mrieker/pdp8i/kicads/realpans8/realpans8.kicad_pcb

## KiCad design kicads/realpans8/realpans8.kicad_pcb (2026-11-01)

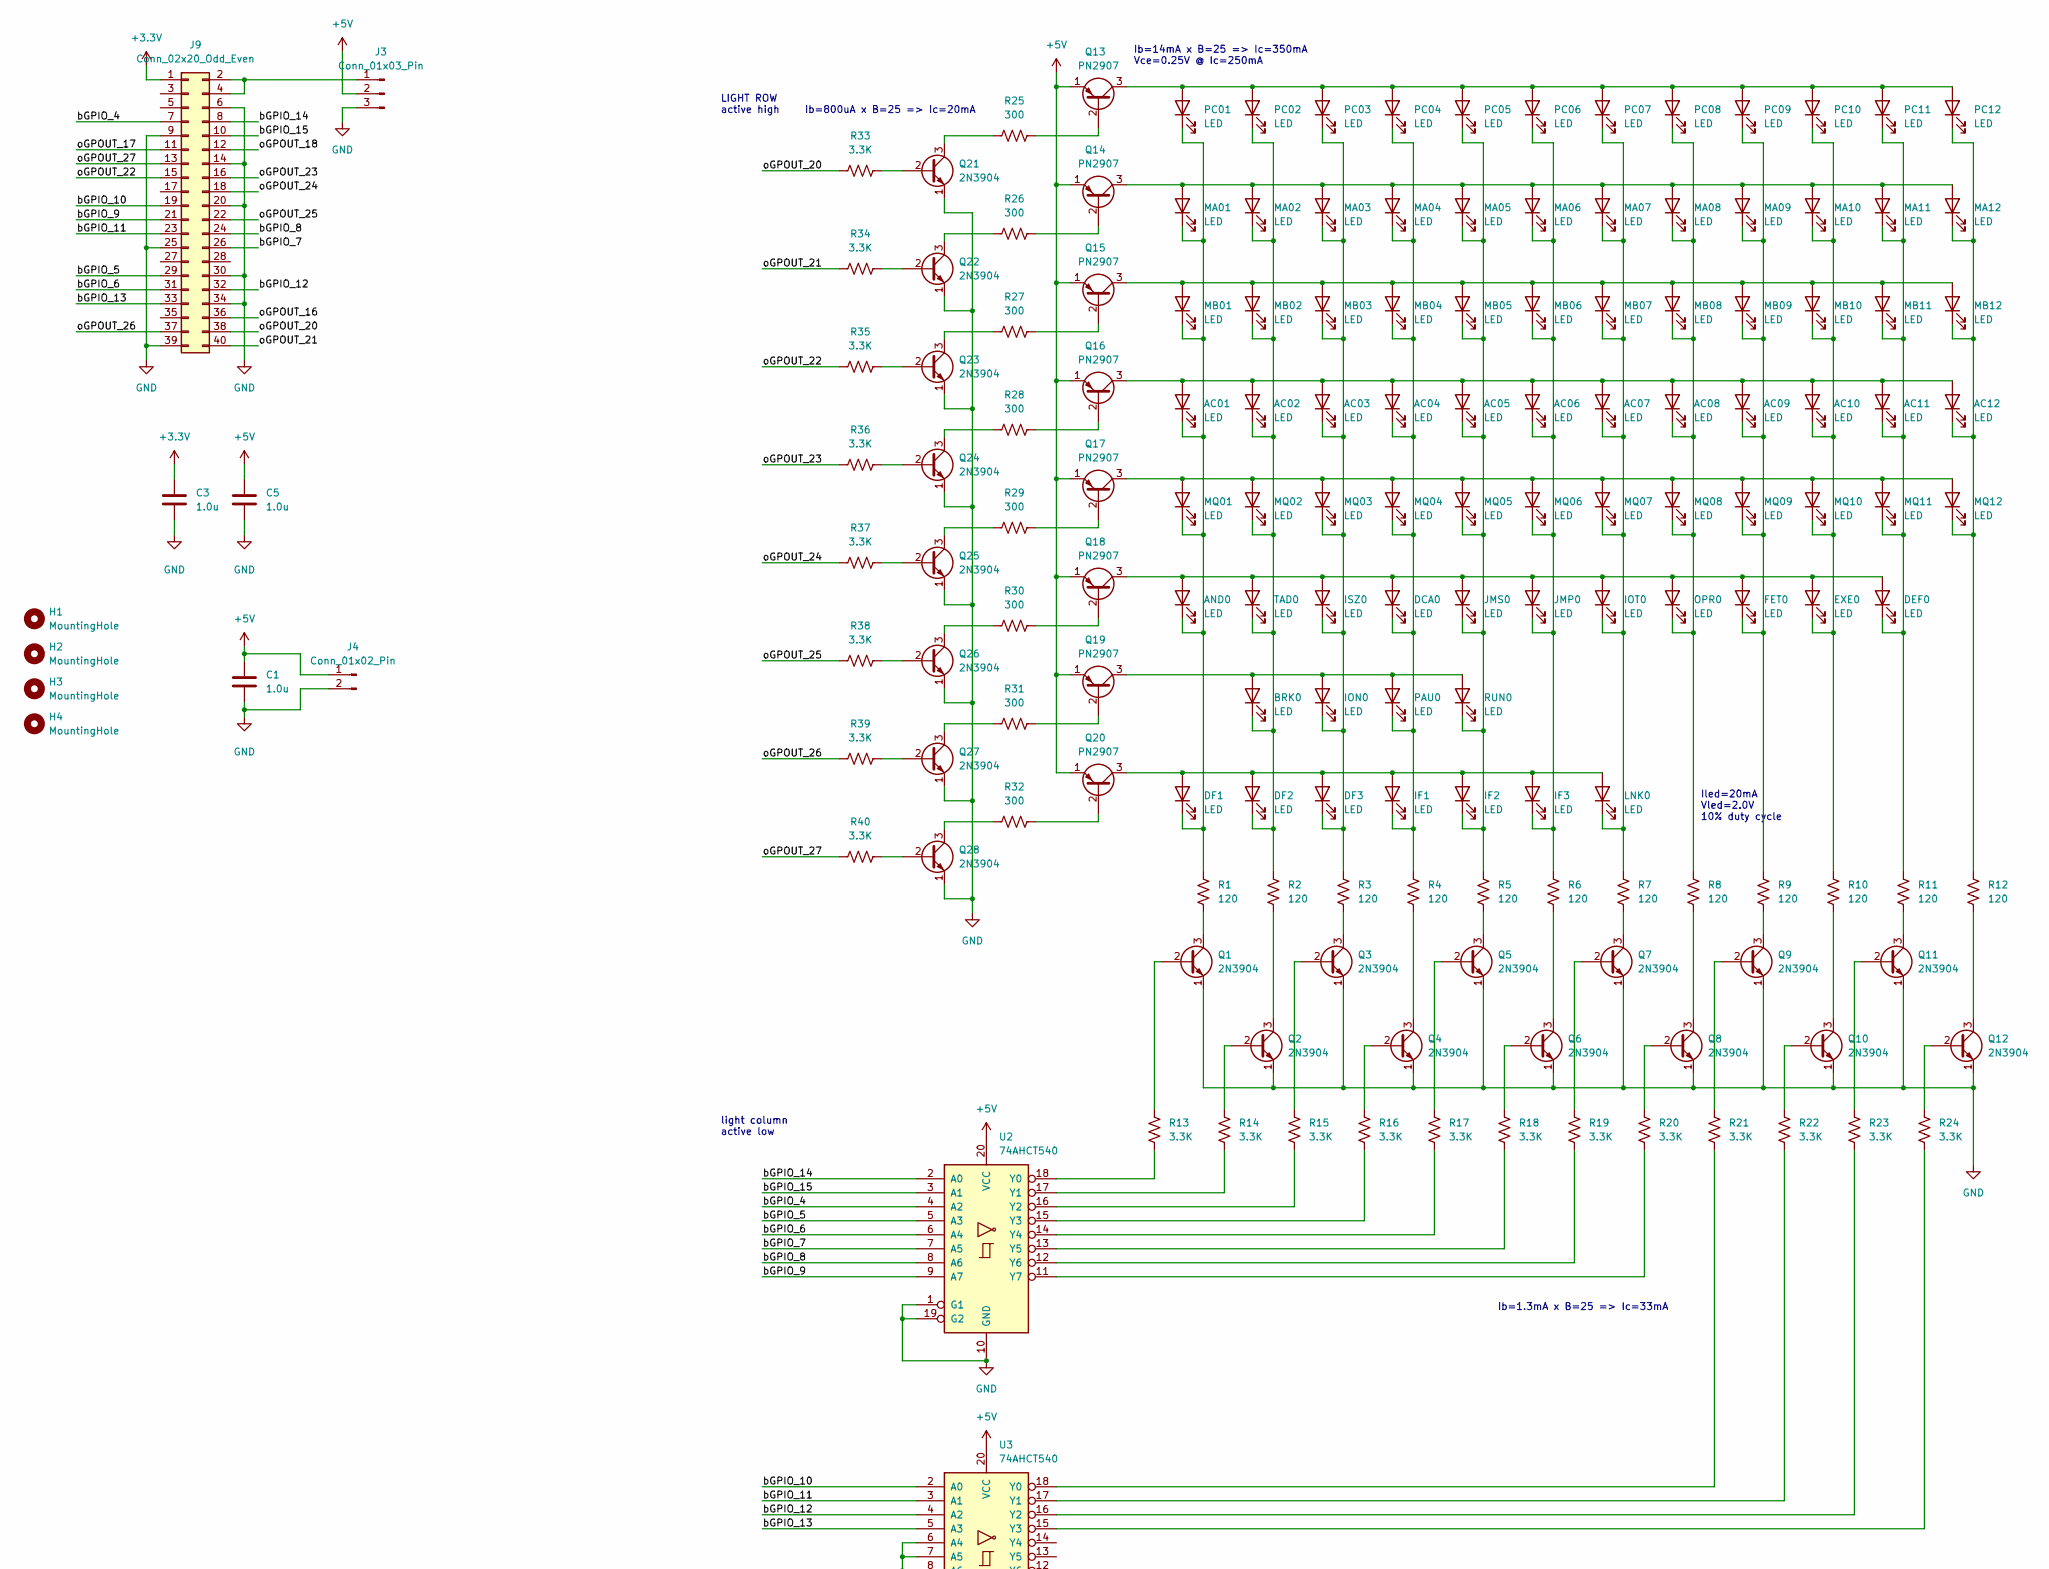
[picture p1: schematic realpans8.kicad_sch, part in row 1, column 1]

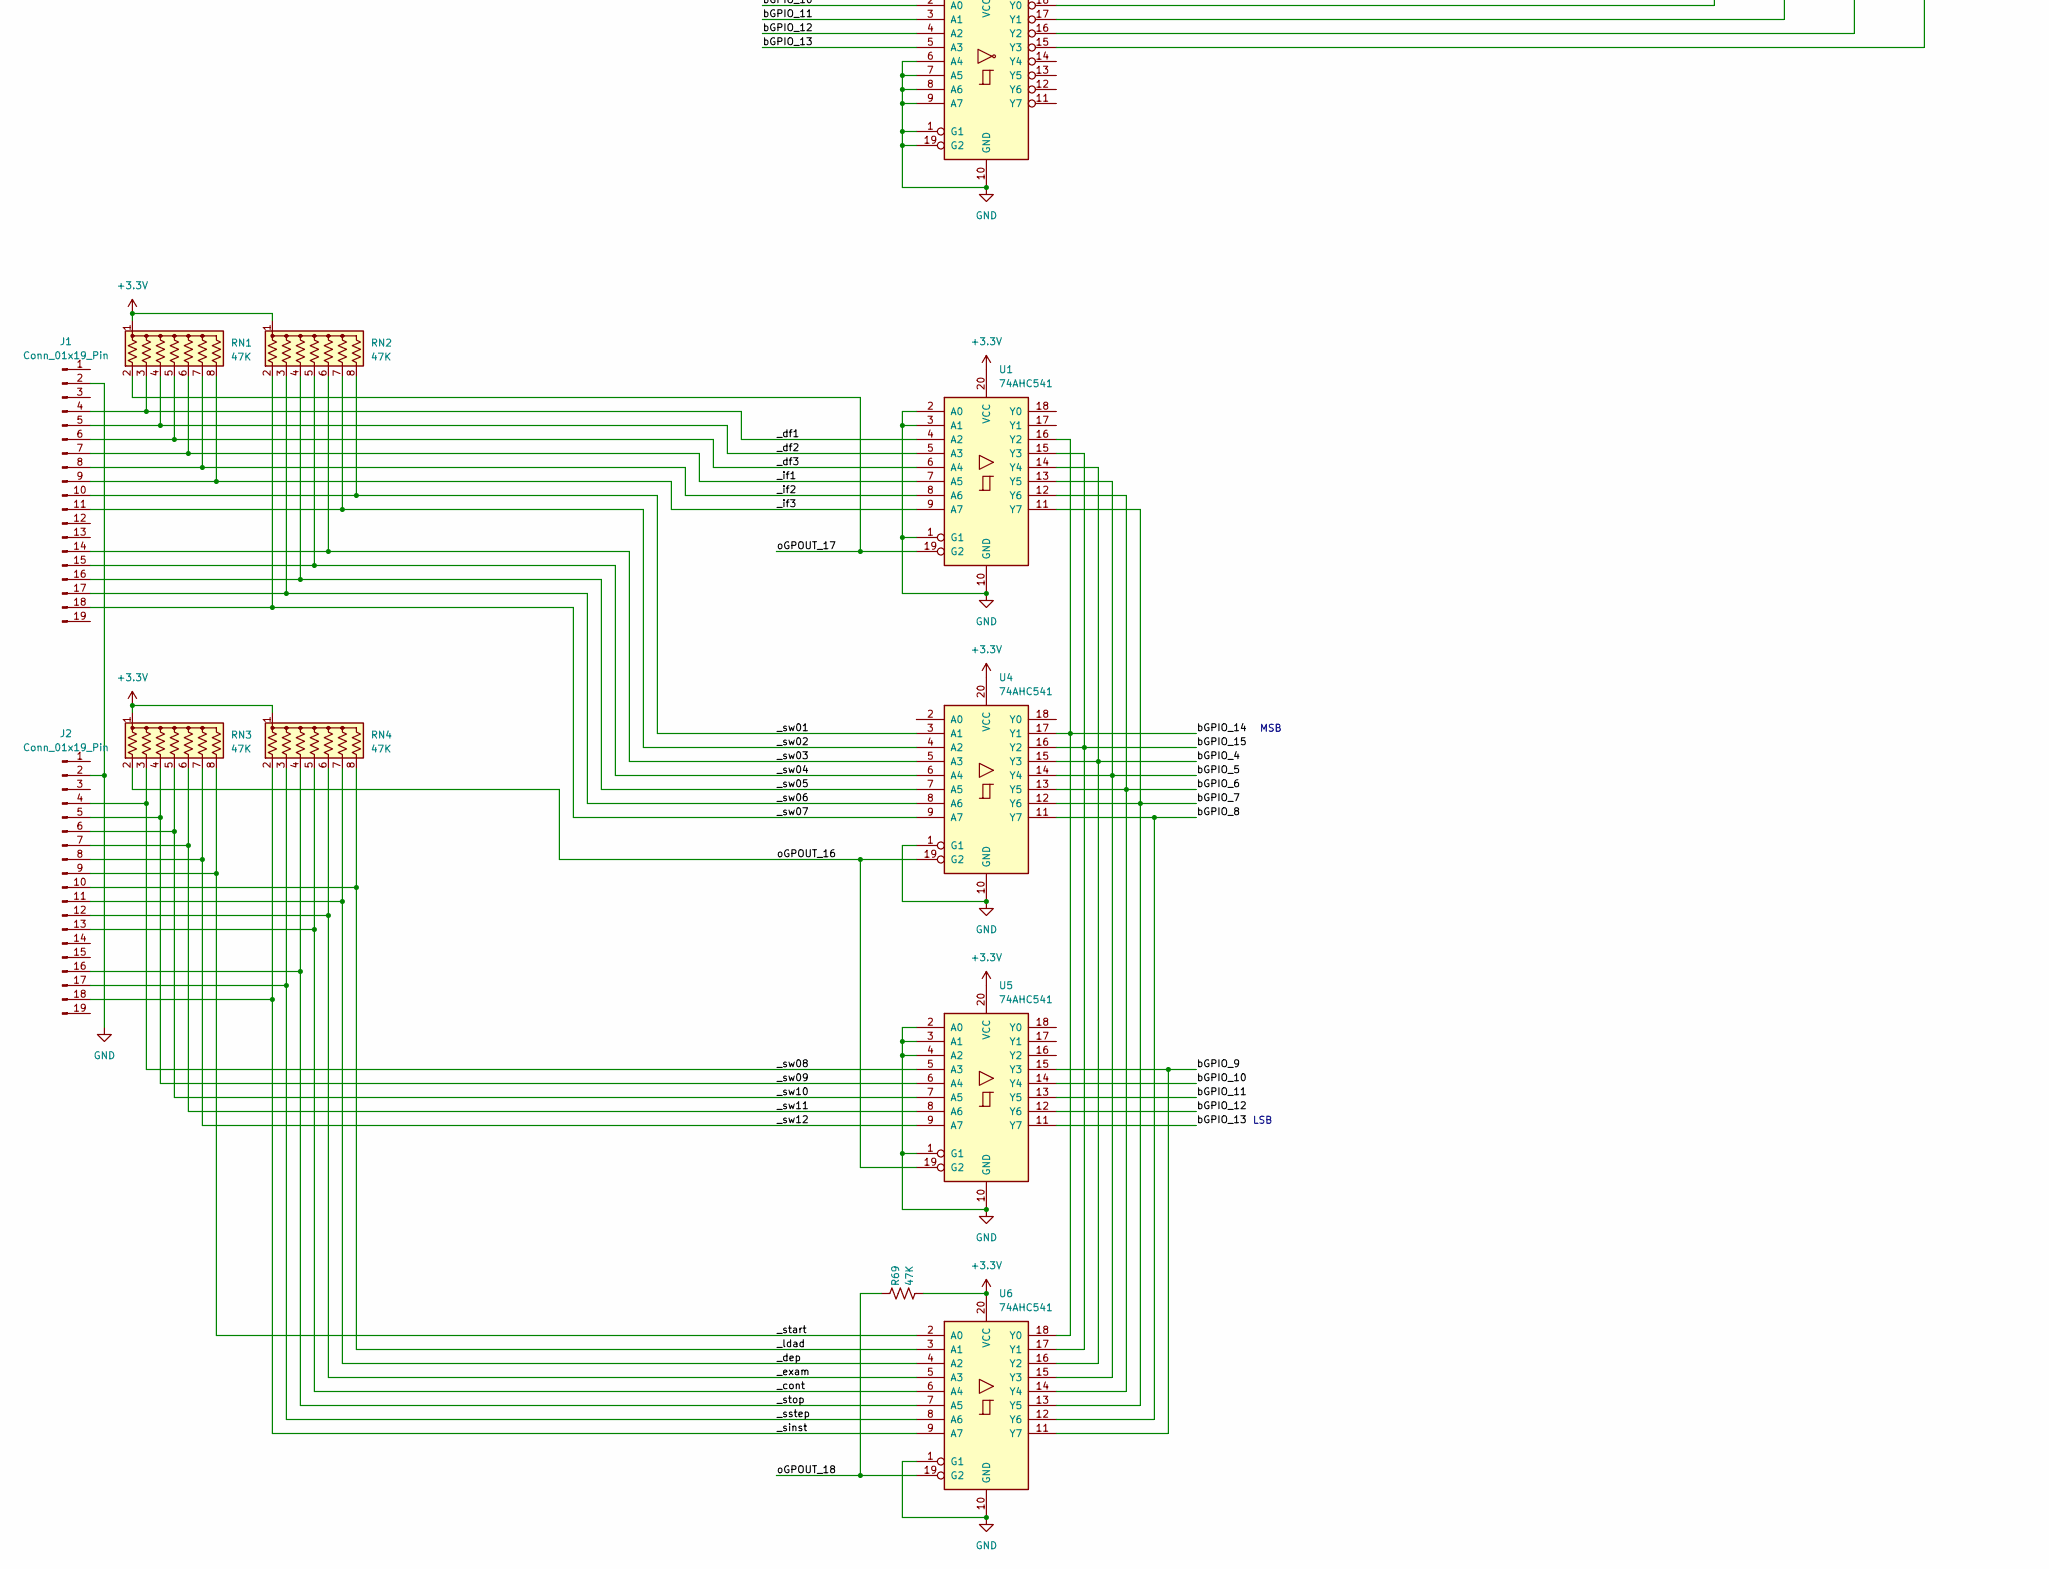
[picture p2: schematic realpans8.kicad_sch, part in row 2, column 1]

Parts:
AC01, AC02, AC03, AC04, AC05, AC06, AC07, AC08, AC09, AC10, AC11, AC12: LED; LED_D5.0mm
AND0: LED; LED_D5.0mm
BRK0: LED; LED_D5.0mm
C1, C3, C5: 1.0u; R_Axial_DIN0207_L6.3mm_D2.5mm_P7.62mm_Horizontal
DCA0: LED; LED_D5.0mm
DEF0: LED; LED_D5.0mm
DF1, DF2, DF3: LED; LED_D5.0mm
EXE0: LED; LED_D5.0mm
FET0: LED; LED_D5.0mm
H1, H2, H3, H4: MountingHole; MountingHole_4.5mm
IF1, IF2, IF3: LED; LED_D5.0mm
ION0: LED; LED_D5.0mm
IOT0: LED; LED_D5.0mm
ISZ0: LED; LED_D5.0mm
J1, J2: Conn_01x19_Pin; PinHeader_1x19_P2.54mm_Vertical
J3: Conn_01x03_Pin; PinHeader_1x03_P2.54mm_Vertical
J4: Conn_01x02_Pin; PinHeader_1x02_P2.54mm_Vertical
J9: Conn_02x20_Odd_Even; PinHeader_2x20_P2.54mm_Vertical
JMP0: LED; LED_D5.0mm
JMS0: LED; LED_D5.0mm
LNK0: LED; LED_D5.0mm
MA01, MA02, MA03, MA04, MA05, MA06, MA07, MA08, MA09, MA10, MA11, MA12: LED; LED_D5.0mm
MB01, MB02, MB03, MB04, MB05, MB06, MB07, MB08, MB09, MB10, MB11, MB12: LED; LED_D5.0mm
MQ01, MQ02, MQ03, MQ04, MQ05, MQ06, MQ07, MQ08, MQ09, MQ10, MQ11, MQ12: LED; LED_D5.0mm
OPR0: LED; LED_D5.0mm
PAU0: LED; LED_D5.0mm
PC01, PC02, PC03, PC04, PC05, PC06, PC07, PC08, PC09, PC10, PC11, PC12: LED; LED_D5.0mm
Q1, Q2, Q3, Q4, Q5, Q6, Q7, Q8, Q9, Q10, Q11, Q12, Q21, Q22, Q23, Q24, Q25, Q26, Q27, Q28: 2N3904; TO-92_Wide
Q13, Q14, Q15, Q16, Q17, Q18, Q19, Q20: PN2907; TO-92_Wide
R1, R2, R3, R4, R5, R6, R7, R8, R9, R10, R11, R12: 120; R_Axial_DIN0207_L6.3mm_D2.5mm_P7.62mm_Horizontal
R13, R14, R15, R16, R17, R18, R19, R20, R21, R22, R23, R24, R33, R34, R35, R36, R37, R38, R39, R40: 3.3K; R_Axial_DIN0207_L6.3mm_D2.5mm_P7.62mm_Horizontal
R25, R26, R27, R28, R29, R30, R31, R32: 300; R_Axial_DIN0207_L6.3mm_D2.5mm_P7.62mm_Horizontal
R69: 47K; R_Axial_DIN0207_L6.3mm_D2.5mm_P7.62mm_Horizontal
RN1, RN2, RN3, RN4: 47K; R_Array_SIP8
RUN0: LED; LED_D5.0mm
TAD0: LED; LED_D5.0mm
U1, U4, U5, U6: 74AHC541; DIP-20_W7.62mm
U2, U3: 74AHCT540; DIP-20_W7.62mm

Connections:
+3.3V: C3.1, J9.1, R69.1, RN1.1 (common), RN2.1 (common), RN3.1 (common), RN4.1 (common), U1.20 (VCC), U4.20 (VCC), U5.20 (VCC), U6.20 (VCC)
+5V: C1.1, C5.1, J3.2, J4.1, Q13.1 (E), Q14.1 (E), Q15.1 (E), Q16.1 (E), Q17.1 (E), Q18.1 (E), Q19.1 (E), Q20.1 (E), U2.20 (VCC), U3.20 (VCC)
/_cont: J2.13, RN4.5 (R4), U6.6 (A4)
/_dep: J2.11, RN4.7 (R6), U6.4 (A2)
/_df1: J1.4, RN1.3 (R2), U1.4 (A2)
/_df2: J1.5, RN1.4 (R3), U1.5 (A3)
/_df3: J1.6, RN1.5 (R4), U1.6 (A4)
/_exam: J2.12, RN4.6 (R5), U6.5 (A3)
/_if1: J1.7, RN1.6 (R5), U1.7 (A5)
/_if2: J1.8, RN1.7 (R6), U1.8 (A6)
/_if3: J1.9, RN1.8 (R7), U1.9 (A7)
/_ldad: J2.10, RN4.8 (R7), U6.3 (A1)
/_sinst: J2.18, RN4.2 (R1), U6.9 (A7)
/_sstep: J2.17, RN4.3 (R2), U6.8 (A6)
/_start: J2.9, RN3.8 (R7), U6.2 (A0)
/_stop: J2.16, RN4.4 (R3), U6.7 (A5)
/_sw01: J1.10, RN2.8 (R7), U4.3 (A1)
/_sw02: J1.11, RN2.7 (R6), U4.4 (A2)
/_sw03: J1.14, RN2.6 (R5), U4.5 (A3)
/_sw04: J1.15, RN2.5 (R4), U4.6 (A4)
/_sw05: J1.16, RN2.4 (R3), U4.7 (A5)
/_sw06: J1.17, RN2.3 (R2), U4.8 (A6)
/_sw07: J1.18, RN2.2 (R1), U4.9 (A7)
/_sw08: J2.4, RN3.3 (R2), U5.5 (A3)
/_sw09: J2.5, RN3.4 (R3), U5.6 (A4)
/_sw10: J2.6, RN3.5 (R4), U5.7 (A5)
/_sw11: J2.7, RN3.6 (R5), U5.8 (A6)
/_sw12: J2.8, RN3.7 (R6), U5.9 (A7)
/bGPIO_4: J9.7, U1.14 (Y4), U2.4 (A2), U4.15 (Y3), U6.16 (Y2)
/bGPIO_5: J9.29, U1.13 (Y5), U2.5 (A3), U4.14 (Y4), U6.15 (Y3)
/bGPIO_6: J9.31, U1.12 (Y6), U2.6 (A4), U4.13 (Y5), U6.14 (Y4)
/bGPIO_7: J9.26, U1.11 (Y7), U2.7 (A5), U4.12 (Y6), U6.13 (Y5)
/bGPIO_8: J9.24, U2.8 (A6), U4.11 (Y7), U6.12 (Y6)
/bGPIO_9: J9.21, U2.9 (A7), U5.15 (Y3), U6.11 (Y7)
/bGPIO_10: J9.19, U3.2 (A0), U5.14 (Y4)
/bGPIO_11: J9.23, U3.3 (A1), U5.13 (Y5)
/bGPIO_12: J9.32, U3.4 (A2), U5.12 (Y6)
/bGPIO_13: J9.33, U3.5 (A3), U5.11 (Y7)
/bGPIO_14: J9.8, U1.16 (Y2), U2.2 (A0), U4.17 (Y1), U6.18 (Y0)
/bGPIO_15: J9.10, U1.15 (Y3), U2.3 (A1), U4.16 (Y2), U6.17 (Y1)
/oGPOUT_16: J9.36, RN3.2 (R1), U4.19 (G2), U5.19 (G2)
/oGPOUT_17: J9.11, RN1.2 (R1), U1.19 (G2)
/oGPOUT_18: J9.12, R69.2, U6.19 (G2)
/oGPOUT_20: J9.38, R33.1
/oGPOUT_21: J9.40, R34.1
/oGPOUT_22: J9.15, R35.1
/oGPOUT_23: J9.16, R36.1
/oGPOUT_24: J9.18, R37.1
/oGPOUT_25: J9.22, R38.1
/oGPOUT_26: J9.37, R39.1
/oGPOUT_27: J9.13, R40.1
GND: C1.2, C3.2, C5.2, J1.2, J2.2, J3.3, J4.2, J9.6, J9.9, J9.14, J9.20, J9.25, J9.30, J9.34, J9.39, Q1.1 (E), Q2.1 (E), Q3.1 (E), Q4.1 (E), Q5.1 (E), Q6.1 (E), Q7.1 (E), Q8.1 (E), Q9.1 (E), Q10.1 (E), Q11.1 (E), Q12.1 (E), Q21.1 (E), Q22.1 (E), Q23.1 (E), Q24.1 (E), Q25.1 (E), Q26.1 (E), Q27.1 (E), Q28.1 (E), U1.1 (G1), U1.2 (A0), U1.3 (A1), U1.10 (GND), U2.1 (G1), U2.10 (GND), U2.19 (G2), U3.1 (G1), U3.6 (A4), U3.7 (A5), U3.8 (A6), U3.9 (A7), U3.10 (GND), U3.19 (G2), U4.1 (G1), U4.10 (GND), U5.1 (G1), U5.2 (A0), U5.3 (A1), U5.4 (A2), U5.10 (GND), U6.1 (G1), U6.10 (GND)
unnamed: AC01.2 (A), AC02.2 (A), AC03.2 (A), AC04.2 (A), AC05.2 (A), AC06.2 (A), AC07.2 (A), AC08.2 (A), AC09.2 (A), AC10.2 (A), AC11.2 (A), AC12.2 (A), Q16.3 (C)
unnamed: AC01.1 (K), AND0.1 (K), DF1.1 (K), MA01.1 (K), MB01.1 (K), MQ01.1 (K), PC01.1 (K), R1.1
unnamed: AC02.1 (K), BRK0.1 (K), DF2.1 (K), MA02.1 (K), MB02.1 (K), MQ02.1 (K), PC02.1 (K), R2.1, TAD0.1 (K)
unnamed: AC03.1 (K), DF3.1 (K), ION0.1 (K), ISZ0.1 (K), MA03.1 (K), MB03.1 (K), MQ03.1 (K), PC03.1 (K), R3.1
unnamed: AC04.1 (K), DCA0.1 (K), IF1.1 (K), MA04.1 (K), MB04.1 (K), MQ04.1 (K), PAU0.1 (K), PC04.1 (K), R4.1
unnamed: AC05.1 (K), IF2.1 (K), JMS0.1 (K), MA05.1 (K), MB05.1 (K), MQ05.1 (K), PC05.1 (K), R5.1, RUN0.1 (K)
unnamed: AC06.1 (K), IF3.1 (K), JMP0.1 (K), MA06.1 (K), MB06.1 (K), MQ06.1 (K), PC06.1 (K), R6.1
unnamed: AC07.1 (K), IOT0.1 (K), LNK0.1 (K), MA07.1 (K), MB07.1 (K), MQ07.1 (K), PC07.1 (K), R7.1
unnamed: AC08.1 (K), MA08.1 (K), MB08.1 (K), MQ08.1 (K), OPR0.1 (K), PC08.1 (K), R8.1
unnamed: AC09.1 (K), FET0.1 (K), MA09.1 (K), MB09.1 (K), MQ09.1 (K), PC09.1 (K), R9.1
unnamed: AC10.1 (K), EXE0.1 (K), MA10.1 (K), MB10.1 (K), MQ10.1 (K), PC10.1 (K), R10.1
unnamed: AC11.1 (K), DEF0.1 (K), MA11.1 (K), MB11.1 (K), MQ11.1 (K), PC11.1 (K), R11.1
unnamed: AC12.1 (K), MA12.1 (K), MB12.1 (K), MQ12.1 (K), PC12.1 (K), R12.1
unnamed: AND0.2 (A), DCA0.2 (A), DEF0.2 (A), EXE0.2 (A), FET0.2 (A), IOT0.2 (A), ISZ0.2 (A), JMP0.2 (A), JMS0.2 (A), OPR0.2 (A), Q18.3 (C), TAD0.2 (A)
unnamed: BRK0.2 (A), ION0.2 (A), PAU0.2 (A), Q19.3 (C), RUN0.2 (A)
unnamed: DF1.2 (A), DF2.2 (A), DF3.2 (A), IF1.2 (A), IF2.2 (A), IF3.2 (A), LNK0.2 (A), Q20.3 (C)
unnamed: J3.1, J9.2, J9.4
unnamed: MA01.2 (A), MA02.2 (A), MA03.2 (A), MA04.2 (A), MA05.2 (A), MA06.2 (A), MA07.2 (A), MA08.2 (A), MA09.2 (A), MA10.2 (A), MA11.2 (A), MA12.2 (A), Q14.3 (C)
unnamed: MB01.2 (A), MB02.2 (A), MB03.2 (A), MB04.2 (A), MB05.2 (A), MB06.2 (A), MB07.2 (A), MB08.2 (A), MB09.2 (A), MB10.2 (A), MB11.2 (A), MB12.2 (A), Q15.3 (C)
unnamed: MQ01.2 (A), MQ02.2 (A), MQ03.2 (A), MQ04.2 (A), MQ05.2 (A), MQ06.2 (A), MQ07.2 (A), MQ08.2 (A), MQ09.2 (A), MQ10.2 (A), MQ11.2 (A), MQ12.2 (A), Q17.3 (C)
unnamed: PC01.2 (A), PC02.2 (A), PC03.2 (A), PC04.2 (A), PC05.2 (A), PC06.2 (A), PC07.2 (A), PC08.2 (A), PC09.2 (A), PC10.2 (A), PC11.2 (A), PC12.2 (A), Q13.3 (C)
unnamed: Q1.2 (B), R13.1
unnamed: Q1.3 (C), R1.2
unnamed: Q2.2 (B), R14.1
unnamed: Q2.3 (C), R2.2
unnamed: Q3.2 (B), R15.1
unnamed: Q3.3 (C), R3.2
unnamed: Q4.2 (B), R16.1
unnamed: Q4.3 (C), R4.2
unnamed: Q5.2 (B), R17.1
unnamed: Q5.3 (C), R5.2
unnamed: Q6.2 (B), R18.1
unnamed: Q6.3 (C), R6.2
unnamed: Q7.2 (B), R19.1
unnamed: Q7.3 (C), R7.2
unnamed: Q8.2 (B), R20.1
unnamed: Q8.3 (C), R8.2
unnamed: Q9.2 (B), R21.1
unnamed: Q9.3 (C), R9.2
unnamed: Q10.2 (B), R22.1
unnamed: Q10.3 (C), R10.2
unnamed: Q11.2 (B), R23.1
unnamed: Q11.3 (C), R11.2
unnamed: Q12.2 (B), R24.1
unnamed: Q12.3 (C), R12.2
unnamed: Q13.2 (B), R25.2
unnamed: Q14.2 (B), R26.2
unnamed: Q15.2 (B), R27.2
unnamed: Q16.2 (B), R28.2
unnamed: Q17.2 (B), R29.2
unnamed: Q18.2 (B), R30.2
unnamed: Q19.2 (B), R31.2
unnamed: Q20.2 (B), R32.2
unnamed: Q21.2 (B), R33.2
unnamed: Q21.3 (C), R25.1
unnamed: Q22.2 (B), R34.2
unnamed: Q22.3 (C), R26.1
unnamed: Q23.2 (B), R35.2
unnamed: Q23.3 (C), R27.1
unnamed: Q24.2 (B), R36.2
unnamed: Q24.3 (C), R28.1
unnamed: Q25.2 (B), R37.2
unnamed: Q25.3 (C), R29.1
unnamed: Q26.2 (B), R38.2
unnamed: Q26.3 (C), R30.1
unnamed: Q27.2 (B), R39.2
unnamed: Q27.3 (C), R31.1
unnamed: Q28.2 (B), R40.2
unnamed: Q28.3 (C), R32.1
unnamed: R13.2, U2.18 (Y0)
unnamed: R14.2, U2.17 (Y1)
unnamed: R15.2, U2.16 (Y2)
unnamed: R16.2, U2.15 (Y3)
unnamed: R17.2, U2.14 (Y4)
unnamed: R18.2, U2.13 (Y5)
unnamed: R19.2, U2.12 (Y6)
unnamed: R20.2, U2.11 (Y7)
unnamed: R21.2, U3.18 (Y0)
unnamed: R22.2, U3.17 (Y1)
unnamed: R23.2, U3.16 (Y2)
unnamed: R24.2, U3.15 (Y3)

Notes on the sheet:
Ib=1.3mA x B=25 => Ic=33mA
Iled=20mA Vled=2.0V 10% duty cycle
Ib=800uA x B=25 => Ic=20mA
MSB
Ib=14mA x B=25 => Ic=350mA Vce=0.25V @ Ic=250mA
LIGHT ROW active high
light column active low
LSB

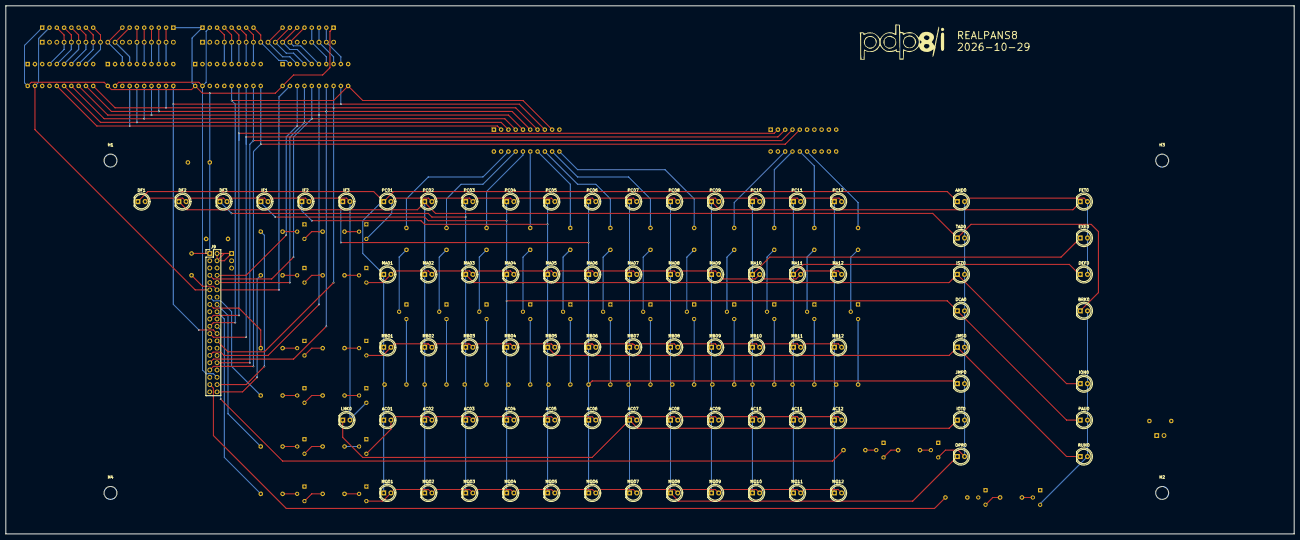
[picture p3: board realpans8.kicad_pcb from above]

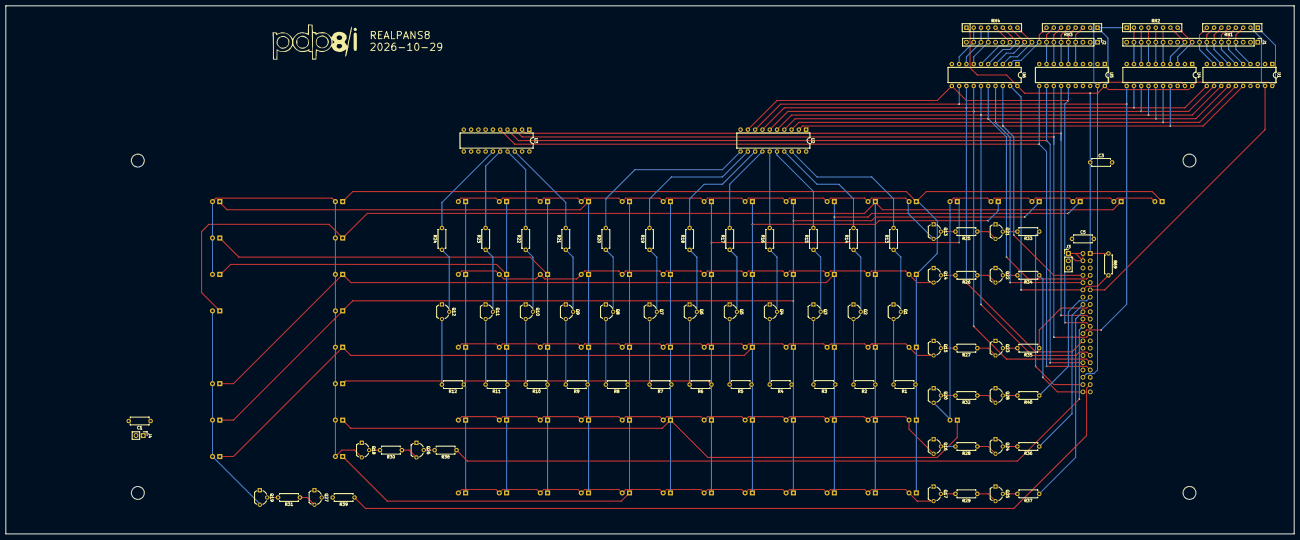
[picture p4: board realpans8.kicad_pcb from below]

Board: 4 copper layers, 449.3 x 184.2 mm, 173 parts (86 on the bottom side), 133 nets.
