mrieker/pdp8i/kicads/console/console.kicad_pcb

## KiCad design kicads/console/console.kicad_pcb (2026-10-23)

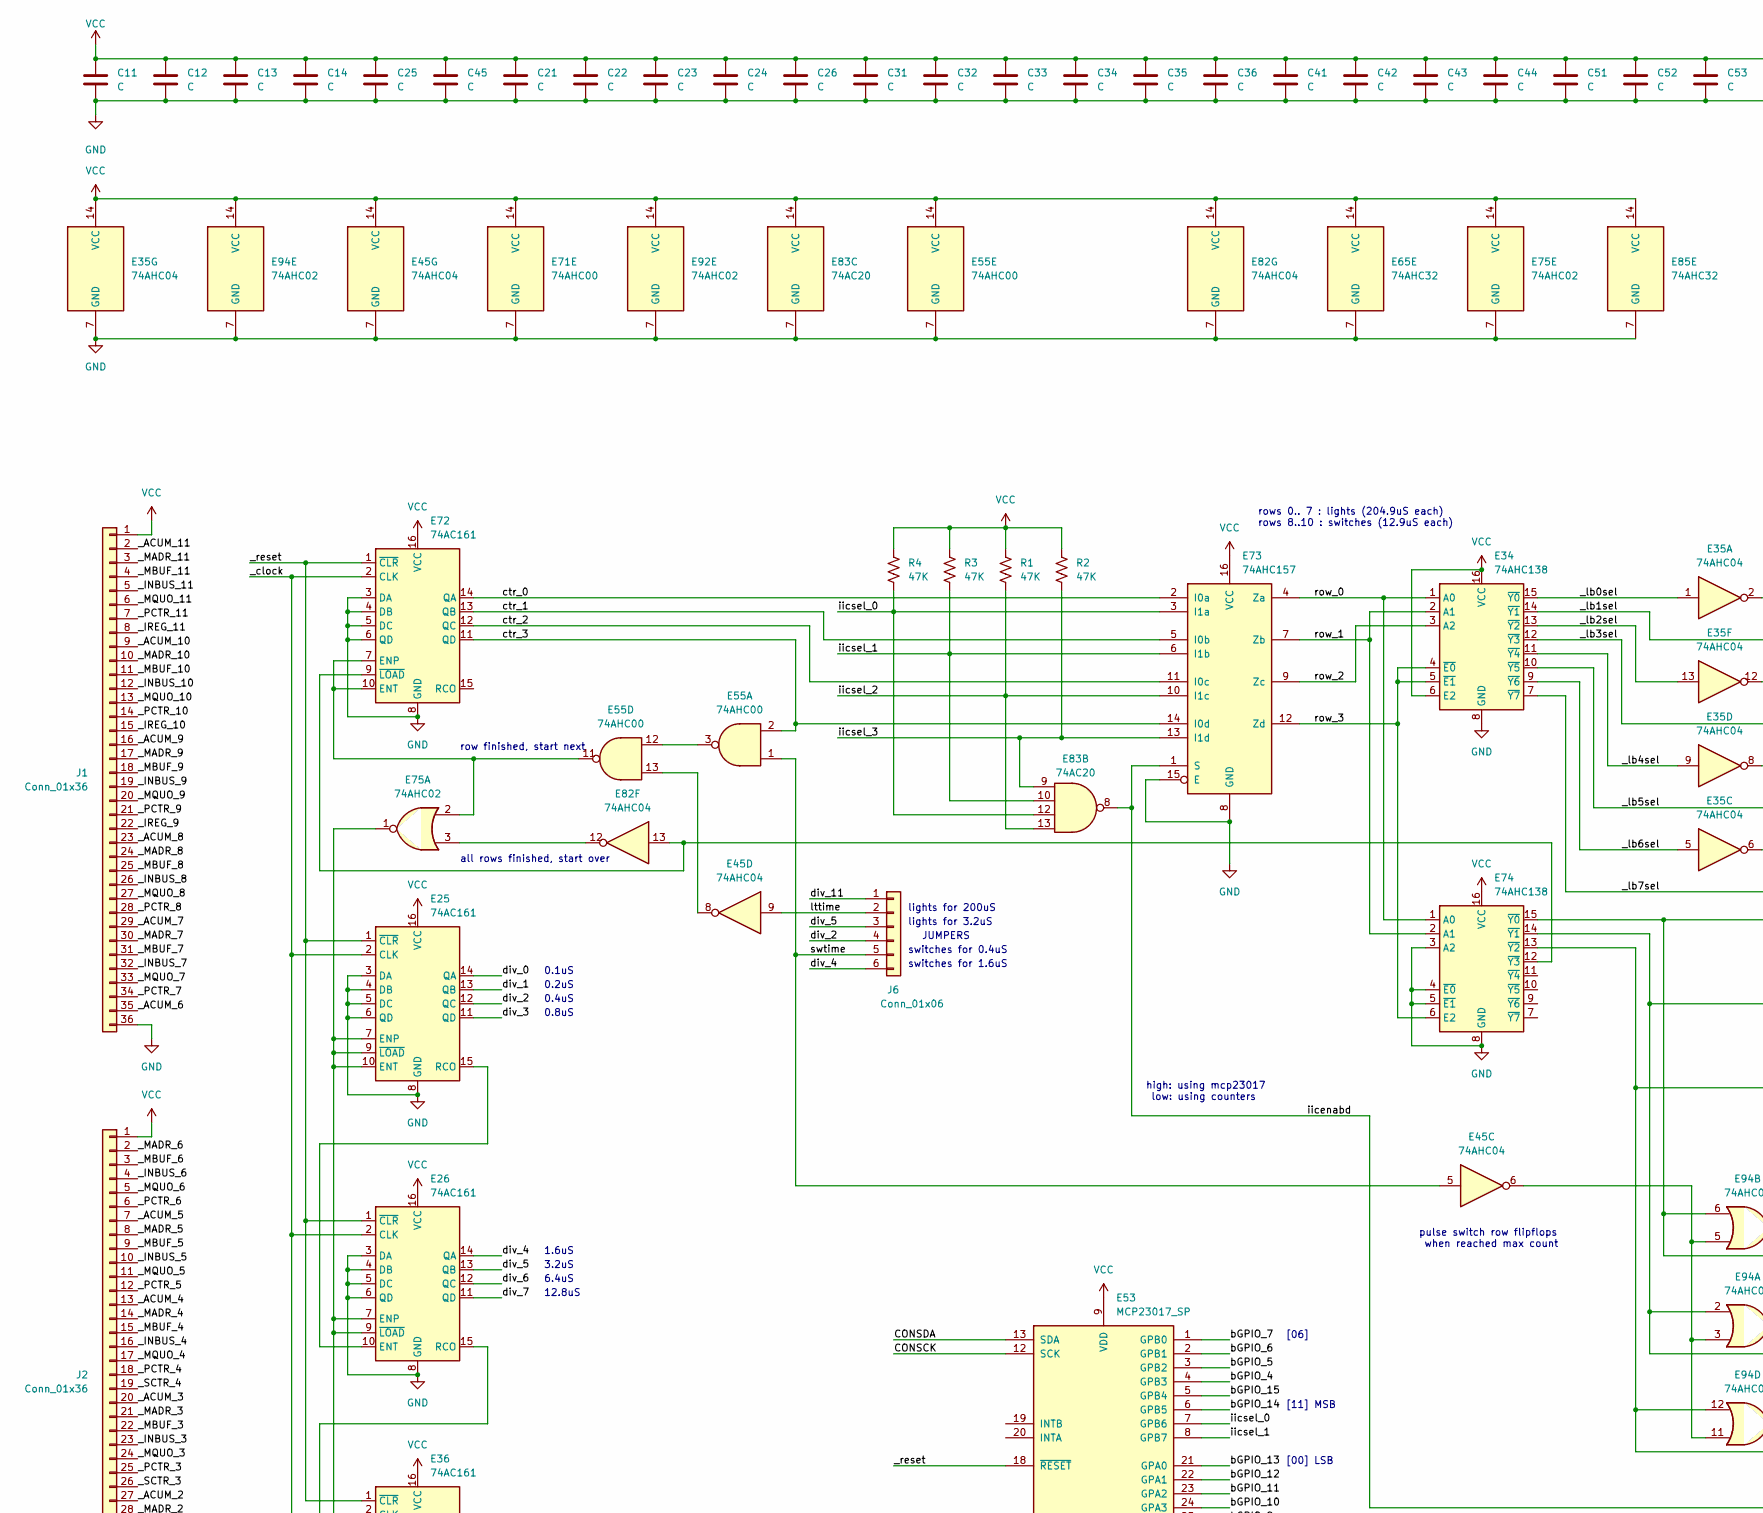
[picture p5: schematic console.kicad_sch, part in row 1, column 1]

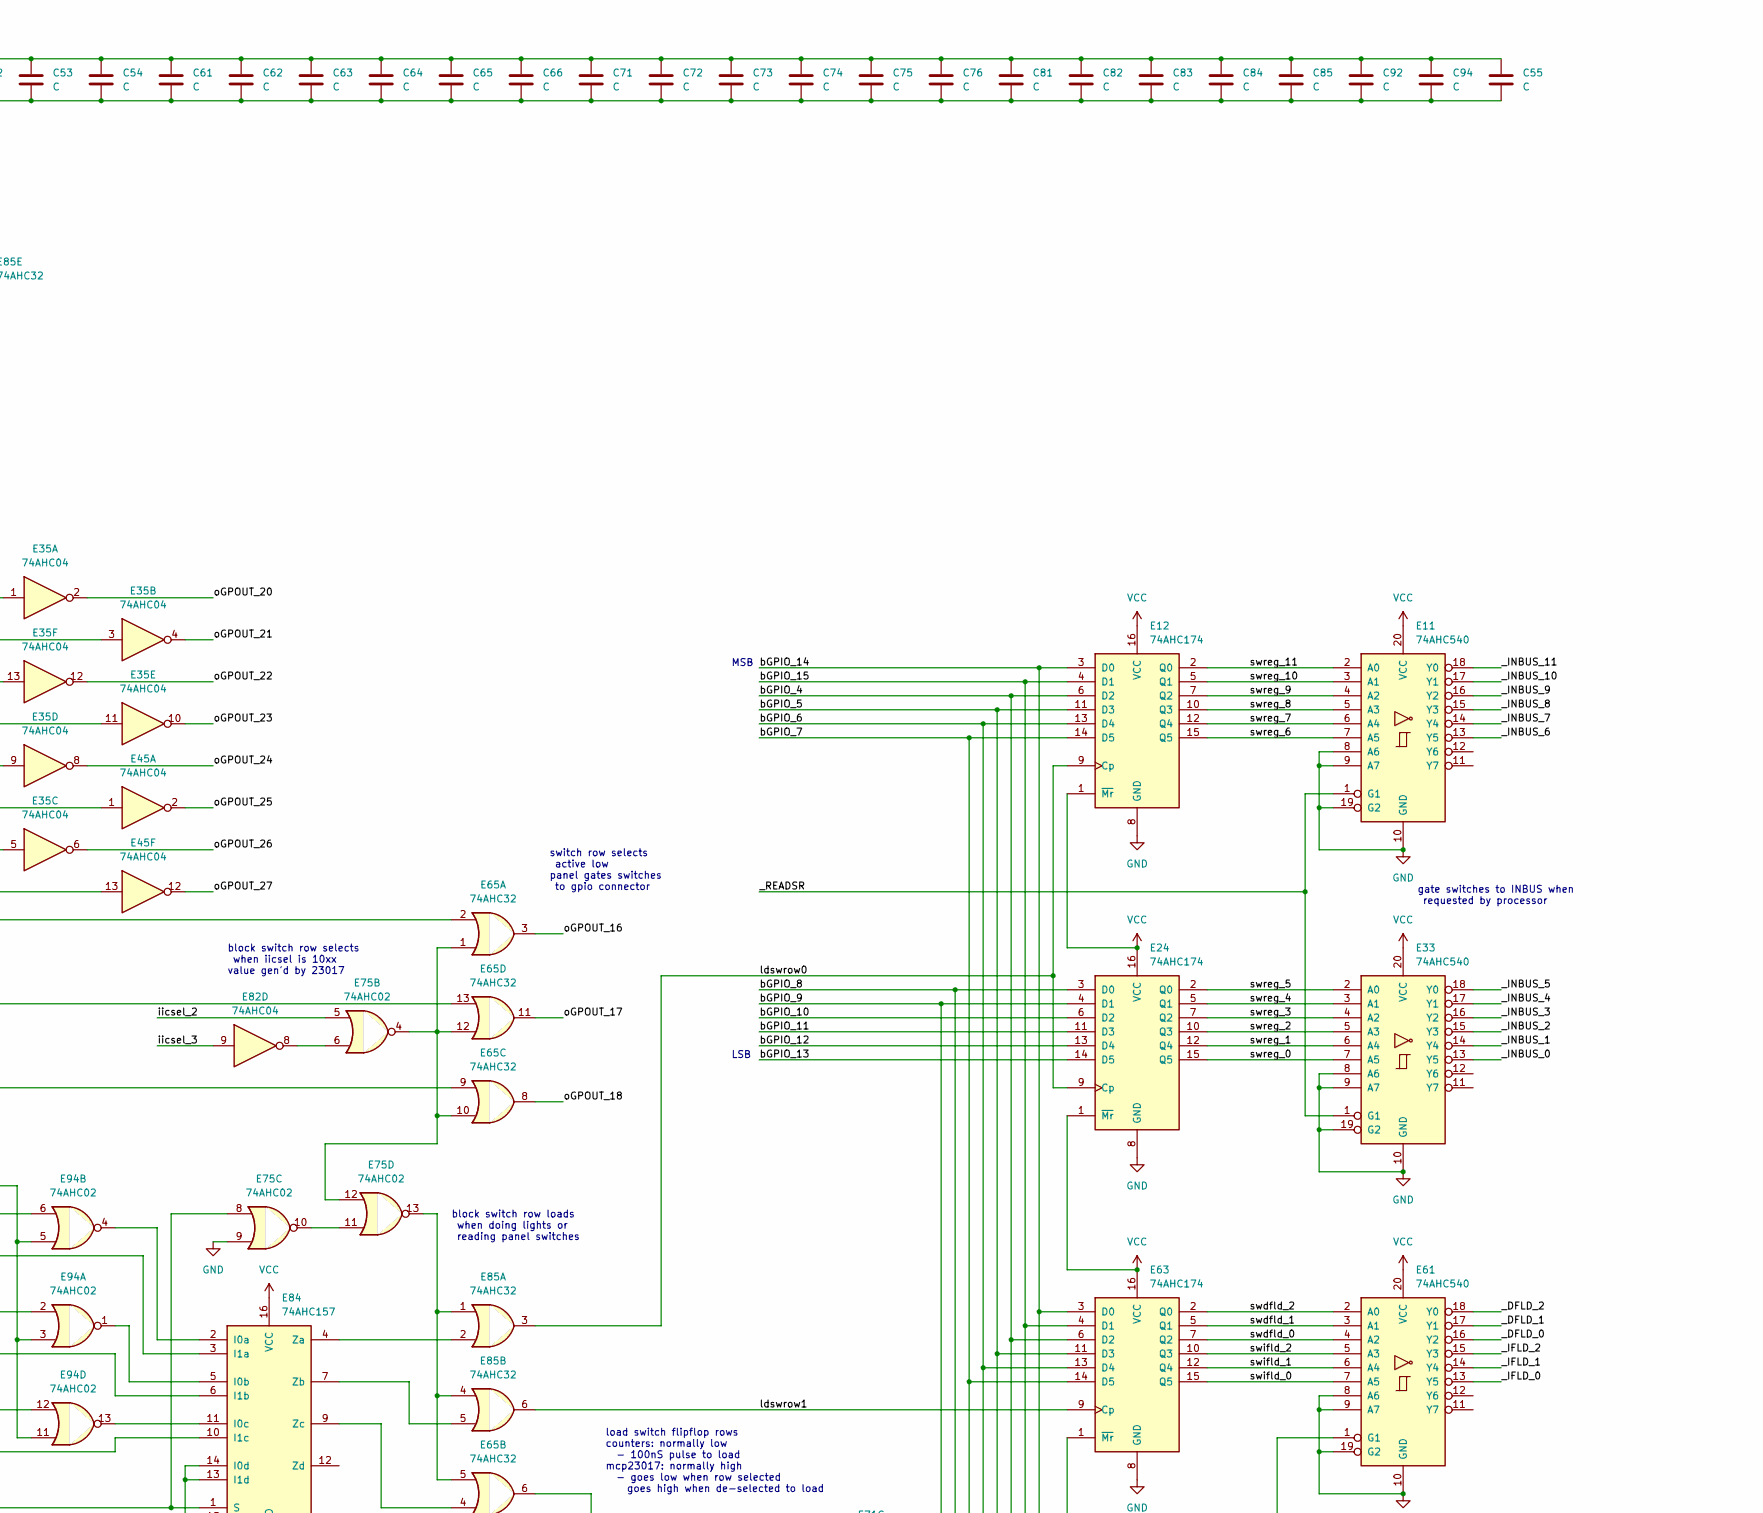
[picture p6: schematic console.kicad_sch, part in row 1, column 2]

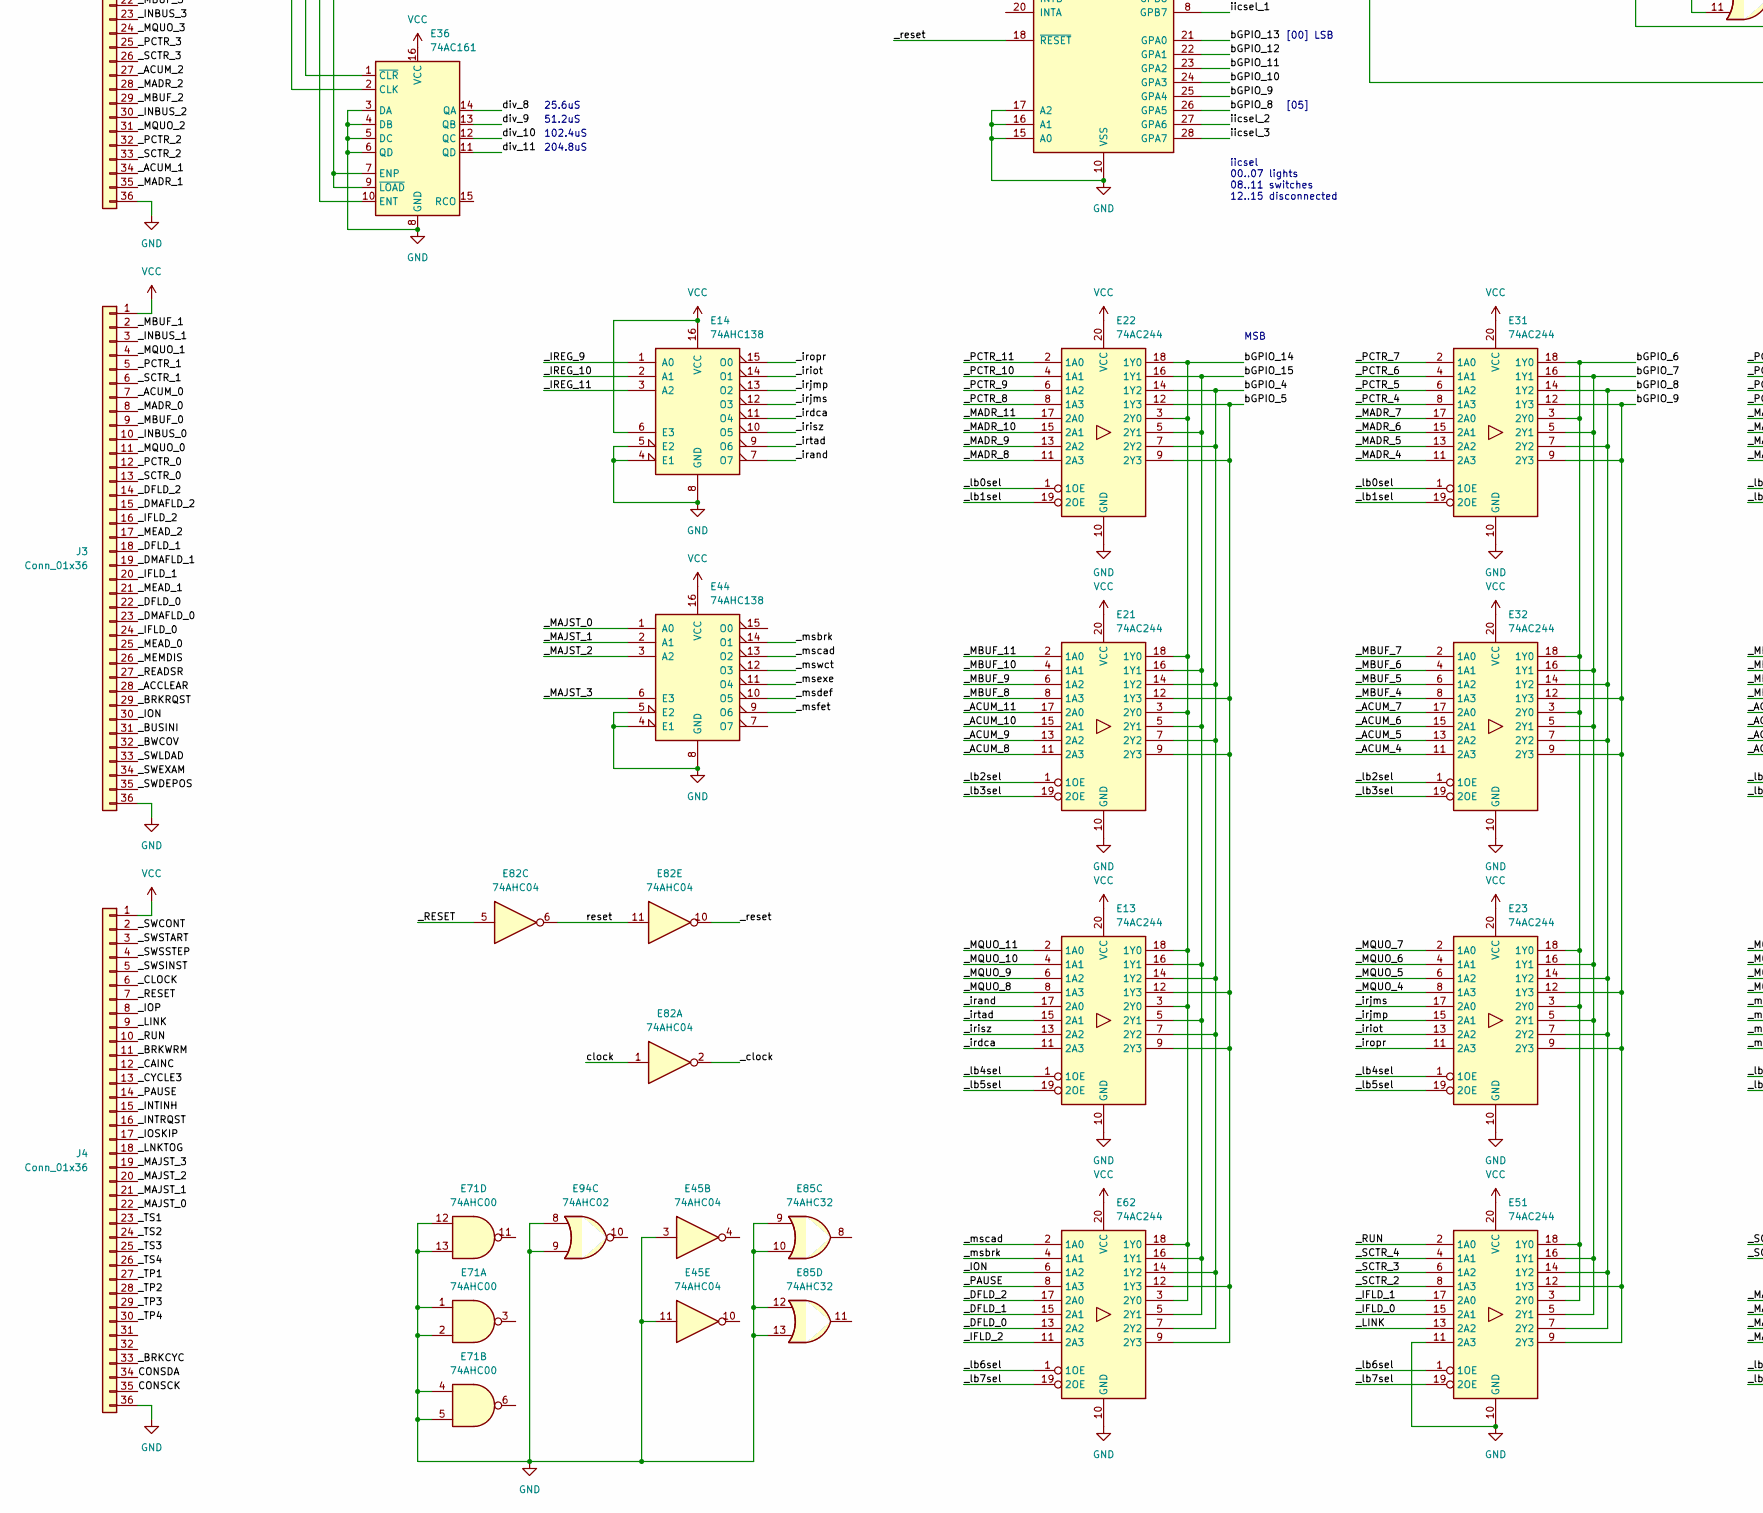
[picture p7: schematic console.kicad_sch, part in row 2, column 1]

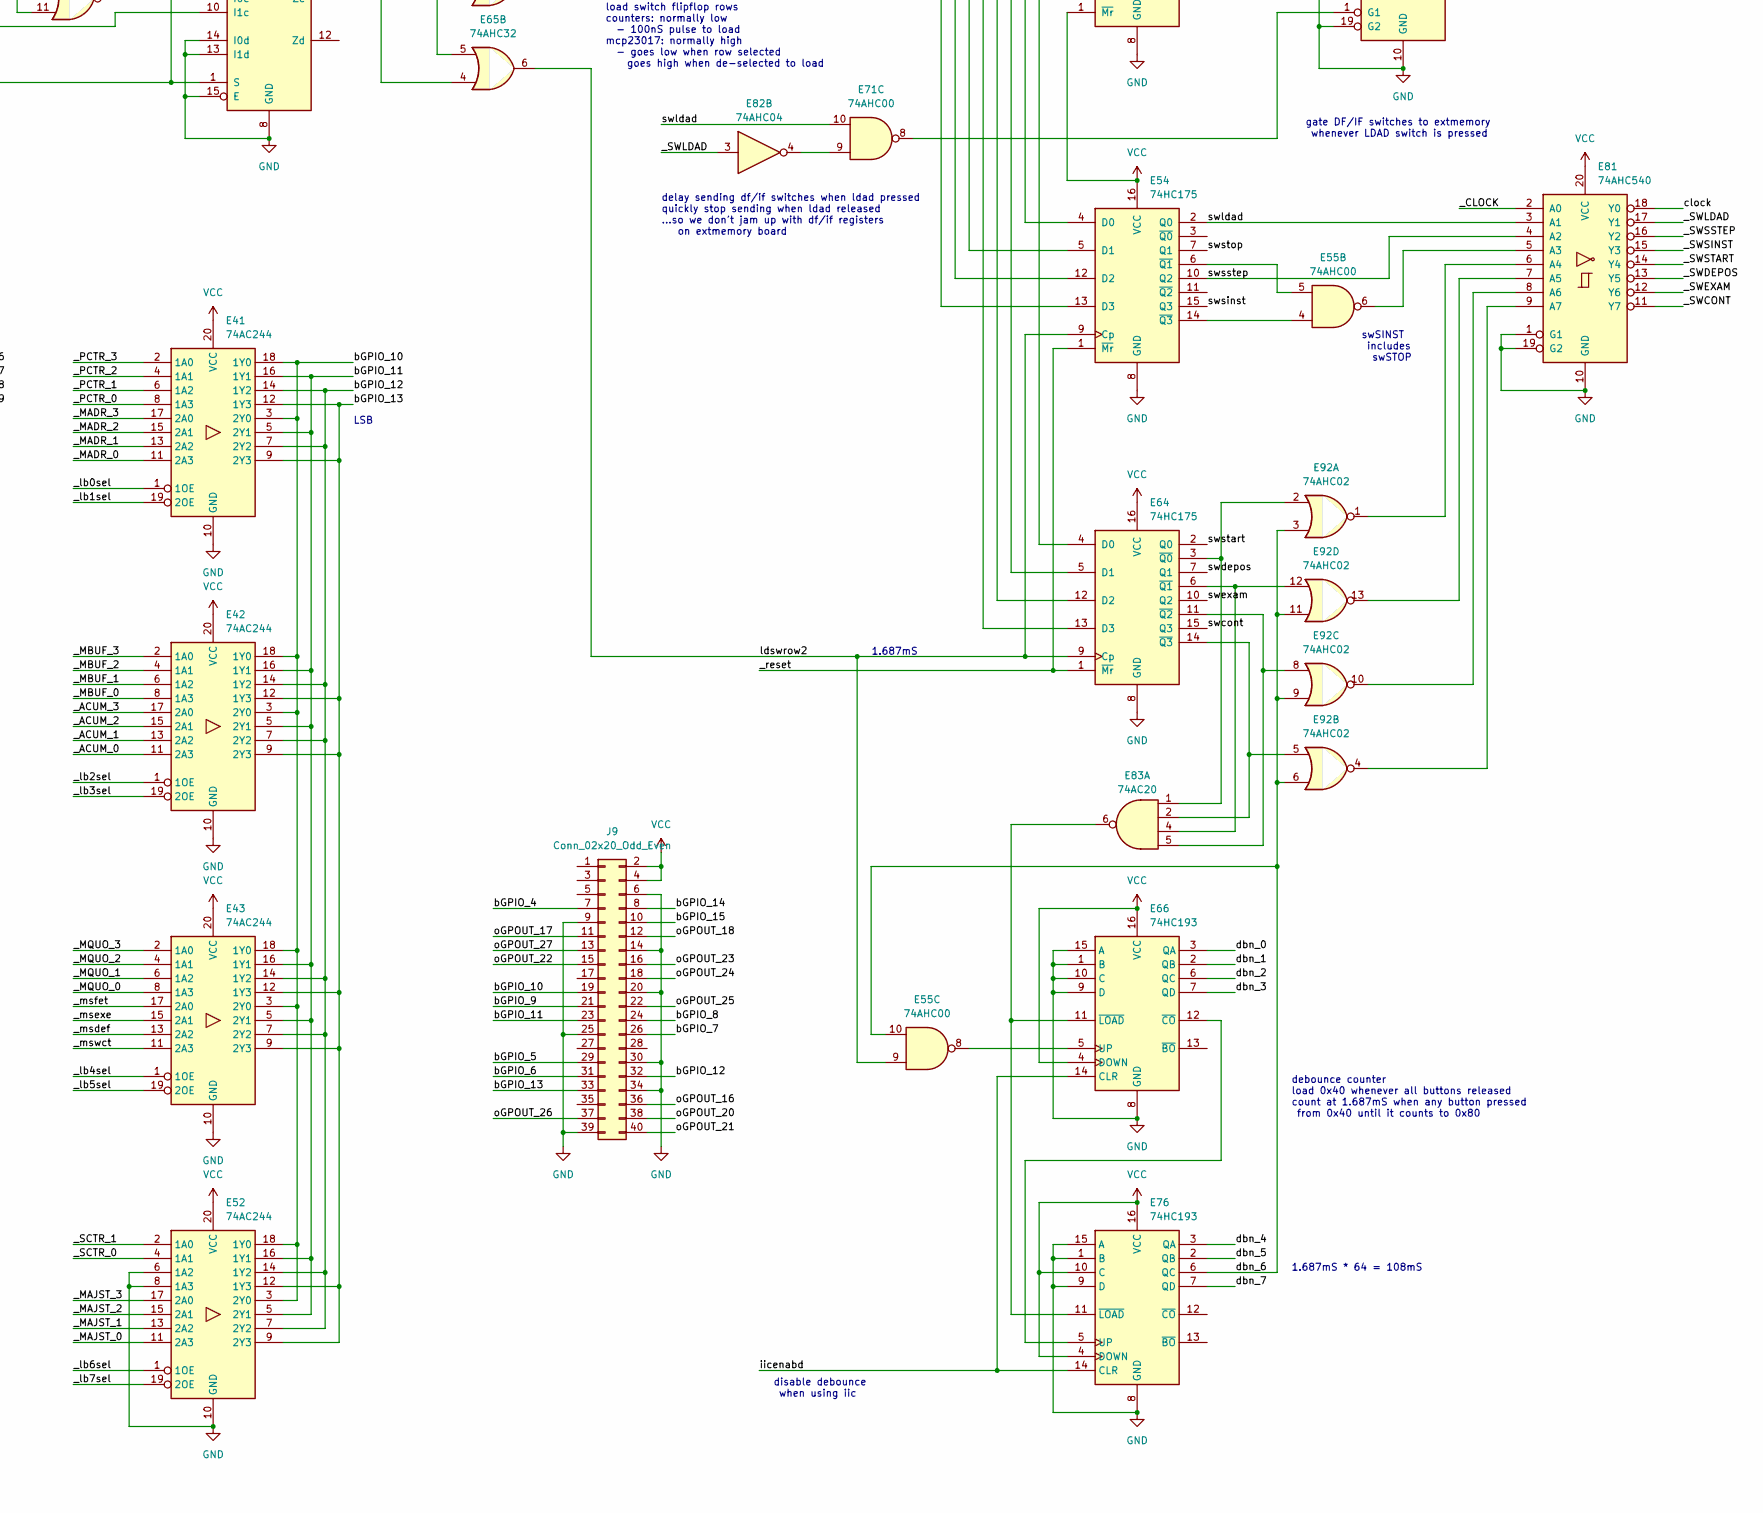
[picture p8: schematic console.kicad_sch, part in row 2, column 2]

Parts:
C11, C12, C13, C14, C21, C22, C23, C24, C25, C26, C31, C32, C33, C34, C35, C36, C41, C42, C43, C44, C45, C51, C52, C53, C54, C55, C61, C62, C63, C64, C65, C66, C71, C72, C73, C74, C75, C76, C81, C82, C83, C84, C85, C92, C94: C; R_Axial_DIN0207_L6.3mm_D2.5mm_P7.62mm_Horizontal
E11, E33, E61, E81: 74AHC540; DIP-20_W7.62mm
E12, E24, E63: 74AHC174; DIP-16_W7.62mm
E13, E21, E22, E23, E31, E32, E41, E42, E43, E51, E52, E62: 74AC244; DIP-20_W7.62mm
E14, E34, E44, E74: 74AHC138; DIP-16_W7.62mm
E25, E26, E36, E72: 74AC161; DIP-16_W7.62mm
E35, E45, E82: 74AHC04; DIP-14_W7.62mm
E53: MCP23017_SP; DIP-28_W7.62mm
E54, E64: 74HC175; DIP-16_W7.62mm
E55, E71: 74AHC00; DIP-14_W7.62mm
E65, E85: 74AHC32; DIP-14_W7.62mm
E66, E76: 74HC193; DIP-16_W7.62mm
E73, E84: 74AHC157; DIP-16_W7.62mm
E75, E92: 74AHC02
E83: 74AC20; DIP-14_W7.62mm
E94: 74AHC02; DIP-14_W7.62mm
J1, J2, J3, J4: Conn_01x36; PinHeader_1x36_P2.54mm_Vertical
J6: Conn_01x06; PinHeader_1x06_P2.54mm_Vertical
J9: Conn_02x20_Odd_Even; PinHeader_2x20_P2.54mm_Vertical
R1, R2, R3, R4: 47K; R_Axial_DIN0207_L6.3mm_D2.5mm_P7.62mm_Horizontal

Connections:
/CONSCK: E53.12 (SCK), J4.35
/CONSDA: E53.13 (SDA), J4.34
/_ACCLEAR: J3.28
/_ACUM_0: E42.11 (2A3), J3.7
/_ACUM_1: E42.13 (2A2), J2.34
/_ACUM_2: E42.15 (2A1), J2.27
/_ACUM_3: E42.17 (2A0), J2.20
/_ACUM_4: E32.11 (2A3), J2.13
/_ACUM_5: E32.13 (2A2), J2.7
/_ACUM_6: E32.15 (2A1), J1.35
/_ACUM_7: E32.17 (2A0), J1.29
/_ACUM_8: E21.11 (2A3), J1.23
/_ACUM_9: E21.13 (2A2), J1.16
/_ACUM_10: E21.15 (2A1), J1.9
/_ACUM_11: E21.17 (2A0), J1.2
/_BRKCYC: J4.33
/_BRKRQST: J3.29
/_BRKWRM: J4.11
/_BUSINI: J3.31
/_BWCOV: J3.32
/_CAINC: J4.12
/_CLOCK: E81.2 (A0), J4.6
/_CYCLE3: J4.13
/_DFLD_0: E61.16 (Y2), E62.13 (2A2), J3.22
/_DFLD_1: E61.17 (Y1), E62.15 (2A1), J3.18
/_DFLD_2: E61.18 (Y0), E62.17 (2A0), J3.14
/_DMAFLD_0: J3.23
/_DMAFLD_1: J3.19
/_DMAFLD_2: J3.15
/_IFLD_0: E51.15 (2A1), E61.13 (Y5), J3.24
/_IFLD_1: E51.17 (2A0), E61.14 (Y4), J3.20
/_IFLD_2: E61.15 (Y3), E62.11 (2A3), J3.16
/_INBUS_0: E33.13 (Y5), J3.10
/_INBUS_1: E33.14 (Y4), J3.3
/_INBUS_2: E33.15 (Y3), J2.30
/_INBUS_3: E33.16 (Y2), J2.23
/_INBUS_4: E33.17 (Y1), J2.16
/_INBUS_5: E33.18 (Y0), J2.10
/_INBUS_6: E11.13 (Y5), J2.4
/_INBUS_7: E11.14 (Y4), J1.32
/_INBUS_8: E11.15 (Y3), J1.26
/_INBUS_9: E11.16 (Y2), J1.19
/_INBUS_10: E11.17 (Y1), J1.12
/_INBUS_11: E11.18 (Y0), J1.5
/_INTINH: J4.15
/_INTRQST: J4.16
/_ION: E62.6 (1A2), J3.30
/_IOP: J4.8
/_IOSKIP: J4.17
/_IREG_9: E14.1 (A0), J1.22
/_IREG_10: E14.2 (A1), J1.15
/_IREG_11: E14.3 (A2), J1.8
/_LINK: E51.13 (2A2), J4.9
/_LNKTOG: J4.18
/_MADR_0: E41.11 (2A3), J3.8
/_MADR_1: E41.13 (2A2), J2.35
/_MADR_2: E41.15 (2A1), J2.28
/_MADR_3: E41.17 (2A0), J2.21
/_MADR_4: E31.11 (2A3), J2.14
/_MADR_5: E31.13 (2A2), J2.8
/_MADR_6: E31.15 (2A1), J2.2
/_MADR_7: E31.17 (2A0), J1.30
/_MADR_8: E22.11 (2A3), J1.24
/_MADR_9: E22.13 (2A2), J1.17
/_MADR_10: E22.15 (2A1), J1.10
/_MADR_11: E22.17 (2A0), J1.3
/_MAJST_0: E44.1 (A0), E52.11 (2A3), J4.22
/_MAJST_1: E44.2 (A1), E52.13 (2A2), J4.21
/_MAJST_2: E44.3 (A2), E52.15 (2A1), J4.20
/_MAJST_3: E44.6 (E3), E52.17 (2A0), J4.19
/_MBUF_0: E42.8 (1A3), J3.9
/_MBUF_1: E42.6 (1A2), J3.2
/_MBUF_2: E42.4 (1A1), J2.29
/_MBUF_3: E42.2 (1A0), J2.22
/_MBUF_4: E32.8 (1A3), J2.15
/_MBUF_5: E32.6 (1A2), J2.9
/_MBUF_6: E32.4 (1A1), J2.3
/_MBUF_7: E32.2 (1A0), J1.31
/_MBUF_8: E21.8 (1A3), J1.25
/_MBUF_9: E21.6 (1A2), J1.18
/_MBUF_10: E21.4 (1A1), J1.11
/_MBUF_11: E21.2 (1A0), J1.4
/_MEAD_0: J3.25
/_MEAD_1: J3.21
/_MEAD_2: J3.17
/_MEMDIS: J3.26
/_MQUO_0: E43.8 (1A3), J3.11
/_MQUO_1: E43.6 (1A2), J3.4
/_MQUO_2: E43.4 (1A1), J2.31
/_MQUO_3: E43.2 (1A0), J2.24
/_MQUO_4: E23.8 (1A3), J2.17
/_MQUO_5: E23.6 (1A2), J2.11
/_MQUO_6: E23.4 (1A1), J2.5
/_MQUO_7: E23.2 (1A0), J1.33
/_MQUO_8: E13.8 (1A3), J1.27
/_MQUO_9: E13.6 (1A2), J1.20
/_MQUO_10: E13.4 (1A1), J1.13
/_MQUO_11: E13.2 (1A0), J1.6
/_PAUSE: E62.8 (1A3), J4.14
/_PCTR_0: E41.8 (1A3), J3.12
/_PCTR_1: E41.6 (1A2), J3.5
/_PCTR_2: E41.4 (1A1), J2.32
/_PCTR_3: E41.2 (1A0), J2.25
/_PCTR_4: E31.8 (1A3), J2.18
/_PCTR_5: E31.6 (1A2), J2.12
/_PCTR_6: E31.4 (1A1), J2.6
/_PCTR_7: E31.2 (1A0), J1.34
/_PCTR_8: E22.8 (1A3), J1.28
/_PCTR_9: E22.6 (1A2), J1.21
/_PCTR_10: E22.4 (1A1), J1.14
/_PCTR_11: E22.2 (1A0), J1.7
/_READSR: E11.1 (G1), E33.1 (G1), J3.27
/_RESET: E82.5, J4.7
/_RUN: E51.2 (1A0), J4.10
/_SCTR_0: E52.4 (1A1), J3.13
/_SCTR_1: E52.2 (1A0), J3.6
/_SCTR_2: E51.8 (1A3), J2.33
/_SCTR_3: E51.6 (1A2), J2.26
/_SCTR_4: E51.4 (1A1), J2.19
/_SWCONT: E81.11 (Y7), J4.2
/_SWDEPOS: E81.13 (Y5), J3.35
/_SWEXAM: E81.12 (Y6), J3.34
/_SWLDAD: E81.17 (Y1), E82.3, J3.33
/_SWSINST: E81.15 (Y3), J4.5
/_SWSSTEP: E81.16 (Y2), J4.4
/_SWSTART: E81.14 (Y4), J4.3
/_TP1: J4.27
/_TP2: J4.28
/_TP3: J4.29
/_TP4: J4.30
/_TS1: J4.23
/_TS2: J4.24
/_TS3: J4.25
/_TS4: J4.26
/_clock: E25.2 (CLK), E26.2 (CLK), E36.2 (CLK), E72.2 (CLK), E82.2
/_irand: E13.17 (2A0), E14.7 (O7)
/_irdca: E13.11 (2A3), E14.11 (O4)
/_iriot: E14.14 (O1), E23.13 (2A2)
/_irisz: E13.13 (2A2), E14.10 (O5)
/_irjmp: E14.13 (O2), E23.15 (2A1)
/_irjms: E14.12 (O3), E23.17 (2A0)
/_iropr: E14.15 (O0), E23.11 (2A3)
/_irtad: E13.15 (2A1), E14.9 (O6)
/_lb0sel: E22.1 (1OE), E31.1 (1OE), E34.15 (~Y0), E35.1, E41.1 (1OE)
/_lb1sel: E22.19 (2OE), E31.19 (2OE), E34.14 (~Y1), E35.3, E41.19 (2OE)
/_lb2sel: E21.1 (1OE), E32.1 (1OE), E34.13 (~Y2), E35.13, E42.1 (1OE)
/_lb3sel: E21.19 (2OE), E32.19 (2OE), E34.12 (~Y3), E35.11, E42.19 (2OE)
/_lb4sel: E13.1 (1OE), E23.1 (1OE), E34.11 (~Y4), E35.9, E43.1 (1OE)
/_lb5sel: E13.19 (2OE), E23.19 (2OE), E34.10 (~Y5), E43.19 (2OE), E45.1
/_lb6sel: E34.9 (~Y6), E35.5, E51.1 (1OE), E52.1 (1OE), E62.1 (1OE)
/_lb7sel: E34.7 (~Y7), E45.13, E51.19 (2OE), E52.19 (2OE), E62.19 (2OE)
/_msbrk: E44.14 (O1), E62.4 (1A1)
/_mscad: E44.13 (O2), E62.2 (1A0)
/_msdef: E43.13 (2A2), E44.10 (O5)
/_msexe: E43.15 (2A1), E44.11 (O4)
/_msfet: E43.17 (2A0), E44.9 (O6)
/_mswct: E43.11 (2A3), E44.12 (O3)
/_reset: E25.1 (~CLR), E26.1 (~CLR), E36.1 (~CLR), E53.18 (~RESET), E54.1 (~Mr), E64.1 (~Mr), E72.1 (~CLR), E82.10
/bGPIO_4: E12.6 (D2), E13.7 (2Y2), E13.14 (1Y2), E21.7 (2Y2), E21.14 (1Y2), E22.7 (2Y2), E22.14 (1Y2), E53.4 (GPB3), E62.7 (2Y2), E62.14 (1Y2), E63.6 (D2), E64.5 (D1), J9.7
/bGPIO_5: E12.11 (D3), E13.9 (2Y3), E13.12 (1Y3), E21.9 (2Y3), E21.12 (1Y3), E22.9 (2Y3), E22.12 (1Y3), E53.3 (GPB2), E62.9 (2Y3), E62.12 (1Y3), E63.11 (D3), E64.12 (D2), J9.29
/bGPIO_6: E12.13 (D4), E23.3 (2Y0), E23.18 (1Y0), E31.3 (2Y0), E31.18 (1Y0), E32.3 (2Y0), E32.18 (1Y0), E51.3 (2Y0), E51.18 (1Y0), E53.2 (GPB1), E63.13 (D4), E64.13 (D3), J9.31
/bGPIO_7: E12.14 (D5), E23.5 (2Y1), E23.16 (1Y1), E31.5 (2Y1), E31.16 (1Y1), E32.5 (2Y1), E32.16 (1Y1), E51.5 (2Y1), E51.16 (1Y1), E53.1 (GPB0), E54.5 (D1), E63.14 (D5), J9.26
/bGPIO_8: E23.7 (2Y2), E23.14 (1Y2), E24.3 (D0), E31.7 (2Y2), E31.14 (1Y2), E32.7 (2Y2), E32.14 (1Y2), E51.7 (2Y2), E51.14 (1Y2), E53.26 (GPA5), E54.12 (D2), J9.24
/bGPIO_9: E23.9 (2Y3), E23.12 (1Y3), E24.4 (D1), E31.9 (2Y3), E31.12 (1Y3), E32.9 (2Y3), E32.12 (1Y3), E51.9 (2Y3), E51.12 (1Y3), E53.25 (GPA4), E54.13 (D3), J9.21
/bGPIO_10: E24.6 (D2), E41.3 (2Y0), E41.18 (1Y0), E42.3 (2Y0), E42.18 (1Y0), E43.3 (2Y0), E43.18 (1Y0), E52.3 (2Y0), E52.18 (1Y0), E53.24 (GPA3), J9.19
/bGPIO_11: E24.11 (D3), E41.5 (2Y1), E41.16 (1Y1), E42.5 (2Y1), E42.16 (1Y1), E43.5 (2Y1), E43.16 (1Y1), E52.5 (2Y1), E52.16 (1Y1), E53.23 (GPA2), J9.23
/bGPIO_12: E24.13 (D4), E41.7 (2Y2), E41.14 (1Y2), E42.7 (2Y2), E42.14 (1Y2), E43.7 (2Y2), E43.14 (1Y2), E52.7 (2Y2), E52.14 (1Y2), E53.22 (GPA1), J9.32
/bGPIO_13: E24.14 (D5), E41.9 (2Y3), E41.12 (1Y3), E42.9 (2Y3), E42.12 (1Y3), E43.9 (2Y3), E43.12 (1Y3), E52.9 (2Y3), E52.12 (1Y3), E53.21 (GPA0), J9.33
/bGPIO_14: E12.3 (D0), E13.3 (2Y0), E13.18 (1Y0), E21.3 (2Y0), E21.18 (1Y0), E22.3 (2Y0), E22.18 (1Y0), E53.6 (GPB5), E62.3 (2Y0), E62.18 (1Y0), E63.3 (D0), E64.4 (D0), J9.8
/bGPIO_15: E12.4 (D1), E13.5 (2Y1), E13.16 (1Y1), E21.5 (2Y1), E21.16 (1Y1), E22.5 (2Y1), E22.16 (1Y1), E53.5 (GPB4), E54.4 (D0), E62.5 (2Y1), E62.16 (1Y1), E63.4 (D1), J9.10
/clock: E81.18 (Y0), E82.1
/ctr_0: E72.14 (QA), E73.2 (I0a)
/ctr_1: E72.13 (QB), E73.5 (I0b)
/ctr_2: E72.12 (QC), E73.11 (I0c)
/ctr_3: E55.2, E72.11 (QD), E73.14 (I0d)
/dbn_0: E66.3 (QA)
/dbn_1: E66.2 (QB)
/dbn_2: E66.6 (QC)
/dbn_3: E66.7 (QD)
/dbn_4: E76.3 (QA)
/dbn_5: E76.2 (QB)
/dbn_6: E55.10, E76.6 (QC), E92.3, E92.6, E92.9, E92.11
/dbn_7: E76.7 (QD)
/div_0: E25.14 (QA)
/div_1: E25.13 (QB)
/div_2: E25.12 (QC), J6.4
/div_3: E25.11 (QD)
/div_4: E26.14 (QA), J6.6
/div_5: E26.13 (QB), J6.3
/div_6: E26.12 (QC)
/div_7: E26.11 (QD)
/div_8: E36.14 (QA)
/div_9: E36.13 (QB)
/div_10: E36.12 (QC)
/div_11: E36.11 (QD), J6.1
/iicenabd: E66.14 (CLR), E73.1 (S), E75.8, E76.14 (CLR), E83.8, E84.1 (S)
/iicsel_0: E53.7 (GPB6), E73.3 (I1a), E83.12, R4.2
/iicsel_1: E53.8 (GPB7), E73.6 (I1b), E83.10, R3.2
/iicsel_2: E53.27 (GPA6), E73.10 (I1c), E75.5, E83.13, R1.2
/iicsel_3: E53.28 (GPA7), E73.13 (I1d), E82.9, E83.9, R2.2
/ldswrow0: E12.9 (Cp), E24.9 (Cp), E85.3
/ldswrow1: E63.9 (Cp), E85.6
/ldswrow2: E54.9 (Cp), E55.9, E64.9 (Cp), E65.6
/lttime: E45.9, J6.2
/oGPOUT_16: E65.3, J9.36
/oGPOUT_17: E65.11, J9.11
/oGPOUT_18: E65.8, J9.12
/oGPOUT_20: E35.2, J9.38
/oGPOUT_21: E35.4, J9.40
/oGPOUT_22: E35.12, J9.15
/oGPOUT_23: E35.10, J9.16
/oGPOUT_24: E35.8, J9.18
/oGPOUT_25: E45.2, J9.22
/oGPOUT_26: E35.6, J9.37
/oGPOUT_27: E45.12, J9.13
/reset: E82.6, E82.11
/row_0: E34.1 (A0), E73.4 (Za), E74.1 (A0)
/row_1: E34.2 (A1), E73.7 (Zb), E74.2 (A1)
/row_2: E34.3 (A2), E73.9 (Zc)
/row_3: E34.4 (~E0), E34.5 (~E1), E73.12 (Zd), E74.6 (E2)
/swcont: E64.15 (Q3)
/swdepos: E64.7 (Q1)
/swdfld_0: E61.4 (A2), E63.7 (Q2)
/swdfld_1: E61.3 (A1), E63.5 (Q1)
/swdfld_2: E61.2 (A0), E63.2 (Q0)
/swexam: E64.10 (Q2)
/swifld_0: E61.7 (A5), E63.15 (Q5)
/swifld_1: E61.6 (A4), E63.12 (Q4)
/swifld_2: E61.5 (A3), E63.10 (Q3)
/swldad: E54.2 (Q0), E71.10, E81.3 (A1)
/swreg_0: E24.15 (Q5), E33.7 (A5)
/swreg_1: E24.12 (Q4), E33.6 (A4)
/swreg_2: E24.10 (Q3), E33.5 (A3)
/swreg_3: E24.7 (Q2), E33.4 (A2)
/swreg_4: E24.5 (Q1), E33.3 (A1)
/swreg_5: E24.2 (Q0), E33.2 (A0)
/swreg_6: E11.7 (A5), E12.15 (Q5)
/swreg_7: E11.6 (A4), E12.12 (Q4)
/swreg_8: E11.5 (A3), E12.10 (Q3)
/swreg_9: E11.4 (A2), E12.7 (Q2)
/swreg_10: E11.3 (A1), E12.5 (Q1)
/swreg_11: E11.2 (A0), E12.2 (Q0)
/swsinst: E54.15 (Q3)
/swsstep: E54.10 (Q2), E81.4 (A2)
/swstart: E64.2 (Q0)
/swstop: E54.7 (Q1)
/swtime: E45.5, E55.1, J6.5
GND: C11.2, C12.2, C13.2, C14.2, C21.2, C22.2, C23.2, C24.2, C25.2, C26.2, C31.2, C32.2, C33.2, C34.2, C35.2, C36.2, C41.2, C42.2, C43.2, C44.2, C45.2, C51.2, C52.2, C53.2, C54.2, C55.2, C61.2, C62.2, C63.2, C64.2, C65.2, C66.2, C71.2, C72.2, C73.2, C74.2, C75.2, C76.2, C81.2, C82.2, C83.2, C84.2, C85.2, C92.2, C94.2, E11.8 (A6), E11.9 (A7), E11.10 (GND), E11.19 (G2), E12.8 (GND), E13.10 (GND), E14.4 (E1), E14.5 (E2), E14.8 (GND), E21.10 (GND), E22.10 (GND), E23.10 (GND), E24.8 (GND), E25.3 (DA), E25.4 (DB), E25.5 (DC), E25.6 (QD), E25.8 (GND), E26.3 (DA), E26.4 (DB), E26.5 (DC), E26.6 (QD), E26.8 (GND), E31.10 (GND), E32.10 (GND), E33.8 (A6), E33.9 (A7), E33.10 (GND), E33.19 (G2), E34.8 (GND), E35.7 (GND), E36.3 (DA), E36.4 (DB), E36.5 (DC), E36.6 (QD), E36.8 (GND), E41.10 (GND), E42.10 (GND), E43.10 (GND), E44.4 (E1), E44.5 (E2), E44.8 (GND), E45.3, E45.7 (GND), E45.11, E51.10 (GND), E51.11 (2A3), E52.6 (1A2), E52.8 (1A3), E52.10 (GND), E53.10 (VSS), E53.15 (A0), E53.16 (A1), E53.17 (A2), E54.8 (GND), E55.7 (GND), E61.8 (A6), E61.9 (A7), E61.10 (GND), E61.19 (G2), E62.10 (GND), E63.8 (GND), E64.8 (GND), E65.7 (GND), E66.1 (B), E66.8 (GND), E66.9 (D), E66.10 (C), E66.15 (A), E71.1, E71.2, E71.4, E71.5, E71.7 (GND), E71.12, E71.13, E72.3 (DA), E72.4 (DB), E72.5 (DC), E72.6 (QD), E72.8 (GND), E73.8 (GND), E73.15 (E), E74.3 (A2), E74.4 (~E0), E74.5 (~E1), E74.8 (GND), E75.7 (GND), E75.9, E76.1 (B), E76.8 (GND), E76.9 (D), E76.15 (A), E81.1 (G1), E81.10 (GND), E81.19 (G2), E82.7 (GND), E83.7 (GND), E84.8 (GND), E84.13 (I1d), E84.14 (I0d), E84.15 (E), E85.7 (GND), E85.9, E85.10, E85.12, E85.13, E92.7 (GND), E94.7 (GND), E94.8, E94.9, J1.36, J2.36, J3.36, J4.36, J9.6, J9.9, J9.14, J9.20, J9.25, J9.30, J9.34, J9.39
unnamed: E55.11, E72.7 (ENP), E72.10 (ENT), E75.2
unnamed: E72.9 (~LOAD), E74.12 (~Y3), E82.13
unnamed: E25.7 (ENP), E25.9 (~LOAD), E25.10 (ENT), E26.7 (ENP), E26.9 (~LOAD), E36.7 (ENP), E36.9 (~LOAD), E75.1
unnamed: E25.15 (RCO), E26.10 (ENT)
unnamed: E26.15 (RCO), E36.10 (ENT)
unnamed: E45.6, E94.3, E94.5, E94.11
unnamed: E45.8, E55.13
unnamed: E54.6 (~Q1), E55.5
unnamed: E54.14 (~Q3), E55.4
unnamed: E64.3 (~Q0), E83.1, E92.2
unnamed: E64.6 (~Q1), E83.4, E92.12
unnamed: E64.11 (~Q2), E83.5, E92.8
unnamed: E64.14 (~Q3), E83.2, E92.5
unnamed: E55.3, E55.12
unnamed: E61.1 (G1), E71.8
unnamed: E55.8, E66.5 (UP)
unnamed: E66.12 (~CO), E76.5 (UP)
unnamed: E66.11 (~LOAD), E76.11 (~LOAD), E83.6
unnamed: E71.9, E82.4
unnamed: E75.6, E82.8
unnamed: E75.3, E82.12
unnamed: E65.1, E65.10, E65.12, E75.4, E75.12
unnamed: E65.5, E75.13, E85.1, E85.4
unnamed: E84.2 (I0a), E94.4
unnamed: E84.5 (I0b), E94.1
unnamed: E84.11 (I0c), E94.13
unnamed: E65.2, E74.15 (~Y0), E84.3 (I1a), E94.6
unnamed: E65.13, E74.14 (~Y1), E84.6 (I1b), E94.2
unnamed: E65.9, E74.13 (~Y2), E84.10 (I1c), E94.12
unnamed: E84.4 (Za), E85.2
unnamed: E84.7 (Zb), E85.5
unnamed: E65.4, E84.9 (Zc)
unnamed: E75.10, E75.11
unnamed: E55.6, E81.5 (A3)
unnamed: E81.6 (A4), E92.1
unnamed: E81.7 (A5), E92.13
unnamed: E81.8 (A6), E92.10
unnamed: E81.9 (A7), E92.4
VCC: C11.1, C12.1, C13.1, C14.1, C21.1, C22.1, C23.1, C24.1, C25.1, C26.1, C31.1, C32.1, C33.1, C34.1, C35.1, C36.1, C41.1, C42.1, C43.1, C44.1, C45.1, C51.1, C52.1, C53.1, C54.1, C55.1, C61.1, C62.1, C63.1, C64.1, C65.1, C66.1, C71.1, C72.1, C73.1, C74.1, C75.1, C76.1, C81.1, C82.1, C83.1, C84.1, C85.1, C92.1, C94.1, E11.20 (VCC), E12.1 (~Mr), E12.16 (VCC), E13.20 (VCC), E14.6 (E3), E14.16 (VCC), E21.20 (VCC), E22.20 (VCC), E23.20 (VCC), E24.1 (~Mr), E24.16 (VCC), E25.16 (VCC), E26.16 (VCC), E31.20 (VCC), E32.20 (VCC), E33.20 (VCC), E34.6 (E2), E34.16 (VCC), E35.14 (VCC), E36.16 (VCC), E41.20 (VCC), E42.20 (VCC), E43.20 (VCC), E44.16 (VCC), E45.14 (VCC), E51.20 (VCC), E52.20 (VCC), E53.9 (VDD), E54.16 (VCC), E55.14 (VCC), E61.20 (VCC), E62.20 (VCC), E63.1 (~Mr), E63.16 (VCC), E64.16 (VCC), E65.14 (VCC), E66.4 (DOWN), E66.16 (VCC), E71.14 (VCC), E72.16 (VCC), E73.16 (VCC), E74.16 (VCC), E75.14 (VCC), E76.4 (DOWN), E76.10 (C), E76.16 (VCC), E81.20 (VCC), E82.14 (VCC), E83.14 (VCC), E84.16 (VCC), E85.14 (VCC), E92.14 (VCC), E94.14 (VCC), J1.1, J2.1, J3.1, J4.1, J9.2, J9.4, R1.1, R2.1, R3.1, R4.1

Notes on the sheet:
gate switches to INBUS when requested by processor
row finished, start next
pulse switch row flipflops when reached max count
0.8uS
0.4uS
MSB
[05]
gate DF/IF switches to extmemory whenever LDAD switch is pressed
disable debounce when using iic
block switch row loads when doing lights or reading panel switches
12.8uS
[00] LSB
1.687mS * 64 = 108mS
204.8uS
block switch row selects when iicsel is 10xx value gen'd by 23017
25.6uS
[06]
0.2uS
lights for 3.2uS
rows 0.. 7 : lights (204.9uS each) rows 8..10 : switches (12.9uS each)
1.687mS
switch row selects active low panel gates switches to gpio connector
LSB
51.2uS
lights for 200uS
all rows finished, start over
switches for 0.4uS
6.4uS
debounce counter load 0x40 whenever all buttons released count at 1.687mS when any button pressed from 0x40 until it counts to 0x80
3.2uS
high: using mcp23017 low: using counters
102.4uS
delay sending df/if switches when ldad pressed quickly stop sending when ldad released ...so we don't jam up with df/if registers on extmemory board
switches for 1.6uS
[11] MSB
1.6uS
0.1uS
swSINST includes swSTOP
JUMPERS
iicsel 00..07 lights 08..11 switches 12..15 disconnected
load switch flipflop rows counters: normally low - 100nS pulse to load mcp23017: normally high - goes low when row selected goes high when de-selected to load

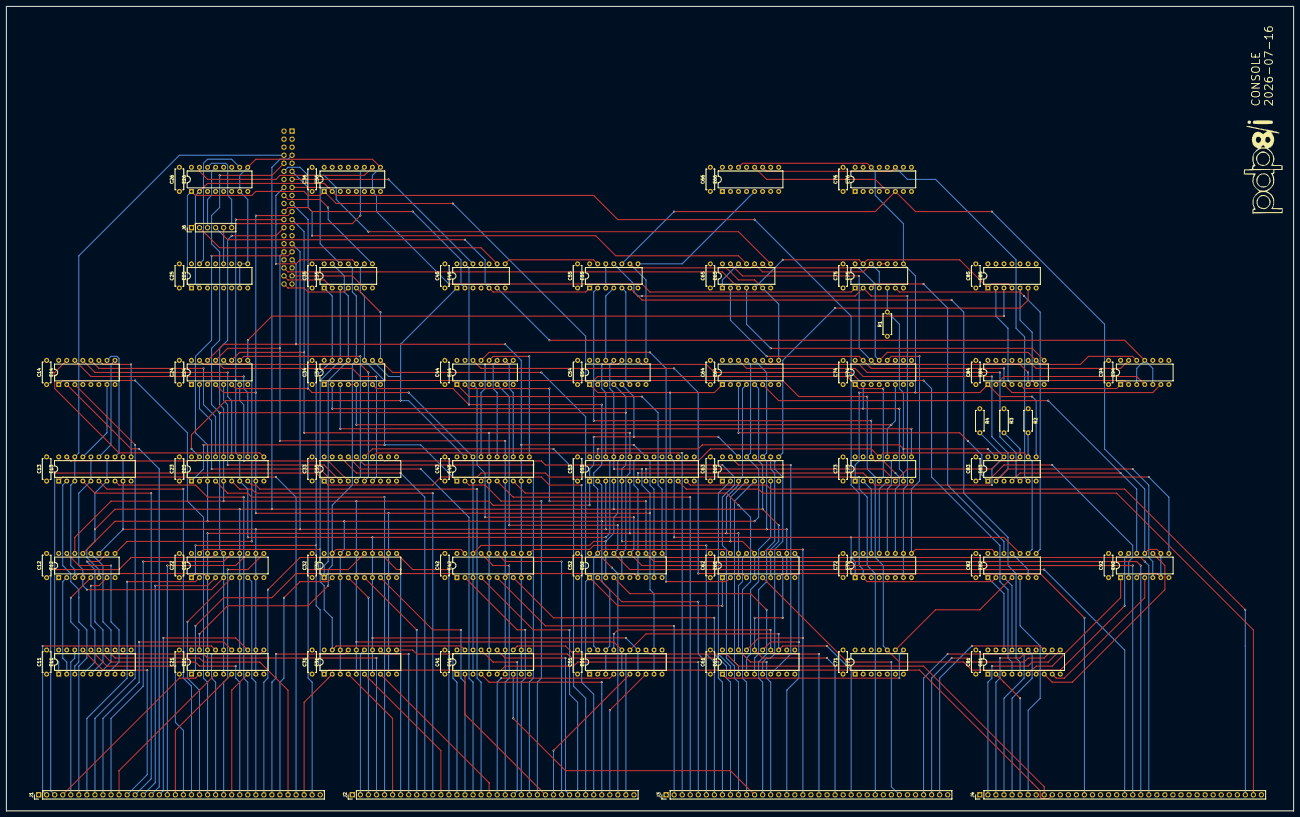
[picture p9: board console.kicad_pcb from above]

Board: 4 copper layers, 406.4 x 254.0 mm, 100 parts (1 on the bottom side), 238 nets.
