mrieker/pdp8i/kicads/extarctrl/extarctrl.kicad_pcb

## KiCad design kicads/extarctrl/extarctrl.kicad_pcb (2026-10-23)

Schematic: extarctrl.kicad_sch

Parts:
C11, C12, C13, C14, C21, C22, C23, C24, C25, C26, C31, C32, C33, C34, C35, C36, C41, C42, C43, C44, C45, C46, C51, C52, C53, C54, C55, C61, C62, C63, C64, C65, C71, C72, C73, C74, C75, C81, C82, C83, C84: C; R_Axial_DIN0207_L6.3mm_D2.5mm_P7.62mm_Horizontal
E11, E21, E31, E41, E51, E71, E81: 74AHC540; DIP-20_W7.62mm
E12, E61: 74AC10
E13: 74AHC86; DIP-14_W7.62mm
E14, E23, E25, E26, E36, E44, E46, E53, E54, E63, E83: 74AHC00; DIP-14_W7.62mm
E22, E32, E42: 74HC85; DIP-16_W7.62mm
E24, E43, E55: 74HC27; DIP-14_W7.62mm
E33, E52, E75: 74HC175; DIP-16_W7.62mm
E34: 74HC30
E35: 74AHC02; DIP-14_W7.62mm
E45, E74: 74AC10; DIP-14_W7.62mm
E62: 74AC11; DIP-14_W7.62mm
E64, E72: 74AHC04; DIP-14_W7.62mm
E65: 74HC30; DIP-14_W7.62mm
E73: 74AHC74; DIP-14_W7.62mm
E82: 74AHC08; DIP-14_W7.62mm
E84: 74AC20; DIP-14_W7.62mm
J1, J2, J3, J4: Conn_01x36; PinHeader_1x36_P2.54mm_Vertical
J5: Conn_02x05_Odd_Even; PinHeader_2x05_P2.54mm_Vertical
R1: 47K; R_Axial_DIN0207_L6.3mm_D2.5mm_P7.62mm_Horizontal

Connections:
/CONSCK: J4.35
/CONSDA: J4.34
/_ACCLEAR: J3.28
/_ACUM_0: J3.7
/_ACUM_1: J2.34
/_ACUM_2: J2.27
/_ACUM_3: J2.20
/_ACUM_4: J2.13
/_ACUM_5: J2.7
/_ACUM_6: J1.35
/_ACUM_7: J1.29
/_ACUM_8: J1.23
/_ACUM_9: J1.16
/_ACUM_10: J1.9
/_ACUM_11: J1.2
/_BRKCYC: J4.33
/_BRKRQST: J3.29
/_BRKWRM: J4.11
/_BUSINI: E71.2 (A0), J3.31
/_BWCOV: J3.32
/_CAINC: J4.12
/_CLOCK: E71.3 (A1), J4.6
/_CYCLE3: J4.13
/_INBUS_0: E51.7 (A5), J3.10
/_INBUS_1: E51.3 (A1), J3.3
/_INBUS_2: E41.7 (A5), J2.30
/_INBUS_3: E41.3 (A1), J2.23
/_INBUS_4: E31.7 (A5), J2.16
/_INBUS_5: E31.4 (A2), J2.10
/_INBUS_6: E21.9 (A7), J2.4
/_INBUS_7: J1.32
/_INBUS_8: E21.4 (A2), J1.26
/_INBUS_9: E11.9 (A7), J1.19
/_INBUS_10: E11.6 (A4), J1.12
/_INBUS_11: E11.3 (A1), J1.5
/_INTINH: J4.15
/_INTRQST: J4.16
/_ION: J3.30
/_IOP: J4.8
/_IOSKIP: J4.17
/_IREG_9: J1.22
/_IREG_10: J1.15
/_IREG_11: J1.8
/_LINK: J4.9
/_LNKTOG: J4.18
/_MAJST_0: E71.8 (A6), J4.22
/_MAJST_1: E71.7 (A5), J4.21
/_MAJST_2: E71.6 (A4), J4.20
/_MAJST_3: E71.5 (A3), J4.19
/_MBUF_0: E51.6 (A4), J3.9
/_MBUF_1: E51.2 (A0), J3.2
/_MBUF_2: E41.6 (A4), J2.29
/_MBUF_3: E41.2 (A0), J2.22
/_MBUF_4: E31.6 (A4), J2.15
/_MBUF_5: E31.3 (A1), J2.9
/_MBUF_6: E21.8 (A6), J2.3
/_MBUF_7: E21.6 (A4), J1.31
/_MBUF_8: E21.3 (A1), J1.25
/_MBUF_9: E11.8 (A6), J1.18
/_MBUF_10: E11.5 (A3), J1.11
/_MBUF_11: E11.2 (A0), J1.4
/_MQUO_0: E51.8 (A6), J3.11
/_MQUO_1: E51.4 (A2), J3.4
/_MQUO_2: E41.8 (A6), J2.31
/_MQUO_3: E41.4 (A2), J2.24
/_MQUO_4: E31.8 (A6), J2.17
/_MQUO_5: E31.5 (A3), J2.11
/_MQUO_6: E31.2 (A0), J2.5
/_MQUO_7: E21.7 (A5), J1.33
/_MQUO_8: E21.5 (A3), J1.27
/_MQUO_9: E21.2 (A0), J1.20
/_MQUO_10: E11.7 (A5), J1.13
/_MQUO_11: E11.4 (A2), J1.6
/_PAUSE: E71.16 (Y2), J4.14
/_RESET: J4.7
/_RUN: J4.10
/_SCTR_0: E51.9 (A7), J3.13
/_SCTR_1: E51.5 (A3), J3.6
/_SCTR_2: E41.9 (A7), J2.33
/_SCTR_3: E41.5 (A3), J2.26
/_SCTR_4: E31.9 (A7), J2.19
/_SWCONT: J4.2
/_SWDEPOS: J3.35
/_SWEXAM: J3.34
/_SWLDAD: J3.33
/_SWSINST: J4.5
/_SWSSTEP: J4.4
/_SWSTART: J4.3
/_TP1: E81.3 (A1), J4.27
/_TP2: E71.9 (A7), J4.28
/_TP3: J4.29
/_TP4: J4.30
/_TS1: J4.23
/_TS2: J4.24
/_TS3: E81.2 (A0), J4.25
/_TS4: J4.26
/_dviover: E73.5 (Q), E74.4
/_extar: E33.11 (~Q2)
/_extarex: E64.9, E65.8
/_extop_1: E52.3 (~Q0), E61.5, E62.13, E63.13, J3.21
/_extop_2: E52.6 (~Q1), E62.2, E63.12, J3.20
/_extop_3: E35.6, E52.11 (~Q2), E61.4, E61.13, J3.19
/_extop_4: E14.4, E14.12, E25.4, E25.10, E26.5, E36.1, E46.2, E46.4, E46.10, E46.12, E52.14 (~Q3), E53.2, E53.4
/_extop_5: E33.3 (~Q0)
/_extop_6: E33.6 (~Q1)
/_extop_dvi: E61.12, E72.13, J3.23
/_extop_muy: E61.6, E72.3, J3.22
/_majst_1: E63.9, E64.4
/_majst_2: E64.10, E65.5
/_majst_3: E64.12, E65.3
/_nmidone: E82.11, E83.5
/_s3clk: E74.13, E75.15 (Q3), J3.24, J5.9
/busini: E71.18 (Y0), E72.1
/clk2: E74.12, E75.4 (D0), J5.2
/clk4: E75.2 (Q0), E75.5 (D1), J5.4
/clk6: E75.7 (Q1), E75.12 (D2), J5.6
/clk8: E75.10 (Q2), J5.8
/clkp1: E63.5, J5.10, R1.1
/clksel: E75.13 (D3), J5.1, J5.3, J5.5, J5.7
/clock: E71.17 (Y1), E73.11 (C), E75.9 (Cp)
/countedshift: E35.4, E83.12
/dviover: E73.6 (~Q), J3.25
/extar: E33.10 (Q2), E65.1
/extarex: E62.11, E64.8, J3.26
/extop_1: E35.9, E52.2 (Q0), E61.1, J3.18
/extop_2: E35.8, E52.7 (Q1), E61.2, E61.3, J3.17
/extop_3: E52.10 (Q2), E62.1, J3.16
/extop_4: E52.15 (Q3), J3.15
/extop_5: E23.5, E33.2 (Q0), E44.5, E44.10, E54.4, E63.1
/extop_6: E14.10, E23.12, E25.1, E26.2, E26.9, E33.7 (Q1), E36.12, E44.1, E44.13, E53.12, E54.2, E54.10, E54.12
/extop_dvi: E72.12, E74.3
/extop_muy: E72.4, E83.1
/extop_nmi: E62.12, E83.4
/inbus_0: E23.9, E51.13 (Y5)
/inbus_1: E51.17 (Y1), E52.4 (D0)
/inbus_2: E41.13 (Y5), E52.5 (D1)
/inbus_3: E41.17 (Y1), E52.12 (D2)
/inbus_4: E31.13 (Y5), E52.13 (D3)
/inbus_5: E31.16 (Y2), E33.4 (D0)
/inbus_6: E21.11 (Y7), E33.5 (D1)
/inbus_8: E21.16 (Y2), E23.10
/inbus_9: E11.11 (Y7), E12.5
/inbus_10: E11.14 (Y4), E12.4
/inbus_11: E11.17 (Y1), E12.3
/majst_0: E62.4, E65.4, E71.12 (Y6)
/majst_000x: E55.6, E62.3, J3.27
/majst_1: E55.3, E64.3, E71.13 (Y5)
/majst_2: E55.5, E64.11, E71.14 (Y4)
/majst_3: E55.4, E64.13, E71.15 (Y3)
/memop: E63.10, E63.11
/mquo_0: E51.12 (Y6), E54.9, E55.13
/mquo_1: E51.16 (Y2), E54.13, E55.2
/mquo_2: E41.12 (Y6), E54.1, E55.1
/mquo_3: E41.16 (Y2), E43.4, E44.12
/mquo_4: E31.12 (Y6), E43.3, E44.2
/mquo_5: E31.15 (Y3), E43.5, E53.13
/mquo_6: E24.10, E26.10, E31.18 (Y0)
/mquo_7: E21.13 (Y5), E24.9, E36.13
/mquo_8: E21.15 (Y3), E24.11, E26.1
/mquo_9: E21.18 (Y0), E24.13, E25.2
/mquo_10: E11.13 (Y5), E23.13, E24.2
/mquo_11: E11.16 (Y2), E14.9, E24.1
/myac_0: E43.9, E53.5, J3.12
/myac_1: E43.10, E46.9, J3.5
/myac_2: E25.5, E43.11, J2.32
/myac_3: E43.1, E46.5, J2.25
/myac_4: E43.13, E46.1, J2.18
/myac_5: E43.2, E53.1, J2.12
/myac_6: E35.12, E36.2, J2.6
/myac_7: E35.11, E46.13, J1.34
/myac_8: E26.4, E35.3, J1.28
/myac_9: E25.9, E35.2, J1.21
/myac_10: E13.9, E14.5, J1.14
/myac_11: E13.10, E14.13, J1.7
/myacstep2_0: E42.10 (A0), E61.8, J3.8
/myacstep2_1: E42.12 (A1), E45.8, J2.35
/myacstep2_2: E12.8, E42.13 (A2), J2.28
/myacstep2_3: E42.15 (A3), E45.6, J2.21
/myacstep2_4: E32.10 (A0), E45.12, J2.14
/myacstep2_5: E32.12 (A1), E53.8, J2.8
/myacstep2_6: E32.13 (A2), E36.6, J2.2
/myacstep2_7: E32.15 (A3), E36.8, J1.30
/myacstep2_8: E22.10 (A0), E26.11, J1.24
/myacstep2_9: E22.12 (A1), E25.11, J1.17
/myacstep2_10: E22.13 (A2), E23.3, J1.10
/myacstep2_11: E14.3, E22.15 (A3), J1.3
/pause: E62.8, E63.4, E71.4 (A2), E74.1
/s3clk: E75.14 (~Q3)
/sctr_0: E51.11 (Y7), E63.2
/sctr_1: E51.15 (Y3), E54.5
/sctr_2: E23.4, E41.11 (Y7)
/sctr_3: E41.15 (Y3), E44.9
/sctr_4: E31.11 (Y7), E44.4
/sctr_5: E74.5, E83.2, E83.13, J3.14
/tp1: E62.5, E81.17 (Y1)
/tp2: E71.11 (Y7), E73.3 (C)
/ts3: E62.9, E81.18 (Y0)
/yreg_0: E42.9 (B0), E51.14 (Y4)
/yreg_1: E42.11 (B1), E51.18 (Y0)
/yreg_2: E41.14 (Y4), E42.14 (B2)
/yreg_3: E41.18 (Y0), E42.1 (B3)
/yreg_4: E31.14 (Y4), E32.9 (B0)
/yreg_5: E31.17 (Y1), E32.11 (B1)
/yreg_6: E21.12 (Y6), E32.14 (B2)
/yreg_7: E21.14 (Y4), E32.1 (B3)
/yreg_8: E21.17 (Y1), E22.9 (B0)
/yreg_9: E11.12 (Y6), E22.11 (B1)
/yreg_10: E11.15 (Y3), E22.14 (B2)
/yreg_11: E11.18 (Y0), E22.1 (B3)
GND: C11.2, C12.2, C13.2, C14.2, C21.2, C22.2, C23.2, C24.2, C25.2, C26.2, C31.2, C32.2, C33.2, C34.2, C35.2, C36.2, C41.2, C42.2, C43.2, C44.2, C45.2, C46.2, C51.2, C52.2, C53.2, C54.2, C55.2, C61.2, C62.2, C63.2, C64.2, C65.2, C71.2, C72.2, C73.2, C74.2, C75.2, C81.2, C82.2, C83.2, C84.2, E11.1 (G1), E11.10 (GND), E11.19 (G2), E12.1, E12.2, E12.7 (GND), E12.13, E13.1, E13.2, E13.4, E13.5, E13.7 (GND), E13.12, E13.13, E14.7 (GND), E21.1 (G1), E21.10 (GND), E21.19 (G2), E22.8 (GND), E23.7 (GND), E24.4, E24.7 (GND), E25.7 (GND), E26.7 (GND), E31.1 (G1), E31.10 (GND), E31.19 (G2), E32.8 (GND), E33.8 (GND), E33.13 (D3), E34.7 (GND), E35.7 (GND), E36.7 (GND), E41.1 (G1), E41.10 (GND), E41.19 (G2), E42.2 (Ia<b), E42.4 (Ia>b), E42.8 (GND), E43.7 (GND), E44.7 (GND), E45.7 (GND), E46.7 (GND), E51.1 (G1), E51.10 (GND), E51.19 (G2), E52.8 (GND), E53.7 (GND), E54.7 (GND), E55.7 (GND), E55.9, E55.10, E55.11, E61.7 (GND), E62.7 (GND), E63.7 (GND), E64.1, E64.5, E64.7 (GND), E65.7 (GND), E71.1 (G1), E71.10 (GND), E71.19 (G2), E72.5, E72.7 (GND), E72.9, E73.7 (GND), E74.7 (GND), E74.9, E74.10, E74.11, E75.8 (GND), E81.1 (G1), E81.4 (A2), E81.5 (A3), E81.6 (A4), E81.7 (A5), E81.8 (A6), E81.9 (A7), E81.10 (GND), E81.19 (G2), E82.1, E82.2, E82.4, E82.5, E82.7 (GND), E82.9, E82.10, E83.7 (GND), E83.9, E83.10, E84.7 (GND), E84.9, E84.10, E84.12, E84.13, J1.36, J2.36, J3.36, J4.36
unnamed: E34.5, E55.12
unnamed: E13.8, E72.11
unnamed: E26.8, E36.5
unnamed: E26.6, E26.12
unnamed: E26.3, E26.13
unnamed: E72.10, E82.13
unnamed: E36.3, E36.4
unnamed: E36.10, E36.11
unnamed: E63.6, E73.12 (D)
unnamed: E73.8 (~Q), E74.2
unnamed: E14.1, E14.11
unnamed: E14.2, E14.8
unnamed: E14.6, E23.1
unnamed: E12.11, E25.6
unnamed: E25.8, E25.12
unnamed: E25.3, E25.13
unnamed: E12.9, E54.3
unnamed: E45.10, E54.6
unnamed: E54.8, E61.10
unnamed: E45.9, E54.11
unnamed: E12.10, E23.6
unnamed: E23.8, E24.5
unnamed: E23.2, E23.11
unnamed: E61.9, E63.3
unnamed: E63.8, E65.6
unnamed: E74.6, E84.1
unnamed: E83.3, E84.2
unnamed: E83.11, E84.4
unnamed: E83.6, E84.5
unnamed: E62.10, E84.6
unnamed: E53.3, E53.9
unnamed: E53.6, E61.11
unnamed: E53.10, E53.11
unnamed: E33.9 (Cp), E52.9 (Cp), E62.6
unnamed: E24.6, E33.12 (D2)
unnamed: E33.1 (~Mr), E52.1 (~Mr), E72.2
unnamed: E12.6, E24.3
unnamed: E34.12, E35.1
unnamed: E35.5, E35.10
unnamed: E34.11, E35.13
unnamed: E45.13, E46.3
unnamed: E45.4, E46.6
unnamed: E45.11, E46.8
unnamed: E36.9, E46.11
unnamed: E24.8, E34.2
unnamed: E24.12, E34.1
unnamed: E34.3, E43.6
unnamed: E34.6, E43.8
unnamed: E34.4, E43.12
unnamed: E44.3, E45.1
unnamed: E44.6, E45.2
unnamed: E44.11, E45.3
unnamed: E44.8, E45.5
unnamed: E34.8, E82.12
unnamed: E32.2 (Ia<b), E42.7 (Oa<b)
unnamed: E32.3 (Ia=b), E42.6 (Oa=b)
unnamed: E32.4 (Ia>b), E42.5 (Oa>b)
unnamed: E22.2 (Ia<b), E32.7 (Oa<b)
unnamed: E22.3 (Ia=b), E32.6 (Oa=b)
unnamed: E22.4 (Ia>b), E32.5 (Oa>b)
unnamed: E22.7 (Oa<b), E73.2 (D)
VCC: C11.1, C12.1, C13.1, C14.1, C21.1, C22.1, C23.1, C24.1, C25.1, C26.1, C31.1, C32.1, C33.1, C34.1, C35.1, C36.1, C41.1, C42.1, C43.1, C44.1, C45.1, C46.1, C51.1, C52.1, C53.1, C54.1, C55.1, C61.1, C62.1, C63.1, C64.1, C65.1, C71.1, C72.1, C73.1, C74.1, C75.1, C81.1, C82.1, C83.1, C84.1, E11.20 (VCC), E12.14 (VCC), E13.14 (VCC), E14.14 (VCC), E21.20 (VCC), E22.16 (VCC), E23.14 (VCC), E24.14 (VCC), E25.14 (VCC), E26.14 (VCC), E31.20 (VCC), E32.16 (VCC), E33.16 (VCC), E34.14 (VCC), E35.14 (VCC), E36.14 (VCC), E41.20 (VCC), E42.3 (Ia=b), E42.16 (VCC), E43.14 (VCC), E44.14 (VCC), E45.14 (VCC), E46.14 (VCC), E51.20 (VCC), E52.16 (VCC), E53.14 (VCC), E54.14 (VCC), E55.14 (VCC), E61.14 (VCC), E62.14 (VCC), E63.14 (VCC), E64.14 (VCC), E65.2, E65.11, E65.12, E65.14 (VCC), E71.20 (VCC), E72.14 (VCC), E73.1 (~R), E73.4 (~S), E73.10 (~S), E73.13 (~R), E73.14 (VCC), E74.14 (VCC), E75.1 (~Mr), E75.16 (VCC), E81.20 (VCC), E82.14 (VCC), E83.14 (VCC), E84.14 (VCC), J1.1, J2.1, J3.1, J4.1, R1.2

Notes on the sheet:
doing execute cycle of extended arithmetic * in FETCH cycle if no memory operand * in EXEC cycle if has memory operand
dviover clocked at every TP2 but we only care about the one during EXEC cycle of DVI it must be valid in time to block the PAUSE during TS3 myacstep2 was valid since just after FETCH TP1 yreg (really MBUF) valid since just after EXEC TP1 ...so it has 3 clocks to soak through the comparators
pause processor at beginning of TS3 while doing step 3 resume when termination condition met
perform step 3 clocking while processor pausing at beginning of TS3 shift registers (AC,MQ) clock on posedge s3clk J5 jumper (@ CLOCK 10MHz): 1-2 : 100nS on; 100nS off (MUY 6.5uS) 3-4 : 200nS on; 200nS off (MUY 8.8uS) 5-6 : 300nS on; 300nS off (MUY 11.1uS) 7-8 : 400nS on; 400nS off (MUY 13.4uS) 9-1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
SHL,ASR,LSR
opcode clocked at TP1 during FETCH * extar = it is an extended arith opcode * memop = the opcode has memory operand
myacstep2 = value to clock into MYAC at TP2 for non-memory ops (NOP,NMI), clocked at FETCH TP2 for memory ops (SCL,MUY,DVI,SHL,ASR,LSR), clocked at EXEC TP2 'or' of the following: extop<4> = 0 : MYAC (ACUM from step 1) extop<5> = 1 : SCTR from prior instruction extop<6> = 1 : MQUO from prior instru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
has memory operand SCL,MUY,DVI,SHL,ASR,LSR
dviover = (myac >= yreg)

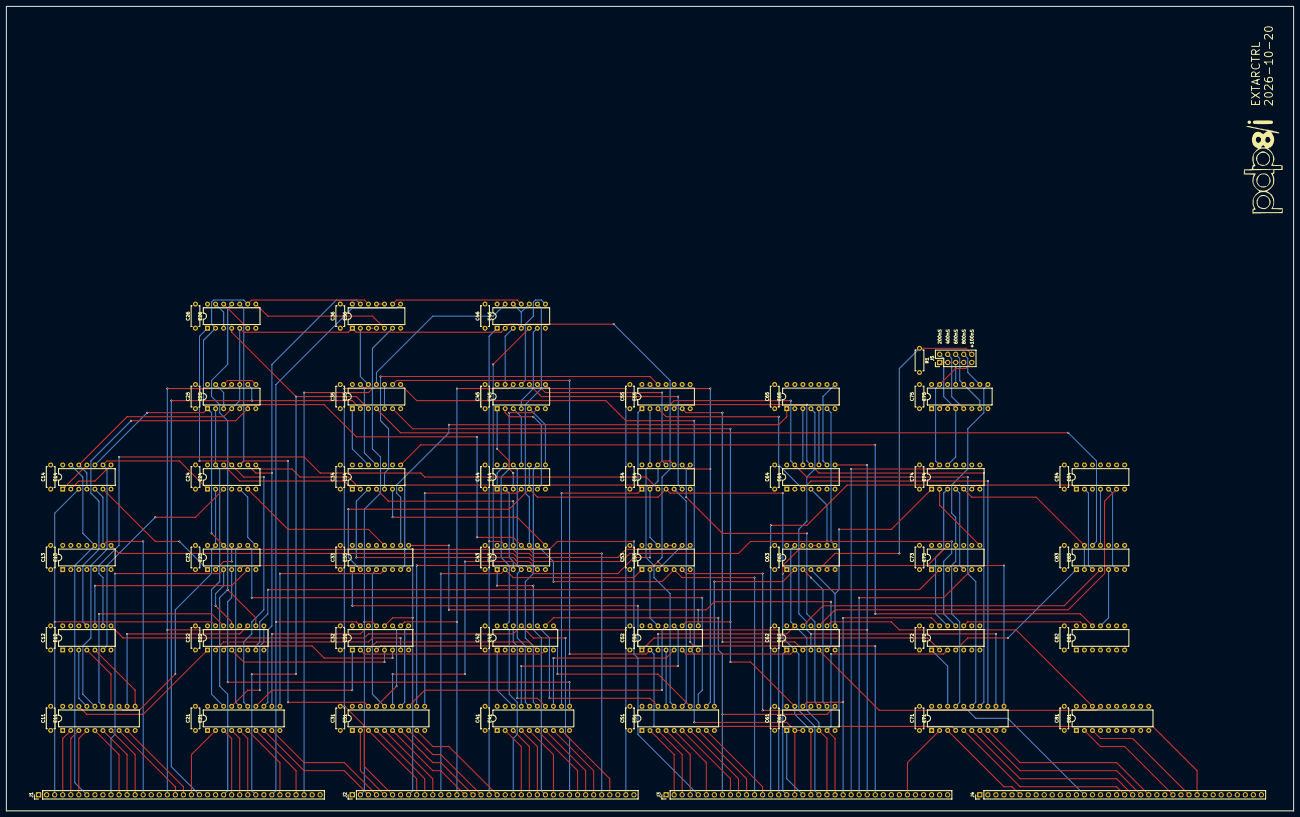
[picture p10: board extarctrl.kicad_pcb from above]

Board: 4 copper layers, 406.4 x 254.0 mm, 88 parts (0 on the bottom side), 222 nets.
