mrieker/pdp8i/kicads/realswcon/realswcon.kicad_pcb

## KiCad design kicads/realswcon/realswcon.kicad_pcb (2026-10-23)

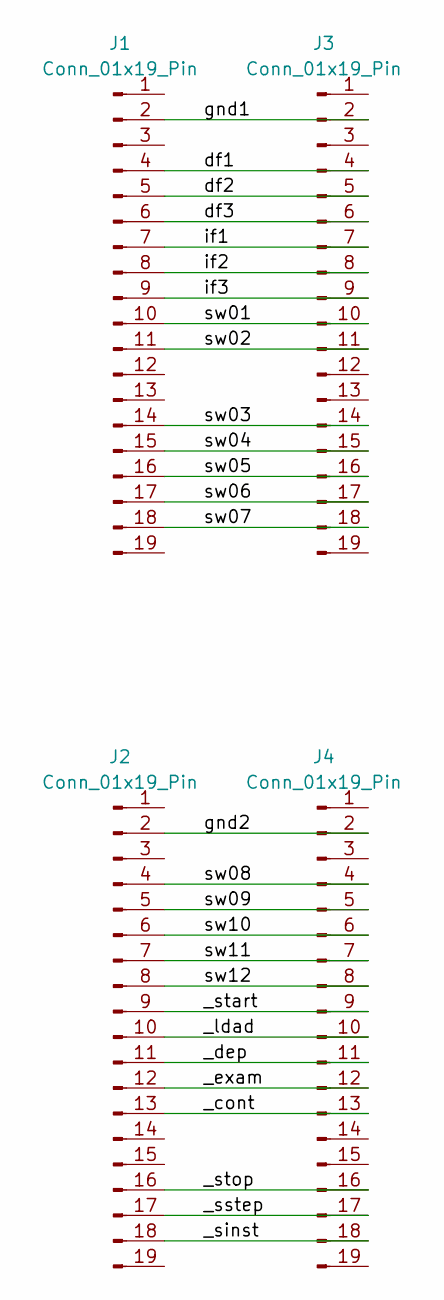
[picture p11: schematic realswcon.kicad_sch]

Parts:
J1, J2, J3, J4: Conn_01x19_Pin; PinHeader_1x19_P2.54mm_Vertical

Connections:
/_cont: J2.13, J4.13
/_dep: J2.11, J4.11
/_exam: J2.12, J4.12
/_ldad: J2.10, J4.10
/_sinst: J2.18, J4.18
/_sstep: J2.17, J4.17
/_start: J2.9, J4.9
/_stop: J2.16, J4.16
/df1: J1.4, J3.4
/df2: J1.5, J3.5
/df3: J1.6, J3.6
/gnd1: J1.2, J3.2
/gnd2: J2.2, J4.2
/if1: J1.7, J3.7
/if2: J1.8, J3.8
/if3: J1.9, J3.9
/sw01: J1.10, J3.10
/sw02: J1.11, J3.11
/sw03: J1.14, J3.14
/sw04: J1.15, J3.15
/sw05: J1.16, J3.16
/sw06: J1.17, J3.17
/sw07: J1.18, J3.18
/sw08: J2.4, J4.4
/sw09: J2.5, J4.5
/sw10: J2.6, J4.6
/sw11: J2.7, J4.7
/sw12: J2.8, J4.8

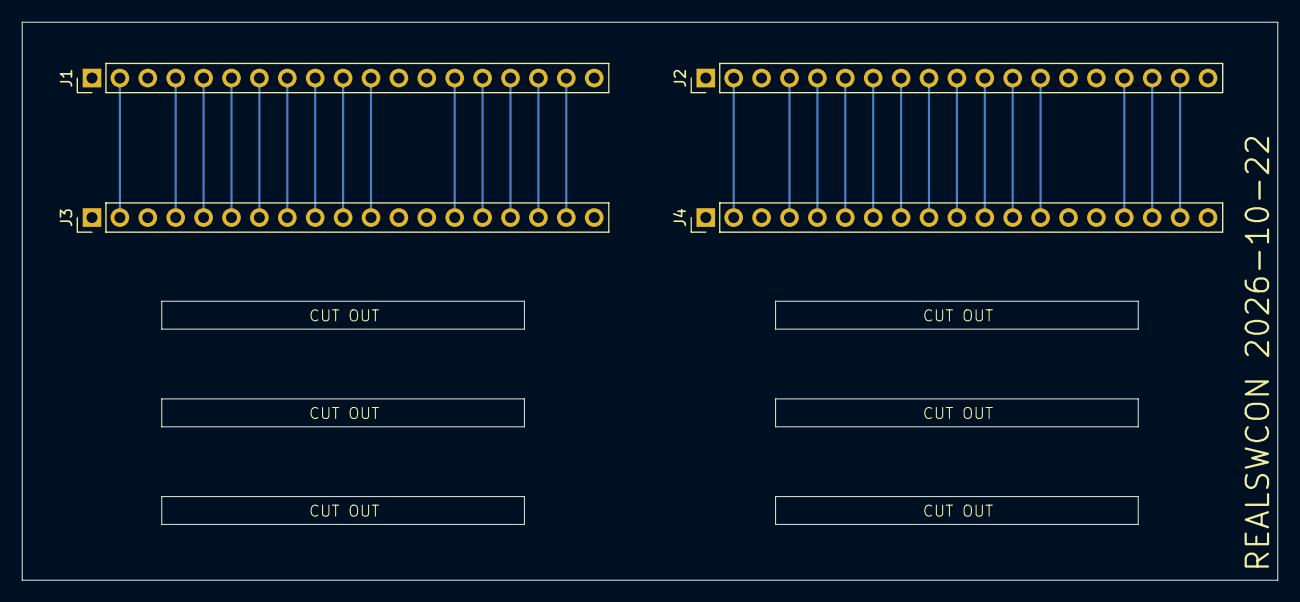
[picture p12: board realswcon.kicad_pcb from above]

Board: 2 copper layers, 114.3 x 50.8 mm, 4 parts (0 on the bottom side), 28 nets.
