mrieker/pdp8i/kicads/extardata/extardata.kicad_pcb

## KiCad design kicads/extardata/extardata.kicad_pcb (2026-10-23)

Schematic: extardata.kicad_sch

Parts:
C11, C12, C13, C14, C15, C16, C17, C18, C21, C22, C23, C24, C25, C26, C27, C28, C31, C32, C33, C34, C35, C36, C37, C38, C41, C42, C43, C44, C45, C46, C47, C48, C51, C52, C53, C54, C55, C56, C57, C58, C61, C62, C63, C64, C65, C66, C67, C68, C71, C72, C73, C74, C75, C76, C77, C78, C81, C82, C83, C84, C85, C86, C87, C88: C; R_Axial_DIN0207_L6.3mm_D2.5mm_P7.62mm_Horizontal
E11, E21, E22, E31, E41, E51, E61, E81, E82: 74AHC540; DIP-20_W7.62mm
E12, E13, E17, E23, E24, E25, E27, E28, E33, E34, E35, E36, E37, E38, E42, E45, E48, E52, E56, E57, E58, E62, E63, E64, E65: 74AC151; DIP-16_W7.62mm
E14, E16, E32, E44, E53, E54: 74AC283; DIP-16_W7.62mm
E15, E43, E83: 74AHC04; DIP-14_W7.62mm
E18: 74AHC32; DIP-14_W7.62mm
E26, E46, E47, E55: 74AHC174; DIP-16_W7.62mm
E66, E68: 74AHC02; DIP-14_W7.62mm
E67: 74HC27; DIP-14_W7.62mm
E71, E72: 74AC161; DIP-16_W7.62mm
E73, E85: 74AHC157; DIP-16_W7.62mm
E74, E76, E77: 74AHC00; DIP-14_W7.62mm
E75, E78, E84: 74AC10; DIP-14_W7.62mm
E86: 74AC11; DIP-14_W7.62mm
E87: 74AHC08; DIP-14_W7.62mm
E88: 74AHC74; DIP-14_W7.62mm
J1, J2, J3, J4: Conn_01x36; PinHeader_1x36_P2.54mm_Vertical

Connections:
/CONSCK: J4.35
/CONSDA: J4.34
/_ACCLEAR: E41.14 (Y4), J3.28
/_ACUM_0: E61.8 (A6), J3.7
/_ACUM_1: E61.4 (A2), J2.34
/_ACUM_2: E51.8 (A6), J2.27
/_ACUM_3: E51.4 (A2), J2.20
/_ACUM_4: E31.8 (A6), J2.13
/_ACUM_5: E31.5 (A3), J2.7
/_ACUM_6: E31.2 (A0), J1.35
/_ACUM_7: E22.6 (A4), J1.29
/_ACUM_8: E22.3 (A1), J1.23
/_ACUM_9: E11.8 (A6), J1.16
/_ACUM_10: E11.5 (A3), J1.9
/_ACUM_11: E11.2 (A0), J1.2
/_BRKCYC: J4.33
/_BRKRQST: J3.29
/_BRKWRM: J4.11
/_BUSINI: E82.4 (A2), J3.31
/_BWCOV: J3.32
/_CAINC: J4.12
/_CLOCK: J4.6
/_CYCLE3: J4.13
/_INBUS_0: E41.15 (Y3), J3.10
/_INBUS_1: E41.16 (Y2), J3.3
/_INBUS_2: E41.17 (Y1), J2.30
/_INBUS_3: E41.18 (Y0), J2.23
/_INBUS_4: E21.11 (Y7), J2.16
/_INBUS_5: E21.12 (Y6), J2.10
/_INBUS_6: E21.13 (Y5), J2.4
/_INBUS_7: E21.14 (Y4), E22.8 (A6), J1.32
/_INBUS_8: E21.15 (Y3), J1.26
/_INBUS_9: E21.16 (Y2), J1.19
/_INBUS_10: E21.17 (Y1), J1.12
/_INBUS_11: E21.18 (Y0), J1.5
/_INTINH: J4.15
/_INTRQST: J4.16
/_ION: J3.30
/_IOP: J4.8
/_IOSKIP: E41.13 (Y5), J4.17
/_IREG_9: J1.22
/_IREG_10: J1.15
/_IREG_11: J1.8
/_LINK: E82.5 (A3), J4.9
/_LNKTOG: E41.11 (Y7), J4.18
/_MAJST_0: E82.6 (A4), J4.22
/_MAJST_1: J4.21
/_MAJST_2: J4.20
/_MAJST_3: J4.19
/_MBUF_0: E61.9 (A7), J3.9
/_MBUF_1: E61.5 (A3), J3.2
/_MBUF_2: E51.9 (A7), J2.29
/_MBUF_3: E51.5 (A3), J2.22
/_MBUF_4: E31.9 (A7), J2.15
/_MBUF_5: E31.6 (A4), J2.9
/_MBUF_6: E31.3 (A1), J2.3
/_MBUF_7: E22.7 (A5), J1.31
/_MBUF_8: E22.4 (A2), J1.25
/_MBUF_9: E11.9 (A7), J1.18
/_MBUF_10: E11.6 (A4), J1.11
/_MBUF_11: E11.3 (A1), J1.4
/_MQUO_0: E82.18 (Y0), J3.11
/_MQUO_1: E61.14 (Y4), J3.4
/_MQUO_2: E61.18 (Y0), J2.31
/_MQUO_3: E51.14 (Y4), J2.24
/_MQUO_4: E51.18 (Y0), J2.17
/_MQUO_5: E31.13 (Y5), J2.11
/_MQUO_6: E31.16 (Y2), J2.5
/_MQUO_7: E22.11 (Y7), J1.33
/_MQUO_8: E22.15 (Y3), J1.27
/_MQUO_9: E22.18 (Y0), J1.20
/_MQUO_10: E11.13 (Y5), J1.13
/_MQUO_11: E11.16 (Y2), J1.6
/_PAUSE: J4.14
/_RESET: J4.7
/_RUN: J4.10
/_SCTR_0: E82.17 (Y1), J3.13
/_SCTR_1: E61.13 (Y5), J3.6
/_SCTR_2: E61.17 (Y1), J2.33
/_SCTR_3: E51.13 (Y5), J2.26
/_SCTR_4: E51.17 (Y1), J2.19
/_SWCONT: J4.2
/_SWDEPOS: J3.35
/_SWEXAM: J3.34
/_SWLDAD: J3.33
/_SWSINST: J4.5
/_SWSSTEP: J4.4
/_SWSTART: J4.3
/_TP1: E81.2 (A0), J4.27
/_TP2: E81.3 (A1), J4.28
/_TP3: J4.29
/_TP4: J4.30
/_TS1: E82.7 (A5), J4.23
/_TS2: E82.8 (A6), J4.24
/_TS3: E82.9 (A7), J4.25
/_TS4: J4.26
/_busini: E46.1 (~Mr), E47.1 (~Mr), E71.1 (~MR), E72.1 (~MR), E83.4
/_enouts: E21.19 (G2), E41.19 (G2), E74.11
/_ensctrld: E71.9 (~PE), E72.9 (~PE), E84.8
/_extop_1: E84.2, E86.5, J3.21
/_extop_2: E84.13, E86.4, J3.20
/_extop_3: E74.2, E84.1, J3.19
/_extop_dvi: E68.3, J3.23
/_extop_muy: E66.3, J3.22
/_s3clk: E74.4, E75.11, E76.2, J3.24
/_ts2: E78.5, E78.13, E83.10
/_ts3: E66.6, E66.12, E67.2, E67.9, E76.4, E83.6
/_yreg_0: E54.6 (B1), E73.3 (I1a), E83.2
/_yreg_1: E43.6, E54.2 (B2), E73.6 (I1b)
/_yreg_2: E43.10, E54.15 (B3), E73.10 (I1c)
/_yreg_3: E43.8, E54.11 (B4), E73.13 (I1d)
/_yreg_4: E43.4, E44.6 (B1), E85.3 (I1a)
/_yreg_5: E43.2, E44.2 (B2)
/_yreg_6: E15.6, E44.15 (B3)
/_yreg_7: E43.12, E44.11 (B4)
/_yreg_8: E15.10, E16.6 (B1)
/_yreg_9: E15.2, E16.2 (B2)
/_yreg_10: E15.12, E16.15 (B3)
/_yreg_11: E15.8, E16.11 (B4)
/acclk: E26.9 (Cp), E55.9 (Cp), E75.8, E88.3 (C)
/acmux_0: E55.3 (D0), E63.5 (Z)
/acmux_1: E55.4 (D1), E62.5 (Z)
/acmux_2: E55.6 (D2), E64.5 (Z)
/acmux_3: E52.5 (Z), E55.11 (D3)
/acmux_4: E42.5 (Z), E55.13 (D4)
/acmux_5: E33.5 (Z), E55.14 (D5)
/acmux_6: E23.5 (Z), E26.3 (D0)
/acmux_7: E24.5 (Z), E26.4 (D1)
/acmux_8: E25.5 (Z), E26.6 (D2)
/acmux_9: E13.5 (Z), E26.11 (D3)
/acmux_10: E17.5 (Z), E26.13 (D4)
/acmux_11: E12.5 (Z), E26.14 (D5)
/acsel_0: E12.11 (S0), E13.11 (S0), E17.11 (S0), E23.11 (S0), E24.11 (S0), E25.11 (S0), E33.11 (S0), E42.11 (S0), E52.11 (S0), E62.11 (S0), E63.11 (S0), E64.11 (S0), E78.6
/acsel_1: E12.10 (S1), E13.10 (S1), E17.10 (S1), E23.10 (S1), E24.10 (S1), E25.10 (S1), E33.10 (S1), E42.10 (S1), E52.10 (S1), E62.10 (S1), E63.10 (S1), E64.10 (S1), E67.8
/acsel_2: E12.9 (S2), E13.9 (S2), E17.9 (S2), E23.9 (S2), E24.9 (S2), E25.9 (S2), E33.9 (S2), E42.9 (S2), E52.9 (S2), E62.9 (S2), E63.9 (S2), E64.9 (S2), E66.4
/acsel_zero: E12.7 (~E), E13.7 (~E), E17.7 (~E), E23.7 (~E), E24.7 (~E), E25.7 (~E), E33.7 (~E), E42.7 (~E), E52.7 (~E), E62.7 (~E), E63.7 (~E), E64.7 (~E), E87.3
/acum_0: E61.12 (Y6), E63.4 (I0)
/acum_1: E61.16 (Y2), E62.4 (I0)
/acum_2: E51.12 (Y6), E64.4 (I0)
/acum_3: E51.16 (Y2), E52.4 (I0)
/acum_4: E31.12 (Y6), E42.4 (I0)
/acum_5: E31.15 (Y3), E33.4 (I0)
/acum_6: E23.4 (I0), E31.18 (Y0)
/acum_7: E22.14 (Y4), E24.4 (I0)
/acum_8: E22.17 (Y1), E25.4 (I0)
/acum_9: E11.12 (Y6), E13.4 (I0)
/acum_10: E11.15 (Y3), E17.4 (I0)
/acum_11: E11.18 (Y0), E12.4 (I0)
/busini: E82.16 (Y2), E83.3
/clocksctr: E71.2 (CP), E72.2 (CP), E74.6
/dvi_shl: E67.1, E67.3, E67.10, E68.1
/dviacstep_0: E54.4 (S1), E63.1 (I3)
/dviacstep_1: E54.1 (S2), E62.1 (I3)
/dviacstep_2: E54.13 (S3), E64.1 (I3)
/dviacstep_3: E52.1 (I3), E54.10 (S4)
/dviacstep_4: E42.1 (I3), E44.4 (S1)
/dviacstep_5: E33.1 (I3), E44.1 (S2)
/dviacstep_6: E23.1 (I3), E44.13 (S3)
/dviacstep_7: E24.1 (I3), E44.10 (S4)
/dviacstep_8: E16.4 (S1), E25.1 (I3)
/dviacstep_9: E13.1 (I3), E16.1 (S2)
/dviacstep_10: E16.13 (S3), E17.1 (I3)
/dviacstep_11: E12.1 (I3), E16.10 (S4)
/dvicarry: E16.9 (C23), E18.5
/dviover: E65.1 (I3), J3.25
/dviqbit: E18.6, E37.1 (I3), E68.2
/extarex: E74.10, E74.12, E75.2, E84.10, J3.26
/extop_1: E65.11 (S0), E77.5, J3.18
/extop_2: E65.10 (S1), E66.8, E74.1, J3.17
/extop_3: E65.9 (S2), E67.4, E86.3, J3.16
/extop_4: E75.1, J3.15
/inbus_7: E22.12 (Y6), E87.1
/link: E65.3 (I1), E65.4 (I0), E76.5, E82.15 (Y3)
/majst_0: E82.14 (Y4), E84.5
/majst_000x: E84.3, J3.27
/mqclk: E46.9 (Cp), E47.9 (Cp), E76.3
/mqmux_0: E37.5 (Z), E47.3 (D0)
/mqmux_1: E47.4 (D1), E56.5 (Z)
/mqmux_2: E47.6 (D2), E57.5 (Z)
/mqmux_3: E47.11 (D3), E48.5 (Z)
/mqmux_4: E47.13 (D4), E58.5 (Z)
/mqmux_5: E28.5 (Z), E47.14 (D5)
/mqmux_6: E34.5 (Z), E46.3 (D0)
/mqmux_7: E36.5 (Z), E46.4 (D1)
/mqmux_8: E45.5 (Z), E46.6 (D2)
/mqmux_9: E35.5 (Z), E46.11 (D3)
/mqmux_10: E38.5 (Z), E46.13 (D4)
/mqmux_11: E27.5 (Z), E46.14 (D5)
/mqsel_0: E27.11 (S0), E28.11 (S0), E34.11 (S0), E35.11 (S0), E36.11 (S0), E37.11 (S0), E38.11 (S0), E45.11 (S0), E48.11 (S0), E56.11 (S0), E57.11 (S0), E58.11 (S0), E78.12
/mqsel_1: E27.10 (S1), E28.10 (S1), E34.10 (S1), E35.10 (S1), E36.10 (S1), E37.10 (S1), E38.10 (S1), E45.10 (S1), E48.10 (S1), E56.10 (S1), E57.10 (S1), E58.10 (S1), E67.12
/mqsel_2: E27.9 (S2), E28.9 (S2), E34.9 (S2), E35.9 (S2), E36.9 (S2), E37.9 (S2), E38.9 (S2), E45.9 (S2), E48.9 (S2), E56.9 (S2), E57.9 (S2), E58.9 (S2), E66.13
/mquo_0: E47.2 (Q0), E56.1 (I3), E56.14 (I5), E56.15 (I4), E66.2, E82.2 (A0)
/mquo_1: E37.2 (I2), E37.12 (I7), E37.13 (I6), E47.5 (Q1), E57.1 (I3), E57.14 (I5), E57.15 (I4), E61.6 (A4)
/mquo_2: E47.7 (Q2), E48.1 (I3), E48.14 (I5), E48.15 (I4), E56.2 (I2), E56.12 (I7), E56.13 (I6), E61.2 (A0)
/mquo_3: E47.10 (Q3), E51.6 (A4), E57.2 (I2), E57.12 (I7), E57.13 (I6), E58.1 (I3), E58.14 (I5), E58.15 (I4)
/mquo_4: E28.1 (I3), E28.14 (I5), E28.15 (I4), E47.12 (Q4), E48.2 (I2), E48.12 (I7), E48.13 (I6), E51.2 (A0)
/mquo_5: E31.7 (A5), E34.1 (I3), E34.14 (I5), E34.15 (I4), E47.15 (Q5), E58.2 (I2), E58.12 (I7), E58.13 (I6)
/mquo_6: E28.2 (I2), E28.12 (I7), E28.13 (I6), E31.4 (A2), E36.1 (I3), E36.14 (I5), E36.15 (I4), E46.2 (Q0)
/mquo_7: E22.9 (A7), E34.2 (I2), E34.12 (I7), E34.13 (I6), E45.1 (I3), E45.14 (I5), E45.15 (I4), E46.5 (Q1)
/mquo_8: E22.5 (A3), E35.1 (I3), E35.14 (I5), E35.15 (I4), E36.2 (I2), E36.12 (I7), E36.13 (I6), E46.7 (Q2)
/mquo_9: E22.2 (A0), E38.1 (I3), E38.14 (I5), E38.15 (I4), E45.2 (I2), E45.12 (I7), E45.13 (I6), E46.10 (Q3)
/mquo_10: E11.7 (A5), E27.1 (I3), E27.14 (I5), E27.15 (I4), E35.2 (I2), E35.12 (I7), E35.13 (I6), E46.12 (Q4)
/mquo_11: E11.4 (A2), E38.2 (I2), E38.12 (I7), E38.13 (I6), E46.15 (Q5), E54.5 (A1), E63.14 (I5), E63.15 (I4)
/muy_lsr: E66.1, E66.9, E67.5, E77.1
/muyacstep_0: E53.1 (S2), E63.2 (I2)
/muyacstep_1: E53.13 (S3), E62.2 (I2)
/muyacstep_2: E53.10 (S4), E64.2 (I2)
/muyacstep_3: E32.4 (S1), E52.2 (I2)
/muyacstep_4: E32.1 (S2), E42.2 (I2)
/muyacstep_5: E32.13 (S3), E33.2 (I2)
/muyacstep_6: E23.2 (I2), E32.10 (S4)
/muyacstep_7: E14.4 (S1), E24.2 (I2)
/muyacstep_8: E14.1 (S2), E25.2 (I2)
/muyacstep_9: E13.2 (I2), E14.13 (S3)
/muyacstep_10: E14.10 (S4), E17.2 (I2)
/muyacstep_11: E12.2 (I2), E14.9 (C23)
/muymqstep_11: E27.2 (I2), E53.4 (S1)
/myac_0: E27.12 (I7), E27.13 (I6), E37.3 (I1), E41.5 (A3), E53.5 (A1), E54.3 (A2), E55.2 (Q0), E62.14 (I5), E62.15 (I4), J3.12
/myac_1: E41.4 (A2), E53.3 (A2), E54.14 (A3), E55.5 (Q1), E56.3 (I1), E63.12 (I7), E63.13 (I6), E64.14 (I5), E64.15 (I4), J3.5
/myac_2: E41.3 (A1), E52.14 (I5), E52.15 (I4), E53.14 (A3), E54.12 (A4), E55.7 (Q2), E57.3 (I1), E62.12 (I7), E62.13 (I6), J2.32
/myac_3: E41.2 (A0), E42.14 (I5), E42.15 (I4), E44.5 (A1), E48.3 (I1), E53.12 (A4), E55.10 (Q3), E64.12 (I7), E64.13 (I6), J2.25
/myac_4: E21.9 (A7), E32.5 (A1), E33.14 (I5), E33.15 (I4), E44.3 (A2), E52.12 (I7), E52.13 (I6), E55.12 (Q4), E58.3 (I1), J2.18
/myac_5: E21.8 (A6), E23.14 (I5), E23.15 (I4), E28.3 (I1), E32.3 (A2), E42.12 (I7), E42.13 (I6), E44.14 (A3), E55.15 (Q5), J2.12
/myac_6: E21.7 (A5), E24.14 (I5), E24.15 (I4), E26.2 (Q0), E32.14 (A3), E33.12 (I7), E33.13 (I6), E34.3 (I1), E44.12 (A4), J2.6
/myac_7: E16.5 (A1), E21.6 (A4), E23.12 (I7), E23.13 (I6), E25.14 (I5), E25.15 (I4), E26.5 (Q1), E32.12 (A4), E36.3 (I1), J1.34
/myac_8: E13.14 (I5), E13.15 (I4), E14.5 (A1), E16.3 (A2), E21.5 (A3), E24.12 (I7), E24.13 (I6), E26.7 (Q2), E45.3 (I1), J1.28
/myac_9: E14.3 (A2), E16.14 (A3), E17.14 (I5), E17.15 (I4), E21.4 (A2), E25.12 (I7), E25.13 (I6), E26.10 (Q3), E35.3 (I1), J1.21
/myac_10: E12.14 (I5), E12.15 (I4), E13.12 (I7), E13.13 (I6), E14.14 (A3), E16.12 (A4), E21.3 (A1), E26.12 (Q4), E38.3 (I1), J1.14
/myac_11: E12.13 (I6), E14.12 (A4), E17.12 (I7), E17.13 (I6), E18.4, E21.2 (A0), E26.15 (Q5), E27.3 (I1), E65.13 (I6), E76.13, J1.7
/myacstep2_0: E63.3 (I1), J3.8
/myacstep2_1: E62.3 (I1), J2.35
/myacstep2_2: E64.3 (I1), J2.28
/myacstep2_3: E52.3 (I1), J2.21
/myacstep2_4: E42.3 (I1), J2.14
/myacstep2_5: E33.3 (I1), J2.8
/myacstep2_6: E23.3 (I1), J2.2
/myacstep2_7: E24.3 (I1), J1.30
/myacstep2_8: E25.3 (I1), J1.24
/myacstep2_9: E13.3 (I1), J1.17
/myacstep2_10: E17.3 (I1), J1.10
/myacstep2_11: E12.3 (I1), J1.3
/mylink: E41.9 (A7), E65.5 (Z)
/sctr_0: E72.14 (Q0), E82.3 (A1)
/sctr_1: E61.7 (A5), E72.13 (Q1)
/sctr_2: E61.3 (A1), E72.12 (Q2)
/sctr_3: E51.7 (A5), E72.11 (Q3)
/sctr_4: E51.3 (A1), E71.14 (Q0)
/sctr_5: E71.13 (Q1), J3.14
/shllink: E65.14 (I5), E65.15 (I4), E88.5 (Q)
/tp1: E81.18 (Y0), E84.4
/tp2: E74.9, E75.13, E81.17 (Y1), E83.13
/ts1: E82.13 (Y5), E87.2
/ts2: E82.12 (Y6), E83.11, E84.9
/ts3: E71.7 (CEP), E72.7 (CEP), E72.10 (CET), E74.13, E76.12, E77.2, E77.4, E82.11 (Y7), E83.5
/yreg_0: E53.6 (B1), E61.11 (Y7), E83.1
/yreg_1: E43.5, E53.2 (B2), E61.15 (Y3)
/yreg_2: E43.11, E51.11 (Y7), E53.15 (B3)
/yreg_3: E43.9, E51.15 (Y3), E53.11 (B4)
/yreg_4: E31.11 (Y7), E32.6 (B1), E43.3
/yreg_5: E31.14 (Y4), E32.2 (B2), E43.1
/yreg_6: E15.5, E31.17 (Y1), E32.15 (B3)
/yreg_7: E22.13 (Y5), E32.11 (B4), E43.13
/yreg_8: E14.6 (B1), E15.11, E22.16 (Y2)
/yreg_9: E11.11 (Y7), E14.2 (B2), E15.1
/yreg_10: E11.14 (Y4), E14.15 (B3), E15.13
/yreg_11: E11.17 (Y1), E14.11 (B4), E15.9
GND: C11.2, C12.2, C13.2, C14.2, C15.2, C16.2, C17.2, C18.2, C21.2, C22.2, C23.2, C24.2, C25.2, C26.2, C27.2, C28.2, C31.2, C32.2, C33.2, C34.2, C35.2, C36.2, C37.2, C38.2, C41.2, C42.2, C43.2, C44.2, C45.2, C46.2, C47.2, C48.2, C51.2, C52.2, C53.2, C54.2, C55.2, C56.2, C57.2, C58.2, C61.2, C62.2, C63.2, C64.2, C65.2, C66.2, C67.2, C68.2, C71.2, C72.2, C73.2, C74.2, C75.2, C76.2, C77.2, C78.2, C81.2, C82.2, C83.2, C84.2, C85.2, C86.2, C87.2, C88.2, E11.1 (G1), E11.10 (GND), E11.19 (G2), E12.8 (GND), E12.12 (I7), E13.8 (GND), E14.8 (GND), E15.3, E15.7 (GND), E16.8 (GND), E17.8 (GND), E18.1, E18.2, E18.7 (GND), E18.9, E18.10, E18.12, E18.13, E21.1 (G1), E21.10 (GND), E22.1 (G1), E22.10 (GND), E22.19 (G2), E23.8 (GND), E24.8 (GND), E25.8 (GND), E26.8 (GND), E27.4 (I0), E27.7 (~E), E27.8 (GND), E28.4 (I0), E28.7 (~E), E28.8 (GND), E31.1 (G1), E31.10 (GND), E31.19 (G2), E32.8 (GND), E33.8 (GND), E34.4 (I0), E34.7 (~E), E34.8 (GND), E35.4 (I0), E35.7 (~E), E35.8 (GND), E36.4 (I0), E36.7 (~E), E36.8 (GND), E37.4 (I0), E37.7 (~E), E37.8 (GND), E37.14 (I5), E37.15 (I4), E38.4 (I0), E38.7 (~E), E38.8 (GND), E41.1 (G1), E41.10 (GND), E42.8 (GND), E43.7 (GND), E44.8 (GND), E45.4 (I0), E45.7 (~E), E45.8 (GND), E46.8 (GND), E47.8 (GND), E48.4 (I0), E48.7 (~E), E48.8 (GND), E51.1 (G1), E51.10 (GND), E51.19 (G2), E52.8 (GND), E53.7 (C0), E53.8 (GND), E54.8 (GND), E55.8 (GND), E56.4 (I0), E56.7 (~E), E56.8 (GND), E57.4 (I0), E57.7 (~E), E57.8 (GND), E58.4 (I0), E58.7 (~E), E58.8 (GND), E61.1 (G1), E61.10 (GND), E61.19 (G2), E62.8 (GND), E63.8 (GND), E64.8 (GND), E65.2 (I2), E65.7 (~E), E65.8 (GND), E65.12 (I7), E66.7 (GND), E67.7 (GND), E68.5, E68.6, E68.7 (GND), E68.8, E68.9, E68.11, E68.12, E71.5 (D2), E71.6 (D3), E71.8 (GND), E72.8 (GND), E73.2 (I0a), E73.5 (I0b), E73.8 (GND), E73.14 (I0d), E74.7 (GND), E75.3, E75.4, E75.5, E75.7 (GND), E76.7 (GND), E77.7 (GND), E77.9, E77.10, E77.12, E77.13, E78.7 (GND), E78.9, E78.10, E78.11, E81.1 (G1), E81.4 (A2), E81.5 (A3), E81.6 (A4), E81.7 (A5), E81.8 (A6), E81.9 (A7), E81.10 (GND), E81.19 (G2), E82.1 (G1), E82.10 (GND), E82.19 (G2), E83.7 (GND), E83.9, E84.7 (GND), E85.8 (GND), E85.10 (I1c), E85.11 (I0c), E85.13 (I1d), E85.14 (I0d), E86.1, E86.2, E86.7 (GND), E86.9, E86.10, E86.11, E86.13, E87.4, E87.5, E87.7 (GND), E87.9, E87.10, E87.12, E87.13, E88.7 (GND), E88.10 (~S), E88.11 (C), E88.12 (D), E88.13 (~R), J1.36, J2.36, J3.36, J4.36
unnamed: E74.5, E83.12
unnamed: E71.10 (CET), E72.15 (TC)
unnamed: E73.15 (E), E85.15 (E), E86.6
unnamed: E73.1 (S), E74.3, E85.1 (S)
unnamed: E71.3 (D0), E85.4 (Za)
unnamed: E71.4 (D1), E85.7 (Zb)
unnamed: E72.3 (D0), E73.4 (Za)
unnamed: E72.4 (D1), E73.7 (Zb)
unnamed: E72.5 (D2), E73.9 (Zc)
unnamed: E72.6 (D3), E73.12 (Zd)
unnamed: E76.8, E88.2 (D)
unnamed: E32.7 (C0), E53.9 (C23)
unnamed: E14.7 (C0), E32.9 (C23)
unnamed: E66.5, E66.11, E67.6
unnamed: E66.10, E67.11, E67.13
unnamed: E75.9, E84.6
unnamed: E84.11, E84.12
unnamed: E77.3, E78.1, E78.3
unnamed: E77.6, E78.2, E78.4
unnamed: E74.8, E75.10
unnamed: E75.12, E76.1
unnamed: E76.6, E76.9
unnamed: E76.10, E76.11
unnamed: E44.7 (C0), E54.9 (C23)
unnamed: E16.7 (C0), E44.9 (C23)
VCC: C11.1, C12.1, C13.1, C14.1, C15.1, C16.1, C17.1, C18.1, C21.1, C22.1, C23.1, C24.1, C25.1, C26.1, C27.1, C28.1, C31.1, C32.1, C33.1, C34.1, C35.1, C36.1, C37.1, C38.1, C41.1, C42.1, C43.1, C44.1, C45.1, C46.1, C47.1, C48.1, C51.1, C52.1, C53.1, C54.1, C55.1, C56.1, C57.1, C58.1, C61.1, C62.1, C63.1, C64.1, C65.1, C66.1, C67.1, C68.1, C71.1, C72.1, C73.1, C74.1, C75.1, C76.1, C77.1, C78.1, C81.1, C82.1, C83.1, C84.1, C85.1, C86.1, C87.1, C88.1, E11.20 (VCC), E12.16 (VCC), E13.16 (VCC), E14.16 (VCC), E15.14 (VCC), E16.16 (VCC), E17.16 (VCC), E18.14 (VCC), E21.20 (VCC), E22.20 (VCC), E23.16 (VCC), E24.16 (VCC), E25.16 (VCC), E26.1 (~Mr), E26.16 (VCC), E27.16 (VCC), E28.16 (VCC), E31.20 (VCC), E32.16 (VCC), E33.16 (VCC), E34.16 (VCC), E35.16 (VCC), E36.16 (VCC), E37.16 (VCC), E38.16 (VCC), E41.6 (A4), E41.7 (A5), E41.8 (A6), E41.20 (VCC), E42.16 (VCC), E43.14 (VCC), E44.16 (VCC), E45.16 (VCC), E46.16 (VCC), E47.16 (VCC), E48.16 (VCC), E51.20 (VCC), E52.16 (VCC), E53.16 (VCC), E54.7 (C0), E54.16 (VCC), E55.1 (~Mr), E55.16 (VCC), E56.16 (VCC), E57.16 (VCC), E58.16 (VCC), E61.20 (VCC), E62.16 (VCC), E63.16 (VCC), E64.16 (VCC), E65.16 (VCC), E66.14 (VCC), E67.14 (VCC), E68.14 (VCC), E71.16 (VCC), E72.16 (VCC), E73.11 (I0c), E73.16 (VCC), E74.14 (VCC), E75.14 (VCC), E76.14 (VCC), E77.14 (VCC), E78.14 (VCC), E81.20 (VCC), E82.20 (VCC), E83.14 (VCC), E84.14 (VCC), E85.2 (I0a), E85.5 (I0b), E85.6 (I1b), E85.16 (VCC), E86.14 (VCC), E87.14 (VCC), E88.1 (~R), E88.4 (~S), E88.14 (VCC), J1.1, J2.1, J3.1, J4.1

Notes on the sheet:
multiply step is a shift right when multiplier bit is zero
clock SCTR at TP2 or while step 3 stepping
divide step is a shift left when quotient bit is zero
LINK bit for left shifts: * loaded at TP2 from processor LINK * clocked by s3clk pulses during shifts
acsel condition 0 TS1 & msfetch - get initial ACUM contents into MYAC 1 TS2 & extarex - get step 2 results into ACUM 2 TS3 & (extop31 == 2 & muymbit) - MUY step with multiplier bit set 3 TS3 & (extop31 == 3 & dviqbit) - DVI step with quotient bit set 4 TS3 & (extop31 == 4) - NMI step 5 TS3 & (extop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
load 0 at TP2 for NMI load 20 at TP2 for MUY,DVI load ~YREG at TP2 for SCL,SHL,ASR,LSR
enable incrementing during TS3 (step 3)
memory operand follows opcode retained in MBUF by processor throughout EXEC cycle
TP2 & extarex: load step2 result
s3clk: shift/arith step
TP1 & FETCH: load ACUM or zero
extop<3:1> 0 : NOP : new link = old link 1 : SCL : new link = old link 2 : MUY : new link = 0 3 : DVI : new link = overflow 4 : NMI : new link = last bit shifted out 5 : SHL : new link = last bit shifted out 6 : ASR : new link = sign bit 7 : LSR : new link = 0
clear SCTR on bus init
enable loading during TS2 for extarex cycles and extop<3:1> ne 000

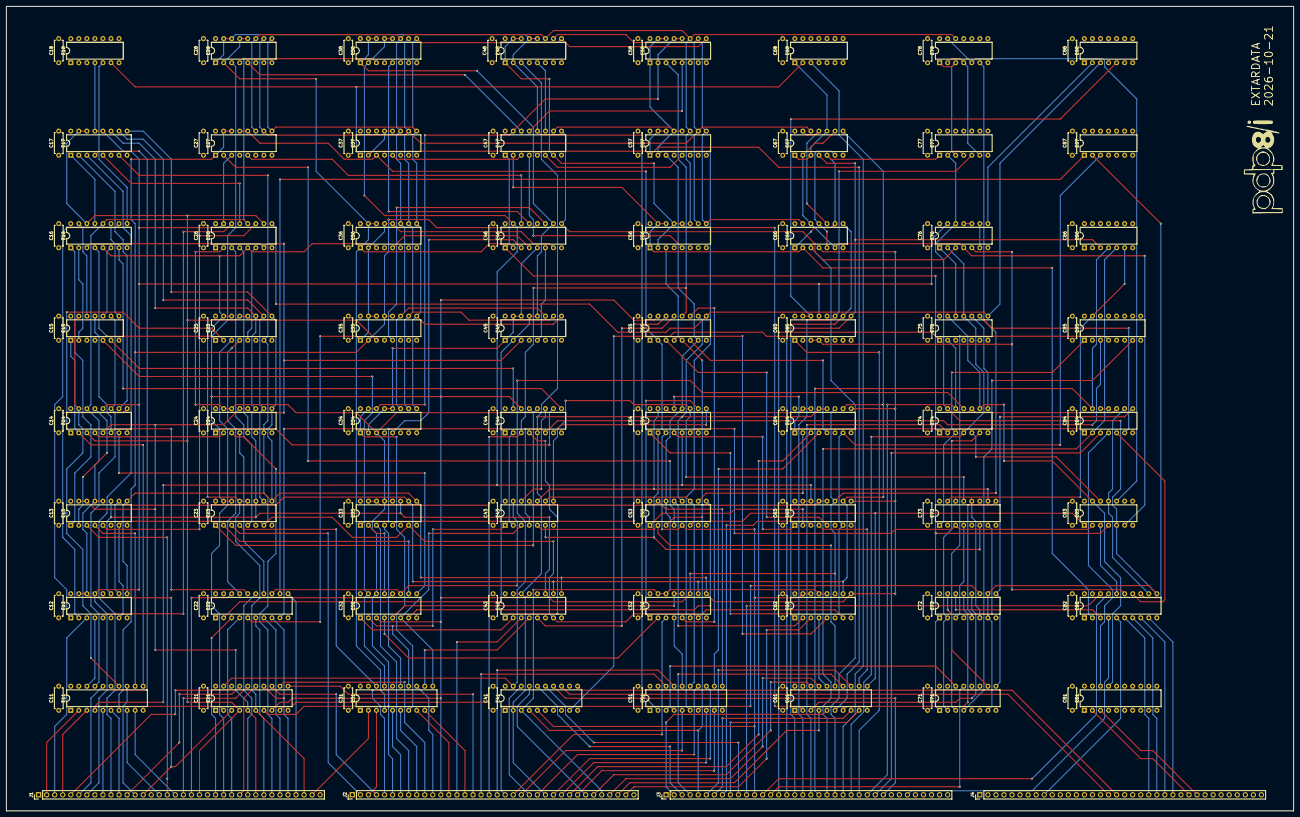
[picture p13: board extardata.kicad_pcb from above]

Board: 4 copper layers, 406.4 x 254.0 mm, 132 parts (0 on the bottom side), 261 nets.
