mrieker/pdp8i/kicads/procseq/procseq.kicad_pcb

## KiCad design kicads/procseq/procseq.kicad_pcb (2026-09-28)

Schematic: procseq.kicad_sch

Parts:
C11, C12, C13, C14, C15, C16, C17, C21, C22, C23, C24, C25, C26, C27, C31, C32, C33, C34, C35, C36, C37, C41, C42, C43, C44, C45, C46, C47, C51, C52, C53, C54, C55, C56, C57, C61, C62, C63, C64, C65, C66, C67, C71, C72, C73, C74, C75, C76, C77, C81, C82, C83, C84, C85, C86: C; R_Axial_DIN0207_L6.3mm_D2.5mm_P7.62mm_Horizontal
D1: DSB2810; D_DO-35_SOD27_P7.62mm_Horizontal
E11, E26: 74AHC138; DIP-16_W7.62mm
E12, E23, E27, E44, E64: 74AHC04; DIP-14_W7.62mm
E13, E15, E17, E24: 74HC30; DIP-14_W7.62mm
E14, E37, E62, E85: 74AHC02; DIP-14_W7.62mm
E16: 74AC20; DIP-14_W7.62mm
E21, E41, E51, E71, E72, E81: 74AHC540; DIP-20_W7.62mm
E22, E36, E43, E84: 74AHC00; DIP-14_W7.62mm
E25, E34, E54, E65, E75, E77: 74AHC74; DIP-14_W7.62mm
E31: 74HC27; DIP-14_W7.62mm
E32, E33, E61, E82: 74AC151; DIP-16_W7.62mm
E35, E57: 74AC11; DIP-14_W7.62mm
E42: 74AHC157; DIP-16_W7.62mm
E45: 74AHC32; DIP-14_W7.62mm
E46: 74AHC00
E47: 74AC161; DIP-16_W7.62mm
E52, E86: 74HC175; DIP-16_W7.62mm
E53, E56, E63, E67, E76: 74AC109; DIP-16_W7.62mm
E55, E74: 74AHC08; DIP-14_W7.62mm
E66: 74AC10; DIP-14_W7.62mm
E73, E83: 74AC153; DIP-16_W7.62mm
J1, J2, J3, J4: Conn_01x36; PinHeader_1x36_P2.54mm_Vertical
J5: Conn_01x02; PinHeader_1x02_P2.54mm_Vertical
R1, R2, R3: 1K; R_Axial_DIN0207_L6.3mm_D2.5mm_P7.62mm_Horizontal
R4: 47K; R_Axial_DIN0207_L6.3mm_D2.5mm_P7.62mm_Horizontal

Connections:
/CONSCK: J4.35
/CONSDA: J4.34
/_ACCLEAR: J3.28
/_ACUM_0: J3.7
/_ACUM_1: J2.34
/_ACUM_2: J2.27
/_ACUM_3: J2.20
/_ACUM_4: J2.13
/_ACUM_5: J2.7
/_ACUM_6: J1.35
/_ACUM_7: J1.29
/_ACUM_8: J1.23
/_ACUM_9: J1.16
/_ACUM_10: J1.9
/_ACUM_11: J1.2
/_BRKCYC: J4.33
/_BRKGNTO: E71.11 (Y7), J4.31
/_BRKRQST: E72.4 (A2), J3.29, R3.2
/_BRKWRM: J4.11
/_BUSINI: E71.14 (Y4), J3.31
/_BWCOV: J3.32
/_CAINC: J4.12
/_CLOCK: E72.2 (A0), J4.6
/_CYCLE3: E72.5 (A3), J4.13
/_DFLD_0: J3.22
/_DFLD_1: J3.18
/_DFLD_2: J3.14
/_DMAFLD_0: J3.23
/_DMAFLD_1: J3.19
/_DMAFLD_2: J3.15
/_IFLD_0: J3.24
/_IFLD_1: J3.20
/_IFLD_2: J3.16
/_INBUS_0: J3.10
/_INBUS_1: J3.3
/_INBUS_2: J2.30
/_INBUS_3: J2.23
/_INBUS_4: J2.16
/_INBUS_5: J2.10
/_INBUS_6: J2.4
/_INBUS_7: J1.32
/_INBUS_8: J1.26
/_INBUS_9: J1.19
/_INBUS_10: J1.12
/_INBUS_11: J1.5
/_INTINH: E72.7 (A5), J4.15
/_INTRQST: E72.8 (A6), J4.16, R2.2
/_ION: E72.11 (Y7), J3.30
/_IOP: E71.13 (Y5), J4.8
/_IOSKIP: J4.17
/_IREG_9: E21.4 (A2), J1.22
/_IREG_10: E21.3 (A1), J1.15
/_IREG_11: E21.2 (A0), J1.8
/_LINK: J4.9
/_LNKTOG: J4.18
/_MADR_0: J3.8
/_MADR_1: J2.35
/_MADR_2: J2.28
/_MADR_3: J2.21
/_MADR_4: J2.14
/_MADR_5: J2.8
/_MADR_6: J2.2
/_MADR_7: J1.30
/_MADR_8: J1.24
/_MADR_9: J1.17
/_MADR_10: J1.10
/_MADR_11: J1.3
/_MAJST_0: E71.15 (Y3), J4.22
/_MAJST_1: E71.16 (Y2), J4.21
/_MAJST_2: E71.17 (Y1), J4.20
/_MAJST_3: E71.18 (Y0), J4.19
/_MBUF_0: E41.5 (A3), J3.9
/_MBUF_1: E41.4 (A2), J3.2
/_MBUF_2: E41.3 (A1), J2.29
/_MBUF_3: E41.2 (A0), J2.22
/_MBUF_4: E21.9 (A7), J2.15
/_MBUF_5: E21.8 (A6), J2.9
/_MBUF_6: E21.7 (A5), J2.3
/_MBUF_7: E21.6 (A4), J1.31
/_MBUF_8: E21.5 (A3), J1.25
/_MBUF_9: J1.18
/_MBUF_10: J1.11
/_MBUF_11: J1.4
/_MEAD_0: J3.25
/_MEAD_1: J3.21
/_MEAD_2: J3.17
/_MEMDIS: J3.26
/_MQUO_0: J3.11
/_MQUO_1: J3.4
/_MQUO_2: J2.31
/_MQUO_3: J2.24
/_MQUO_4: J2.17
/_MQUO_5: J2.11
/_MQUO_6: J2.5
/_MQUO_7: J1.33
/_MQUO_8: J1.27
/_MQUO_9: J1.20
/_MQUO_10: J1.13
/_MQUO_11: J1.6
/_PAUSE: D1.2 (A), E72.6 (A4), J4.14, R1.2
/_PCTR_0: J3.12
/_PCTR_1: J3.5
/_PCTR_2: J2.32
/_PCTR_3: J2.25
/_PCTR_4: J2.18
/_PCTR_5: J2.12
/_PCTR_6: J2.6
/_PCTR_7: J1.34
/_PCTR_8: J1.28
/_PCTR_9: J1.21
/_PCTR_10: J1.14
/_PCTR_11: J1.7
/_READSR: J3.27
/_RESET: E72.3 (A1), J4.7
/_RUN: E71.12 (Y6), J4.10
/_SWCONT: E51.5 (A3), J4.2
/_SWDEPOS: E51.4 (A2), J3.35
/_SWEXAM: E51.3 (A1), J3.34
/_SWLDAD: E51.2 (A0), J3.33
/_SWSINST: E51.8 (A6), J4.5
/_SWSSTEP: E51.7 (A5), J4.4
/_SWSTART: E51.6 (A4), J4.3
/_TP1: E81.14 (Y4), J4.27
/_TP2: E81.13 (Y5), J4.28
/_TP3: E81.12 (Y6), J4.29
/_TP4: E81.11 (Y7), J4.30
/_TS1: E81.18 (Y0), J4.23
/_TS2: E81.17 (Y1), J4.24
/_TS3: E81.16 (Y2), J4.25
/_TS4: E81.15 (Y3), J4.26
/_brkgrnt: E75.8 (~Q), E82.1 (I3), E82.12 (I7), E82.13 (I6), E83.5 (I1a), E84.2
/_brkintfet_0: E43.9, E45.10, E46.1, E71.9 (A7), E75.9 (Q), E84.9, E85.6
/_brkintfet_1: E43.2, E44.6, E84.4, E84.13
/_brkintfet_2: E62.6, E64.6, E85.2
/_brkrqst: E17.4, E27.10
/_busini: E64.8, E67.1 (~R), E67.15 (~R), E74.13, E75.1 (~R), E76.5 (~S)
/_clock: E64.10, E77.3 (C)
/_hreq: E76.7 (~Q), E85.11
/_hreq_k: E76.3 (~K), E76.9 (~Q)
/_intgrnt: E75.6 (~Q)
/_intrqst: E17.11, E27.12
/_ioinst: E36.11, E37.5
/_ion: E67.9 (~Q)
/_iop: E53.7 (~Q)
/_irjmp: E11.10 (~Y5), E23.9, E62.5
/_jamms: E25.4 (~S), E45.1, E52.14 (~Q3), E55.1
/_majst_0: E34.8 (~Q)
/_majst_1: E34.6 (~Q)
/_majst_2: E25.8 (~Q)
/_majst_3: E16.10, E25.6 (~Q)
/_mbuf_0: E14.8, E23.10, E24.1
/_mbuf_1: E14.12, E22.12, E23.4
/_mbuf_2: E13.3, E15.4, E22.13, E23.6
/_mbuf_4: E12.10, E13.2
/_mbuf_5: E12.12, E13.1
/_mbuf_8: E15.6, E17.2, E23.12, E73.12 (I2b), E83.3 (I3a), E84.5
/_reset: E46.12, E47.1 (~MR), E53.1 (~R), E53.15 (~R), E54.1 (~R), E54.13 (~R), E56.1 (~R), E56.15 (~R), E57.5, E63.5 (~S), E63.15 (~R), E64.4, E65.1 (~R), E65.13 (~R)
/_swcontx: E35.3, E43.11, E44.13
/_swlaexdep: E31.8, E35.9, E44.3
/_swsinst: E17.3, E23.2
/_swsstep: E16.9, E17.6, E27.2, E36.1
/_swstart: E35.4, E44.10, E46.13
/_synpause: E47.7 (CEP), E47.10 (CET), E77.6 (~Q)
/_tp1: E63.13 (~K), E65.6 (~Q)
/_tp2: E56.3 (~K), E65.8 (~Q)
/_tp3: E53.3 (~K), E54.6 (~Q), E56.13 (~K)
/_tp4: E53.13 (~K), E54.8 (~Q), E85.12
/_ts1: E63.9 (~Q)
/_ts2: E37.6, E56.7 (~Q)
/_ts3: E56.9 (~Q)
/_ts4: E53.9 (~Q)
/_tsctld: E37.10, E47.9 (~PE)
/_wfidisab: E17.12, J5.1, R4.2
/brkintfet_1: E32.1 (I3), E32.12 (I7), E32.13 (I6), E44.5, E46.6, E83.11 (I1b)
/brkintfet_2: E61.1 (I3), E61.12 (I7), E61.13 (I6), E64.5, E73.5 (I1a), E74.4, E84.3
/brkrqst: E27.11, E72.16 (Y2), E75.12 (D)
/busini: E46.11, E64.9, E71.6 (A4)
/clock: E47.2 (CP), E52.9 (Cp), E53.4 (C), E53.12 (C), E54.3 (C), E54.11 (C), E56.4 (C), E56.12 (C), E63.4 (C), E63.12 (C), E64.11, E65.3 (C), E65.11 (C), E72.18 (Y0), E76.4 (C), E86.9 (Cp)
/cycle3: E64.1, E72.15 (Y3)
/endinst: E22.9, E33.5 (Z)
/hgnt: E37.8, E57.4, E62.9, E63.6 (Q)
/hreq: E62.12, E63.3 (~K), E76.6 (Q)
/hreq_j: E74.8, E76.2 (J)
/intdelayed: E57.9, E67.6 (Q), E72.9 (A7)
/intgrnt: E66.2, E75.5 (Q)
/intinh: E64.13, E72.13 (Y5)
/intrqst: E27.13, E72.12 (Y6), E75.2 (D)
/ion: E66.13, E67.10 (Q)
/iop: E15.11, E17.1, E53.6 (Q), E71.7 (A5)
/iot_iof: E14.13, E37.11
/iot_ion: E14.10, E67.2 (J)
/ireg_9: E11.3 (A2), E21.16 (Y2), E22.5
/ireg_10: E11.2 (A1), E21.17 (Y1), E22.1
/ireg_11: E11.1 (A0), E21.18 (Y0), E22.2, E22.4
/iriot: E12.6, E36.13
/irjmp: E23.8, E33.2 (I2), E43.1, E43.10
/iropr: E12.8, E24.2
/jamms: E43.5, E52.15 (Q3)
/majst_0: E26.1 (A0), E32.11 (S0), E33.11 (S0), E34.9 (Q), E42.3 (I1a), E61.11 (S0), E71.5 (A3), E82.11 (S0)
/majst_1: E26.2 (A1), E32.10 (S1), E33.10 (S1), E34.5 (Q), E61.10 (S1), E71.4 (A2), E82.10 (S1)
/majst_2: E25.9 (Q), E26.3 (A2), E32.9 (S2), E33.9 (S2), E61.9 (S2), E71.3 (A1), E82.9 (S2)
/majst_3: E25.5 (Q), E26.4 (~E0), E42.1 (S), E42.13 (I1d), E43.12, E71.2 (A0)
/mbuf_0: E13.5, E23.11, E41.15 (Y3), E66.3
/mbuf_1: E13.6, E23.3, E24.3, E41.16 (Y2)
/mbuf_2: E23.5, E41.17 (Y1)
/mbuf_3: E13.4, E31.2, E41.18 (Y0)
/mbuf_4: E12.11, E21.11 (Y7), E31.13
/mbuf_5: E12.13, E21.12 (Y6), E31.1
/mbuf_6: E13.11, E14.3, E21.13 (Y5)
/mbuf_7: E13.12, E14.2, E21.14 (Y4)
/mbuf_8: E21.15 (Y3), E23.13, E24.6, E66.5, E85.3, E85.5
/memacsw: E52.10 (Q2), E52.13 (D3), J2.19
/msbreak: E27.6, E46.10
/msfetch: E24.11, E27.4, E36.12, E57.11
/msintak: E27.8, E37.12
/nxtms_0: E34.12 (D), E42.4 (Za), J3.13
/nxtms_1: E34.2 (D), E42.7 (Zb), J3.6
/nxtms_2: E25.12 (D), E42.9 (Zc), J2.33
/nxtms_3: E25.2 (D), E42.12 (Zd), J2.26
/pause: E72.14 (Y4), E77.2 (D)
/reset: E64.3, E72.17 (Y1)
/run: E63.7 (~Q), E71.8 (A6)
/swcont: E43.13, E44.1, E51.15 (Y3)
/swdepos: E31.11, E43.4, E51.16 (Y2)
/swexam: E31.10, E51.17 (Y1), E62.2
/swldad: E31.9, E51.18 (Y0), E62.3
/swsinst: E22.10, E23.1, E51.12 (Y6)
/swsstep: E27.1, E36.5, E51.13 (Y5)
/swstart: E36.2, E36.4, E37.2, E44.11, E51.14 (Y4)
/synpause: E77.5 (Q)
/tp1: E37.9, E47.5 (D2), E56.2 (J), E65.5 (Q), E81.6 (A4)
/tp2: E46.9, E56.14 (J), E65.9 (Q), E81.7 (A5)
/tp3: E53.14 (J), E54.5 (Q), E67.4 (C), E67.12 (C), E74.9, E75.3 (C), E75.11 (C), E81.8 (A6)
/tp4: E25.3 (C), E25.11 (C), E34.3 (C), E34.11 (C), E54.9 (Q), E62.8, E81.9 (A7)
/ts1: E55.9, E63.10 (Q), E81.2 (A0)
/ts2: E56.6 (Q), E57.2, E81.3 (A1)
/ts3: E55.13, E56.10 (Q), E77.1 (~R), E81.4 (A2)
/ts4: E53.10 (Q), E55.5, E81.5 (A3)
/tsct_0: E47.14 (Q0), E55.10
/tsct_1: E47.13 (Q1), E55.4, E55.12, E57.1
/tsct_2: E47.12 (Q2), E57.13
/tsct_3: E47.11 (Q3)
/wfipause: E14.4, E51.9 (A7)
GND: C11.2, C12.2, C13.2, C14.2, C15.2, C16.2, C17.2, C21.2, C22.2, C23.2, C24.2, C25.2, C26.2, C27.2, C31.2, C32.2, C33.2, C34.2, C35.2, C36.2, C37.2, C41.2, C42.2, C43.2, C44.2, C45.2, C46.2, C47.2, C51.2, C52.2, C53.2, C54.2, C55.2, C56.2, C57.2, C61.2, C62.2, C63.2, C64.2, C65.2, C66.2, C67.2, C71.2, C72.2, C73.2, C74.2, C75.2, C76.2, C77.2, C81.2, C82.2, C83.2, C84.2, C85.2, C86.2, E11.4 (~E0), E11.5 (~E1), E11.8 (GND), E12.1, E12.3, E12.7 (GND), E13.7 (GND), E14.7 (GND), E15.7 (GND), E16.1, E16.2, E16.4, E16.5, E16.7 (GND), E17.7 (GND), E21.1 (G1), E21.10 (GND), E21.19 (G2), E22.7 (GND), E23.7 (GND), E24.7 (GND), E25.7 (GND), E26.5 (~E1), E26.8 (GND), E27.7 (GND), E31.3, E31.4, E31.5, E31.7 (GND), E32.4 (I0), E32.7 (~E), E32.8 (GND), E32.15 (I4), E33.4 (I0), E33.7 (~E), E33.8 (GND), E33.14 (I5), E33.15 (I4), E34.7 (GND), E35.1, E35.2, E35.7 (GND), E35.13, E36.7 (GND), E36.9, E36.10, E37.7 (GND), E41.1 (G1), E41.6 (A4), E41.7 (A5), E41.8 (A6), E41.9 (A7), E41.10 (GND), E41.19 (G2), E42.6 (I1b), E42.8 (GND), E42.10 (I1c), E42.14 (I0d), E42.15 (E), E43.7 (GND), E44.7 (GND), E44.9, E45.4, E45.5, E45.7 (GND), E45.12, E45.13, E46.7 (GND), E47.3 (D0), E47.4 (D1), E47.6 (D3), E47.8 (GND), E51.1 (G1), E51.10 (GND), E51.19 (G2), E52.8 (GND), E53.8 (GND), E54.7 (GND), E55.7 (GND), E56.8 (GND), E57.7 (GND), E61.4 (I0), E61.7 (~E), E61.8 (GND), E62.7 (GND), E63.8 (GND), E64.7 (GND), E65.7 (GND), E66.7 (GND), E66.9, E66.10, E66.11, E67.8 (GND), E71.1 (G1), E71.10 (GND), E71.19 (G2), E72.1 (G1), E72.10 (GND), E72.19 (G2), E73.1 (Ea), E73.3 (I3a), E73.8 (GND), E73.13 (I3b), E73.15 (Eb), E74.1, E74.2, E74.7 (GND), E75.7 (GND), E76.8 (GND), E77.7 (GND), E77.10 (~S), E77.11 (C), E77.12 (D), E77.13 (~R), E81.1 (G1), E81.10 (GND), E81.19 (G2), E82.4 (I0), E82.7 (~E), E82.8 (GND), E82.14 (I5), E83.1 (Ea), E83.8 (GND), E83.15 (Eb), E84.7 (GND), E85.7 (GND), E86.8 (GND), J1.36, J2.36, J3.36, J4.36, J5.2
unnamed: D1.1 (K), E51.11 (Y7)
unnamed: E11.12 (~Y3), E12.5
unnamed: E11.7 (~Y7), E12.9
unnamed: E13.8, E14.6
unnamed: E14.1, E15.1
unnamed: E14.5, E17.8
unnamed: E14.9, E14.11, E15.8
unnamed: E15.5, E31.12
unnamed: E16.8, E74.10
unnamed: E16.12, E24.8
unnamed: E16.13, E22.8
unnamed: E22.11, E66.4
unnamed: E25.1 (~R), E37.1, E55.2
unnamed: E25.13 (~R), E34.1 (~R), E55.3
unnamed: E26.14 (~Y1), E27.3
unnamed: E26.9 (~Y6), E27.5
unnamed: E26.7 (~Y7), E27.9
unnamed: E32.3 (I1), E83.9 (Zb)
unnamed: E32.2 (I2), E43.3
unnamed: E32.5 (Z), E42.5 (I0b)
unnamed: E33.3 (I1), E73.9 (Zb)
unnamed: E34.13 (~R), E43.6
unnamed: E34.10 (~S), E35.6
unnamed: E35.5, E45.3
unnamed: E35.10, E44.2
unnamed: E35.11, E36.3
unnamed: E36.6, E57.3
unnamed: E37.3, E44.12
unnamed: E42.2 (I0a), E82.5 (Z)
unnamed: E42.11 (I0c), E61.5 (Z)
unnamed: E45.2, E62.1
unnamed: E45.8, E46.5
unnamed: E45.9, E66.12, E84.1
unnamed: E46.2, E64.2
unnamed: E46.3, E46.4
unnamed: E46.8, E74.12
unnamed: E52.4 (D0), E85.10
unnamed: E52.2 (Q0), E52.5 (D1)
unnamed: E52.7 (Q1), E52.12 (D2)
unnamed: E44.4, E52.1 (~Mr), E86.1 (~Mr)
unnamed: E37.4, E53.2 (J)
unnamed: E54.2 (D), E55.11
unnamed: E54.12 (D), E55.6
unnamed: E61.3 (I1), E73.7 (Za)
unnamed: E61.2 (I2), E62.4
unnamed: E62.10, E62.11
unnamed: E63.2 (J), E85.13
unnamed: E62.13, E63.14 (J)
unnamed: E64.12, E66.1
unnamed: E55.8, E65.2 (D)
unnamed: E57.12, E65.12 (D)
unnamed: E37.13, E57.10, E67.3 (~K), E67.13 (~K)
unnamed: E57.8, E67.14 (J)
unnamed: E73.6 (I0a), E74.6
unnamed: E66.6, E73.10 (I0b), E74.5, E84.10, E84.12
unnamed: E73.4 (I2a), E85.1
unnamed: E22.6, E73.14 (S0), E83.14 (S0)
unnamed: E22.3, E73.2 (S1), E83.2 (S1)
unnamed: E74.11, E75.13 (~R)
unnamed: E35.8, E76.12 (C)
unnamed: E57.6, E76.15 (~R)
unnamed: E82.3 (I1), E83.7 (Za)
unnamed: E43.8, E82.2 (I2)
unnamed: E83.6 (I0a), E84.8
unnamed: E83.10 (I0b), E84.11
unnamed: E83.4 (I2a), E85.4
unnamed: E83.12 (I2b), E84.6
unnamed: E86.2 (Q0), E86.5 (D1)
unnamed: E86.7 (Q1), E86.12 (D2)
unnamed: E86.10 (Q2), E86.13 (D3)
unnamed: E85.9, E86.15 (Q3)
unnamed: E85.8, E86.11 (~Q2)
VCC: C11.1, C12.1, C13.1, C14.1, C15.1, C16.1, C17.1, C21.1, C22.1, C23.1, C24.1, C25.1, C26.1, C27.1, C31.1, C32.1, C33.1, C34.1, C35.1, C36.1, C37.1, C41.1, C42.1, C43.1, C44.1, C45.1, C46.1, C47.1, C51.1, C52.1, C53.1, C54.1, C55.1, C56.1, C57.1, C61.1, C62.1, C63.1, C64.1, C65.1, C66.1, C67.1, C71.1, C72.1, C73.1, C74.1, C75.1, C76.1, C77.1, C81.1, C82.1, C83.1, C84.1, C85.1, C86.1, E11.6 (E2), E11.16 (VCC), E12.14 (VCC), E13.14 (VCC), E14.14 (VCC), E15.2, E15.3, E15.12, E15.14 (VCC), E16.14 (VCC), E17.5, E17.14 (VCC), E21.20 (VCC), E22.14 (VCC), E23.14 (VCC), E24.4, E24.5, E24.12, E24.14 (VCC), E25.10 (~S), E25.14 (VCC), E26.6 (E2), E26.16 (VCC), E27.14 (VCC), E31.14 (VCC), E32.14 (I5), E32.16 (VCC), E33.1 (I3), E33.12 (I7), E33.13 (I6), E33.16 (VCC), E34.4 (~S), E34.14 (VCC), E35.14 (VCC), E36.14 (VCC), E37.14 (VCC), E41.20 (VCC), E42.16 (VCC), E43.14 (VCC), E44.14 (VCC), E45.14 (VCC), E46.14 (VCC), E47.16 (VCC), E51.20 (VCC), E52.16 (VCC), E53.5 (~S), E53.11 (~S), E53.16 (VCC), E54.4 (~S), E54.10 (~S), E54.14 (VCC), E55.14 (VCC), E56.5 (~S), E56.11 (~S), E56.16 (VCC), E57.14 (VCC), E61.14 (I5), E61.15 (I4), E61.16 (VCC), E62.14 (VCC), E63.1 (~R), E63.11 (~S), E63.16 (VCC), E64.14 (VCC), E65.4 (~S), E65.10 (~S), E65.14 (VCC), E66.14 (VCC), E67.5 (~S), E67.11 (~S), E67.16 (VCC), E71.20 (VCC), E72.20 (VCC), E73.11 (I1b), E73.16 (VCC), E74.14 (VCC), E75.4 (~S), E75.10 (~S), E75.14 (VCC), E76.1 (~R), E76.11 (~S), E76.13 (~K), E76.14 (J), E76.16 (VCC), E77.4 (~S), E77.14 (VCC), E81.20 (VCC), E82.15 (I4), E82.16 (VCC), E83.13 (I3b), E83.16 (VCC), E84.14 (VCC), E85.14 (VCC), E86.4 (D0), E86.16 (VCC), J1.1, J2.1, J3.1, J4.1, R1.1, R2.1, R3.1, R4.1

Notes on the sheet:
TPn on for last 100nS of TSn
begin TS1 when halt not requested and ending TS4 or ending HGNT
TS4 lasts for 400nS
counts: ts1: 0,1,2 (skip 3) ts2: 4,5,6,7 ts3: 8,9,10,11 ts4: 12,13,14,15 holds at 0 while halted
WFI - 6313 wait for interrupt request, dma request, either stop switch
begin IOP 100nS after TS2 starts and doing an I/O instruction
clocked on posedge TP4 or jammed when halted and button pressed
halt at end of HLT instruction
end TS1 400nS later
begin HGNT when TS4 ends and halt being requested
resume when LDAD,EXAM,DEPOS pressed then released it halts after that one cycle
begin TS2 when TS1 ends
halt at end of major state being requested * sets just after posedge TP3 * cleared when LDAD/EXAM/DEPOS/CONT/START switch released * sampled just before negedge TP4
6001 (ION)
end IOP at end of TS3
begin TS3 when TS2 ends
compute next major state
memacsw: 100nS pulse to load MADR 500nS after LDAD/EXAM/DEPOS pressed
end TS2 400nS later
jamms: jam MS_EXAM/MS_DEPOS into MAJST 600nS after LDAD/EXAM/DEPOS pressed
halt at end of any cycle with SSTEP switch
synchronize PAUSE on negedge clock it will be stable by posedge clock
pullups for open-collector signals procseq is only board that inputs these signals assume 74AHC drivers (rated 8mA)
START with SSTEP just resets START otherwise resets then starts
enable interrupts at TP3 when * enabled by preceding ION, and * not disabled by current IOF, and * doing a fetch cycle (started instr after ION) disable interrupts at TP3 when * doing an intak cycle, or * doing an IOF instruction feeds into brkintfet which is sampled at TP4 to compute next major st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
compute major state to follow current instruciton - if dma triple-cycle, output MS_WRDCT=4 - if dma single-cycle, output MS_BREAK=6 - if interrupt, output MS_INTAK=7 - else, output MS_FETCH=1
6002 (IOF)
3: ADD,TAD,ISZ,DCA,JMS 2: JMP 1: IOT 0: OPR
state after FETCH for JMP either DEFER or brkintfet
LDAD pressed: jam EXAM into MAJST gate INBUS to ALUQ then clock ALUQ to MADR,PCTR released: release halt request (hreq) EXAM pressed: jam EXAM into MAJST repeat: gate MADR+1 to ALUQ then clock ALUQ to MADR,PCTR released: release halt request (hreq) DEPOS same as EXAM plus INBUS put in MBUF during T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
not being blocked by memory extension
end HGNT when halt no longer being requested
compute major state following FETCH
either switch jams in state 000x swSTART at any time swCONT when in DEPOS or EXAM note: swCONT when not DEPOS or EXAM leaves state as is
new state for switches: LDAD: EXAM EXAM: EXAM DEPOS: DEPOS START: FETCH CONT: if currently EXAM or DEPOS, FETCH otherwise, leave state as is
other than depos jams in state xxx1
NOT (interrupt request)
end TS3 400nS later
end-of-instruction indicates current cycle is last of instruction or last of break or interrupt acknowledge endinst = FETCH : JMP: direct JMP IOT: always OPR: non-mem-ref ext arith DEFER : JMP EXEC : always BREAK : always INTAK : always
state after FETCH for OPR EXEC for extarith with memory operand brkintfet for everything else
request halt at TP3 when: * SINST switch on and last cycle of instruction * currently doing an EXAM or DEPOS cycle * STOP switch pressed * SSTEP switch on * FETCH and IR holds an HLT instruction
halt at end of instruction with SINST switch
jumper in disables WFI instr
MAJOR STATE 0 : PWRON 1 : FETCH 2 : DEFER 3 : EXEC 4 : WRDCT 5 : CURAD 6 : BREAK 7 : INTAK 8 : DEPOS 9 : EXAM
CONT with SSTEP or SINST does one cycle or instruction
halt at end of exam/depos cycle
break request clocked at TP3 cleared at TP2 of BREAK cycle
depos jams in state xxx0

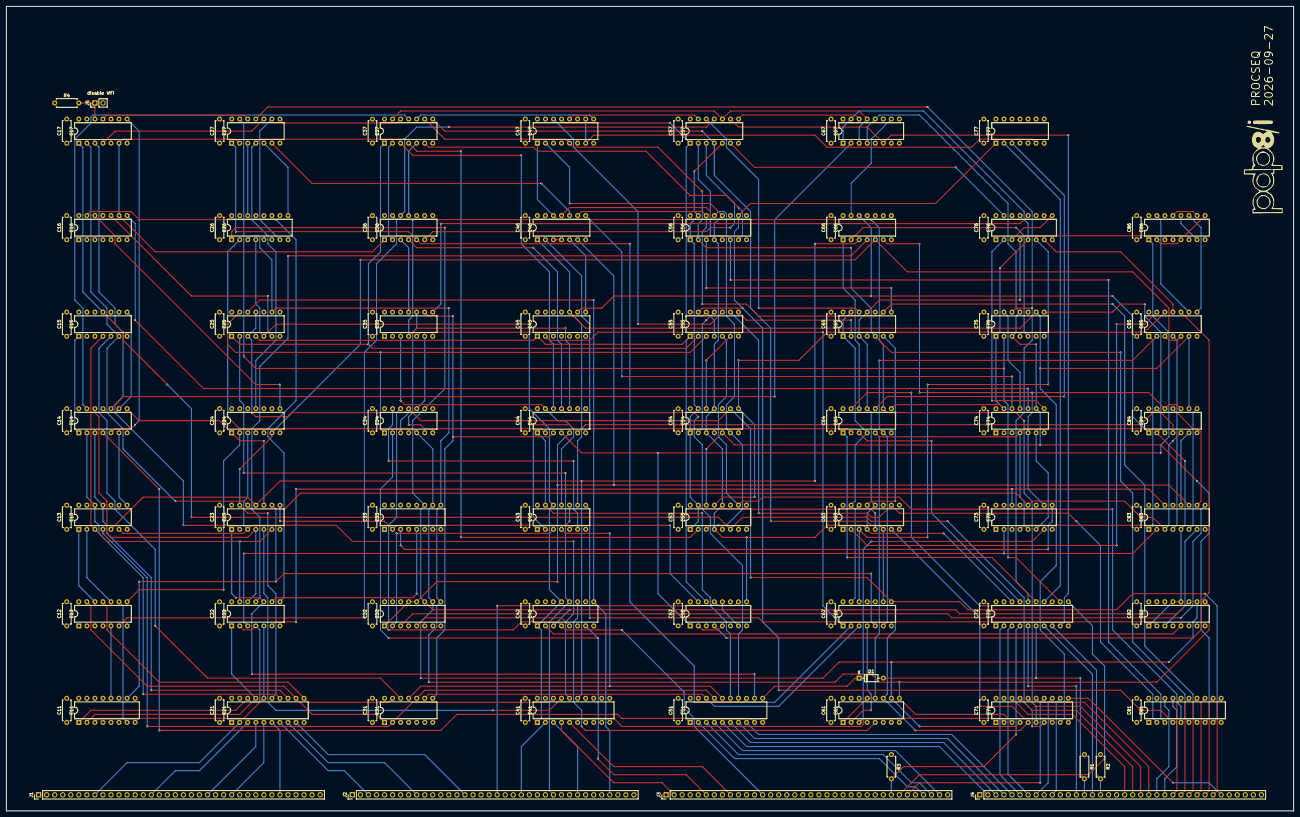
[picture p14: board procseq.kicad_pcb from above]

Board: 4 copper layers, 406.4 x 254.0 mm, 120 parts (0 on the bottom side), 219 nets.
