mrieker/pdp8i/kicads/extend/extend.kicad_pcb

## KiCad design kicads/extend/extend.kicad_pcb (2026-09-26)

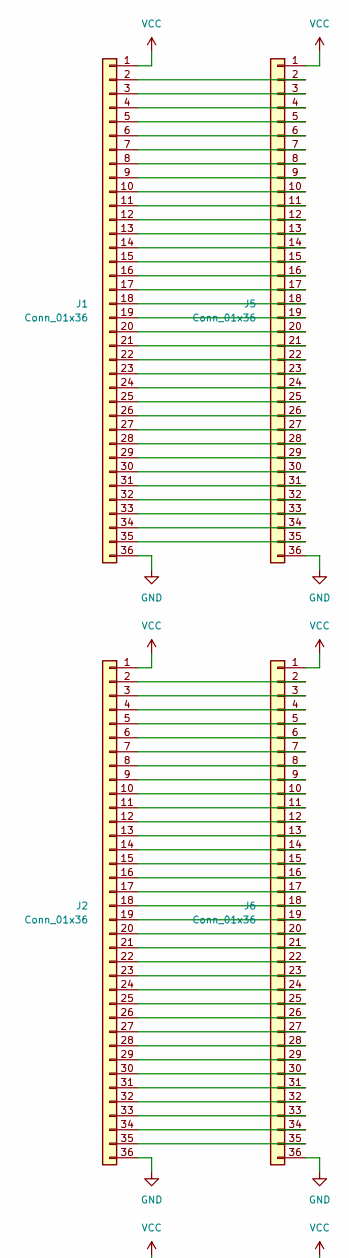
[picture p15: schematic extend.kicad_sch, part in row 1, column 1]

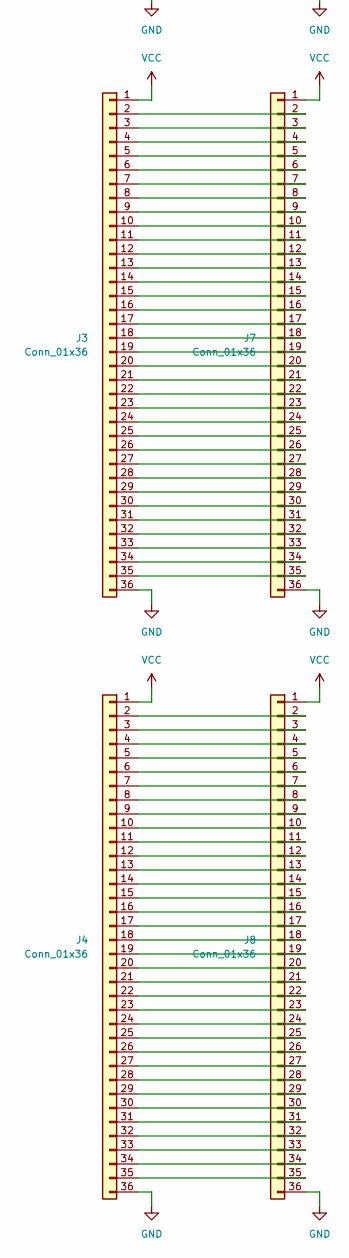
[picture p16: schematic extend.kicad_sch, part in row 2, column 1]

Parts:
J1, J2, J3, J4, J5, J6, J7, J8: Conn_01x36; PinHeader_1x36_P2.54mm_Vertical

Connections:
GND: J1.36, J2.36, J3.36, J4.36, J5.36, J6.36, J7.36, J8.36
unnamed: J1.2, J5.2
unnamed: J1.3, J5.3
unnamed: J1.4, J5.4
unnamed: J1.5, J5.5
unnamed: J1.6, J5.6
unnamed: J1.7, J5.7
unnamed: J1.8, J5.8
unnamed: J1.9, J5.9
unnamed: J1.10, J5.10
unnamed: J1.11, J5.11
unnamed: J1.12, J5.12
unnamed: J1.13, J5.13
unnamed: J1.14, J5.14
unnamed: J1.15, J5.15
unnamed: J1.16, J5.16
unnamed: J1.17, J5.17
unnamed: J1.18, J5.18
unnamed: J1.19, J5.19
unnamed: J1.20, J5.20
unnamed: J1.21, J5.21
unnamed: J1.22, J5.22
unnamed: J1.23, J5.23
unnamed: J1.24, J5.24
unnamed: J1.25, J5.25
unnamed: J1.26, J5.26
unnamed: J1.27, J5.27
unnamed: J1.28, J5.28
unnamed: J1.29, J5.29
unnamed: J1.30, J5.30
unnamed: J1.31, J5.31
unnamed: J1.32, J5.32
unnamed: J1.33, J5.33
unnamed: J1.34, J5.34
unnamed: J1.35, J5.35
unnamed: J2.2, J6.2
unnamed: J2.3, J6.3
unnamed: J2.4, J6.4
unnamed: J2.5, J6.5
unnamed: J2.6, J6.6
unnamed: J2.7, J6.7
unnamed: J2.8, J6.8
unnamed: J2.9, J6.9
unnamed: J2.10, J6.10
unnamed: J2.11, J6.11
unnamed: J2.12, J6.12
unnamed: J2.13, J6.13
unnamed: J2.14, J6.14
unnamed: J2.15, J6.15
unnamed: J2.16, J6.16
unnamed: J2.17, J6.17
unnamed: J2.18, J6.18
unnamed: J2.19, J6.19
unnamed: J2.20, J6.20
unnamed: J2.21, J6.21
unnamed: J2.22, J6.22
unnamed: J2.23, J6.23
unnamed: J2.24, J6.24
unnamed: J2.25, J6.25
unnamed: J2.26, J6.26
unnamed: J2.27, J6.27
unnamed: J2.28, J6.28
unnamed: J2.29, J6.29
unnamed: J2.30, J6.30
unnamed: J2.31, J6.31
unnamed: J2.32, J6.32
unnamed: J2.33, J6.33
unnamed: J2.34, J6.34
unnamed: J2.35, J6.35
unnamed: J3.2, J7.2
unnamed: J3.3, J7.3
unnamed: J3.4, J7.4
unnamed: J3.5, J7.5
unnamed: J3.6, J7.6
unnamed: J3.7, J7.7
unnamed: J3.8, J7.8
unnamed: J3.9, J7.9
unnamed: J3.10, J7.10
unnamed: J3.11, J7.11
unnamed: J3.12, J7.12
unnamed: J3.13, J7.13
unnamed: J3.14, J7.14
unnamed: J3.15, J7.15
unnamed: J3.16, J7.16
unnamed: J3.17, J7.17
unnamed: J3.18, J7.18
unnamed: J3.19, J7.19
unnamed: J3.20, J7.20
unnamed: J3.21, J7.21
unnamed: J3.22, J7.22
unnamed: J3.23, J7.23
unnamed: J3.24, J7.24
unnamed: J3.25, J7.25
unnamed: J3.26, J7.26
unnamed: J3.27, J7.27
unnamed: J3.28, J7.28
unnamed: J3.29, J7.29
unnamed: J3.30, J7.30
unnamed: J3.31, J7.31
unnamed: J3.32, J7.32
unnamed: J3.33, J7.33
unnamed: J3.34, J7.34
unnamed: J3.35, J7.35
unnamed: J4.2, J8.2
unnamed: J4.3, J8.3
unnamed: J4.4, J8.4
unnamed: J4.5, J8.5
unnamed: J4.6, J8.6
unnamed: J4.7, J8.7
unnamed: J4.8, J8.8
unnamed: J4.9, J8.9
unnamed: J4.10, J8.10
unnamed: J4.11, J8.11
unnamed: J4.12, J8.12
unnamed: J4.13, J8.13
unnamed: J4.14, J8.14
unnamed: J4.15, J8.15
unnamed: J4.16, J8.16
unnamed: J4.17, J8.17
unnamed: J4.18, J8.18
unnamed: J4.19, J8.19
unnamed: J4.20, J8.20
unnamed: J4.21, J8.21
unnamed: J4.22, J8.22
unnamed: J4.23, J8.23
unnamed: J4.24, J8.24
unnamed: J4.25, J8.25
unnamed: J4.26, J8.26
unnamed: J4.27, J8.27
unnamed: J4.28, J8.28
unnamed: J4.29, J8.29
unnamed: J4.30, J8.30
unnamed: J4.31, J8.31
unnamed: J4.32, J8.32
unnamed: J4.33, J8.33
unnamed: J4.34, J8.34
unnamed: J4.35, J8.35
VCC: J1.1, J2.1, J3.1, J4.1, J5.1, J6.1, J7.1, J8.1

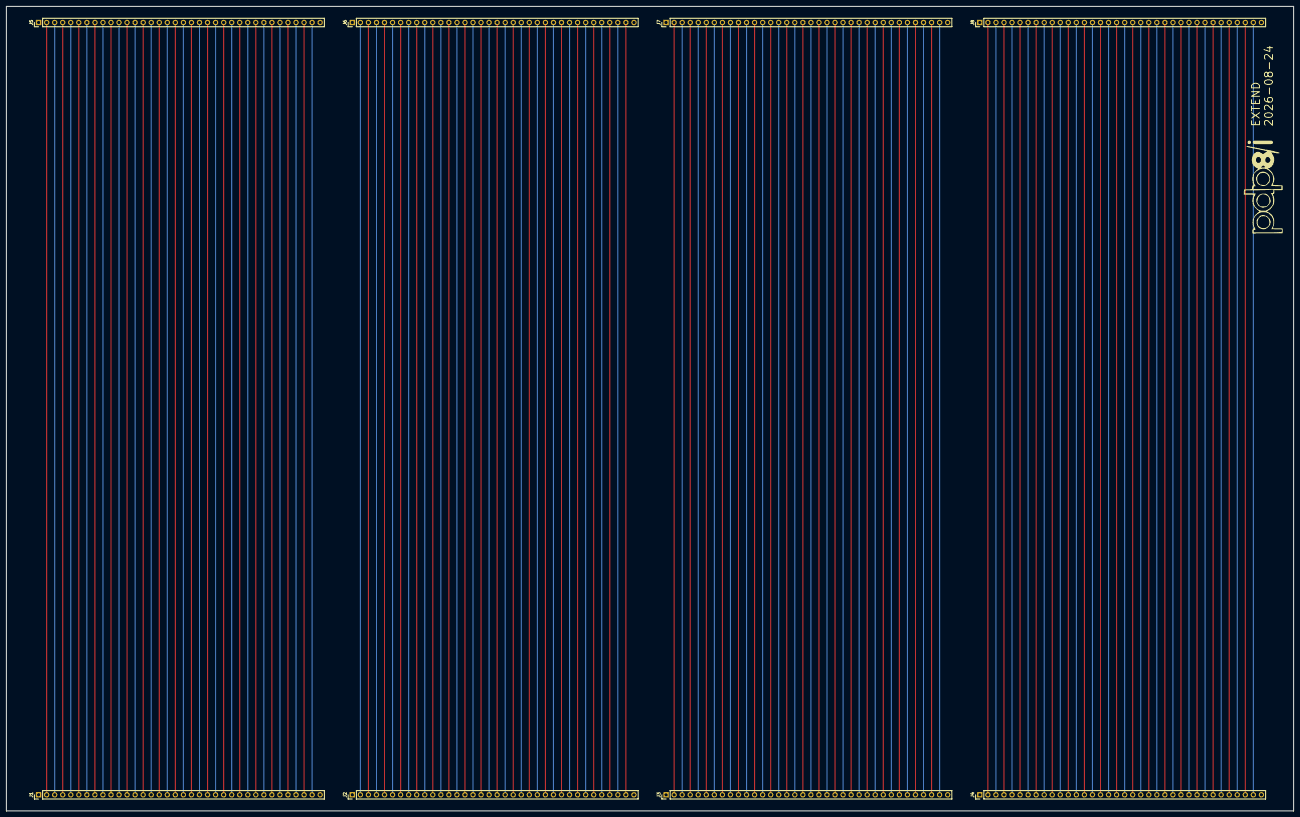
[picture p17: board extend.kicad_pcb from above]

Board: 4 copper layers, 406.4 x 254.0 mm, 8 parts (0 on the bottom side), 138 nets.
