mrieker/pdp8i/kicads/extmemory/extmemory.kicad_pcb

## KiCad design kicads/extmemory/extmemory.kicad_pcb (2026-08-24)

Schematic: extmemory.kicad_sch

Parts:
C11, C12, C13, C14, C15, C21, C22, C23, C24, C25, C26, C27, C31, C32, C33, C34, C35, C36, C37, C41, C42, C43, C44, C45, C46, C47, C51, C52, C53, C54, C55, C56, C57, C61, C62, C63, C64, C65, C66, C67, C71, C72, C73, C74, C75, C76, C77, C81, C82, C83, C84, C85, C86, C87: C; R_Axial_DIN0207_L6.3mm_D2.5mm_P7.62mm_Horizontal
E11, E14, E15, E21, E31, E41, E51, E53, E61, E64, E65, E71, E81: 74AHC540; DIP-20_W7.62mm
E12, E22: CY7C199; DIP-28_W7.62mm
E13, E32: 74AHC541; DIP-20_W7.62mm
E23: 74AC11; DIP-14_W7.62mm
E24, E27, E52, E56: 74AHC04; DIP-14_W7.62mm
E25: 74HC21; DIP-14_W7.62mm
E26, E33, E36, E46, E82: 74HC30; DIP-14_W7.62mm
E34, E45, E63: 74AHC00; DIP-14_W7.62mm
E35: 74HC27; DIP-14_W7.62mm
E37, E72: 74AHC74; DIP-14_W7.62mm
E42: 74HC75; DIP-16_W7.62mm
E43, E44, E54, E66, E75, E76, E77, E86, E87: 74AC153; DIP-16_W7.62mm
E47: 74HC42; DIP-16_W7.62mm
E55: 74AC109; DIP-16_W7.62mm
E57: 74AC20; DIP-14_W7.62mm
E62: 74AHC08; DIP-14_W7.62mm
E67: 74AHC174; DIP-16_W7.62mm
E73, E84, E85: 74HC175; DIP-16_W7.62mm
E74: 74AHC157; DIP-16_W7.62mm
E83: 74AC10; DIP-14_W7.62mm
J1, J2, J3, J4: Conn_01x36; PinHeader_1x36_P2.54mm_Vertical

Connections:
/CONSCK: J4.35
/CONSDA: J4.34
/_ACCLEAR: J3.28
/_ACUM_0: J3.7
/_ACUM_1: J2.34
/_ACUM_2: J2.27
/_ACUM_3: J2.20
/_ACUM_4: J2.13
/_ACUM_5: J2.7
/_ACUM_6: J1.35
/_ACUM_7: J1.29
/_ACUM_8: J1.23
/_ACUM_9: J1.16
/_ACUM_10: J1.9
/_ACUM_11: J1.2
/_BRKCYC: J4.33
/_BRKRQST: J3.29
/_BRKWRM: J4.11
/_BUSINI: E61.4 (A2), J3.31
/_BWCOV: J3.32
/_CAINC: J4.12
/_CLOCK: E61.6 (A4), J4.6
/_CYCLE3: J4.13
/_DFLD_0: E64.15 (Y3), E65.5 (A3), J3.22
/_DFLD_1: E64.14 (Y4), E65.6 (A4), J3.18
/_DFLD_2: E64.13 (Y5), E65.7 (A5), J3.14
/_DMAFLD_0: E51.9 (A7), J3.23
/_DMAFLD_1: E51.7 (A5), J3.19
/_DMAFLD_2: E51.5 (A3), J3.15
/_IFLD_0: E64.18 (Y0), E65.2 (A0), J3.24
/_IFLD_1: E64.17 (Y1), E65.3 (A1), J3.20
/_IFLD_2: E64.16 (Y2), E65.4 (A2), J3.16
/_INBUS_0: E41.18 (Y0), E53.18 (Y0), J3.10
/_INBUS_1: E41.17 (Y1), E53.17 (Y1), J3.3
/_INBUS_2: E41.13 (Y5), E53.16 (Y2), J2.30
/_INBUS_3: E41.14 (Y4), E53.15 (Y3), J2.23
/_INBUS_4: E41.15 (Y3), E53.14 (Y4), J2.16
/_INBUS_5: E41.16 (Y2), E53.13 (Y5), J2.10
/_INBUS_6: E14.18 (Y0), E15.18 (Y0), J2.4
/_INBUS_7: E14.17 (Y1), E15.17 (Y1), J1.32
/_INBUS_8: E14.16 (Y2), E15.16 (Y2), J1.26
/_INBUS_9: E14.15 (Y3), E15.15 (Y3), J1.19
/_INBUS_10: E14.14 (Y4), E15.14 (Y4), J1.12
/_INBUS_11: E14.13 (Y5), E15.13 (Y5), J1.5
/_INTINH: E61.12 (Y6), J4.15
/_INTRQST: J4.16
/_ION: J3.30
/_IOP: E71.2 (A0), J4.8
/_IOSKIP: J4.17
/_IREG_9: E21.2 (A0), J1.22
/_IREG_10: E11.7 (A5), J1.15
/_IREG_11: E11.4 (A2), J1.8
/_LINK: J4.9
/_LNKTOG: J4.18
/_MADR_0: E51.3 (A1), J3.8
/_MADR_1: E31.9 (A7), J2.35
/_MADR_2: E31.7 (A5), J2.28
/_MADR_3: E31.5 (A3), J2.21
/_MADR_4: E31.3 (A1), J2.14
/_MADR_5: E21.9 (A7), J2.8
/_MADR_6: E21.7 (A5), J2.2
/_MADR_7: E21.5 (A3), J1.30
/_MADR_8: E21.3 (A1), J1.24
/_MADR_9: E11.8 (A6), J1.17
/_MADR_10: E11.5 (A3), J1.10
/_MADR_11: E11.2 (A0), J1.3
/_MAJST_0: E61.9 (A7), J4.22
/_MAJST_1: E71.5 (A3), J4.21
/_MAJST_2: E71.4 (A2), J4.20
/_MAJST_3: E71.3 (A1), J4.19
/_MBUF_0: E51.4 (A2), J3.9
/_MBUF_1: E51.2 (A0), J3.2
/_MBUF_2: E31.8 (A6), J2.29
/_MBUF_3: E31.6 (A4), J2.22
/_MBUF_4: E31.4 (A2), J2.15
/_MBUF_5: E31.2 (A0), J2.9
/_MBUF_6: E21.8 (A6), J2.3
/_MBUF_7: E21.6 (A4), J1.31
/_MBUF_8: E21.4 (A2), J1.25
/_MBUF_9: E11.9 (A7), J1.18
/_MBUF_10: E11.6 (A4), J1.11
/_MBUF_11: E11.3 (A1), J1.4
/_MEAD_0: E61.18 (Y0), J3.25
/_MEAD_1: E51.12 (Y6), J3.21
/_MEAD_2: E51.14 (Y4), J3.17
/_MEMDIS: E61.3 (A1), J3.26
/_MQUO_0: J3.11
/_MQUO_1: J3.4
/_MQUO_2: J2.31
/_MQUO_3: J2.24
/_MQUO_4: J2.17
/_MQUO_5: J2.11
/_MQUO_6: J2.5
/_MQUO_7: J1.33
/_MQUO_8: J1.27
/_MQUO_9: J1.20
/_MQUO_10: J1.13
/_MQUO_11: J1.6
/_PAUSE: J4.14
/_PCTR_0: J3.12
/_PCTR_1: J3.5
/_PCTR_2: J2.32
/_PCTR_3: J2.25
/_PCTR_4: J2.18
/_PCTR_5: J2.12
/_PCTR_6: J2.6
/_PCTR_7: J1.34
/_PCTR_8: J1.28
/_PCTR_9: J1.21
/_PCTR_10: J1.14
/_PCTR_11: J1.7
/_READSR: J3.27
/_RESET: E61.7 (A5), J4.7
/_RUN: J4.10
/_SCTR_0: J3.13
/_SCTR_1: J3.6
/_SCTR_2: J2.33
/_SCTR_3: J2.26
/_SCTR_4: J2.19
/_SWCONT: J4.2
/_SWDEPOS: J3.35
/_SWEXAM: J3.34
/_SWLDAD: E61.5 (A3), E63.1, J3.33
/_SWSINST: J4.5
/_SWSSTEP: J4.4
/_SWSTART: J4.3
/_TP1: E71.9 (A7), J4.27
/_TP2: E81.2 (A0), J4.28
/_TP3: E81.3 (A1), J4.29
/_TP4: E81.4 (A2), J4.30
/_TS1: E71.6 (A4), J4.23
/_TS2: J4.24
/_TS3: E71.7 (A5), J4.25
/_TS4: E71.8 (A6), J4.26
/_businit: E52.10, E55.15 (~R), E67.1 (~Mr)
/_delaydldad: E63.5, E72.8 (~Q), E83.1, E83.9
/_flden: E63.3, E64.19 (G2)
/_ireg_10: E24.10, E36.5, E46.5
/_majst_1: E45.9, E56.4
/_majst_2: E36.11, E46.11, E56.12
/_majst_3: E36.6, E46.6, E56.2
/_mbuf_0: E23.11, E24.6
/_mbuf_1: E23.10, E24.8
/_mbuf_2: E24.12, E25.12, E26.11, E33.11
/_mbuf_6: E23.13, E24.4
/_mbuf_8: E23.1, E24.2, E45.13
/_memoe: E12.22 (~OE), E14.1 (G1), E22.22 (~OE), E41.1 (G1), E52.2
/_memwe: E12.27 (~WE), E22.27 (~WE), E37.6 (~Q)
/_msbreak: E47.7 (6), E56.11, E57.4
/_mscurad: E47.6 (5), E57.2
/_msexec: E35.11, E47.4 (3)
/_msintak: E47.9 (7), E56.9, E57.5
/_mswrdct: E47.5 (4), E57.1
/_prevdefer: E35.9, E37.9 (Q)
/_reset: E52.8, E62.13
/busini: E52.11, E61.16 (Y2)
/clock: E61.14 (Y4), E72.3 (C), E72.11 (C)
/ddfld_0: E76.7 (Za), E85.4 (D0)
/ddfld_1: E76.9 (Zb), E85.5 (D1)
/ddfld_2: E85.12 (D2), E87.7 (Za)
/dfld_0: E44.6 (I0a), E64.5 (A3), E66.11 (I1b), E67.11 (D3), E85.2 (Q0)
/dfld_1: E43.10 (I0b), E54.5 (I1a), E64.6 (A4), E67.13 (D4), E85.7 (Q1)
/dfld_2: E43.6 (I0a), E54.11 (I1b), E64.7 (A5), E67.14 (D5), E85.10 (Q2)
/dfldld: E83.12, E85.9 (Cp)
/dmafld_0: E44.4 (I2a), E51.11 (Y7)
/dmafld_1: E43.12 (I2b), E51.13 (Y5)
/dmafld_2: E43.4 (I2a), E51.15 (Y3)
/endofjmx: E36.12, E45.8, E46.12
/fldsel_0: E35.6, E43.14 (S0), E44.14 (S0)
/fldsel_1: E43.2 (S1), E44.2 (S1), E57.6
/ifld_0: E44.5 (I1a), E64.2 (A0), E66.12 (I2b), E67.3 (D0), E73.2 (Q0)
/ifld_1: E43.11 (I1b), E54.4 (I2a), E64.3 (A1), E67.4 (D1), E73.7 (Q1)
/ifld_2: E43.5 (I1a), E54.12 (I2b), E64.4 (A2), E67.6 (D2), E73.10 (Q2)
/ifldaj_0: E74.11 (I0c), E84.2 (Q0)
/ifldaj_1: E74.5 (I0b), E84.7 (Q1)
/ifldaj_2: E74.2 (I0a), E84.10 (Q2)
/ifldld: E63.6, E73.9 (Cp)
/iifld_0: E73.4 (D0), E74.9 (Zc)
/iifld_1: E73.5 (D1), E74.7 (Zb)
/iifld_2: E73.12 (D2), E74.4 (Za)
/iifldaj_0: E75.7 (Za), E84.4 (D0)
/iifldaj_1: E75.9 (Zb), E84.5 (D1)
/iifldaj_2: E84.12 (D2), E86.7 (Za)
/intinh: E55.10 (Q), E61.8 (A6)
/iop: E25.9, E26.6, E33.5, E34.2, E34.4, E34.12, E71.18 (Y0), E82.5, E83.3
/ireg_9: E21.18 (Y0)
/ireg_10: E11.13 (Y5), E24.11
/ireg_11: E11.16 (Y2), E35.10, E36.4, E46.4
/madr_0: E12.26 (A4), E22.21 (A0), E51.17 (Y1)
/madr_1: E12.25 (A3), E22.23 (A1), E31.11 (Y7)
/madr_2: E12.24 (A2), E22.24 (A2), E31.13 (Y5)
/madr_3: E12.23 (A1), E22.25 (A3), E31.15 (Y3)
/madr_4: E12.21 (A0), E22.26 (A4), E31.17 (Y1)
/madr_5: E12.4 (A8), E21.11 (Y7), E22.7 (A11)
/madr_6: E12.5 (A9), E21.13 (Y5), E22.6 (A10)
/madr_7: E12.6 (A10), E21.15 (Y3), E22.5 (A9)
/madr_8: E12.7 (A11), E21.17 (Y1), E22.4 (A8)
/madr_9: E11.12 (Y6), E12.3 (A7), E22.8 (A12)
/madr_10: E11.15 (Y3), E12.2 (A6), E22.9 (A13)
/madr_11: E11.18 (Y0), E12.1 (A5), E22.10 (A14)
/majst_0: E45.12, E47.15 (A0), E61.11 (Y7)
/majst_1: E47.14 (A1), E56.3, E71.15 (Y3)
/majst_2: E47.13 (A2), E56.13, E71.16 (Y2)
/majst_3: E47.12 (A3), E56.1, E71.17 (Y1)
/mb20four: E23.8, E82.12, E83.5
/mb86two: E23.12, E25.10, E26.5, E33.6, E82.6, E83.4
/mbio_0: E22.11 (D0), E32.18 (Y0), E41.2 (A0)
/mbio_1: E22.12 (D1), E32.17 (Y1), E41.3 (A1)
/mbio_2: E22.13 (D2), E32.13 (Y5), E41.7 (A5)
/mbio_3: E22.19 (D7), E32.14 (Y4), E41.6 (A4)
/mbio_4: E22.18 (D6), E32.15 (Y3), E41.5 (A3)
/mbio_5: E22.17 (D5), E32.16 (Y2), E41.4 (A2)
/mbio_6: E12.11 (D0), E13.18 (Y0), E14.2 (A0)
/mbio_7: E12.12 (D1), E13.17 (Y1), E14.3 (A1)
/mbio_8: E12.13 (D2), E13.16 (Y2), E14.4 (A2)
/mbio_9: E12.19 (D7), E13.15 (Y3), E14.5 (A3)
/mbio_10: E12.18 (D6), E13.14 (Y4), E14.6 (A4)
/mbio_11: E12.17 (D5), E13.13 (Y5), E14.7 (A5)
/mbuf_0: E24.5, E32.2 (A0), E33.12, E34.5, E51.16 (Y2)
/mbuf_1: E24.9, E25.13, E26.12, E32.3 (A1), E34.13, E51.18 (Y0)
/mbuf_2: E23.9, E24.13, E31.12 (Y6), E32.7 (A5), E34.1
/mbuf_3: E31.14 (Y4), E32.6 (A4), E54.14 (S0), E66.14 (S0), E75.5 (I1a), E76.5 (I1a), E77.14 (S0)
/mbuf_4: E31.16 (Y2), E32.5 (A3), E54.2 (S1), E66.2 (S1), E75.11 (I1b), E76.11 (I1b), E77.2 (S1)
/mbuf_5: E31.18 (Y0), E32.4 (A2), E82.11, E86.5 (I1a), E87.5 (I1a)
/mbuf_6: E13.2 (A0), E21.12 (Y6), E24.3
/mbuf_7: E13.3 (A1), E21.14 (Y4), E23.2
/mbuf_8: E13.4 (A2), E21.16 (Y2), E24.1
/mbuf_9: E11.11 (Y7), E13.5 (A3)
/mbuf_10: E11.14 (Y4), E13.6 (A4)
/mbuf_11: E11.17 (Y1), E13.7 (A5)
/mead_0: E12.8 (A12), E22.3 (A7), E42.10 (Q2), E61.2 (A0)
/mead_1: E12.9 (A13), E22.2 (A6), E42.15 (Q1), E51.8 (A6)
/mead_2: E12.10 (A14), E22.1 (A5), E42.16 (Q0), E51.6 (A4)
/memdis: E12.20 (~CE), E14.19 (G2), E22.20 (~CE), E41.19 (G2), E61.17 (Y1)
/msintak: E56.8, E62.10, E63.13
/reset: E35.1, E52.9, E61.13 (Y5)
/saveddfld_0: E67.10 (Q3), E76.4 (I2a), E77.3 (I3a)
/saveddfld_1: E67.12 (Q4), E76.12 (I2b), E77.13 (I3b)
/saveddfld_2: E66.3 (I3a), E67.15 (Q5), E87.4 (I2a)
/savedifld_0: E66.13 (I3b), E67.2 (Q0), E75.4 (I2a)
/savedifld_1: E54.3 (I3a), E67.5 (Q1), E75.12 (I2b)
/savedifld_2: E54.13 (I3b), E67.7 (Q2), E86.4 (I2a)
/swdfld_0: E65.15 (Y3), E76.3 (I3a)
/swdfld_1: E65.14 (Y4), E76.13 (I3b)
/swdfld_2: E65.13 (Y5), E87.3 (I3a)
/swifld_0: E65.18 (Y0), E74.10 (I1c), E75.3 (I3a)
/swifld_1: E65.17 (Y1), E74.6 (I1b), E75.13 (I3b)
/swifld_2: E65.16 (Y2), E74.3 (I1a), E86.3 (I3a)
/swldad: E52.3, E52.5, E61.15 (Y3), E72.1 (~R), E72.13 (~R), E74.1 (S)
/tp1: E62.9, E71.11 (Y7)
/tp2: E55.12 (C), E63.12, E81.18 (Y0)
/tp3: E26.4, E33.4, E35.2, E36.3, E81.17 (Y1), E82.4
/tp4: E37.11 (C), E81.16 (Y2)
/ts1: E42.4 (E23), E42.13 (E01), E52.1, E71.14 (Y4)
/ts3: E27.5, E37.3 (C), E71.13 (Y5)
/ts4: E71.12 (Y6)
GND: C11.2, C12.2, C13.2, C14.2, C15.2, C21.2, C22.2, C23.2, C24.2, C25.2, C26.2, C27.2, C31.2, C32.2, C33.2, C34.2, C35.2, C36.2, C37.2, C41.2, C42.2, C43.2, C44.2, C45.2, C46.2, C47.2, C51.2, C52.2, C53.2, C54.2, C55.2, C56.2, C57.2, C61.2, C62.2, C63.2, C64.2, C65.2, C66.2, C67.2, C71.2, C72.2, C73.2, C74.2, C75.2, C76.2, C77.2, C81.2, C82.2, C83.2, C84.2, C85.2, C86.2, C87.2, E11.1 (G1), E11.10 (GND), E11.19 (G2), E12.14 (GND), E13.1 (G1), E13.8 (A6), E13.9 (A7), E13.10 (GND), E14.8 (A6), E14.9 (A7), E14.10 (GND), E15.2 (A0), E15.3 (A1), E15.4 (A2), E15.5 (A3), E15.6 (A4), E15.7 (A5), E15.8 (A6), E15.9 (A7), E15.10 (GND), E15.19 (G2), E21.1 (G1), E21.10 (GND), E21.19 (G2), E22.14 (GND), E23.3, E23.4, E23.5, E23.7 (GND), E24.7 (GND), E25.1, E25.2, E25.4, E25.5, E25.7 (GND), E26.7 (GND), E27.1, E27.3, E27.7 (GND), E27.9, E27.11, E27.13, E31.1 (G1), E31.10 (GND), E31.19 (G2), E32.1 (G1), E32.8 (A6), E32.9 (A7), E32.10 (GND), E33.7 (GND), E34.7 (GND), E35.7 (GND), E35.13, E36.7 (GND), E37.7 (GND), E41.8 (A6), E41.9 (A7), E41.10 (GND), E42.7 (D3), E42.12 (GND), E43.1 (Ea), E43.3 (I3a), E43.8 (GND), E43.13 (I3b), E43.15 (Eb), E44.1 (Ea), E44.3 (I3a), E44.8 (GND), E44.10 (I0b), E44.11 (I1b), E44.12 (I2b), E44.13 (I3b), E44.15 (Eb), E45.7 (GND), E46.7 (GND), E47.8 (GND), E51.1 (G1), E51.10 (GND), E51.19 (G2), E52.7 (GND), E52.13, E53.1 (G1), E53.8 (A6), E53.9 (A7), E53.10 (GND), E54.1 (Ea), E54.6 (I0a), E54.8 (GND), E54.10 (I0b), E54.15 (Eb), E55.1 (~R), E55.2 (J), E55.3 (~K), E55.4 (C), E55.5 (~S), E55.8 (GND), E56.5, E56.7 (GND), E57.7 (GND), E57.9, E57.10, E57.12, E57.13, E61.1 (G1), E61.10 (GND), E61.19 (G2), E62.1, E62.2, E62.4, E62.5, E62.7 (GND), E63.7 (GND), E63.9, E63.10, E64.1 (G1), E64.8 (A6), E64.9 (A7), E64.10 (GND), E65.1 (G1), E65.8 (A6), E65.9 (A7), E65.10 (GND), E65.19 (G2), E66.1 (Ea), E66.4 (I2a), E66.5 (I1a), E66.6 (I0a), E66.8 (GND), E66.10 (I0b), E66.15 (Eb), E67.8 (GND), E71.1 (G1), E71.10 (GND), E71.19 (G2), E72.7 (GND), E73.8 (GND), E73.13 (D3), E74.8 (GND), E74.13 (I1d), E74.14 (I0d), E74.15 (E), E75.1 (Ea), E75.6 (I0a), E75.8 (GND), E75.10 (I0b), E75.15 (Eb), E76.1 (Ea), E76.6 (I0a), E76.8 (GND), E76.10 (I0b), E76.15 (Eb), E77.1 (Ea), E77.4 (I2a), E77.5 (I1a), E77.6 (I0a), E77.8 (GND), E77.10 (I0b), E77.11 (I1b), E77.12 (I2b), E77.15 (Eb), E81.1 (G1), E81.5 (A3), E81.6 (A4), E81.7 (A5), E81.8 (A6), E81.9 (A7), E81.10 (GND), E81.19 (G2), E82.7 (GND), E83.7 (GND), E84.8 (GND), E84.13 (D3), E85.8 (GND), E85.13 (D3), E86.1 (Ea), E86.6 (I0a), E86.8 (GND), E86.10 (I0b), E86.11 (I1b), E86.12 (I2b), E86.13 (I3b), E86.15 (Eb), E87.1 (Ea), E87.6 (I0a), E87.8 (GND), E87.10 (I0b), E87.11 (I1b), E87.12 (I2b), E87.13 (I3b), E87.15 (Eb), J1.36, J2.36, J3.36, J4.36
unnamed: E37.12 (D), E47.3 (2)
unnamed: E35.3, E35.8
unnamed: E42.2 (D0), E43.7 (Za)
unnamed: E42.3 (D1), E43.9 (Zb)
unnamed: E42.6 (D2), E44.7 (Za)
unnamed: E53.2 (A0), E77.7 (Za)
unnamed: E53.3 (A1), E77.9 (Zb)
unnamed: E53.4 (A2), E66.7 (Za)
unnamed: E53.5 (A3), E66.9 (Zb)
unnamed: E53.6 (A4), E54.7 (Za)
unnamed: E53.7 (A5), E54.9 (Zb)
unnamed: E15.1 (G1), E53.19 (G2), E83.6
unnamed: E72.5 (Q), E72.12 (D)
unnamed: E34.8, E75.14 (S0), E86.14 (S0)
unnamed: E45.3, E75.2 (S1), E76.2 (S1), E86.2 (S1), E87.2 (S1)
unnamed: E45.6, E76.14 (S0), E87.14 (S0)
unnamed: E26.8, E83.11
unnamed: E34.9, E45.2, E45.4, E52.4
unnamed: E52.6, E63.2
unnamed: E62.8, E67.9 (Cp)
unnamed: E62.11, E73.1 (~Mr), E84.1 (~Mr), E85.1 (~Mr)
unnamed: E35.4, E35.5, E56.10
unnamed: E34.3, E45.1
unnamed: E34.6, E45.5
unnamed: E45.10, E45.11
unnamed: E33.8, E83.2
unnamed: E82.8, E83.10, E83.13
unnamed: E36.8, E63.4
unnamed: E62.12, E63.11
unnamed: E34.10, E34.11
unnamed: E35.12, E37.1 (~R)
unnamed: E25.8, E55.14 (J)
unnamed: E46.8, E55.13 (~K)
unnamed: E13.19 (G2), E27.6, E32.19 (G2)
unnamed: E83.8, E84.9 (Cp)
VCC: C11.1, C12.1, C13.1, C14.1, C15.1, C21.1, C22.1, C23.1, C24.1, C25.1, C26.1, C27.1, C31.1, C32.1, C33.1, C34.1, C35.1, C36.1, C37.1, C41.1, C42.1, C43.1, C44.1, C45.1, C46.1, C47.1, C51.1, C52.1, C53.1, C54.1, C55.1, C56.1, C57.1, C61.1, C62.1, C63.1, C64.1, C65.1, C66.1, C67.1, C71.1, C72.1, C73.1, C74.1, C75.1, C76.1, C77.1, C81.1, C82.1, C83.1, C84.1, C85.1, C86.1, C87.1, E11.20 (VCC), E12.28 (VCC), E13.20 (VCC), E14.20 (VCC), E15.20 (VCC), E21.20 (VCC), E22.28 (VCC), E23.14 (VCC), E24.14 (VCC), E25.14 (VCC), E26.1, E26.2, E26.3, E26.14 (VCC), E27.14 (VCC), E31.20 (VCC), E32.20 (VCC), E33.1, E33.2, E33.3, E33.14 (VCC), E34.14 (VCC), E35.14 (VCC), E36.1, E36.2, E36.14 (VCC), E37.2 (D), E37.4 (~S), E37.10 (~S), E37.13 (~R), E37.14 (VCC), E41.20 (VCC), E42.5 (VCC), E43.16 (VCC), E44.16 (VCC), E45.14 (VCC), E46.1, E46.2, E46.3, E46.14 (VCC), E47.16 (VCC), E51.20 (VCC), E52.14 (VCC), E53.20 (VCC), E54.16 (VCC), E55.11 (~S), E55.16 (VCC), E56.14 (VCC), E57.14 (VCC), E61.20 (VCC), E62.14 (VCC), E63.14 (VCC), E64.20 (VCC), E65.20 (VCC), E66.16 (VCC), E67.16 (VCC), E71.20 (VCC), E72.2 (D), E72.4 (~S), E72.10 (~S), E72.14 (VCC), E73.16 (VCC), E74.16 (VCC), E75.16 (VCC), E76.16 (VCC), E77.16 (VCC), E81.20 (VCC), E82.1, E82.2, E82.3, E82.14 (VCC), E83.14 (VCC), E84.16 (VCC), E85.16 (VCC), E86.16 (VCC), E87.16 (VCC), J1.1, J2.1, J3.1, J4.1

Notes on the sheet:
msintak | mswrdct | mscurad | msbreak
console puts IF/DF switches on IFLD/DFLD busses when LDAD pressed extmemory puts IF/DF registers on IFLD/DFLD busses when LDAD released
IFLD after JMP/JMS - FETCH is in old field - DEFER is in old field - EXEC (JMS only) is in new field
62x2 opcode - load 'x'
IOP 62x2 - MBUF[5:3]
LDAD switch - SWREG[17:15]
6244 opcode - load dfld from saveddfld ifldaj from savedifld
0: zero 1: MBUF[5:3] 2: savedifld 3: SWIFLD
IOP 6244 - saveddfld
clear fields during INTAK cycle - they were saved at TP1
LDAD - dfld sw
IOP 62x1 - MBUF[5:3]
MBUF=x2xx
~ (msexec & _ir_11 & prevdefer | msbreak)
FLDSEL USE 0 data field - EXEC & AND/TAD/ISZ/DCA & prev DEFER 1 inst field - everything else 2 break field - BREAK 3 zero field - INTAK | WRDCT | CURAD
save ifld and dfld when doing an interrupt acknowledge ifld and dlfd get zeroed at TP2
MBUF=xxx4
transfer IFLDAJ to IFLD FETCH of JMS/JMP opcode is old IFLD DEFER of JMS/JMS is with old IFLD EXEC of JMS is with new IFLD - during TP3 memory writeback is complete using old IFLD current major state is stable - must be doing JMS or JMP - FETCH with direct addressing or DEFER
quickly stop sending if/df registers when ldad pressed delay sending registers when ldad released ...so we don't jam with if/df switches sent by console
62x1 opcode - load 'x'
Fetch JMP/JMS clears it TP2 so it is cleared in time for TP3 interrupt sensing
62x2 opcode - inhibit ints until JMP/JMS
0: zero 1: MBUF[5:3] 2: saveddfld 3: SWDFLD

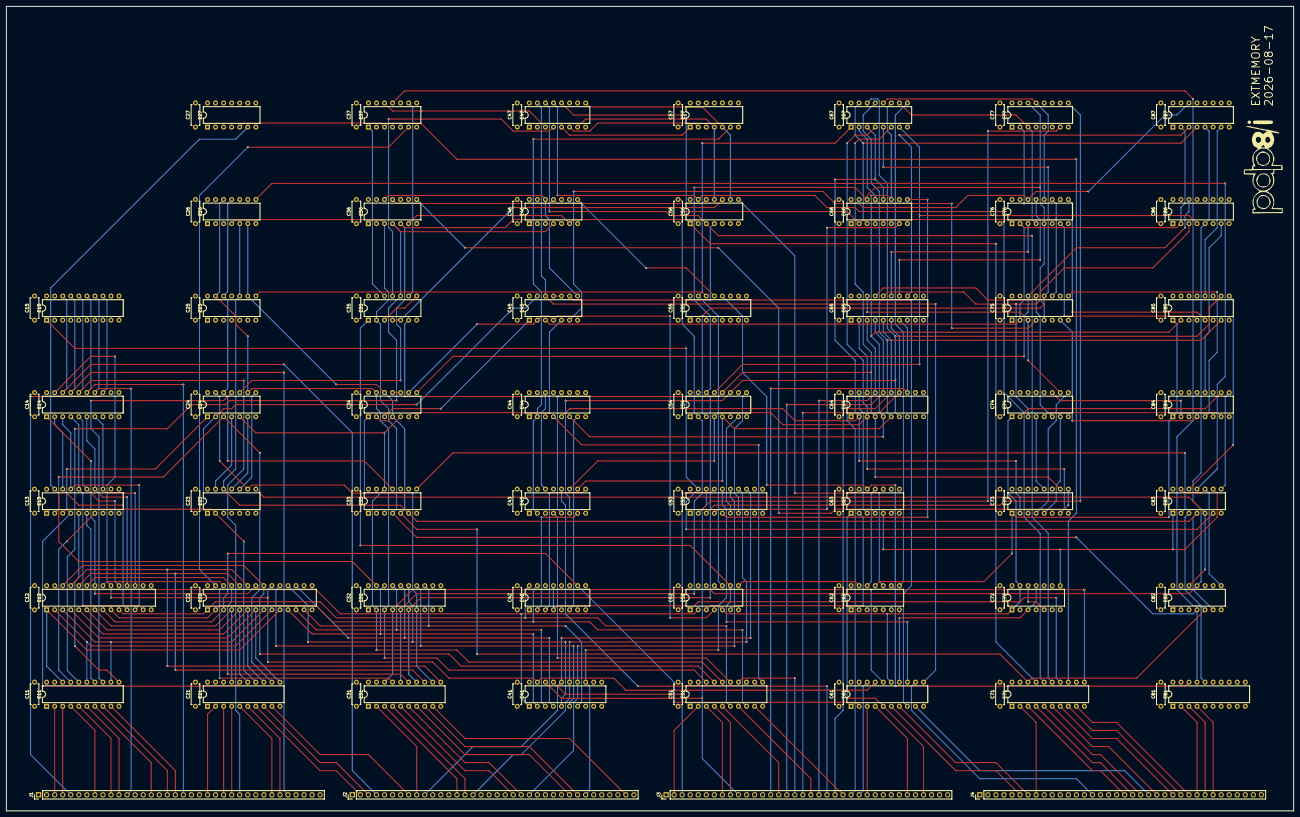
[picture p18: board extmemory.kicad_pcb from above]

Board: 4 copper layers, 406.4 x 254.0 mm, 112 parts (0 on the bottom side), 226 nets.
