mrieker/pdp8i/kicads/procreg/procreg.kicad_pcb

## KiCad design kicads/procreg/procreg.kicad_pcb (2026-08-19)

Schematic: procreg.kicad_sch

Parts:
C11, C12, C13, C14, C15, C16, C17, C18, C21, C22, C23, C24, C25, C26, C27, C28, C31, C32, C33, C34, C35, C36, C37, C38, C41, C42, C43, C44, C45, C46, C47, C48, C51, C52, C53, C54, C55, C56, C57, C58, C61, C62, C63, C64, C65, C66, C67, C68, C71, C72, C73, C74, C75, C76, C77, C78, C81, C82, C83, C84, C85, C86, C87, C88, C91, C92, C93, C94, C95, C96, C101: C; R_Axial_DIN0207_L6.3mm_D2.5mm_P7.62mm_Horizontal
E11, E21, E31, E41, E51, E61, E71, E81, E91, E101: 74AHC540; DIP-20_W7.62mm
E12, E13, E24, E34, E45, E52: 74AHC174; DIP-16_W7.62mm
E14, E15, E16, E17, E18, E25, E26, E27, E28, E35, E36, E37, E38: 74AC151; DIP-16_W7.62mm
E22, E42, E53: 74AC161; DIP-16_W7.62mm
E23, E33, E78: 74HC27; DIP-14_W7.62mm
E32: 74HC175; DIP-16_W7.62mm
E43, E67, E96: 74HC30; DIP-14_W7.62mm
E44: 74HC21; DIP-14_W7.62mm
E46: 74AHC138; DIP-16_W7.62mm
E47, E83, E87, E95: 74AHC04; DIP-14_W7.62mm
E48, E74, E76: 74AC10; DIP-14_W7.62mm
E54, E73: 74AHC08; DIP-14_W7.62mm
E55, E57, E58, E63, E75, E77, E84, E85, E92, E93: 74AHC00; DIP-14_W7.62mm
E56: 74AHC02; DIP-14_W7.62mm
E62, E66, E86: 74AC20; DIP-14_W7.62mm
E64: 74AHC86; DIP-14_W7.62mm
E65: 74AC11; DIP-14_W7.62mm
E68: 74AHC04
E72: 74AHC74
E82: 74AHC74; DIP-14_W7.62mm
E88: 74AHC32; DIP-14_W7.62mm
E94: 74HC42; DIP-16_W7.62mm
J1, J2, J3, J4: Conn_01x36; PinHeader_1x36_P2.54mm_Vertical

Connections:
/CONSCK: J4.35
/CONSDA: J4.34
/_ACCLEAR: J3.28
/_ACUM_0: E71.16 (Y2), J3.7
/_ACUM_1: E61.12 (Y6), J2.34
/_ACUM_2: E61.16 (Y2), J2.27
/_ACUM_3: E51.12 (Y6), J2.20
/_ACUM_4: E51.16 (Y2), J2.13
/_ACUM_5: E41.12 (Y6), J2.7
/_ACUM_6: E41.16 (Y2), J1.35
/_ACUM_7: E31.12 (Y6), J1.29
/_ACUM_8: E31.16 (Y2), J1.23
/_ACUM_9: E21.14 (Y4), J1.16
/_ACUM_10: E11.12 (Y6), J1.9
/_ACUM_11: E11.18 (Y0), J1.2
/_BRKCYC: E101.11 (Y7), J4.33
/_BRKRQST: J3.29
/_BRKWRM: E81.9 (A7), J4.11
/_BUSINI: E71.8 (A6), J3.31
/_BWCOV: E71.11 (Y7), J3.32
/_CAINC: E91.2 (A0), J4.12
/_CLOCK: J4.6
/_CYCLE3: J4.13
/_DFLD_0: J3.22
/_DFLD_1: J3.18
/_DFLD_2: J3.14
/_DMAFLD_0: J3.23
/_DMAFLD_2: J3.15
/_IFLD_0: J3.24
/_IFLD_1: J3.20
/_IFLD_2: J3.16
/_INBUS_0: J3.10
/_INBUS_1: J3.3
/_INBUS_2: J2.30
/_INBUS_3: J2.23
/_INBUS_4: J2.16
/_INBUS_5: J2.10
/_INBUS_6: J2.4
/_INBUS_7: J1.32
/_INBUS_8: J1.26
/_INBUS_9: E21.9 (A7), J1.19
/_INBUS_10: E21.3 (A1), J1.12
/_INBUS_11: E11.5 (A3), J1.5
/_INTINH: J4.15
/_INTRQST: J4.16
/_ION: J3.30
/_IOP: E81.6 (A4), J4.8
/_IOSKIP: E91.3 (A1), J4.17
/_IREG_9: E31.17 (Y1), J1.22
/_IREG_10: E21.15 (Y3), J1.15
/_IREG_11: E11.13 (Y5), J1.8
/_LINK: E81.13 (Y5), J4.9
/_LNKTOG: E91.4 (A2), J4.18
/_MADR_0: E71.15 (Y3), J3.8
/_MADR_1: E61.11 (Y7), J2.35
/_MADR_2: E61.15 (Y3), J2.28
/_MADR_3: E51.11 (Y7), J2.21
/_MADR_4: E51.15 (Y3), J2.14
/_MADR_5: E41.11 (Y7), J2.8
/_MADR_6: E41.15 (Y3), J2.2
/_MADR_7: E31.11 (Y7), J1.30
/_MADR_8: E31.15 (Y3), J1.24
/_MADR_9: E21.13 (Y5), J1.17
/_MADR_10: E11.11 (Y7), J1.10
/_MADR_11: E11.17 (Y1), J1.3
/_MAJST_0: E91.8 (A6), J4.22
/_MAJST_1: E91.7 (A5), J4.21
/_MAJST_2: E91.6 (A4), J4.20
/_MAJST_3: E91.5 (A3), J4.19
/_MBUF_0: E71.14 (Y4), J3.9
/_MBUF_1: E71.18 (Y0), J3.2
/_MBUF_2: E61.14 (Y4), J2.29
/_MBUF_3: E61.18 (Y0), J2.22
/_MBUF_4: E51.14 (Y4), J2.15
/_MBUF_5: E51.18 (Y0), J2.9
/_MBUF_6: E41.14 (Y4), J2.3
/_MBUF_7: E41.18 (Y0), J1.31
/_MBUF_8: E31.14 (Y4), J1.25
/_MBUF_9: E21.12 (Y6), J1.18
/_MBUF_10: E21.18 (Y0), J1.11
/_MBUF_11: E11.16 (Y2), J1.4
/_MEAD_0: J3.25
/_MEAD_1: J3.21
/_MEAD_2: J3.17
/_MEMDIS: J3.26
/_PAUSE: J4.14
/_PCTR_0: E71.13 (Y5), J3.12
/_PCTR_1: E71.17 (Y1), J3.5
/_PCTR_2: E61.13 (Y5), J2.32
/_PCTR_3: E61.17 (Y1), J2.25
/_PCTR_4: E51.13 (Y5), J2.18
/_PCTR_5: E51.17 (Y1), J2.12
/_PCTR_6: E41.13 (Y5), J2.6
/_PCTR_7: E41.17 (Y1), J1.34
/_PCTR_8: E31.13 (Y5), J1.28
/_PCTR_9: E31.18 (Y0), J1.21
/_PCTR_10: E21.16 (Y2), J1.14
/_PCTR_11: E11.14 (Y4), J1.7
/_READSR: J3.27
/_RESET: J4.7
/_RUN: E81.8 (A6), J4.10
/_SCTR_0: J3.13
/_SCTR_1: J3.6
/_SCTR_2: J2.33
/_SCTR_3: J2.26
/_SWCONT: E81.5 (A3), J4.2
/_SWDEPOS: E81.4 (A2), J3.35
/_SWEXAM: E81.3 (A1), J3.34
/_SWLDAD: E81.2 (A0), J3.33
/_SWSINST: J4.5
/_SWSSTEP: J4.4
/_SWSTART: J4.3
/_TP1: E101.5 (A3), J4.27
/_TP2: E101.6 (A4), J4.28
/_TP3: E101.7 (A5), J4.29
/_TP4: E101.8 (A6), J4.30
/_TS1: E91.9 (A7), J4.23
/_TS2: E101.2 (A0), J4.24
/_TS3: E101.3 (A1), J4.25
/_TS4: E101.4 (A2), J4.26
/_busini: E54.5, E73.2, E82.13 (~R), E83.4
/_extarex: E76.5, E85.9, E86.2, E95.12
/_irand: E46.15 (~Y0), E48.10
/_irdca: E46.12 (~Y3), E48.11, E48.13
/_iriot: E46.9 (~Y6)
/_irisz: E46.13 (~Y2), E47.13, E48.1
/_irjmp: E46.10 (~Y5), E56.12, E68.11
/_irjms: E46.11 (~Y4), E47.3, E48.2
/_iropr: E46.7 (~Y7), E56.8, E68.5, E78.1
/_irtad: E46.14 (~Y1), E47.11, E48.9
/_ldadclk: E63.3, E63.4, E74.3
/_msdefer: E87.3, E94.3 (2)
/_msdepos: E94.10 (8), E95.11, E96.4
/_msexec: E84.10, E87.1, E94.4 (3)
/_msintak: E47.9, E66.4, E94.9 (7), E96.2
/_mswrdct: E84.9, E94.5 (4), E96.3
/_pcld: E22.9 (~PE), E42.9 (~PE), E53.9 (~PE), E54.3
/_rsel_0: E14.11 (S0), E15.11 (S0), E16.11 (S0), E17.11 (S0), E18.11 (S0), E25.11 (S0), E26.11 (S0), E27.11 (S0), E28.11 (S0), E35.11 (S0), E36.11 (S0), E37.11 (S0), E38.11 (S0), E55.3
/_rsel_1: E14.10 (S1), E15.10 (S1), E16.10 (S1), E17.10 (S1), E18.10 (S1), E25.10 (S1), E26.10 (S1), E27.10 (S1), E28.10 (S1), E35.10 (S1), E36.10 (S1), E37.10 (S1), E38.10 (S1), E55.8
/_rsel_2: E14.9 (S2), E15.9 (S2), E16.9 (S2), E17.9 (S2), E18.9 (S2), E25.9 (S2), E26.9 (S2), E27.9 (S2), E28.9 (S2), E35.9 (S2), E36.9 (S2), E37.9 (S2), E38.9 (S2), E55.11
/_skiplnk: E63.8, E74.2
/_skipneg: E63.11, E74.1
/_skipzer: E43.8, E74.13
/acclk: E24.9 (Cp), E34.9 (Cp), E73.11
/acum_0: E33.11, E34.2 (Q0), E71.4 (A2)
/acum_1: E33.10, E34.5 (Q1), E61.8 (A6)
/acum_2: E33.9, E34.7 (Q2), E61.4 (A2)
/acum_3: E33.5, E34.10 (Q3), E51.8 (A6)
/acum_4: E33.4, E34.12 (Q4), E51.4 (A2)
/acum_5: E33.3, E34.15 (Q5), E41.8 (A6)
/acum_6: E24.2 (Q0), E33.13, E41.4 (A2)
/acum_7: E24.5 (Q1), E31.8 (A6), E33.2
/acum_8: E24.7 (Q2), E31.4 (A2), E33.1
/acum_9: E21.6 (A4), E23.9, E24.10 (Q3)
/acum_10: E11.8 (A6), E23.11, E24.12 (Q4)
/acum_11: E11.2 (A0), E23.10, E24.15 (Q5), E63.13
/aluq_0: E16.13 (I6), E18.15 (I4), E26.14 (I5), E27.2 (I2), E36.12 (I7), E37.1 (I3), E45.3 (D0), E52.3 (D0), E53.3 (D0), J3.11
/aluq_1: E15.13 (I6), E17.15 (I4), E18.14 (I5), E26.12 (I7), E36.1 (I3), E37.2 (I2), E45.4 (D1), E52.4 (D1), E53.4 (D1), J3.4
/aluq_2: E14.13 (I6), E17.14 (I5), E18.12 (I7), E26.1 (I3), E35.15 (I4), E36.2 (I2), E45.6 (D2), E52.6 (D2), E53.5 (D2), J2.31
/aluq_3: E17.12 (I7), E18.1 (I3), E25.15 (I4), E26.2 (I2), E35.14 (I5), E38.13 (I6), E45.11 (D3), E52.11 (D3), E53.6 (D3), J2.24
/aluq_4: E16.15 (I4), E17.1 (I3), E18.2 (I2), E25.14 (I5), E28.13 (I6), E35.12 (I7), E42.3 (D0), E45.13 (D4), E52.13 (D4), J2.17
/aluq_5: E15.15 (I4), E16.14 (I5), E17.2 (I2), E25.12 (I7), E27.13 (I6), E35.1 (I3), E42.4 (D1), E45.14 (D5), E52.14 (D5), J2.11
/aluq_6: E12.3 (D0), E13.3 (D0), E14.15 (I4), E15.14 (I5), E16.12 (I7), E25.1 (I3), E35.2 (I2), E36.13 (I6), E42.5 (D2), J2.5
/aluq_7: E12.4 (D1), E13.4 (D1), E14.14 (I5), E15.12 (I7), E16.1 (I3), E25.2 (I2), E26.13 (I6), E38.15 (I4), E42.6 (D3), J1.33
/aluq_8: E12.6 (D2), E13.6 (D2), E14.12 (I7), E15.1 (I3), E16.2 (I2), E18.13 (I6), E22.3 (D0), E28.15 (I4), E38.14 (I5), J1.27
/aluq_9: E12.11 (D3), E13.11 (D3), E14.1 (I3), E15.2 (I2), E17.13 (I6), E22.4 (D1), E27.15 (I4), E28.14 (I5), E38.12 (I7), J1.20
/aluq_10: E12.13 (D4), E13.13 (D4), E14.2 (I2), E22.5 (D2), E27.14 (I5), E28.12 (I7), E35.13 (I6), E37.15 (I4), E38.1 (I3), J1.13
/aluq_11: E12.14 (D5), E13.14 (D5), E22.6 (D3), E25.13 (I6), E27.12 (I7), E28.1 (I3), E36.15 (I4), E37.14 (I5), E38.2 (I2), J1.6
/aluq_12: E26.15 (I4), E27.1 (I3), E28.2 (I2), E36.14 (I5), E37.12 (I7), E37.13 (I6), E64.3
/autoinc: E44.6, E77.10
/brkcyc: E82.9 (Q), E101.9 (A7)
/brkwrm: E81.11 (Y7), E92.1
/busini: E71.12 (Y6), E83.3
/bwcov: E48.4, E71.9 (A7), E72.5 (Q)
/cainc: E91.18 (Y0), E93.9
/comln: E64.4, E65.6
/cout: E64.1, E72.2 (D), J3.19
/dirjmp: E56.13, E57.4
/extarex: E77.6, E93.13, E95.13
/g2skip: E64.8, E76.1
/group1: E56.10, E62.4, E62.10, E65.4, E65.13, E75.12, E88.2
/group2: E76.13, E78.12, E88.1
/inbus_9: E21.11 (Y7), E32.5 (D1)
/inbus_10: E21.17 (Y1), E32.12 (D2)
/inbus_11: E11.15 (Y3), E47.1
/iop: E75.9, E81.14 (Y4), E87.5
/ioskip: E75.10, E76.9, E91.17 (Y1)
/irandtaddca: E48.8, E58.13
/ireg_9: E31.3 (A1), E32.7 (Q1), E46.1 (A0)
/ireg_10: E21.5 (A3), E32.10 (Q2), E46.2 (A1)
/ireg_11: E11.7 (A5), E32.14 (~Q3), E46.3 (A2)
/irisz: E47.12, E48.3
/irjmp: E68.10, E77.13
/irjms: E47.4, E57.10
/iropr: E67.6, E68.6, E76.11, E77.1
/irtad: E47.10, E58.1
/link: E63.9, E64.5, E81.7 (A5), E82.5 (Q)
/lnclk: E73.8, E82.3 (C)
/lndat: E82.2 (D), E93.3
/lnktog: E91.16 (Y2), E93.12
/madr_0: E52.2 (Q0), E71.5 (A3)
/madr_1: E52.5 (Q1), E61.9 (A7)
/madr_2: E52.7 (Q2), E61.5 (A3)
/madr_3: E44.5, E51.9 (A7), E52.10 (Q3)
/madr_4: E51.5 (A3), E52.12 (Q4), E56.3
/madr_5: E41.9 (A7), E52.15 (Q5), E56.2
/madr_6: E13.2 (Q0), E23.5, E41.5 (A3)
/madr_7: E13.5 (Q1), E23.4, E31.9 (A7)
/madr_8: E13.7 (Q2), E23.3, E31.5 (A3)
/madr_9: E13.10 (Q3), E21.7 (A5), E23.2
/madr_10: E11.9 (A7), E13.12 (Q4), E23.1
/madr_11: E11.3 (A1), E13.15 (Q5), E23.13
/majst_0: E91.12 (Y6), E94.15 (A0)
/majst_1: E91.13 (Y5), E94.14 (A1)
/majst_2: E91.14 (Y4), E94.13 (A2)
/majst_3: E56.5, E83.9, E91.15 (Y3), E94.12 (A3)
/maload: E13.9 (Cp), E52.9 (Cp), E63.6
/mbload: E12.9 (Cp), E45.9 (Cp), E57.11
/mbuf_0: E45.2 (Q0), E67.5, E71.6 (A4), E78.2
/mbuf_1: E45.5 (Q1), E55.1, E68.1, E71.2 (A0)
/mbuf_2: E45.7 (Q2), E55.10, E61.6 (A4), E68.3
/mbuf_3: E45.10 (Q3), E55.13, E61.2 (A0), E64.10
/mbuf_4: E45.12 (Q4), E51.6 (A4), E63.10, E65.3
/mbuf_5: E43.6, E45.15 (Q5), E51.2 (A0)
/mbuf_6: E12.2 (Q0), E41.6 (A4), E62.13, E63.12
/mbuf_7: E12.5 (Q1), E41.2 (A0), E62.1
/mbuf_8: E12.7 (Q2), E31.6 (A4), E56.9, E56.11, E67.1, E68.9
/mbuf_9: E12.10 (Q3), E21.8 (A6)
/mbuf_10: E12.12 (Q4), E21.2 (A0)
/mbuf_11: E11.4 (A2), E12.15 (Q5)
/memacsw: E63.1, J2.19
/msbreak: E83.6, E92.2, E92.4
/mscurad: E93.10, E95.6
/msdefer: E77.9, E77.12, E87.4
/msdepos: E84.2, E95.10
/msexam: E84.5, E95.4
/msexec: E48.5, E57.9, E58.2, E58.5, E58.12, E76.10, E77.2, E87.2
/msfetch: E54.9, E57.5, E62.2, E62.12, E65.2, E67.2, E75.13, E76.2, E84.13, E85.1, E85.12, E95.2
/msintak: E47.8, E57.2
/pcclk: E22.2 (CP), E42.2 (CP), E53.2 (CP), E74.6
/pcinc: E22.7 (CEP), E42.7 (CEP), E53.7 (CEP), E53.10 (CET), E75.6
/pctr_0: E53.14 (Q0), E71.7 (A5)
/pctr_1: E53.13 (Q1), E71.3 (A1)
/pctr_2: E53.12 (Q2), E61.7 (A5)
/pctr_3: E53.11 (Q3), E61.3 (A1)
/pctr_4: E42.14 (Q0), E51.7 (A5)
/pctr_5: E42.13 (Q1), E51.3 (A1)
/pctr_6: E41.7 (A5), E42.12 (Q2)
/pctr_7: E41.3 (A1), E42.11 (Q3)
/pctr_8: E22.14 (Q0), E31.7 (A5)
/pctr_9: E22.13 (Q1), E31.2 (A0)
/pctr_10: E21.4 (A2), E22.12 (Q2)
/pctr_11: E11.6 (A4), E22.11 (Q3)
/rotq_0: E34.3 (D0), E36.5 (Z)
/rotq_1: E26.5 (Z), E34.4 (D1)
/rotq_2: E18.5 (Z), E34.6 (D2)
/rotq_3: E17.5 (Z), E34.11 (D3)
/rotq_4: E34.13 (D4), E35.5 (Z)
/rotq_5: E25.5 (Z), E34.14 (D5)
/rotq_6: E16.5 (Z), E24.3 (D0)
/rotq_7: E15.5 (Z), E24.4 (D1)
/rotq_8: E14.5 (Z), E24.6 (D2)
/rotq_9: E24.11 (D3), E38.5 (Z)
/rotq_10: E24.13 (D4), E28.5 (Z)
/rotq_11: E24.14 (D5), E27.5 (Z)
/rotq_12: E37.5 (Z), E85.10
/run: E54.2, E81.12 (Y6)
/swcont: E81.15 (Y3), E83.11
/swcontx: E56.4
/swdepos: E81.16 (Y2), E84.1
/swexam: E81.17 (Y1), E84.4
/swldad: E81.18 (Y0), E83.1
/tp1: E47.5, E54.10, E57.1, E101.15 (Y3)
/tp2: E62.5, E62.9, E73.4, E84.12, E85.4, E101.14 (Y4)
/tp3: E73.9, E73.12, E83.13, E101.13 (Y5)
/tp4: E92.12, E101.12 (Y6)
/ts1: E91.11 (Y7), E92.5
/ts2: E85.2, E101.18 (Y0)
/ts3: E55.5, E65.1, E65.5, E75.2, E101.17 (Y1)
/ts4: E82.11 (C), E101.16 (Y2)
GND: C11.2, C12.2, C13.2, C14.2, C15.2, C16.2, C17.2, C18.2, C21.2, C22.2, C23.2, C24.2, C25.2, C26.2, C27.2, C28.2, C31.2, C32.2, C33.2, C34.2, C35.2, C36.2, C37.2, C38.2, C41.2, C42.2, C43.2, C44.2, C45.2, C46.2, C47.2, C48.2, C51.2, C52.2, C53.2, C54.2, C55.2, C56.2, C57.2, C58.2, C61.2, C62.2, C63.2, C64.2, C65.2, C66.2, C67.2, C68.2, C71.2, C72.2, C73.2, C74.2, C75.2, C76.2, C77.2, C78.2, C81.2, C82.2, C83.2, C84.2, C85.2, C86.2, C87.2, C88.2, C91.2, C92.2, C93.2, C94.2, C95.2, C96.2, C101.2, E11.1 (G1), E11.10 (GND), E11.19 (G2), E12.8 (GND), E13.8 (GND), E14.3 (I1), E14.4 (I0), E14.7 (~E), E14.8 (GND), E15.3 (I1), E15.4 (I0), E15.7 (~E), E15.8 (GND), E16.3 (I1), E16.4 (I0), E16.7 (~E), E16.8 (GND), E17.3 (I1), E17.4 (I0), E17.7 (~E), E17.8 (GND), E18.3 (I1), E18.4 (I0), E18.7 (~E), E18.8 (GND), E21.1 (G1), E21.10 (GND), E21.19 (G2), E22.8 (GND), E23.7 (GND), E24.8 (GND), E25.3 (I1), E25.4 (I0), E25.7 (~E), E25.8 (GND), E26.3 (I1), E26.4 (I0), E26.7 (~E), E26.8 (GND), E27.3 (I1), E27.4 (I0), E27.7 (~E), E27.8 (GND), E28.3 (I1), E28.4 (I0), E28.7 (~E), E28.8 (GND), E31.1 (G1), E31.10 (GND), E31.19 (G2), E32.8 (GND), E33.7 (GND), E34.8 (GND), E35.3 (I1), E35.4 (I0), E35.7 (~E), E35.8 (GND), E36.3 (I1), E36.4 (I0), E36.7 (~E), E36.8 (GND), E37.3 (I1), E37.4 (I0), E37.7 (~E), E37.8 (GND), E38.3 (I1), E38.4 (I0), E38.7 (~E), E38.8 (GND), E41.1 (G1), E41.10 (GND), E41.19 (G2), E42.8 (GND), E43.7 (GND), E44.7 (GND), E44.9, E44.10, E44.12, E44.13, E45.8 (GND), E46.4 (~E0), E46.5 (~E1), E46.8 (GND), E47.7 (GND), E48.7 (GND), E51.1 (G1), E51.10 (GND), E51.19 (G2), E52.8 (GND), E53.8 (GND), E54.7 (GND), E54.12, E54.13, E55.7 (GND), E56.7 (GND), E57.7 (GND), E58.7 (GND), E58.9, E58.10, E61.1 (G1), E61.10 (GND), E61.19 (G2), E62.7 (GND), E63.7 (GND), E64.7 (GND), E64.12, E64.13, E65.7 (GND), E65.9, E65.10, E65.11, E66.7 (GND), E67.7 (GND), E68.7 (GND), E68.13, E71.1 (G1), E71.10 (GND), E71.19 (G2), E72.7 (GND), E72.10 (~S), E72.11 (C), E72.12 (D), E72.13 (~R), E73.7 (GND), E74.7 (GND), E75.7 (GND), E76.7 (GND), E77.7 (GND), E78.3, E78.4, E78.5, E78.7 (GND), E78.9, E78.10, E78.11, E81.1 (G1), E81.10 (GND), E81.19 (G2), E82.7 (GND), E82.12 (D), E83.7 (GND), E84.7 (GND), E85.7 (GND), E86.7 (GND), E86.9, E86.10, E86.12, E86.13, E87.7 (GND), E87.9, E87.11, E87.13, E88.4, E88.5, E88.7 (GND), E88.9, E88.10, E88.12, E88.13, E91.1 (G1), E91.10 (GND), E91.19 (G2), E92.7 (GND), E92.9, E92.10, E93.4, E93.5, E93.7 (GND), E94.8 (GND), E95.7 (GND), E95.9, E96.7 (GND), E101.1 (G1), E101.10 (GND), E101.19 (G2), J1.36, J2.36, J3.36, J4.36
unnamed: E75.5, E85.3
unnamed: E57.12, E85.6
unnamed: E73.5, E84.8
unnamed: E75.3, E75.4
unnamed: E64.2, E64.6
unnamed: E72.3 (C), E73.6
unnamed: E48.6, E66.13
unnamed: E48.12, E58.4
unnamed: E47.6, E57.13
unnamed: E63.2, E74.8
unnamed: E63.5, E92.11
unnamed: E92.3, E96.5
unnamed: E83.8, E92.13
unnamed: E85.8, E93.1
unnamed: E93.8, E96.6
unnamed: E93.2, E93.11
unnamed: E85.13, E88.3
unnamed: E58.3, E76.3
unnamed: E75.11, E76.4
unnamed: E73.10, E76.6
unnamed: E66.9, E76.8
unnamed: E66.10, E76.12
unnamed: E74.4, E83.12
unnamed: E74.5, E84.11
unnamed: E74.9, E84.6
unnamed: E74.10, E84.3
unnamed: E74.11, E83.2
unnamed: E64.9, E74.12
unnamed: E58.6, E96.1
unnamed: E58.11, E86.1
unnamed: E94.2 (1), E95.1
unnamed: E94.6 (5), E95.5
unnamed: E83.5, E94.7 (6)
unnamed: E94.11 (9), E95.3
unnamed: E85.5, E96.8
unnamed: E77.8, E96.12
unnamed: E57.6, E66.1
unnamed: E57.8, E66.2
unnamed: E66.5, E77.11
unnamed: E55.4, E66.6
unnamed: E66.8, E75.1
unnamed: E66.12, E75.8
unnamed: E56.6, E83.10
unnamed: E54.1, E55.6
unnamed: E55.2, E55.9, E55.12, E65.12
unnamed: E85.11, E86.4
unnamed: E86.5, E87.6
unnamed: E73.13, E86.6
unnamed: E54.4, E62.6
unnamed: E62.8, E73.1
unnamed: E77.3, E77.4
unnamed: E67.8, E77.5
unnamed: E42.10 (CET), E53.15 (TC)
unnamed: E22.10 (CET), E42.15 (TC)
unnamed: E24.1 (~Mr), E34.1 (~Mr), E54.6
unnamed: E73.3, E82.1 (~R)
unnamed: E82.10 (~S), E92.6
unnamed: E32.9 (Cp), E54.8
unnamed: E32.13 (D3), E47.2
unnamed: E32.1 (~Mr), E57.3
unnamed: E67.12, E68.2
unnamed: E67.11, E68.4
unnamed: E68.8, E78.13
unnamed: E44.4, E56.1
unnamed: E23.6, E44.2
unnamed: E23.8, E43.2
unnamed: E23.12, E44.1
unnamed: E33.6, E43.1
unnamed: E33.8, E43.12
unnamed: E33.12, E43.3
VCC: C11.1, C12.1, C13.1, C14.1, C15.1, C16.1, C17.1, C18.1, C21.1, C22.1, C23.1, C24.1, C25.1, C26.1, C27.1, C28.1, C31.1, C32.1, C33.1, C34.1, C35.1, C36.1, C37.1, C38.1, C41.1, C42.1, C43.1, C44.1, C45.1, C46.1, C47.1, C48.1, C51.1, C52.1, C53.1, C54.1, C55.1, C56.1, C57.1, C58.1, C61.1, C62.1, C63.1, C64.1, C65.1, C66.1, C67.1, C68.1, C71.1, C72.1, C73.1, C74.1, C75.1, C76.1, C77.1, C78.1, C81.1, C82.1, C83.1, C84.1, C85.1, C86.1, C87.1, C88.1, C91.1, C92.1, C93.1, C94.1, C95.1, C96.1, C101.1, E11.20 (VCC), E12.1 (~Mr), E12.16 (VCC), E13.1 (~Mr), E13.16 (VCC), E14.16 (VCC), E15.16 (VCC), E16.16 (VCC), E17.16 (VCC), E18.16 (VCC), E21.20 (VCC), E22.1 (~MR), E22.16 (VCC), E23.14 (VCC), E24.16 (VCC), E25.16 (VCC), E26.16 (VCC), E27.16 (VCC), E28.16 (VCC), E31.20 (VCC), E32.4 (D0), E32.16 (VCC), E33.14 (VCC), E34.16 (VCC), E35.16 (VCC), E36.16 (VCC), E37.16 (VCC), E38.16 (VCC), E41.20 (VCC), E42.1 (~MR), E42.16 (VCC), E43.4, E43.5, E43.11, E43.14 (VCC), E44.14 (VCC), E45.1 (~Mr), E45.16 (VCC), E46.6 (E2), E46.16 (VCC), E47.14 (VCC), E48.14 (VCC), E51.20 (VCC), E52.1 (~Mr), E52.16 (VCC), E53.1 (~MR), E53.16 (VCC), E54.14 (VCC), E55.14 (VCC), E56.14 (VCC), E57.14 (VCC), E58.14 (VCC), E61.20 (VCC), E62.14 (VCC), E63.14 (VCC), E64.14 (VCC), E65.14 (VCC), E66.14 (VCC), E67.3, E67.4, E67.14 (VCC), E68.14 (VCC), E71.20 (VCC), E72.1 (~R), E72.4 (~S), E72.14 (VCC), E73.14 (VCC), E74.14 (VCC), E75.14 (VCC), E76.14 (VCC), E77.14 (VCC), E78.14 (VCC), E81.20 (VCC), E82.4 (~S), E82.14 (VCC), E83.14 (VCC), E84.14 (VCC), E85.14 (VCC), E86.14 (VCC), E87.14 (VCC), E88.14 (VCC), E91.20 (VCC), E92.14 (VCC), E93.14 (VCC), E94.16 (VCC), E95.14 (VCC), E96.11, E96.14 (VCC), E101.20 (VCC), J1.1, J2.1, J3.1, J4.1

Notes on the sheet:
RSEL 0 nop 1 BSW 2 RAL 3 RTL 4 RAR 5 RTR 6,7 zero
inc pc for isz instrs
// _MQUO_6
load pc for jms
load MBUF at end of TS1 with data read from memory
brkcyc sets at TS1 of break cycle clears at TS4 of all cycles
// _MQUO_1
// _MQUO_0
enable pc load at next pcclk
// _MQUO_3
Clear ACUM for Group1 CLA at TP2
clock in new MADR at TP4 except EXAM and DEPOS cycles
// _MQUO_11
// _SCTR_4
load pc for indir jmp
load pc for dir jmp
load pc when halted for ldad/exam/depos
load pc for intak
// _MQUO_7
// _MQUO_4
save overflow bit at TP2 * EXEC: used for ISZ skip must be valid until same TP3 * WRDCT: used for BWCOV must be valid until BREAK TP3
load MADR after a 2 cycle delay after LDAD,EXAM,DEPOS LDAD: loads from SR repeat EXAM/DEPOS: load MADR+1
inc pc after fetch
// _MQUO_5
// _MQUO_9
// _MQUO_2
inc pc for skip instrs
clock pc: ldad pressed tp2 during fetch tp3 must have pcinc or pcld to do anything else it is a nop
Clock ROTQ into ACUM at TP3 * FETCH of IOT instruction * EXEC of AND/TAD/DCA * FETCH of Group1,Group2 * ext arith execute
inc pc for i/o instrs
// _DMAFLD_1
// _MQUO_8
// _MQUO_10
inc pc for eae instrs
enable pc inc at next pcclk
load MBUF at end of TS2 with updated value to write to memory in TS3
current cycle is performing extended arithmetic accumulator and link get clocked at TP3 in these cycles FETCH: must have opcode 111 1xx xxx 001 EXEC: must have opcode 111 xxx xxx xxx it is the only OPR opcode that uses EXEC state
I2: RTR I3: RAR I4: RTL I5: RAL I6: BSW I7: nop

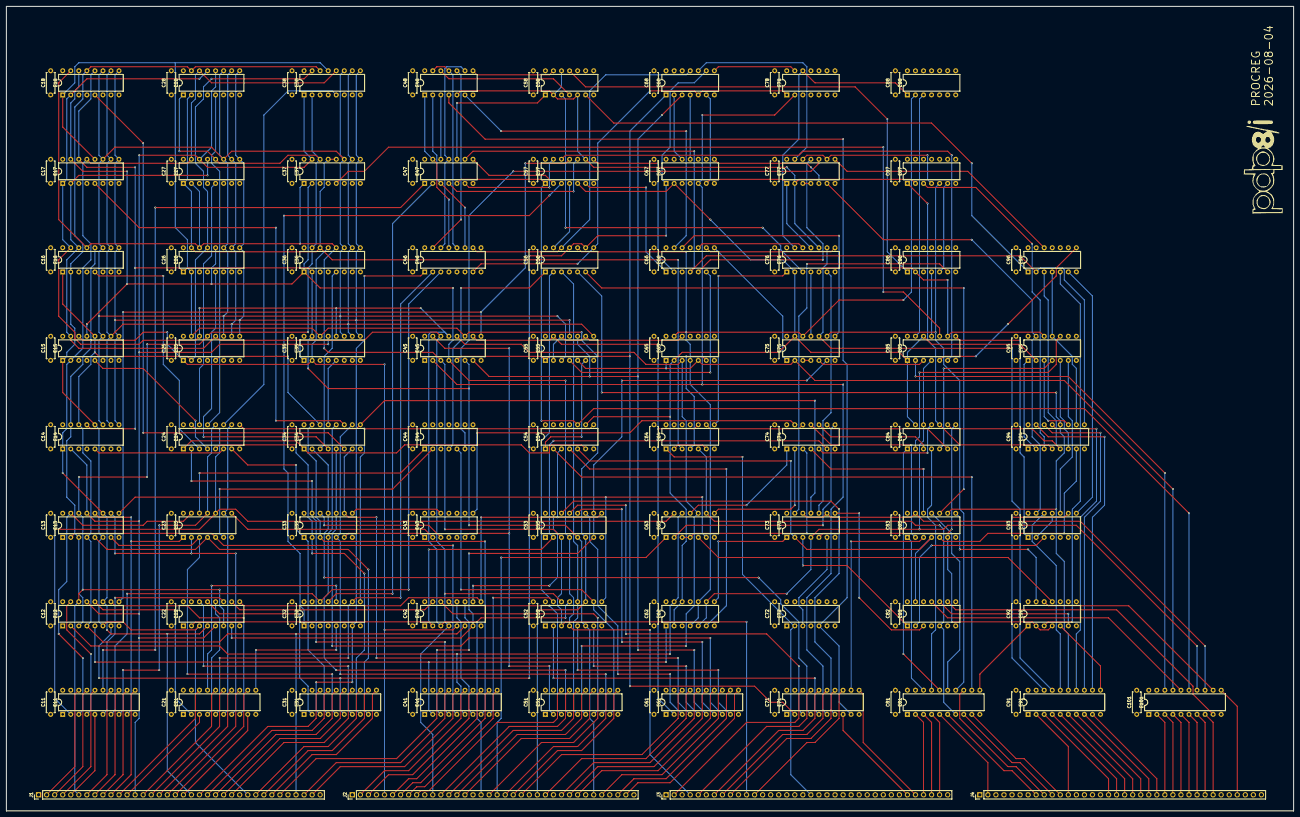
[picture p19: board procreg.kicad_pcb from above]

Board: 4 copper layers, 406.4 x 254.0 mm, 146 parts (0 on the bottom side), 310 nets.
