mrieker/pdp8i/kicads/term/term.kicad_pcb

## KiCad design kicads/term/term.kicad_pcb (2026-08-17)

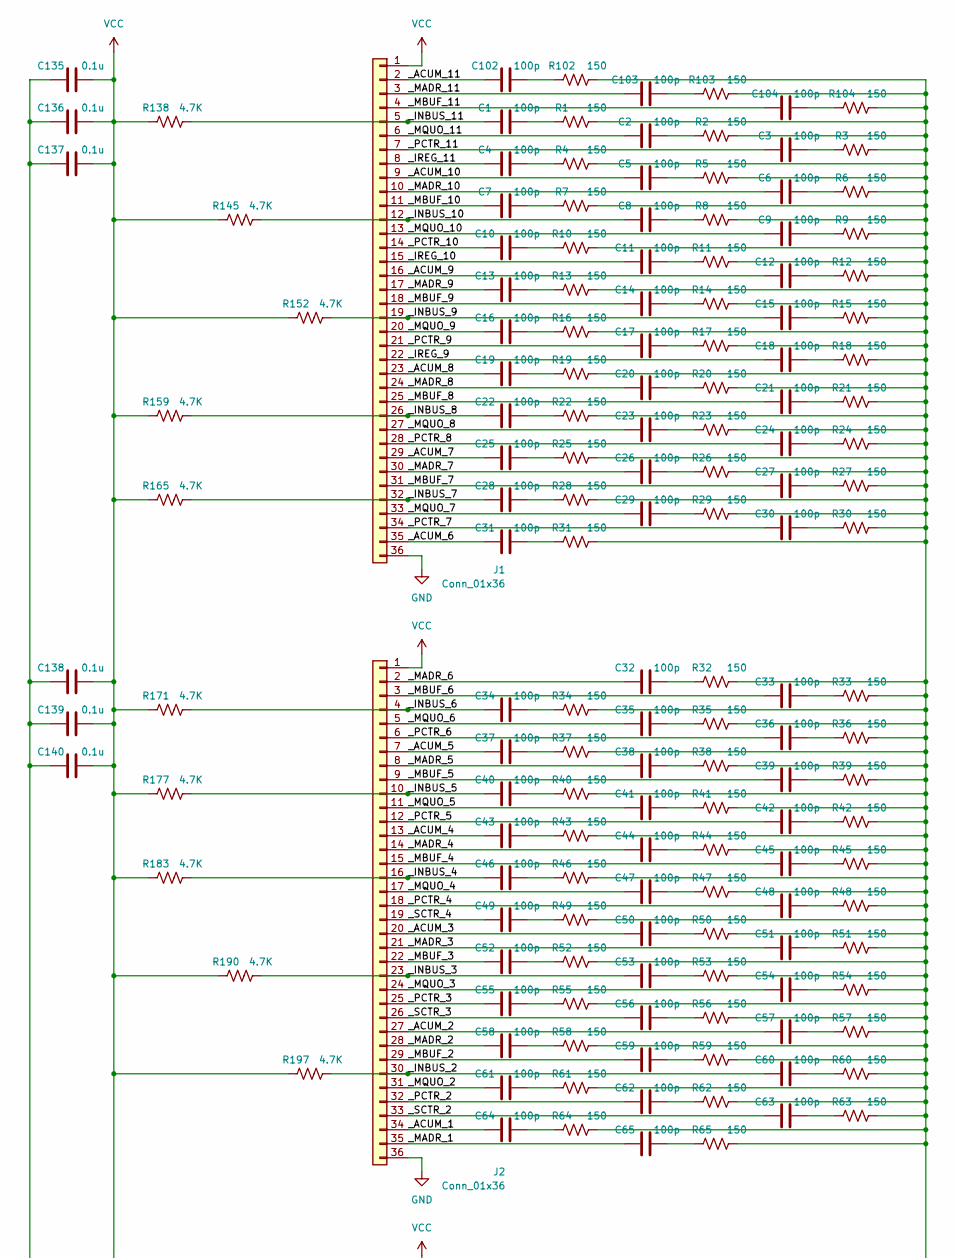
[picture p20: schematic term.kicad_sch, part in row 1, column 1]

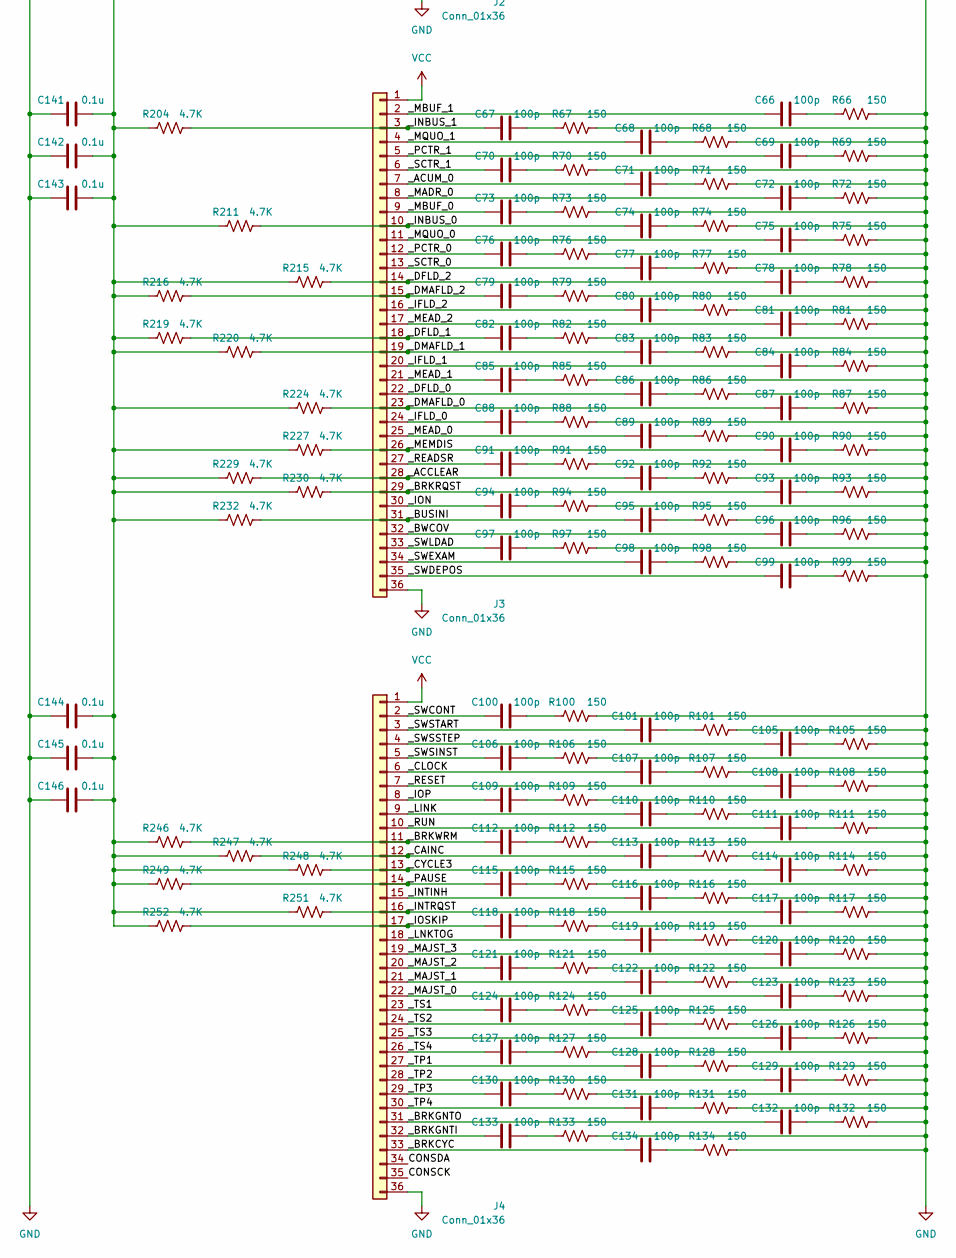
[picture p21: schematic term.kicad_sch, part in row 2, column 1]

Parts:
C1, C2, C3, C4, C5, C6, C7, C8, C9, C10, C11, C12, C13, C14, C15, C16, C17, C18, C19, C20, C21, C22, C23, C24, C25, C26, C27, C28, C29, C30, C31, C32, C33, C34, C35, C36, C37, C38, C39, C40, C41, C42, C43, C44, C45, C46, C47, C48, C49, C50, C51, C52, C53, C54, C55, C56, C57, C58, C59, C60, C61, C62, C63, C64, C65, C66, C67, C68, C69, C70, C71, C72, C73, C74, C75, C76, C77, C78, C79, C80, C81, C82, C83, C84, C85, C86, C87, C88, C89, C90, C91, C92, C93, C94, C95, C96, C97, C98, C99, C100, C101, C102, C103, C104, C105, C106, C107, C108, C109, C110, C111, C112, C113, C114, C115, C116, C117, C118, C119, C120, C121, C122, C123, C124, C125, C126, C127, C128, C129, C130, C131, C132, C133, C134: 100p; R_Axial_DIN0207_L6.3mm_D2.5mm_P7.62mm_Horizontal
C135, C136, C137, C138, C139, C140, C141, C142, C143, C144, C145, C146: 0.1u; R_Axial_DIN0207_L6.3mm_D2.5mm_P7.62mm_Horizontal
J1, J2, J3, J4: Conn_01x36; PinHeader_1x36_P2.54mm_Vertical
R1, R2, R3, R4, R5, R6, R7, R8, R9, R10, R11, R12, R13, R14, R15, R16, R17, R18, R19, R20, R21, R22, R23, R24, R25, R26, R27, R28, R29, R30, R31, R32, R33, R34, R35, R36, R37, R38, R39, R40, R41, R42, R43, R44, R45, R46, R47, R48, R49, R50, R51, R52, R53, R54, R55, R56, R57, R58, R59, R60, R61, R62, R63, R64, R65, R66, R67, R68, R69, R70, R71, R72, R73, R74, R75, R76, R77, R78, R79, R80, R81, R82, R83, R84, R85, R86, R87, R88, R89, R90, R91, R92, R93, R94, R95, R96, R97, R98, R99, R100, R101, R102, R103, R104, R105, R106, R107, R108, R109, R110, R111, R112, R113, R114, R115, R116, R117, R118, R119, R120, R121, R122, R123, R124, R125, R126, R127, R128, R129, R130, R131, R132, R133, R134: 150; R_Axial_DIN0207_L6.3mm_D2.5mm_P7.62mm_Horizontal
R138, R145, R152, R159, R165, R171, R177, R183, R190, R197, R204, R211, R215, R216, R219, R220, R224, R227, R229, R230, R232, R246, R247, R248, R249, R251, R252: 4.7K; R_Axial_DIN0207_L6.3mm_D2.5mm_P7.62mm_Horizontal

Connections:
/CONSCK: J4.35
/CONSDA: J4.34
/_ACCLEAR: C92.1, J3.28, R229.2
/_ACUM_0: C71.1, J3.7
/_ACUM_1: C64.1, J2.34
/_ACUM_2: C57.1, J2.27
/_ACUM_3: C50.1, J2.20
/_ACUM_4: C43.1, J2.13
/_ACUM_5: C37.1, J2.7
/_ACUM_6: C31.1, J1.35
/_ACUM_7: C25.1, J1.29
/_ACUM_8: C19.1, J1.23
/_ACUM_9: C12.1, J1.16
/_ACUM_10: C5.1, J1.9
/_ACUM_11: C102.1, J1.2
/_BRKCYC: C134.1, J4.33
/_BRKGNTI: C133.1, J4.32
/_BRKGNTO: C132.1, J4.31
/_BRKRQST: C93.1, J3.29, R230.2
/_BRKWRM: C112.1, J4.11, R246.2
/_BUSINI: C95.1, J3.31, R232.2
/_BWCOV: C96.1, J3.32
/_CAINC: C113.1, J4.12, R247.2
/_CLOCK: C107.1, J4.6
/_CYCLE3: C114.1, J4.13, R248.2
/_DFLD_0: C86.1, J3.22
/_DFLD_1: C82.1, J3.18, R219.2
/_DFLD_2: C78.1, J3.14, R215.2
/_DMAFLD_0: C87.1, J3.23, R224.2
/_DMAFLD_1: C83.1, J3.19, R220.2
/_DMAFLD_2: C79.1, J3.15, R216.2
/_IFLD_0: C88.1, J3.24
/_IFLD_1: C84.1, J3.20
/_IFLD_2: C80.1, J3.16
/_INBUS_0: C74.1, J3.10, R211.2
/_INBUS_1: C67.1, J3.3, R204.2
/_INBUS_2: C60.1, J2.30, R197.2
/_INBUS_3: C53.1, J2.23, R190.2
/_INBUS_4: C46.1, J2.16, R183.2
/_INBUS_5: C40.1, J2.10, R177.2
/_INBUS_6: C34.1, J2.4, R171.2
/_INBUS_7: C28.1, J1.32, R165.2
/_INBUS_8: C22.1, J1.26, R159.2
/_INBUS_9: C15.1, J1.19, R152.2
/_INBUS_10: C8.1, J1.12, R145.2
/_INBUS_11: C1.1, J1.5, R138.2
/_INTINH: C116.1, J4.15
/_INTRQST: C117.1, J4.16, R251.2
/_ION: C94.1, J3.30
/_IOP: C109.1, J4.8
/_IOSKIP: C118.1, J4.17, R252.2
/_IREG_9: C18.1, J1.22
/_IREG_10: C11.1, J1.15
/_IREG_11: C4.1, J1.8
/_LINK: C110.1, J4.9
/_LNKTOG: C119.1, J4.18
/_MADR_0: C72.1, J3.8
/_MADR_1: C65.1, J2.35
/_MADR_2: C58.1, J2.28
/_MADR_3: C51.1, J2.21
/_MADR_4: C44.1, J2.14
/_MADR_5: C38.1, J2.8
/_MADR_6: C32.1, J2.2
/_MADR_7: C26.1, J1.30
/_MADR_8: C20.1, J1.24
/_MADR_9: C13.1, J1.17
/_MADR_10: C6.1, J1.10
/_MADR_11: C103.1, J1.3
/_MAJST_0: C123.1, J4.22
/_MAJST_1: C122.1, J4.21
/_MAJST_2: C121.1, J4.20
/_MAJST_3: C120.1, J4.19
/_MBUF_0: C73.1, J3.9
/_MBUF_1: C66.1, J3.2
/_MBUF_2: C59.1, J2.29
/_MBUF_3: C52.1, J2.22
/_MBUF_4: C45.1, J2.15
/_MBUF_5: C39.1, J2.9
/_MBUF_6: C33.1, J2.3
/_MBUF_7: C27.1, J1.31
/_MBUF_8: C21.1, J1.25
/_MBUF_9: C14.1, J1.18
/_MBUF_10: C7.1, J1.11
/_MBUF_11: C104.1, J1.4
/_MEAD_0: C89.1, J3.25
/_MEAD_1: C85.1, J3.21
/_MEAD_2: C81.1, J3.17
/_MEMDIS: C90.1, J3.26, R227.2
/_MQUO_0: C75.1, J3.11
/_MQUO_1: C68.1, J3.4
/_MQUO_2: C61.1, J2.31
/_MQUO_3: C54.1, J2.24
/_MQUO_4: C47.1, J2.17
/_MQUO_5: C41.1, J2.11
/_MQUO_6: C35.1, J2.5
/_MQUO_7: C29.1, J1.33
/_MQUO_8: C23.1, J1.27
/_MQUO_9: C16.1, J1.20
/_MQUO_10: C9.1, J1.13
/_MQUO_11: C2.1, J1.6
/_PAUSE: C115.1, J4.14, R249.2
/_PCTR_0: C76.1, J3.12
/_PCTR_1: C69.1, J3.5
/_PCTR_2: C62.1, J2.32
/_PCTR_3: C55.1, J2.25
/_PCTR_4: C48.1, J2.18
/_PCTR_5: C42.1, J2.12
/_PCTR_6: C36.1, J2.6
/_PCTR_7: C30.1, J1.34
/_PCTR_8: C24.1, J1.28
/_PCTR_9: C17.1, J1.21
/_PCTR_10: C10.1, J1.14
/_PCTR_11: C3.1, J1.7
/_READSR: C91.1, J3.27
/_RESET: C108.1, J4.7
/_RUN: C111.1, J4.10
/_SCTR_0: C77.1, J3.13
/_SCTR_1: C70.1, J3.6
/_SCTR_2: C63.1, J2.33
/_SCTR_3: C56.1, J2.26
/_SCTR_4: C49.1, J2.19
/_SWCONT: C100.1, J4.2
/_SWDEPOS: C99.1, J3.35
/_SWEXAM: C98.1, J3.34
/_SWLDAD: C97.1, J3.33
/_SWSINST: C106.1, J4.5
/_SWSSTEP: C105.1, J4.4
/_SWSTART: C101.1, J4.3
/_TP1: C128.1, J4.27
/_TP2: C129.1, J4.28
/_TP3: C130.1, J4.29
/_TP4: C131.1, J4.30
/_TS1: C124.1, J4.23
/_TS2: C125.1, J4.24
/_TS3: C126.1, J4.25
/_TS4: C127.1, J4.26
GND: C135.1, C136.1, C137.1, C138.1, C139.1, C140.1, C141.1, C142.1, C143.1, C144.1, C145.1, C146.1, J1.36, J2.36, J3.36, J4.36, R1.2, R2.2, R3.2, R4.2, R5.2, R6.2, R7.2, R8.2, R9.2, R10.2, R11.2, R12.2, R13.2, R14.2, R15.2, R16.2, R17.2, R18.2, R19.2, R20.2, R21.2, R22.2, R23.2, R24.2, R25.2, R26.2, R27.2, R28.2, R29.2, R30.2, R31.2, R32.2, R33.2, R34.2, R35.2, R36.2, R37.2, R38.2, R39.2, R40.2, R41.2, R42.2, R43.2, R44.2, R45.2, R46.2, R47.2, R48.2, R49.2, R50.2, R51.2, R52.2, R53.2, R54.2, R55.2, R56.2, R57.2, R58.2, R59.2, R60.2, R61.2, R62.2, R63.2, R64.2, R65.2, R66.2, R67.2, R68.2, R69.2, R70.2, R71.2, R72.2, R73.2, R74.2, R75.2, R76.2, R77.2, R78.2, R79.2, R80.2, R81.2, R82.2, R83.2, R84.2, R85.2, R86.2, R87.2, R88.2, R89.2, R90.2, R91.2, R92.2, R93.2, R94.2, R95.2, R96.2, R97.2, R98.2, R99.2, R100.2, R101.2, R102.2, R103.2, R104.2, R105.2, R106.2, R107.2, R108.2, R109.2, R110.2, R111.2, R112.2, R113.2, R114.2, R115.2, R116.2, R117.2, R118.2, R119.2, R120.2, R121.2, R122.2, R123.2, R124.2, R125.2, R126.2, R127.2, R128.2, R129.2, R130.2, R131.2, R132.2, R133.2, R134.2
unnamed: C1.2, R1.1
unnamed: C2.2, R2.1
unnamed: C3.2, R3.1
unnamed: C4.2, R4.1
unnamed: C5.2, R5.1
unnamed: C6.2, R6.1
unnamed: C7.2, R7.1
unnamed: C8.2, R8.1
unnamed: C9.2, R9.1
unnamed: C10.2, R10.1
unnamed: C11.2, R11.1
unnamed: C12.2, R12.1
unnamed: C13.2, R13.1
unnamed: C14.2, R14.1
unnamed: C15.2, R15.1
unnamed: C16.2, R16.1
unnamed: C17.2, R17.1
unnamed: C18.2, R18.1
unnamed: C19.2, R19.1
unnamed: C20.2, R20.1
unnamed: C21.2, R21.1
unnamed: C22.2, R22.1
unnamed: C23.2, R23.1
unnamed: C24.2, R24.1
unnamed: C25.2, R25.1
unnamed: C26.2, R26.1
unnamed: C27.2, R27.1
unnamed: C28.2, R28.1
unnamed: C29.2, R29.1
unnamed: C30.2, R30.1
unnamed: C31.2, R31.1
unnamed: C32.2, R32.1
unnamed: C33.2, R33.1
unnamed: C34.2, R34.1
unnamed: C35.2, R35.1
unnamed: C36.2, R36.1
unnamed: C37.2, R37.1
unnamed: C38.2, R38.1
unnamed: C39.2, R39.1
unnamed: C40.2, R40.1
unnamed: C41.2, R41.1
unnamed: C42.2, R42.1
unnamed: C43.2, R43.1
unnamed: C44.2, R44.1
unnamed: C45.2, R45.1
unnamed: C46.2, R46.1
unnamed: C47.2, R47.1
unnamed: C48.2, R48.1
unnamed: C49.2, R49.1
unnamed: C50.2, R50.1
unnamed: C51.2, R51.1
unnamed: C52.2, R52.1
unnamed: C53.2, R53.1
unnamed: C54.2, R54.1
unnamed: C55.2, R55.1
unnamed: C56.2, R56.1
unnamed: C57.2, R57.1
unnamed: C58.2, R58.1
unnamed: C59.2, R59.1
unnamed: C60.2, R60.1
unnamed: C61.2, R61.1
unnamed: C62.2, R62.1
unnamed: C63.2, R63.1
unnamed: C64.2, R64.1
unnamed: C65.2, R65.1
unnamed: C66.2, R66.1
unnamed: C67.2, R67.1
unnamed: C68.2, R68.1
unnamed: C69.2, R69.1
unnamed: C70.2, R70.1
unnamed: C71.2, R71.1
unnamed: C72.2, R72.1
unnamed: C73.2, R73.1
unnamed: C74.2, R74.1
unnamed: C75.2, R75.1
unnamed: C76.2, R76.1
unnamed: C77.2, R77.1
unnamed: C78.2, R78.1
unnamed: C79.2, R79.1
unnamed: C80.2, R80.1
unnamed: C81.2, R81.1
unnamed: C82.2, R82.1
unnamed: C83.2, R83.1
unnamed: C84.2, R84.1
unnamed: C85.2, R85.1
unnamed: C86.2, R86.1
unnamed: C87.2, R87.1
unnamed: C88.2, R88.1
unnamed: C89.2, R89.1
unnamed: C90.2, R90.1
unnamed: C91.2, R91.1
unnamed: C92.2, R92.1
unnamed: C93.2, R93.1
unnamed: C94.2, R94.1
unnamed: C95.2, R95.1
unnamed: C96.2, R96.1
unnamed: C97.2, R97.1
unnamed: C98.2, R98.1
unnamed: C99.2, R99.1
unnamed: C100.2, R100.1
unnamed: C101.2, R101.1
unnamed: C102.2, R102.1
unnamed: C103.2, R103.1
unnamed: C104.2, R104.1
unnamed: C105.2, R105.1
unnamed: C106.2, R106.1
unnamed: C107.2, R107.1
unnamed: C108.2, R108.1
unnamed: C109.2, R109.1
unnamed: C110.2, R110.1
unnamed: C111.2, R111.1
unnamed: C112.2, R112.1
unnamed: C113.2, R113.1
unnamed: C114.2, R114.1
unnamed: C115.2, R115.1
unnamed: C116.2, R116.1
unnamed: C117.2, R117.1
unnamed: C118.2, R118.1
unnamed: C119.2, R119.1
unnamed: C120.2, R120.1
unnamed: C121.2, R121.1
unnamed: C122.2, R122.1
unnamed: C123.2, R123.1
unnamed: C124.2, R124.1
unnamed: C125.2, R125.1
unnamed: C126.2, R126.1
unnamed: C127.2, R127.1
unnamed: C128.2, R128.1
unnamed: C129.2, R129.1
unnamed: C130.2, R130.1
unnamed: C131.2, R131.1
unnamed: C132.2, R132.1
unnamed: C133.2, R133.1
unnamed: C134.2, R134.1
VCC: C135.2, C136.2, C137.2, C138.2, C139.2, C140.2, C141.2, C142.2, C143.2, C144.2, C145.2, C146.2, J1.1, J2.1, J3.1, J4.1, R138.1, R145.1, R152.1, R159.1, R165.1, R171.1, R177.1, R183.1, R190.1, R197.1, R204.1, R211.1, R215.1, R216.1, R219.1, R220.1, R224.1, R227.1, R229.1, R230.1, R232.1, R246.1, R247.1, R248.1, R249.1, R251.1, R252.1

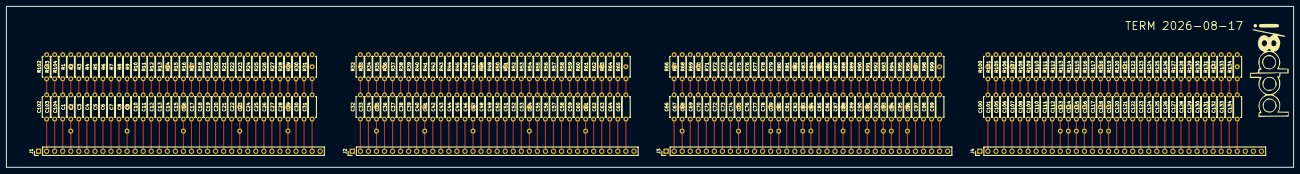
[picture p22: board term.kicad_pcb from above]

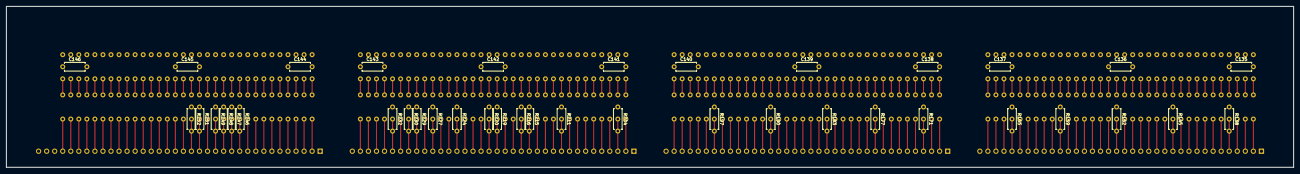
[picture p23: board term.kicad_pcb from below]

Board: 4 copper layers, 406.4 x 50.8 mm, 311 parts (39 on the bottom side), 270 nets.
