mrieker/pdp8i/kicads/dmatester/dmatester.kicad_pcb

## KiCad design kicads/dmatester/dmatester.kicad_pcb (2026-08-04)

Schematic: dmatester.kicad_sch

Parts:
J1, J2, J3, J4: Conn_02x20_Odd_Even; PinHeader_2x20_P2.54mm_Vertical
J5, J6: Conn_01x24; PinHeader_1x24_P2.54mm_Vertical
U2, U118: 74AC20; DIP-14_W7.62mm
U3: 74HC27; DIP-14_W7.62mm
U4, U5, U10, U12, U13, U18, U19, U24: 74AHC540; DIP-20_W7.62mm
U14: 74AHC02; DIP-14_W7.62mm
U15, U16, U17, U26, U27, U28, U29, U33, U34, U35, U36, U37, U39, U40, U42, U43, U44: 74AHC174; DIP-16_W7.62mm
U20, U124, U125, U141: 74AHC04; DIP-14_W7.62mm
U22, U38, U116, U157, U163: 74HC30; DIP-14_W7.62mm
U41, U169: 74AHC74; DIP-14_W7.62mm
U45: 74AHC86; DIP-14_W7.62mm
U54: 74AHC08; DIP-14_W7.62mm
U147, U158, U161: 74AHC00; DIP-14_W7.62mm
U149: 74AC10; DIP-14_W7.62mm
U155: 74HC21; DIP-14_W7.62mm
U167: 74AC11; DIP-14_W7.62mm
U174: 74AC109; DIP-16_W7.62mm
U180: 74AHC541; DIP-20_W7.62mm

Connections:
/CLOK2: J4.3, U10.7 (A5)
/_ACCLEAR: J3.27
/_ACUM_0: J3.4
/_ACUM_1: J2.33
/_ACUM_2: J2.26
/_ACUM_3: J2.19
/_ACUM_4: J2.12
/_ACUM_5: J2.6
/_ACUM_6: J1.36
/_ACUM_7: J1.30
/_ACUM_8: J1.24
/_ACUM_9: J1.17
/_ACUM_10: J1.10
/_ACUM_11: J1.3
/_BRKCYC: J4.32, U12.7 (A5)
/_BRKGNTI: J4.30, U180.8 (A6)
/_BRKGNTO: J4.29, U180.11 (Y7)
/_BRKRQST: J3.28, U12.12 (Y6), U180.7 (A5)
/_BRKWRM: J4.9, U4.13 (Y5)
/_BUSINI: J3.30, U10.6 (A4)
/_BWCOV: J3.31, U12.9 (A7)
/_CAINC: J4.10, U4.14 (Y4)
/_CYCLE3: J4.11, U4.15 (Y3)
/_DFLD_0: J3.19
/_DFLD_1: J3.15
/_DFLD_2: J3.11
/_DMAFLD_0: J3.20, U4.16 (Y2)
/_DMAFLD_1: J3.16, U4.17 (Y1)
/_DMAFLD_2: J3.12, U4.18 (Y0)
/_FIELD_0: J3.22
/_FIELD_1: J3.18
/_FIELD_2: J3.14
/_IFLD_0: J3.21
/_IFLD_1: J3.17
/_IFLD_2: J3.13
/_INBUS_0: J3.7, U13.18 (Y0), U18.18 (Y0)
/_INBUS_1: J2.36, U13.17 (Y1), U18.17 (Y1)
/_INBUS_2: J2.29, U13.16 (Y2), U18.16 (Y2)
/_INBUS_3: J2.22, U13.15 (Y3), U18.15 (Y3)
/_INBUS_4: J2.15, U13.14 (Y4), U18.14 (Y4)
/_INBUS_5: J2.9, U13.13 (Y5), U18.13 (Y5)
/_INBUS_6: J2.3, U19.18 (Y0), U24.18 (Y0)
/_INBUS_7: J1.33, U19.17 (Y1), U24.17 (Y1)
/_INBUS_8: J1.27, U19.16 (Y2), U24.16 (Y2)
/_INBUS_9: J1.20, U19.15 (Y3), U24.15 (Y3)
/_INBUS_10: J1.13, U19.14 (Y4), U24.14 (Y4)
/_INBUS_11: J1.6, U19.13 (Y5), U24.13 (Y5)
/_INTINH: J4.13
/_INTRQST: J4.14
/_ION: J3.29
/_IOP: J4.6
/_IOSKIP: J4.15
/_IREG_9: J1.23
/_IREG_10: J1.16
/_IREG_11: J1.9
/_LINK: J4.7
/_LNKTOG: J4.16
/_MADR_0: J3.5
/_MADR_1: J2.34
/_MADR_2: J2.27
/_MADR_3: J2.20
/_MADR_4: J2.13
/_MADR_5: J2.7
/_MADR_6: J1.37
/_MADR_7: J1.31
/_MADR_8: J1.25
/_MADR_9: J1.18
/_MADR_10: J1.11
/_MADR_11: J1.4
/_MAJST_0: J4.20
/_MAJST_1: J4.19
/_MAJST_2: J4.18
/_MAJST_3: J4.17
/_MBUF_0: J3.6, U10.5 (A3)
/_MBUF_1: J2.35, U10.4 (A2)
/_MBUF_2: J2.28, U10.3 (A1)
/_MBUF_3: J2.21, U10.2 (A0)
/_MBUF_4: J2.14, U5.9 (A7)
/_MBUF_5: J2.8, U5.8 (A6)
/_MBUF_6: J1.38, U5.7 (A5)
/_MBUF_7: J1.32, U5.6 (A4)
/_MBUF_8: J1.26, U5.5 (A3)
/_MBUF_9: J1.19, U5.4 (A2)
/_MBUF_10: J1.12, U5.3 (A1)
/_MBUF_11: J1.5, U5.2 (A0)
/_MEMDIS: J3.25
/_MQUO_0: J3.8
/_MQUO_1: J2.37
/_MQUO_2: J2.30
/_MQUO_3: J2.23
/_MQUO_4: J2.16
/_MQUO_5: J2.10
/_MQUO_6: J2.4
/_MQUO_7: J1.34
/_MQUO_8: J1.28
/_MQUO_9: J1.21
/_MQUO_10: J1.14
/_MQUO_11: J1.7
/_PAUSE: J4.12
/_PCTR_0: J3.9
/_PCTR_1: J2.38
/_PCTR_2: J2.31
/_PCTR_3: J2.24
/_PCTR_4: J2.17
/_PCTR_5: J2.11
/_PCTR_6: J2.5
/_PCTR_7: J1.35
/_PCTR_8: J1.29
/_PCTR_9: J1.22
/_PCTR_10: J1.15
/_PCTR_11: J1.8
/_READSR: J3.26
/_RESET: J4.4, U10.8 (A6)
/_RUN: J4.8
/_SCTR_0: J3.10
/_SCTR_1: J3.3
/_SCTR_2: J2.32
/_SCTR_3: J2.25
/_SCTR_4: J2.18
/_SWCONT: J3.35
/_SWDEPOS: J3.34
/_SWEXAM: J3.33
/_SWLDAD: J3.32
/_SWSINST: J3.38
/_SWSSTEP: J3.37
/_SWSTART: J3.36
/_TP1: J4.25
/_TP2: J4.26, U12.2 (A0)
/_TP3: J4.27, U12.3 (A1)
/_TP4: J4.28
/_TS1: J4.21
/_TS2: J4.22, U12.4 (A2)
/_TS3: J4.23, U12.5 (A3)
/_TS4: J4.24, U12.6 (A4)
/_brkgnti: U124.13, U167.3, U180.12 (Y6)
/_brkgnto: U158.11, U180.9 (A7)
/_brkrqst: U167.4, U180.13 (Y5)
/_clok1: U10.13 (Y5), U33.9 (Cp), U34.9 (Cp), U35.9 (Cp), U36.9 (Cp), U37.9 (Cp), U39.9 (Cp), U40.9 (Cp), U42.9 (Cp), U43.9 (Cp), U44.9 (Cp)
/_enad: U18.1 (G1), U18.19 (G2), U19.1 (G1), U19.19 (G2), U147.8
/_enwd: U13.1 (G1), U13.19 (G2), U24.1 (G1), U24.19 (G2), U149.8
/_isgranted: U4.1 (G1), U141.10
/addr_0: J6.1, U18.2 (A0), U27.15 (Q5)
/addr_1: J6.2, U18.3 (A1), U27.12 (Q4)
/addr_2: J6.3, U18.4 (A2), U27.10 (Q3)
/addr_3: J6.4, U18.5 (A3), U27.7 (Q2)
/addr_4: J6.5, U18.6 (A4), U27.5 (Q1)
/addr_5: J6.6, U18.7 (A5), U27.2 (Q0)
/addr_6: J6.7, U19.2 (A0), U26.15 (Q5)
/addr_7: J6.8, U19.3 (A1), U26.12 (Q4)
/addr_8: J6.9, U19.4 (A2), U26.10 (Q3)
/addr_9: J6.10, U19.5 (A3), U26.7 (Q2)
/addr_10: J6.11, U19.6 (A4), U26.5 (Q1)
/addr_11: J6.12, U19.7 (A5), U26.2 (Q0)
/addr_12: J6.13, U4.4 (A2), U17.15 (Q5)
/addr_13: J6.14, U4.3 (A1), U17.12 (Q4)
/addr_14: J6.15, U4.2 (A0), U17.10 (Q3)
/blkgntpass: U169.13 (~R), U174.6 (Q)
/brkcyc: U12.13 (Y5), U54.10
/brkgnti: U14.6, U54.5, U124.12, U158.13
/busini: U10.14 (Y4), U14.8, U125.5
/bwcov: U12.11 (Y7), U41.12 (D)
/caincreq: J6.18, U4.6 (A4), U17.5 (Q1)
/cycl3req: J6.17, U4.5 (A3), U17.2 (Q0)
/dorequest: U14.13, U167.5
/endofbrk: U54.1, U54.8, U149.9
/isgranted: U54.6, U54.9, U141.11, U147.9
/lfsr_0: U27.14 (D5), U37.13 (D4), U37.15 (Q5)
/lfsr_1: U27.13 (D4), U37.11 (D3), U37.12 (Q4)
/lfsr_2: U27.11 (D3), U37.6 (D2), U37.10 (Q3)
/lfsr_3: U27.6 (D2), U37.4 (D1), U37.7 (Q2)
/lfsr_4: U27.4 (D1), U37.3 (D0), U37.5 (Q1)
/lfsr_5: U27.3 (D0), U36.14 (D5), U37.2 (Q0)
/lfsr_6: U26.14 (D5), U36.13 (D4), U36.15 (Q5)
/lfsr_7: U26.13 (D4), U36.11 (D3), U36.12 (Q4)
/lfsr_8: U26.11 (D3), U36.6 (D2), U36.10 (Q3)
/lfsr_9: U26.6 (D2), U36.4 (D1), U36.7 (Q2)
/lfsr_10: U26.4 (D1), U36.3 (D0), U36.5 (Q1)
/lfsr_11: U26.3 (D0), U35.14 (D5), U36.2 (Q0)
/lfsr_12: U17.14 (D5), U35.15 (Q5), U45.5
/lfsr_13: U17.13 (D4), U35.11 (D3), U35.12 (Q4)
/lfsr_14: U17.11 (D3), U35.6 (D2), U35.10 (Q3)
/lfsr_15: U17.6 (D2), U35.4 (D1), U35.7 (Q2)
/lfsr_16: U17.4 (D1), U35.3 (D0), U35.5 (Q1)
/lfsr_17: U17.3 (D0), U34.14 (D5), U35.2 (Q0)
/lfsr_18: U16.14 (D5), U34.15 (Q5), U45.10
/lfsr_19: U16.13 (D4), U34.11 (D3), U34.12 (Q4)
/lfsr_20: U16.11 (D3), U34.6 (D2), U34.10 (Q3)
/lfsr_21: U16.6 (D2), U34.4 (D1), U34.7 (Q2)
/lfsr_22: U16.4 (D1), U34.3 (D0), U34.5 (Q1)
/lfsr_23: U16.3 (D0), U33.14 (D5), U34.2 (Q0)
/lfsr_24: U15.14 (D5), U33.15 (Q5), U45.13
/lfsr_25: U15.13 (D4), U33.11 (D3), U33.12 (Q4)
/lfsr_26: U15.11 (D3), U33.6 (D2), U33.10 (Q3)
/lfsr_27: U15.6 (D2), U33.4 (D1), U33.7 (Q2)
/lfsr_28: U15.4 (D1), U33.3 (D0), U33.5 (Q1)
/lfsr_29: U15.3 (D0), U33.2 (Q0), U44.14 (D5)
/lfsr_30: U44.13 (D4), U44.15 (Q5)
/lfsr_31: U44.11 (D3), U44.12 (Q4)
/lfsr_32: U44.6 (D2), U44.10 (Q3)
/lfsr_33: U44.4 (D1), U44.7 (Q2)
/lfsr_34: U44.3 (D0), U44.5 (Q1)
/lfsr_35: U43.14 (D5), U44.2 (Q0)
/lfsr_36: U43.13 (D4), U43.15 (Q5)
/lfsr_37: U43.11 (D3), U43.12 (Q4)
/lfsr_38: U43.6 (D2), U43.10 (Q3)
/lfsr_39: U43.4 (D1), U43.7 (Q2)
/lfsr_40: U43.3 (D0), U43.5 (Q1)
/lfsr_41: U42.14 (D5), U43.2 (Q0)
/lfsr_42: U42.13 (D4), U42.15 (Q5)
/lfsr_43: U42.11 (D3), U42.12 (Q4)
/lfsr_44: U42.6 (D2), U42.10 (Q3)
/lfsr_45: U42.4 (D1), U42.7 (Q2)
/lfsr_46: U42.3 (D0), U42.5 (Q1)
/lfsr_47: U40.14 (D5), U42.2 (Q0)
/lfsr_48: U40.13 (D4), U40.15 (Q5)
/lfsr_49: U40.11 (D3), U40.12 (Q4), U147.5
/lfsr_50: U40.6 (D2), U40.10 (Q3)
/lfsr_51: U40.4 (D1), U40.7 (Q2), U147.4
/lfsr_52: U38.12, U40.3 (D0), U40.5 (Q1)
/lfsr_53: U38.11, U39.14 (D5), U40.2 (Q0)
/lfsr_54: U38.6, U39.13 (D4), U39.15 (Q5)
/lfsr_55: U38.5, U39.11 (D3), U39.12 (Q4)
/lfsr_56: U38.4, U39.6 (D2), U39.10 (Q3)
/lfsr_57: U38.3, U39.4 (D1), U39.7 (Q2)
/lfsr_58: U38.2, U39.3 (D0), U39.5 (Q1), U45.2
/lfsr_59: U38.1, U39.2 (Q0), U45.1
/mbuf_0: U10.15 (Y3), U29.14 (D5)
/mbuf_1: U10.16 (Y2), U29.13 (D4)
/mbuf_2: U10.17 (Y1), U29.11 (D3)
/mbuf_3: U10.18 (Y0), U29.6 (D2)
/mbuf_4: U5.11 (Y7), U29.4 (D1)
/mbuf_5: U5.12 (Y6), U29.3 (D0)
/mbuf_6: U5.13 (Y5), U28.14 (D5)
/mbuf_7: U5.14 (Y4), U28.13 (D4)
/mbuf_8: U5.15 (Y3), U28.11 (D3)
/mbuf_9: U5.16 (Y2), U28.6 (D2)
/mbuf_10: U5.17 (Y1), U28.4 (D1)
/mbuf_11: U5.18 (Y0), U28.3 (D0)
/rdata_0: J5.13, U29.15 (Q5)
/rdata_1: J5.14, U29.12 (Q4)
/rdata_2: J5.15, U29.10 (Q3)
/rdata_3: J5.16, U29.7 (Q2)
/rdata_4: J5.17, U29.5 (Q1)
/rdata_5: J5.18, U29.2 (Q0)
/rdata_6: J5.19, U28.15 (Q5)
/rdata_7: J5.20, U28.12 (Q4)
/rdata_8: J5.21, U28.10 (Q3)
/rdata_9: J5.22, U28.7 (Q2)
/rdata_10: J5.23, U28.5 (Q1)
/rdata_11: J5.24, U28.2 (Q0)
/reset: U10.12 (Y6)
/rqstout: U12.8 (A6), U14.5, U15.9 (Cp), U16.9 (Cp), U17.9 (Cp), U26.9 (Cp), U27.9 (Cp), U54.4, U174.10 (Q)
/seed_0: J6.24, U45.4
/seed_1: J6.23, U45.9
/seed_2: J6.22, U45.12
/tp2: U12.18 (Y0), U54.2
/tp3: U12.17 (Y1)
/ts2: U12.16 (Y2), U149.11
/ts3: U12.15 (Y3)
/ts4: U12.14 (Y4), U147.10
/wcover: J6.16, U41.9 (Q)
/wdata_0: J5.1, U13.2 (A0), U16.15 (Q5)
/wdata_1: J5.2, U13.3 (A1), U16.12 (Q4)
/wdata_2: J5.3, U13.4 (A2), U16.10 (Q3)
/wdata_3: J5.4, U13.5 (A3), U16.7 (Q2)
/wdata_4: J5.5, U13.6 (A4), U16.5 (Q1)
/wdata_5: J5.6, U13.7 (A5), U16.2 (Q0)
/wdata_6: J5.7, U15.15 (Q5), U24.2 (A0)
/wdata_7: J5.8, U15.12 (Q4), U24.3 (A1)
/wdata_8: J5.9, U15.10 (Q3), U24.4 (A2)
/wdata_9: J5.10, U15.7 (Q2), U24.5 (A3)
/wdata_10: J5.11, U15.5 (Q1), U24.6 (A4)
/wdata_11: J5.12, U15.2 (Q0), U24.7 (A5)
/wrmemreq: J6.19, U4.7 (A5), U17.7 (Q2), U149.10
GND: J1.39, J1.40, J2.39, J2.40, J3.39, J3.40, J4.39, J4.40, U2.1, U2.2, U2.4, U2.5, U2.7 (GND), U3.3, U3.4, U3.5, U3.7 (GND), U4.8 (A6), U4.9 (A7), U4.10 (GND), U4.19 (G2), U5.1 (G1), U5.10 (GND), U5.19 (G2), U10.1 (G1), U10.9 (A7), U10.10 (GND), U10.19 (G2), U12.1 (G1), U12.10 (GND), U12.19 (G2), U13.8 (A6), U13.9 (A7), U13.10 (GND), U14.7 (GND), U15.8 (GND), U16.8 (GND), U17.8 (GND), U18.8 (A6), U18.9 (A7), U18.10 (GND), U19.8 (A6), U19.9 (A7), U19.10 (GND), U20.3, U20.7 (GND), U22.7 (GND), U24.8 (A6), U24.9 (A7), U24.10 (GND), U26.8 (GND), U27.8 (GND), U28.8 (GND), U29.8 (GND), U33.8 (GND), U34.8 (GND), U35.8 (GND), U36.8 (GND), U37.8 (GND), U38.7 (GND), U39.8 (GND), U40.8 (GND), U41.7 (GND), U42.8 (GND), U43.8 (GND), U44.8 (GND), U45.7 (GND), U54.7 (GND), U54.12, U54.13, U116.7 (GND), U118.1, U118.2, U118.4, U118.5, U118.7 (GND), U118.9, U118.10, U118.12, U118.13, U124.5, U124.7 (GND), U125.7 (GND), U141.7 (GND), U147.7 (GND), U149.7 (GND), U155.1, U155.2, U155.4, U155.5, U155.7 (GND), U155.9, U155.10, U155.12, U155.13, U157.7 (GND), U158.7 (GND), U161.7 (GND), U163.7 (GND), U167.1, U167.2, U167.7 (GND), U167.13, U169.7 (GND), U174.8 (GND), U180.1 (G1), U180.10 (GND), U180.19 (G2)
unnamed: U14.11, U38.8
unnamed: U14.12, U147.6
unnamed: U20.13, U45.3
unnamed: U14.9, U28.9 (Cp), U29.9 (Cp), U41.11 (C), U54.3
unnamed: U33.13 (D4), U45.11
unnamed: U34.13 (D4), U45.8
unnamed: U35.13 (D4), U45.6
unnamed: U20.12, U37.14 (D5)
unnamed: U14.4, U169.11 (C)
unnamed: U169.8 (~Q), U174.1 (~R)
unnamed: U125.6, U169.10 (~S)
unnamed: U167.6, U174.4 (C), U174.12 (C)
unnamed: U158.12, U174.7 (~Q)
unnamed: U14.10, U174.15 (~R)
VCC: J1.1, J1.2, J2.1, J2.2, J3.1, J3.2, J4.1, J4.2, U2.14 (VCC), U3.14 (VCC), U4.20 (VCC), U5.20 (VCC), U10.20 (VCC), U12.20 (VCC), U13.20 (VCC), U14.14 (VCC), U15.1 (~Mr), U15.16 (VCC), U16.1 (~Mr), U16.16 (VCC), U17.1 (~Mr), U17.16 (VCC), U18.20 (VCC), U19.20 (VCC), U20.14 (VCC), U22.14 (VCC), U24.20 (VCC), U26.1 (~Mr), U26.16 (VCC), U27.1 (~Mr), U27.16 (VCC), U28.1 (~Mr), U28.16 (VCC), U29.1 (~Mr), U29.16 (VCC), U33.1 (~Mr), U33.16 (VCC), U34.1 (~Mr), U34.16 (VCC), U35.1 (~Mr), U35.16 (VCC), U36.1 (~Mr), U36.16 (VCC), U37.1 (~Mr), U37.16 (VCC), U38.14 (VCC), U39.1 (~Mr), U39.16 (VCC), U40.1 (~Mr), U40.16 (VCC), U41.10 (~S), U41.13 (~R), U41.14 (VCC), U42.1 (~Mr), U42.16 (VCC), U43.1 (~Mr), U43.16 (VCC), U44.1 (~Mr), U44.16 (VCC), U45.14 (VCC), U54.14 (VCC), U116.14 (VCC), U118.14 (VCC), U124.14 (VCC), U125.14 (VCC), U141.14 (VCC), U147.14 (VCC), U149.14 (VCC), U155.14 (VCC), U157.14 (VCC), U158.14 (VCC), U161.14 (VCC), U163.14 (VCC), U167.14 (VCC), U169.12 (D), U169.14 (VCC), U174.2 (J), U174.3 (~K), U174.5 (~S), U174.11 (~S), U174.13 (~K), U174.14 (J), U174.16 (VCC), U180.20 (VCC)

Notes on the sheet:
resume passing grant along when * we have dropped our request and * we are no longer receiving grant from next inner dma
end of our break cycle = our break request has been granted and processor is doing a break cycle
our break request has been granted
stop requesting break when getting TP2 pulse of a BREAK cycle that we have been granted
start requesting break when * no break is being granted * no break is being requested * this circuit wants to do a break also start blocking outgoing break grant
pass brkgnti on to brkgnto unless we are requesting a break we don't start requesting a break when a grant is already in progress

Board: 2 copper layers, 56 parts (0 on the bottom side), 196 nets, no tracks yet.
