mrieker/pdp8i/kicads/zturn/zturn.kicad_pcb

## KiCad design kicads/zturn/zturn.kicad_pcb (2026-08-03)

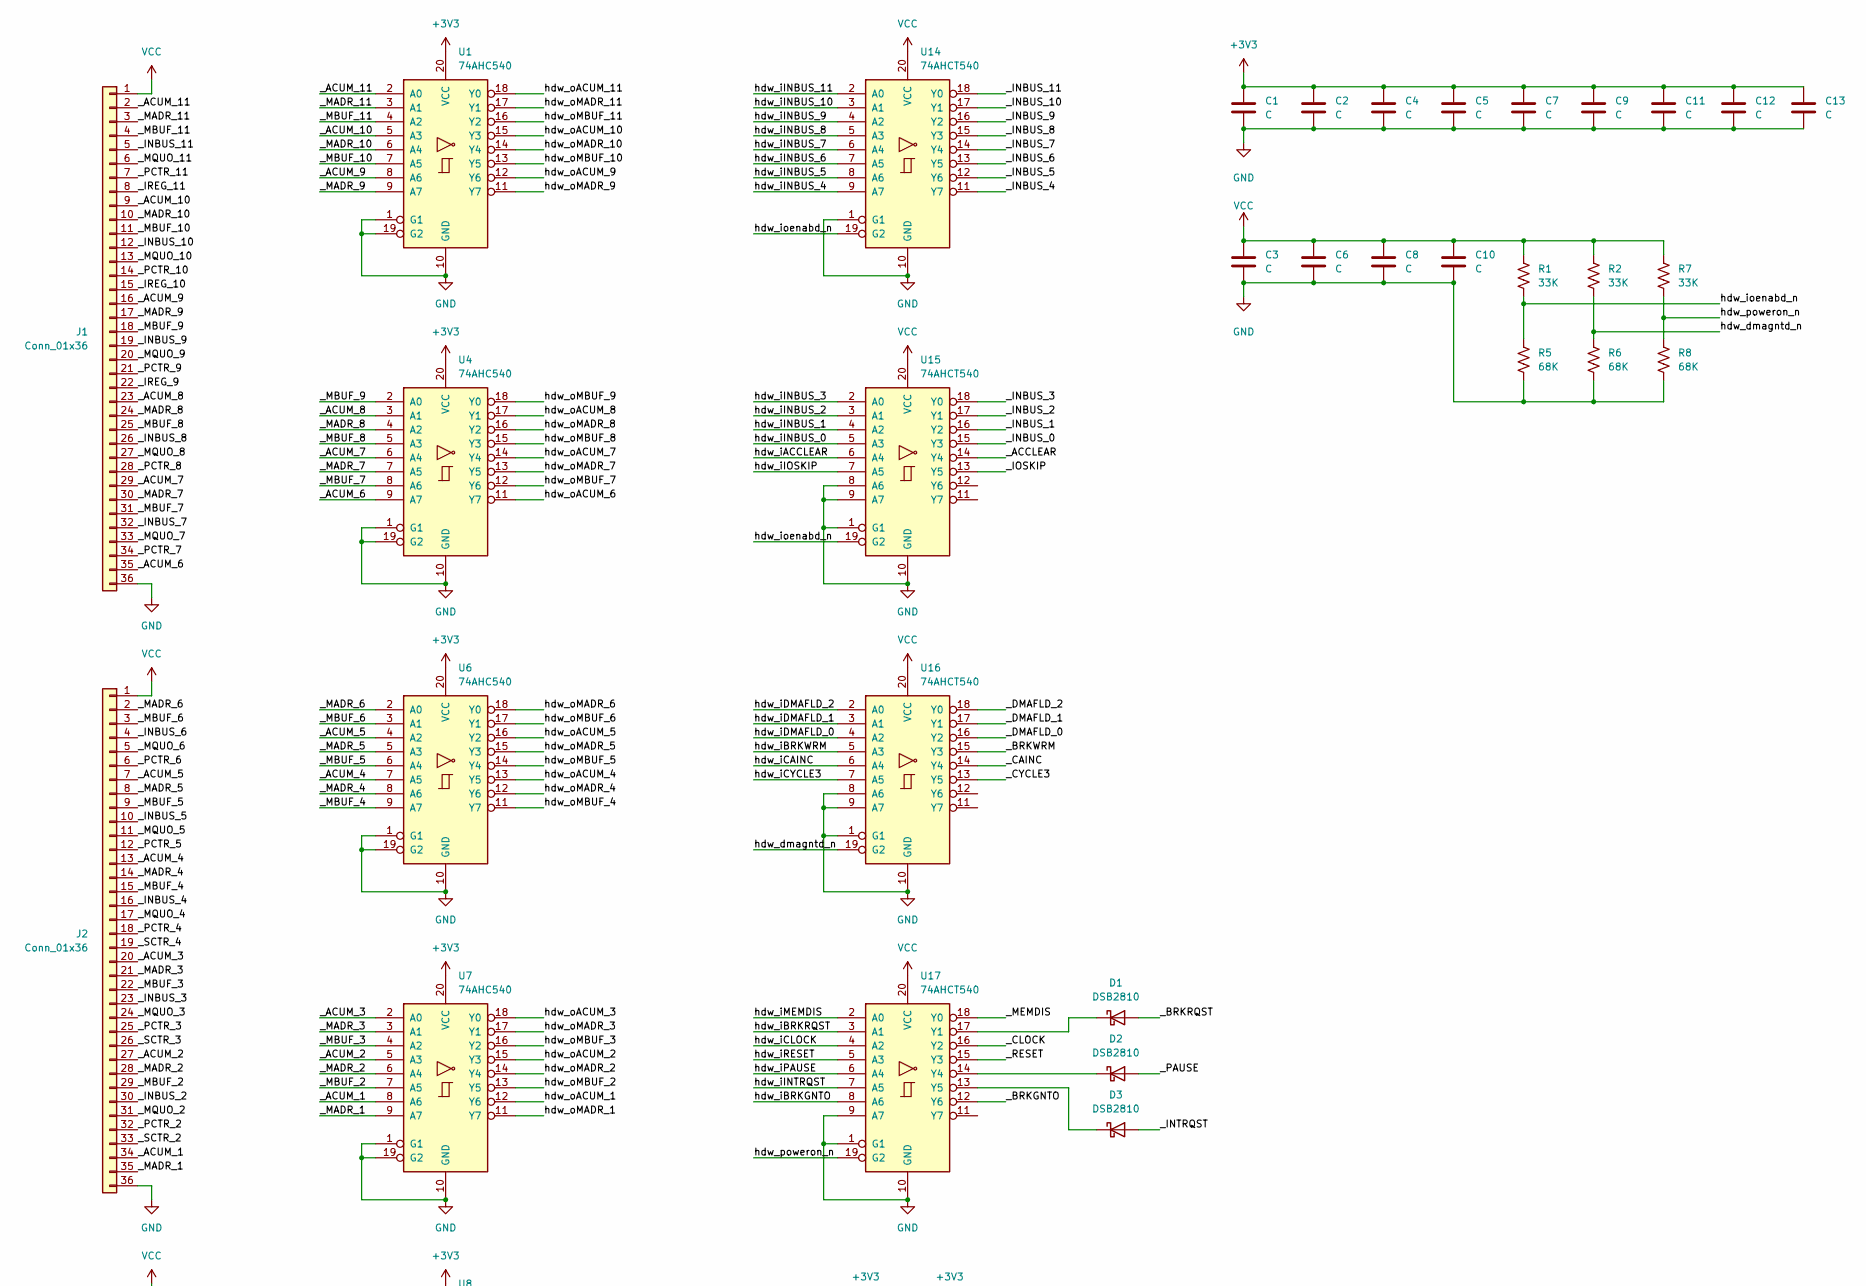
[picture p24: schematic zturn.kicad_sch, part in row 1, column 1]

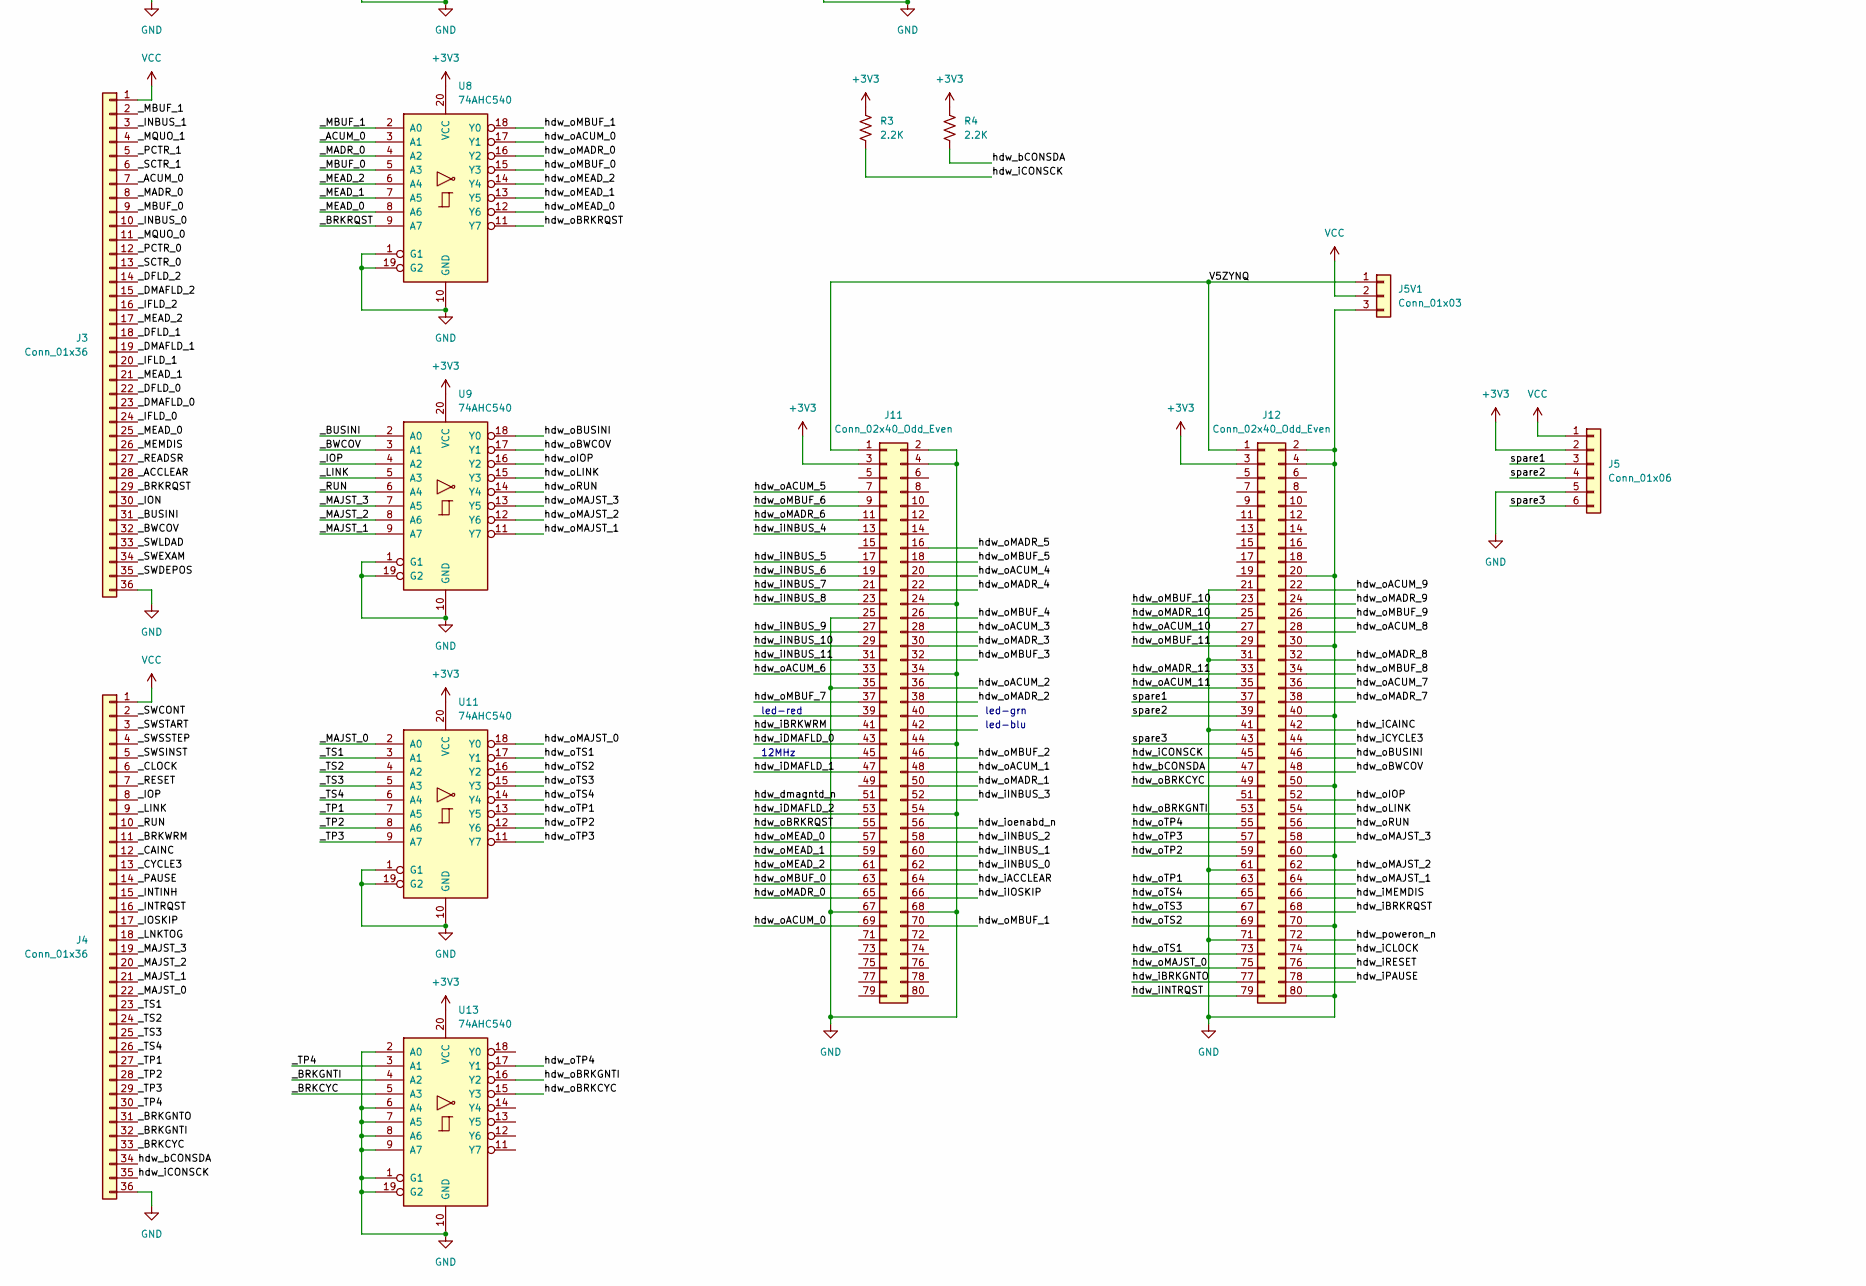
[picture p25: schematic zturn.kicad_sch, part in row 2, column 1]

Parts:
C1, C2, C3, C4, C5, C6, C7, C8, C9, C10, C11, C12, C13: C; R_Axial_DIN0207_L6.3mm_D2.5mm_P7.62mm_Horizontal
D1, D2, D3: DSB2810; D_DO-35_SOD27_P7.62mm_Horizontal
J1, J2, J3, J4: Conn_01x36; PinHeader_1x36_P2.54mm_Vertical
J5: Conn_01x06; PinHeader_1x06_P2.54mm_Vertical
J5V1: Conn_01x03; PinHeader_1x03_P2.54mm_Horizontal
J11, J12: Conn_02x40_Odd_Even; PinHeader_2x40_P1.27mm_Vertical
R1, R2, R7: 33K; R_Axial_DIN0207_L6.3mm_D2.5mm_P7.62mm_Horizontal
R3, R4: 2.2K; R_Axial_DIN0207_L6.3mm_D2.5mm_P7.62mm_Horizontal
R5, R6, R8: 68K; R_Axial_DIN0207_L6.3mm_D2.5mm_P7.62mm_Horizontal
U1, U4, U6, U7, U8, U9, U11, U13: 74AHC540; DIP-20_W7.62mm
U14, U15, U16, U17: 74AHCT540; DIP-20_W7.62mm

Connections:
+3V3: C1.1, C2.1, C4.1, C5.1, C7.1, C9.1, C11.1, C12.1, C13.1, J5.2, J11.3, J12.3, R3.1, R4.1, U1.20 (VCC), U4.20 (VCC), U6.20 (VCC), U7.20 (VCC), U8.20 (VCC), U9.20 (VCC), U11.20 (VCC), U13.20 (VCC)
/V5ZYNQ: J5V1.1, J11.1, J12.1
/_ACCLEAR: J3.28, U15.14 (Y4)
/_ACUM_0: J3.7, U8.3 (A1)
/_ACUM_1: J2.34, U7.8 (A6)
/_ACUM_2: J2.27, U7.5 (A3)
/_ACUM_3: J2.20, U7.2 (A0)
/_ACUM_4: J2.13, U6.7 (A5)
/_ACUM_5: J2.7, U6.4 (A2)
/_ACUM_6: J1.35, U4.9 (A7)
/_ACUM_7: J1.29, U4.6 (A4)
/_ACUM_8: J1.23, U4.3 (A1)
/_ACUM_9: J1.16, U1.8 (A6)
/_ACUM_10: J1.9, U1.5 (A3)
/_ACUM_11: J1.2, U1.2 (A0)
/_BRKCYC: J4.33, U13.5 (A3)
/_BRKGNTI: J4.32, U13.4 (A2)
/_BRKGNTO: J4.31, U17.12 (Y6)
/_BRKRQST: D1.2 (A), J3.29, U8.9 (A7)
/_BRKWRM: J4.11, U16.15 (Y3)
/_BUSINI: J3.31, U9.2 (A0)
/_BWCOV: J3.32, U9.3 (A1)
/_CAINC: J4.12, U16.14 (Y4)
/_CLOCK: J4.6, U17.16 (Y2)
/_CYCLE3: J4.13, U16.13 (Y5)
/_DFLD_0: J3.22
/_DFLD_1: J3.18
/_DFLD_2: J3.14
/_DMAFLD_0: J3.23, U16.16 (Y2)
/_DMAFLD_1: J3.19, U16.17 (Y1)
/_DMAFLD_2: J3.15, U16.18 (Y0)
/_IFLD_0: J3.24
/_IFLD_1: J3.20
/_IFLD_2: J3.16
/_INBUS_0: J3.10, U15.15 (Y3)
/_INBUS_1: J3.3, U15.16 (Y2)
/_INBUS_2: J2.30, U15.17 (Y1)
/_INBUS_3: J2.23, U15.18 (Y0)
/_INBUS_4: J2.16, U14.11 (Y7)
/_INBUS_5: J2.10, U14.12 (Y6)
/_INBUS_6: J2.4, U14.13 (Y5)
/_INBUS_7: J1.32, U14.14 (Y4)
/_INBUS_8: J1.26, U14.15 (Y3)
/_INBUS_9: J1.19, U14.16 (Y2)
/_INBUS_10: J1.12, U14.17 (Y1)
/_INBUS_11: J1.5, U14.18 (Y0)
/_INTINH: J4.15
/_INTRQST: D3.2 (A), J4.16
/_ION: J3.30
/_IOP: J4.8, U9.4 (A2)
/_IOSKIP: J4.17, U15.13 (Y5)
/_IREG_9: J1.22
/_IREG_10: J1.15
/_IREG_11: J1.8
/_LINK: J4.9, U9.5 (A3)
/_LNKTOG: J4.18
/_MADR_0: J3.8, U8.4 (A2)
/_MADR_1: J2.35, U7.9 (A7)
/_MADR_2: J2.28, U7.6 (A4)
/_MADR_3: J2.21, U7.3 (A1)
/_MADR_4: J2.14, U6.8 (A6)
/_MADR_5: J2.8, U6.5 (A3)
/_MADR_6: J2.2, U6.2 (A0)
/_MADR_7: J1.30, U4.7 (A5)
/_MADR_8: J1.24, U4.4 (A2)
/_MADR_9: J1.17, U1.9 (A7)
/_MADR_10: J1.10, U1.6 (A4)
/_MADR_11: J1.3, U1.3 (A1)
/_MAJST_0: J4.22, U11.2 (A0)
/_MAJST_1: J4.21, U9.9 (A7)
/_MAJST_2: J4.20, U9.8 (A6)
/_MAJST_3: J4.19, U9.7 (A5)
/_MBUF_0: J3.9, U8.5 (A3)
/_MBUF_1: J3.2, U8.2 (A0)
/_MBUF_2: J2.29, U7.7 (A5)
/_MBUF_3: J2.22, U7.4 (A2)
/_MBUF_4: J2.15, U6.9 (A7)
/_MBUF_5: J2.9, U6.6 (A4)
/_MBUF_6: J2.3, U6.3 (A1)
/_MBUF_7: J1.31, U4.8 (A6)
/_MBUF_8: J1.25, U4.5 (A3)
/_MBUF_9: J1.18, U4.2 (A0)
/_MBUF_10: J1.11, U1.7 (A5)
/_MBUF_11: J1.4, U1.4 (A2)
/_MEAD_0: J3.25, U8.8 (A6)
/_MEAD_1: J3.21, U8.7 (A5)
/_MEAD_2: J3.17, U8.6 (A4)
/_MEMDIS: J3.26, U17.18 (Y0)
/_MQUO_0: J3.11
/_MQUO_1: J3.4
/_MQUO_2: J2.31
/_MQUO_3: J2.24
/_MQUO_4: J2.17
/_MQUO_5: J2.11
/_MQUO_6: J2.5
/_MQUO_7: J1.33
/_MQUO_8: J1.27
/_MQUO_9: J1.20
/_MQUO_10: J1.13
/_MQUO_11: J1.6
/_PAUSE: D2.2 (A), J4.14
/_PCTR_0: J3.12
/_PCTR_1: J3.5
/_PCTR_2: J2.32
/_PCTR_3: J2.25
/_PCTR_4: J2.18
/_PCTR_5: J2.12
/_PCTR_6: J2.6
/_PCTR_7: J1.34
/_PCTR_8: J1.28
/_PCTR_9: J1.21
/_PCTR_10: J1.14
/_PCTR_11: J1.7
/_READSR: J3.27
/_RESET: J4.7, U17.15 (Y3)
/_RUN: J4.10, U9.6 (A4)
/_SCTR_0: J3.13
/_SCTR_1: J3.6
/_SCTR_2: J2.33
/_SCTR_3: J2.26
/_SCTR_4: J2.19
/_SWCONT: J4.2
/_SWDEPOS: J3.35
/_SWEXAM: J3.34
/_SWLDAD: J3.33
/_SWSINST: J4.5
/_SWSSTEP: J4.4
/_SWSTART: J4.3
/_TP1: J4.27, U11.7 (A5)
/_TP2: J4.28, U11.8 (A6)
/_TP3: J4.29, U11.9 (A7)
/_TP4: J4.30, U13.3 (A1)
/_TS1: J4.23, U11.3 (A1)
/_TS2: J4.24, U11.4 (A2)
/_TS3: J4.25, U11.5 (A3)
/_TS4: J4.26, U11.6 (A4)
/hdw_bCONSDA: J4.34, J12.47, R4.2
/hdw_dmagntd_n: J11.51, R2.2, R6.2, U16.19 (G2)
/hdw_iACCLEAR: J11.64, U15.6 (A4)
/hdw_iBRKGNTO: J12.77, U17.8 (A6)
/hdw_iBRKRQST: J12.68, U17.3 (A1)
/hdw_iBRKWRM: J11.41, U16.5 (A3)
/hdw_iCAINC: J12.42, U16.6 (A4)
/hdw_iCLOCK: J12.74, U17.4 (A2)
/hdw_iCONSCK: J4.35, J12.45, R3.2
/hdw_iCYCLE3: J12.44, U16.7 (A5)
/hdw_iDMAFLD_0: J11.43, U16.4 (A2)
/hdw_iDMAFLD_1: J11.47, U16.3 (A1)
/hdw_iDMAFLD_2: J11.53, U16.2 (A0)
/hdw_iINBUS_0: J11.62, U15.5 (A3)
/hdw_iINBUS_1: J11.60, U15.4 (A2)
/hdw_iINBUS_2: J11.58, U15.3 (A1)
/hdw_iINBUS_3: J11.52, U15.2 (A0)
/hdw_iINBUS_4: J11.13, U14.9 (A7)
/hdw_iINBUS_5: J11.17, U14.8 (A6)
/hdw_iINBUS_6: J11.19, U14.7 (A5)
/hdw_iINBUS_7: J11.21, U14.6 (A4)
/hdw_iINBUS_8: J11.23, U14.5 (A3)
/hdw_iINBUS_9: J11.27, U14.4 (A2)
/hdw_iINBUS_10: J11.29, U14.3 (A1)
/hdw_iINBUS_11: J11.31, U14.2 (A0)
/hdw_iINTRQST: J12.79, U17.7 (A5)
/hdw_iIOSKIP: J11.66, U15.7 (A5)
/hdw_iMEMDIS: J12.66, U17.2 (A0)
/hdw_iPAUSE: J12.78, U17.6 (A4)
/hdw_iRESET: J12.76, U17.5 (A3)
/hdw_ioenabd_n: J11.56, R1.2, R5.2, U14.19 (G2), U15.19 (G2)
/hdw_oACUM_0: J11.69, U8.17 (Y1)
/hdw_oACUM_1: J11.48, U7.12 (Y6)
/hdw_oACUM_2: J11.36, U7.15 (Y3)
/hdw_oACUM_3: J11.28, U7.18 (Y0)
/hdw_oACUM_4: J11.20, U6.13 (Y5)
/hdw_oACUM_5: J11.7, U6.16 (Y2)
/hdw_oACUM_6: J11.33, U4.11 (Y7)
/hdw_oACUM_7: J12.36, U4.14 (Y4)
/hdw_oACUM_8: J12.28, U4.17 (Y1)
/hdw_oACUM_9: J12.22, U1.12 (Y6)
/hdw_oACUM_10: J12.27, U1.15 (Y3)
/hdw_oACUM_11: J12.35, U1.18 (Y0)
/hdw_oBRKCYC: J12.49, U13.15 (Y3)
/hdw_oBRKGNTI: J12.53, U13.16 (Y2)
/hdw_oBRKRQST: J11.55, U8.11 (Y7)
/hdw_oBUSINI: J12.46, U9.18 (Y0)
/hdw_oBWCOV: J12.48, U9.17 (Y1)
/hdw_oIOP: J12.52, U9.16 (Y2)
/hdw_oLINK: J12.54, U9.15 (Y3)
/hdw_oMADR_0: J11.65, U8.16 (Y2)
/hdw_oMADR_1: J11.50, U7.11 (Y7)
/hdw_oMADR_2: J11.38, U7.14 (Y4)
/hdw_oMADR_3: J11.30, U7.17 (Y1)
/hdw_oMADR_4: J11.22, U6.12 (Y6)
/hdw_oMADR_5: J11.16, U6.15 (Y3)
/hdw_oMADR_6: J11.11, U6.18 (Y0)
/hdw_oMADR_7: J12.38, U4.13 (Y5)
/hdw_oMADR_8: J12.32, U4.16 (Y2)
/hdw_oMADR_9: J12.24, U1.11 (Y7)
/hdw_oMADR_10: J12.25, U1.14 (Y4)
/hdw_oMADR_11: J12.33, U1.17 (Y1)
/hdw_oMAJST_0: J12.75, U11.18 (Y0)
/hdw_oMAJST_1: J12.64, U9.11 (Y7)
/hdw_oMAJST_2: J12.62, U9.12 (Y6)
/hdw_oMAJST_3: J12.58, U9.13 (Y5)
/hdw_oMBUF_0: J11.63, U8.15 (Y3)
/hdw_oMBUF_1: J11.70, U8.18 (Y0)
/hdw_oMBUF_2: J11.46, U7.13 (Y5)
/hdw_oMBUF_3: J11.32, U7.16 (Y2)
/hdw_oMBUF_4: J11.26, U6.11 (Y7)
/hdw_oMBUF_5: J11.18, U6.14 (Y4)
/hdw_oMBUF_6: J11.9, U6.17 (Y1)
/hdw_oMBUF_7: J11.37, U4.12 (Y6)
/hdw_oMBUF_8: J12.34, U4.15 (Y3)
/hdw_oMBUF_9: J12.26, U4.18 (Y0)
/hdw_oMBUF_10: J12.23, U1.13 (Y5)
/hdw_oMBUF_11: J12.29, U1.16 (Y2)
/hdw_oMEAD_0: J11.57, U8.12 (Y6)
/hdw_oMEAD_1: J11.59, U8.13 (Y5)
/hdw_oMEAD_2: J11.61, U8.14 (Y4)
/hdw_oRUN: J12.56, U9.14 (Y4)
/hdw_oTP1: J12.63, U11.13 (Y5)
/hdw_oTP2: J12.59, U11.12 (Y6)
/hdw_oTP3: J12.57, U11.11 (Y7)
/hdw_oTP4: J12.55, U13.17 (Y1)
/hdw_oTS1: J12.73, U11.17 (Y1)
/hdw_oTS2: J12.69, U11.16 (Y2)
/hdw_oTS3: J12.67, U11.15 (Y3)
/hdw_oTS4: J12.65, U11.14 (Y4)
/hdw_poweron_n: J12.72, R7.2, R8.2, U17.19 (G2)
/spare1: J5.3, J12.37
/spare2: J5.4, J12.39
/spare3: J5.6, J12.43
GND: C1.2, C2.2, C3.2, C4.2, C5.2, C6.2, C7.2, C8.2, C9.2, C10.2, C11.2, C12.2, C13.2, J1.36, J2.36, J3.36, J4.36, J5.5, J5V1.3, J11.2, J11.4, J11.24, J11.25, J11.34, J11.35, J11.44, J11.54, J11.67, J11.68, J12.2, J12.4, J12.20, J12.21, J12.30, J12.31, J12.40, J12.41, J12.50, J12.60, J12.61, J12.70, J12.71, J12.80, R5.1, R6.1, R8.1, U1.1 (G1), U1.10 (GND), U1.19 (G2), U4.1 (G1), U4.10 (GND), U4.19 (G2), U6.1 (G1), U6.10 (GND), U6.19 (G2), U7.1 (G1), U7.10 (GND), U7.19 (G2), U8.1 (G1), U8.10 (GND), U8.19 (G2), U9.1 (G1), U9.10 (GND), U9.19 (G2), U11.1 (G1), U11.10 (GND), U11.19 (G2), U13.1 (G1), U13.2 (A0), U13.6 (A4), U13.7 (A5), U13.8 (A6), U13.9 (A7), U13.10 (GND), U13.19 (G2), U14.1 (G1), U14.10 (GND), U15.1 (G1), U15.8 (A6), U15.9 (A7), U15.10 (GND), U16.1 (G1), U16.8 (A6), U16.9 (A7), U16.10 (GND), U17.1 (G1), U17.9 (A7), U17.10 (GND)
unnamed: D1.1 (K), U17.17 (Y1)
unnamed: D2.1 (K), U17.14 (Y4)
unnamed: D3.1 (K), U17.13 (Y5)
VCC: C3.1, C6.1, C8.1, C10.1, J1.1, J2.1, J3.1, J4.1, J5.1, J5V1.2, R1.1, R2.1, R7.1, U14.20 (VCC), U15.20 (VCC), U16.20 (VCC), U17.20 (VCC)

Notes on the sheet:
led-red
led-blu
12MHz
led-grn

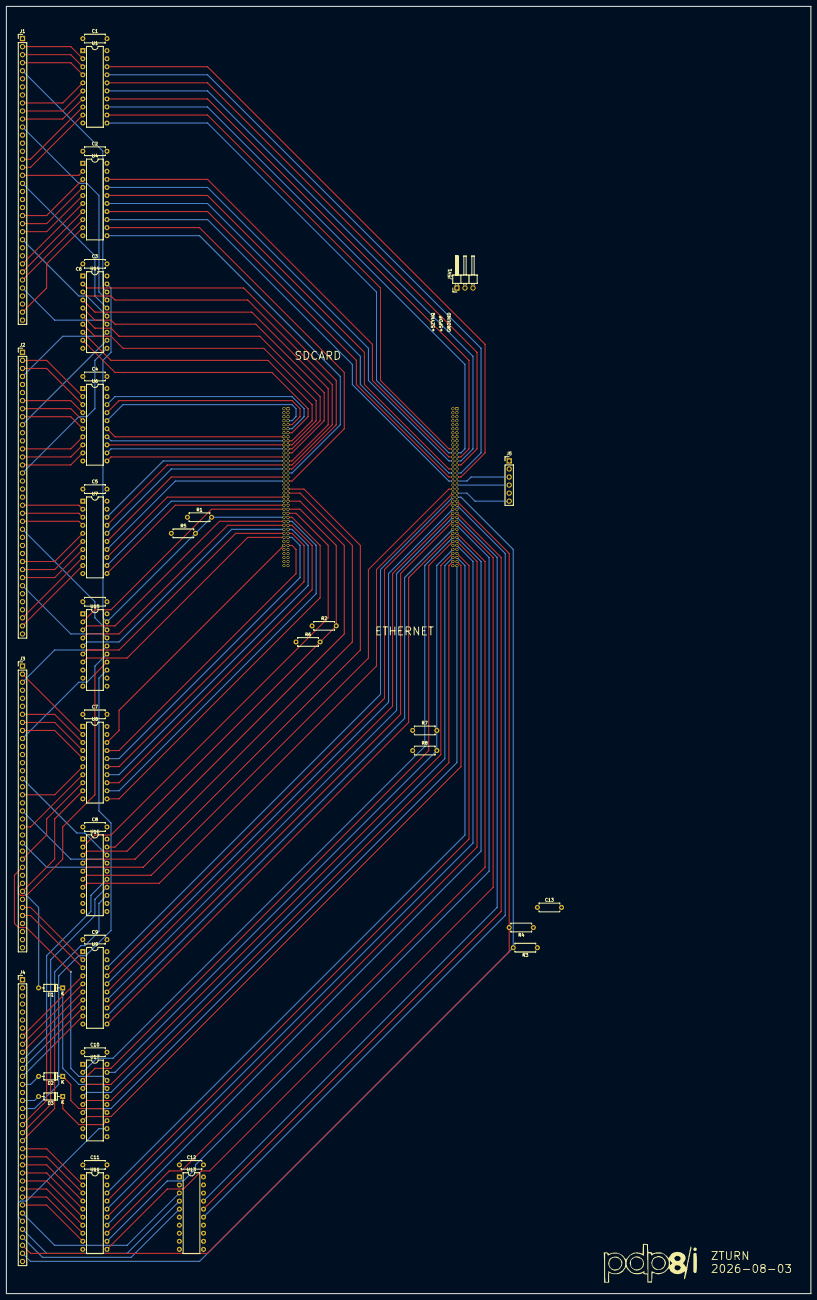
[picture p26: board zturn.kicad_pcb from above]

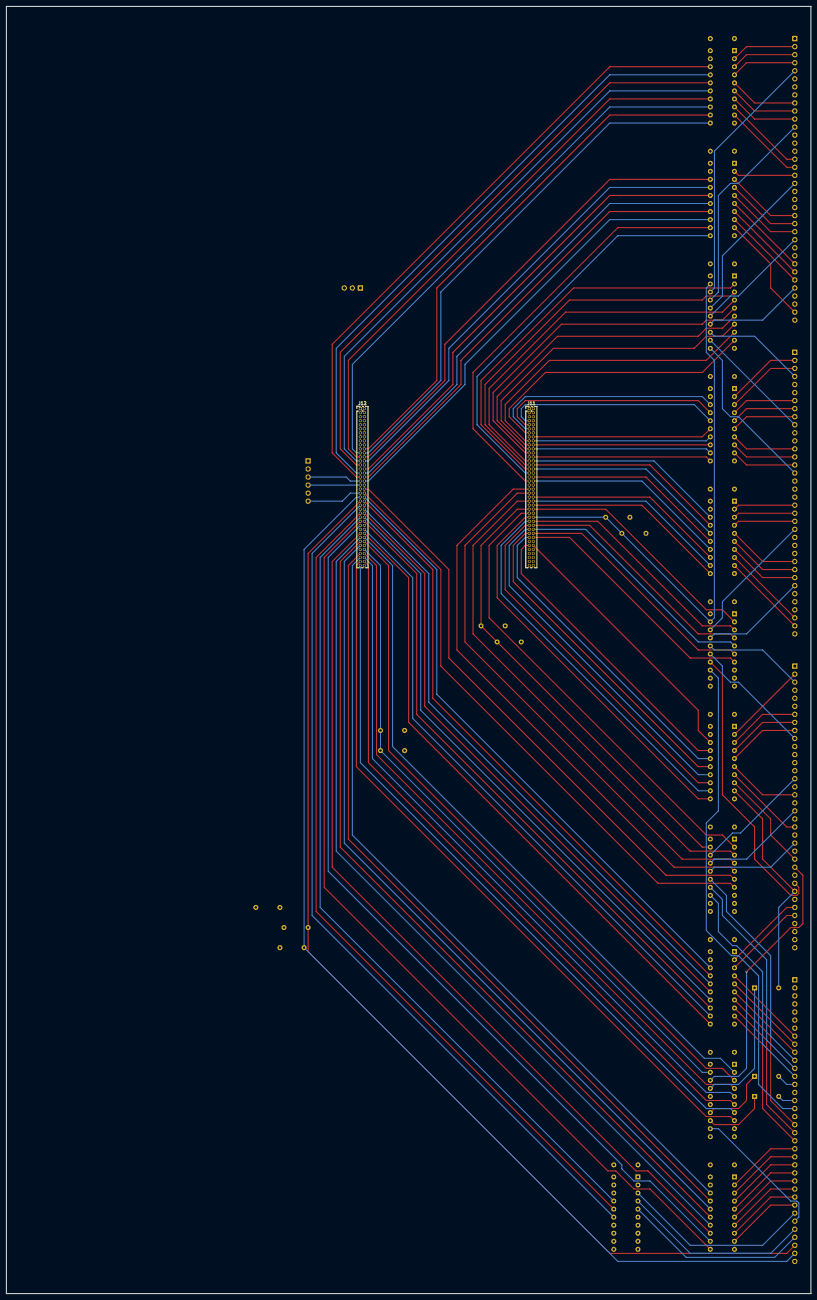
[picture p27: board zturn.kicad_pcb from below]

Board: 4 copper layers, 254.0 x 406.4 mm, 44 parts (2 on the bottom side), 186 nets.
