mrieker/pdp8i/kicads/tester/tester.kicad_pcb

## KiCad design kicads/tester/tester.kicad_pcb (2026-07-27)

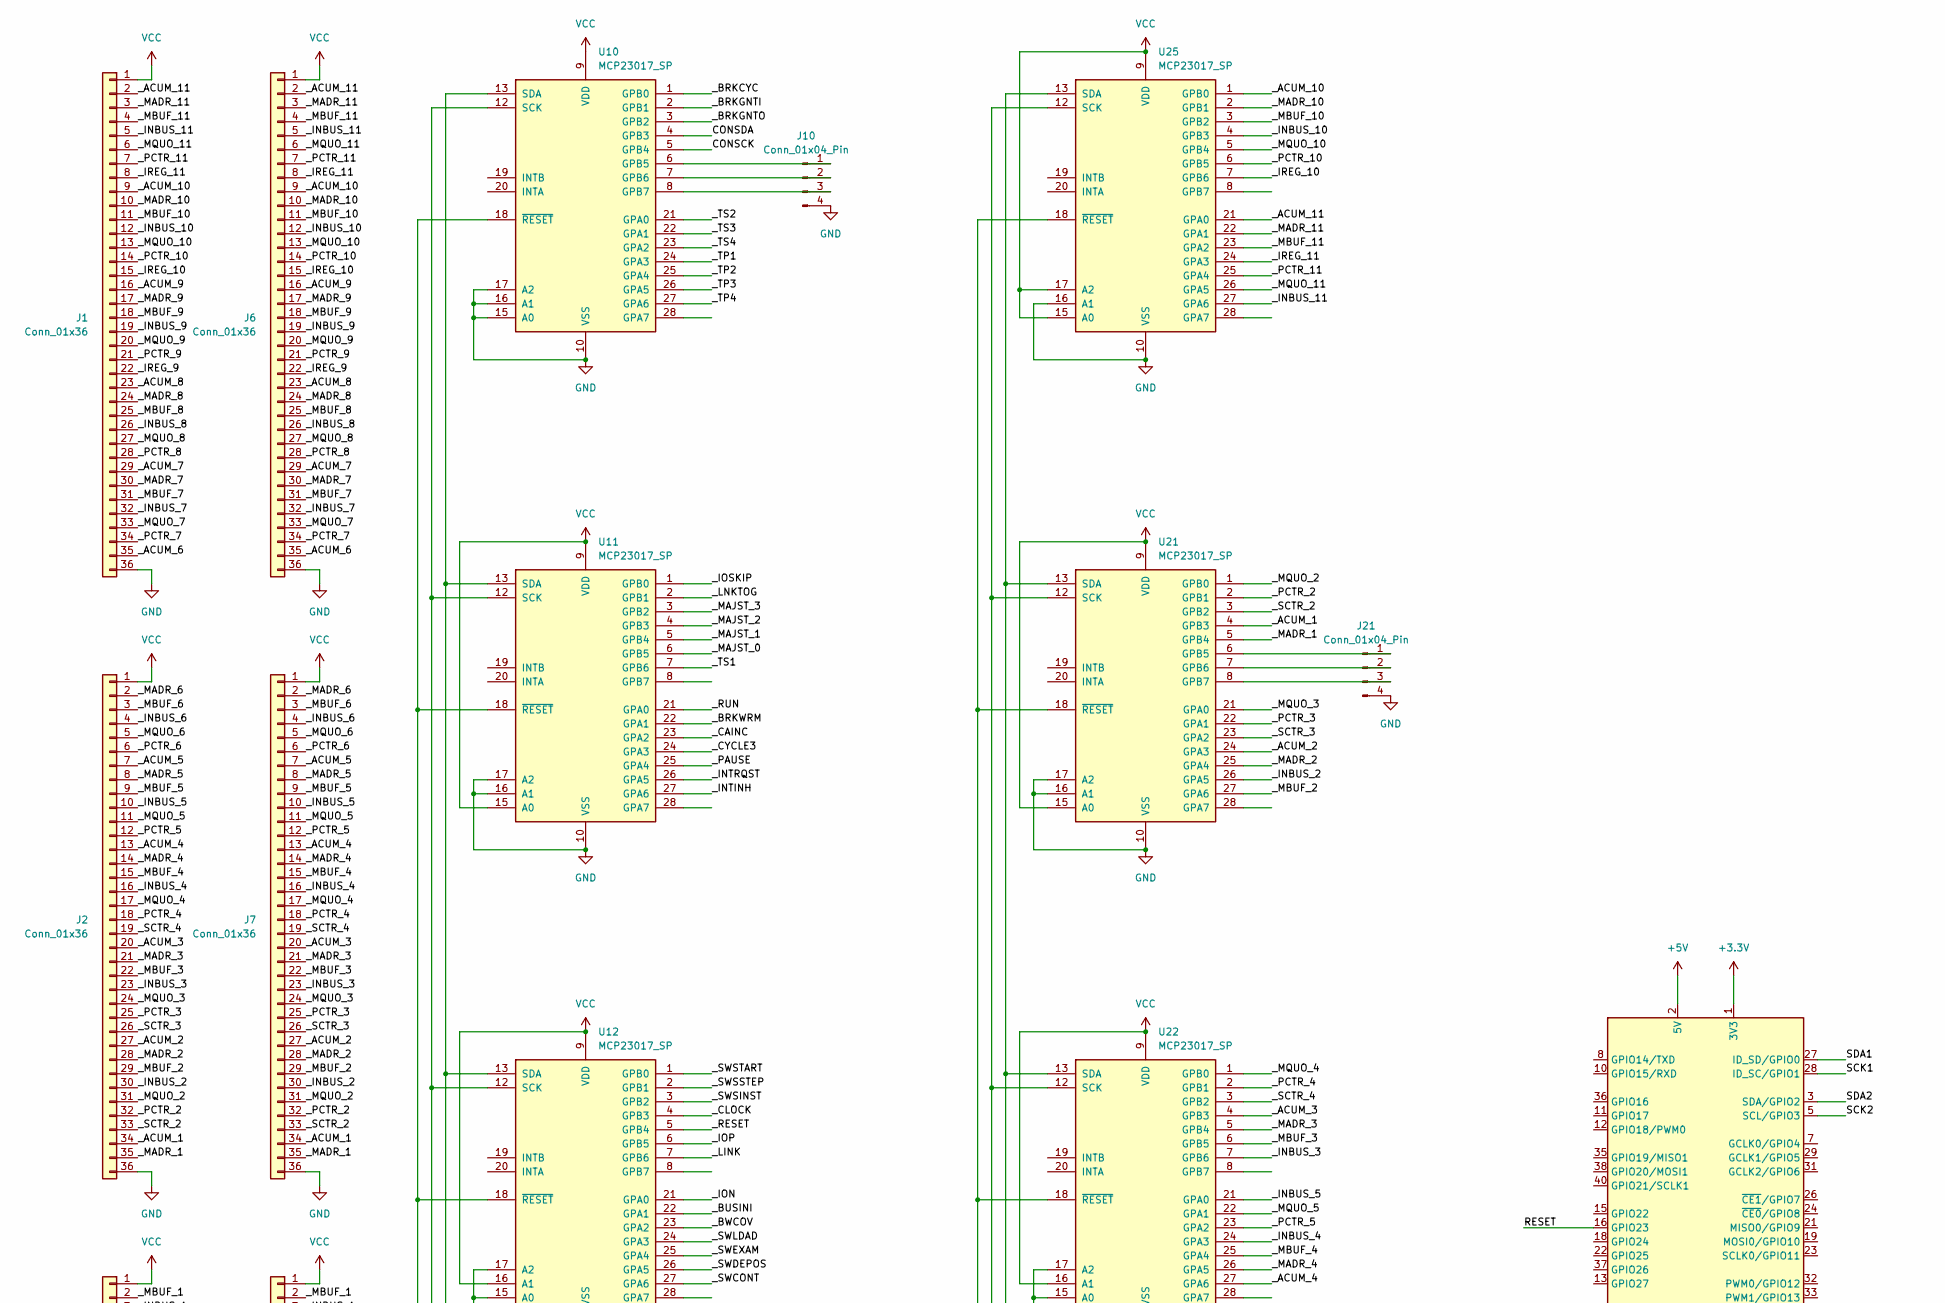
[picture p28: schematic tester.kicad_sch, part in row 1, column 1]

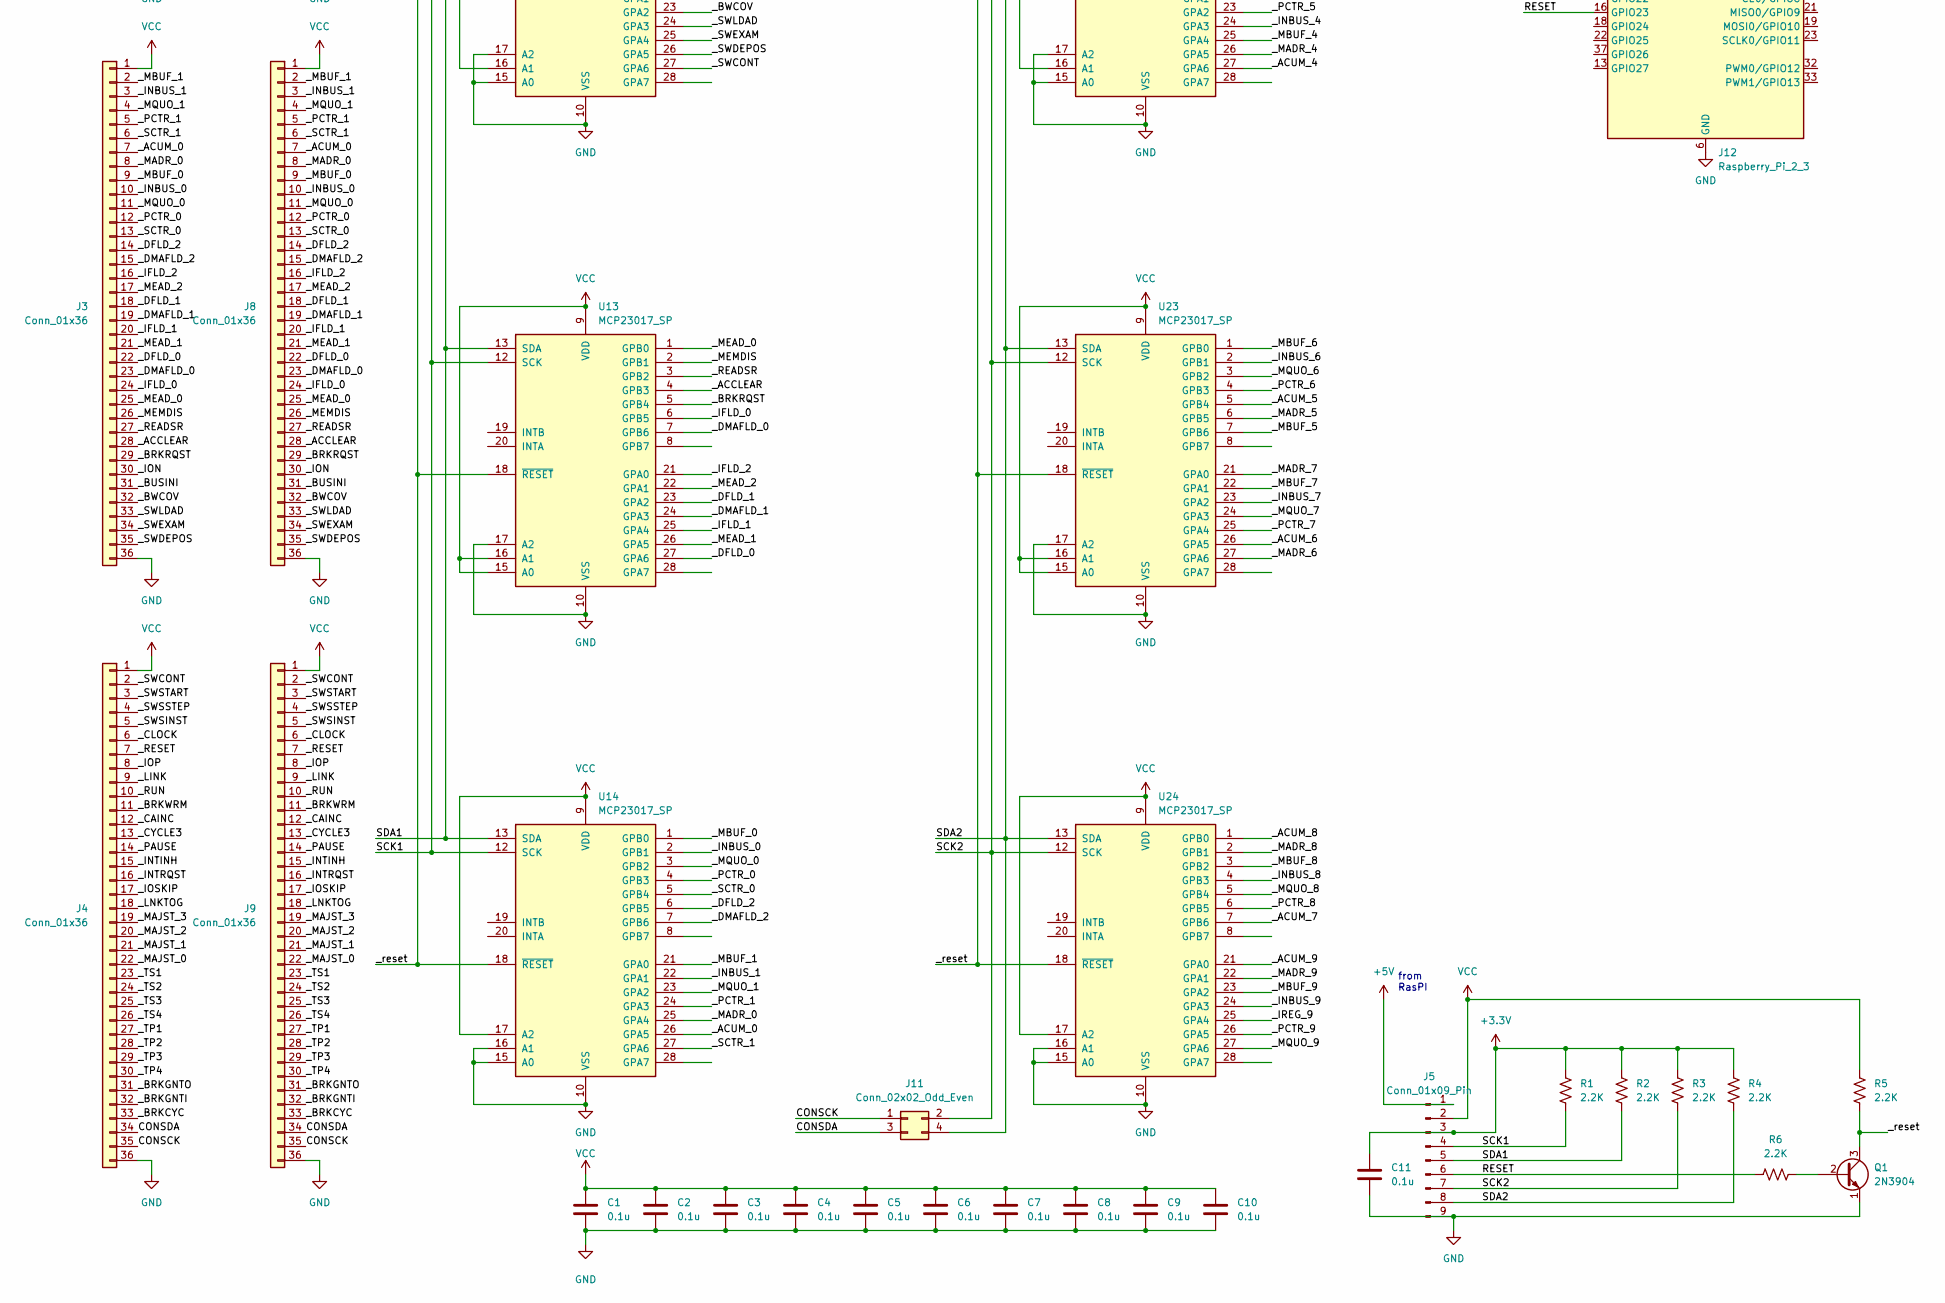
[picture p29: schematic tester.kicad_sch, part in row 2, column 1]

Parts:
C1, C2, C3, C4, C5, C6, C7, C8, C9, C10, C11: 0.1u; R_Axial_DIN0207_L6.3mm_D2.5mm_P7.62mm_Horizontal
J1, J2, J3, J4, J6, J7, J8, J9: Conn_01x36; PinHeader_1x36_P2.54mm_Vertical
J5: Conn_01x09_Pin; PinHeader_1x09_P2.54mm_Vertical
J10, J21: Conn_01x04_Pin; PinHeader_1x04_P2.54mm_Vertical
J11: Conn_02x02_Odd_Even; PinHeader_2x02_P2.54mm_Vertical
J12: Raspberry_Pi_2_3; PinHeader_2x20_P2.54mm_Vertical
Q1: 2N3904; TO-92_Wide
R1, R2, R3, R4, R5, R6: 2.2K; R_Axial_DIN0204_L3.6mm_D1.6mm_P7.62mm_Horizontal
U10, U11, U12, U13, U14, U21, U22, U23, U24, U25: MCP23017_SP; DIP-28_W7.62mm

Connections:
+3.3V: C11.1, J5.3, J12.1 (3V3), J12.17 (3V3), R1.1, R2.1, R3.1, R4.1
+5V: J5.1, J12.2 (5V), J12.4 (5V)
/CONSCK: J4.35, J9.35, J11.1, U10.5 (GPB4)
/CONSDA: J4.34, J9.34, J11.3, U10.4 (GPB3)
/RESET: J5.6, J12.16 (GPIO23), R6.1
/SCK1: J5.4, J12.28 (ID_SC/GPIO1), R1.2, U10.12 (SCK), U11.12 (SCK), U12.12 (SCK), U13.12 (SCK), U14.12 (SCK)
/SCK2: J5.7, J11.2, J12.5 (SCL/GPIO3), R3.2, U21.12 (SCK), U22.12 (SCK), U23.12 (SCK), U24.12 (SCK), U25.12 (SCK)
/SDA1: J5.5, J12.27 (ID_SD/GPIO0), R2.2, U10.13 (SDA), U11.13 (SDA), U12.13 (SDA), U13.13 (SDA), U14.13 (SDA)
/SDA2: J5.8, J11.4, J12.3 (SDA/GPIO2), R4.2, U21.13 (SDA), U22.13 (SDA), U23.13 (SDA), U24.13 (SDA), U25.13 (SDA)
/_ACCLEAR: J3.28, J8.28, U13.4 (GPB3)
/_ACUM_0: J3.7, J8.7, U14.26 (GPA5)
/_ACUM_1: J2.34, J7.34, U21.4 (GPB3)
/_ACUM_2: J2.27, J7.27, U21.24 (GPA3)
/_ACUM_3: J2.20, J7.20, U22.4 (GPB3)
/_ACUM_4: J2.13, J7.13, U22.27 (GPA6)
/_ACUM_5: J2.7, J7.7, U23.5 (GPB4)
/_ACUM_6: J1.35, J6.35, U23.26 (GPA5)
/_ACUM_7: J1.29, J6.29, U24.7 (GPB6)
/_ACUM_8: J1.23, J6.23, U24.1 (GPB0)
/_ACUM_9: J1.16, J6.16, U24.21 (GPA0)
/_ACUM_10: J1.9, J6.9, U25.1 (GPB0)
/_ACUM_11: J1.2, J6.2, U25.21 (GPA0)
/_BRKCYC: J4.33, J9.33, U10.1 (GPB0)
/_BRKGNTI: J4.32, J9.32, U10.2 (GPB1)
/_BRKGNTO: J4.31, J9.31, U10.3 (GPB2)
/_BRKRQST: J3.29, J8.29, U13.5 (GPB4)
/_BRKWRM: J4.11, J9.11, U11.22 (GPA1)
/_BUSINI: J3.31, J8.31, U12.22 (GPA1)
/_BWCOV: J3.32, J8.32, U12.23 (GPA2)
/_CAINC: J4.12, J9.12, U11.23 (GPA2)
/_CLOCK: J4.6, J9.6, U12.4 (GPB3)
/_CYCLE3: J4.13, J9.13, U11.24 (GPA3)
/_DFLD_0: J3.22, J8.22, U13.27 (GPA6)
/_DFLD_1: J3.18, J8.18, U13.23 (GPA2)
/_DFLD_2: J3.14, J8.14, U14.6 (GPB5)
/_DMAFLD_0: J3.23, J8.23, U13.7 (GPB6)
/_DMAFLD_1: J3.19, J8.19, U13.24 (GPA3)
/_DMAFLD_2: J3.15, J8.15, U14.7 (GPB6)
/_IFLD_0: J3.24, J8.24, U13.6 (GPB5)
/_IFLD_1: J3.20, J8.20, U13.25 (GPA4)
/_IFLD_2: J3.16, J8.16, U13.21 (GPA0)
/_INBUS_0: J3.10, J8.10, U14.2 (GPB1)
/_INBUS_1: J3.3, J8.3, U14.22 (GPA1)
/_INBUS_2: J2.30, J7.30, U21.26 (GPA5)
/_INBUS_3: J2.23, J7.23, U22.7 (GPB6)
/_INBUS_4: J2.16, J7.16, U22.24 (GPA3)
/_INBUS_5: J2.10, J7.10, U22.21 (GPA0)
/_INBUS_6: J2.4, J7.4, U23.2 (GPB1)
/_INBUS_7: J1.32, J6.32, U23.23 (GPA2)
/_INBUS_8: J1.26, J6.26, U24.4 (GPB3)
/_INBUS_9: J1.19, J6.19, U24.24 (GPA3)
/_INBUS_10: J1.12, J6.12, U25.4 (GPB3)
/_INBUS_11: J1.5, J6.5, U25.27 (GPA6)
/_INTINH: J4.15, J9.15, U11.27 (GPA6)
/_INTRQST: J4.16, J9.16, U11.26 (GPA5)
/_ION: J3.30, J8.30, U12.21 (GPA0)
/_IOP: J4.8, J9.8, U12.6 (GPB5)
/_IOSKIP: J4.17, J9.17, U11.1 (GPB0)
/_IREG_9: J1.22, J6.22, U24.25 (GPA4)
/_IREG_10: J1.15, J6.15, U25.7 (GPB6)
/_IREG_11: J1.8, J6.8, U25.24 (GPA3)
/_LINK: J4.9, J9.9, U12.7 (GPB6)
/_LNKTOG: J4.18, J9.18, U11.2 (GPB1)
/_MADR_0: J3.8, J8.8, U14.25 (GPA4)
/_MADR_1: J2.35, J7.35, U21.5 (GPB4)
/_MADR_2: J2.28, J7.28, U21.25 (GPA4)
/_MADR_3: J2.21, J7.21, U22.5 (GPB4)
/_MADR_4: J2.14, J7.14, U22.26 (GPA5)
/_MADR_5: J2.8, J7.8, U23.6 (GPB5)
/_MADR_6: J2.2, J7.2, U23.27 (GPA6)
/_MADR_7: J1.30, J6.30, U23.21 (GPA0)
/_MADR_8: J1.24, J6.24, U24.2 (GPB1)
/_MADR_9: J1.17, J6.17, U24.22 (GPA1)
/_MADR_10: J1.10, J6.10, U25.2 (GPB1)
/_MADR_11: J1.3, J6.3, U25.22 (GPA1)
/_MAJST_0: J4.22, J9.22, U11.6 (GPB5)
/_MAJST_1: J4.21, J9.21, U11.5 (GPB4)
/_MAJST_2: J4.20, J9.20, U11.4 (GPB3)
/_MAJST_3: J4.19, J9.19, U11.3 (GPB2)
/_MBUF_0: J3.9, J8.9, U14.1 (GPB0)
/_MBUF_1: J3.2, J8.2, U14.21 (GPA0)
/_MBUF_2: J2.29, J7.29, U21.27 (GPA6)
/_MBUF_3: J2.22, J7.22, U22.6 (GPB5)
/_MBUF_4: J2.15, J7.15, U22.25 (GPA4)
/_MBUF_5: J2.9, J7.9, U23.7 (GPB6)
/_MBUF_6: J2.3, J7.3, U23.1 (GPB0)
/_MBUF_7: J1.31, J6.31, U23.22 (GPA1)
/_MBUF_8: J1.25, J6.25, U24.3 (GPB2)
/_MBUF_9: J1.18, J6.18, U24.23 (GPA2)
/_MBUF_10: J1.11, J6.11, U25.3 (GPB2)
/_MBUF_11: J1.4, J6.4, U25.23 (GPA2)
/_MEAD_0: J3.25, J8.25, U13.1 (GPB0)
/_MEAD_1: J3.21, J8.21, U13.26 (GPA5)
/_MEAD_2: J3.17, J8.17, U13.22 (GPA1)
/_MEMDIS: J3.26, J8.26, U13.2 (GPB1)
/_MQUO_0: J3.11, J8.11, U14.3 (GPB2)
/_MQUO_1: J3.4, J8.4, U14.23 (GPA2)
/_MQUO_2: J2.31, J7.31, U21.1 (GPB0)
/_MQUO_3: J2.24, J7.24, U21.21 (GPA0)
/_MQUO_4: J2.17, J7.17, U22.1 (GPB0)
/_MQUO_5: J2.11, J7.11, U22.22 (GPA1)
/_MQUO_6: J2.5, J7.5, U23.3 (GPB2)
/_MQUO_7: J1.33, J6.33, U23.24 (GPA3)
/_MQUO_8: J1.27, J6.27, U24.5 (GPB4)
/_MQUO_9: J1.20, J6.20, U24.27 (GPA6)
/_MQUO_10: J1.13, J6.13, U25.5 (GPB4)
/_MQUO_11: J1.6, J6.6, U25.26 (GPA5)
/_PAUSE: J4.14, J9.14, U11.25 (GPA4)
/_PCTR_0: J3.12, J8.12, U14.4 (GPB3)
/_PCTR_1: J3.5, J8.5, U14.24 (GPA3)
/_PCTR_2: J2.32, J7.32, U21.2 (GPB1)
/_PCTR_3: J2.25, J7.25, U21.22 (GPA1)
/_PCTR_4: J2.18, J7.18, U22.2 (GPB1)
/_PCTR_5: J2.12, J7.12, U22.23 (GPA2)
/_PCTR_6: J2.6, J7.6, U23.4 (GPB3)
/_PCTR_7: J1.34, J6.34, U23.25 (GPA4)
/_PCTR_8: J1.28, J6.28, U24.6 (GPB5)
/_PCTR_9: J1.21, J6.21, U24.26 (GPA5)
/_PCTR_10: J1.14, J6.14, U25.6 (GPB5)
/_PCTR_11: J1.7, J6.7, U25.25 (GPA4)
/_READSR: J3.27, J8.27, U13.3 (GPB2)
/_RESET: J4.7, J9.7, U12.5 (GPB4)
/_RUN: J4.10, J9.10, U11.21 (GPA0)
/_SCTR_0: J3.13, J8.13, U14.5 (GPB4)
/_SCTR_1: J3.6, J8.6, U14.27 (GPA6)
/_SCTR_2: J2.33, J7.33, U21.3 (GPB2)
/_SCTR_3: J2.26, J7.26, U21.23 (GPA2)
/_SCTR_4: J2.19, J7.19, U22.3 (GPB2)
/_SWCONT: J4.2, J9.2, U12.27 (GPA6)
/_SWDEPOS: J3.35, J8.35, U12.26 (GPA5)
/_SWEXAM: J3.34, J8.34, U12.25 (GPA4)
/_SWLDAD: J3.33, J8.33, U12.24 (GPA3)
/_SWSINST: J4.5, J9.5, U12.3 (GPB2)
/_SWSSTEP: J4.4, J9.4, U12.2 (GPB1)
/_SWSTART: J4.3, J9.3, U12.1 (GPB0)
/_TP1: J4.27, J9.27, U10.24 (GPA3)
/_TP2: J4.28, J9.28, U10.25 (GPA4)
/_TP3: J4.29, J9.29, U10.26 (GPA5)
/_TP4: J4.30, J9.30, U10.27 (GPA6)
/_TS1: J4.23, J9.23, U11.7 (GPB6)
/_TS2: J4.24, J9.24, U10.21 (GPA0)
/_TS3: J4.25, J9.25, U10.22 (GPA1)
/_TS4: J4.26, J9.26, U10.23 (GPA2)
/_reset: Q1.3 (C), R5.2, U10.18 (~RESET), U11.18 (~RESET), U12.18 (~RESET), U13.18 (~RESET), U14.18 (~RESET), U21.18 (~RESET), U22.18 (~RESET), U23.18 (~RESET), U24.18 (~RESET), U25.18 (~RESET)
GND: C1.2, C2.2, C3.2, C4.2, C5.2, C6.2, C7.2, C8.2, C9.2, C10.2, C11.2, J1.36, J2.36, J3.36, J4.36, J5.9, J6.36, J7.36, J8.36, J9.36, J10.4, J12.6 (GND), J12.9 (GND), J12.14 (GND), J12.20 (GND), J12.25 (GND), J12.30 (GND), J12.34 (GND), J12.39 (GND), J21.4, Q1.1 (E), U10.10 (VSS), U10.15 (A0), U10.16 (A1), U10.17 (A2), U11.10 (VSS), U11.16 (A1), U11.17 (A2), U12.10 (VSS), U12.15 (A0), U12.17 (A2), U13.10 (VSS), U13.17 (A2), U14.10 (VSS), U14.15 (A0), U14.16 (A1), U21.10 (VSS), U21.16 (A1), U21.17 (A2), U22.10 (VSS), U22.15 (A0), U22.17 (A2), U23.10 (VSS), U23.17 (A2), U24.10 (VSS), U24.15 (A0), U24.16 (A1), U25.10 (VSS), U25.16 (A1)
unnamed: J10.1, U10.6 (GPB5)
unnamed: J10.2, U10.7 (GPB6)
unnamed: J10.3, U10.8 (GPB7)
unnamed: J21.1, U21.6 (GPB5)
unnamed: J21.2, U21.7 (GPB6)
unnamed: J21.3, U21.8 (GPB7)
unnamed: Q1.2 (B), R6.2
VCC: C1.1, C2.1, C3.1, C4.1, C5.1, C6.1, C7.1, C8.1, C9.1, C10.1, J1.1, J2.1, J3.1, J4.1, J5.2, J6.1, J7.1, J8.1, J9.1, R5.1, U10.9 (VDD), U11.9 (VDD), U11.15 (A0), U12.9 (VDD), U12.16 (A1), U13.9 (VDD), U13.15 (A0), U13.16 (A1), U14.9 (VDD), U14.17 (A2), U21.9 (VDD), U21.15 (A0), U22.9 (VDD), U22.16 (A1), U23.9 (VDD), U23.15 (A0), U23.16 (A1), U24.9 (VDD), U24.17 (A2), U25.9 (VDD), U25.15 (A0), U25.17 (A2)

Notes on the sheet:
from RasPI

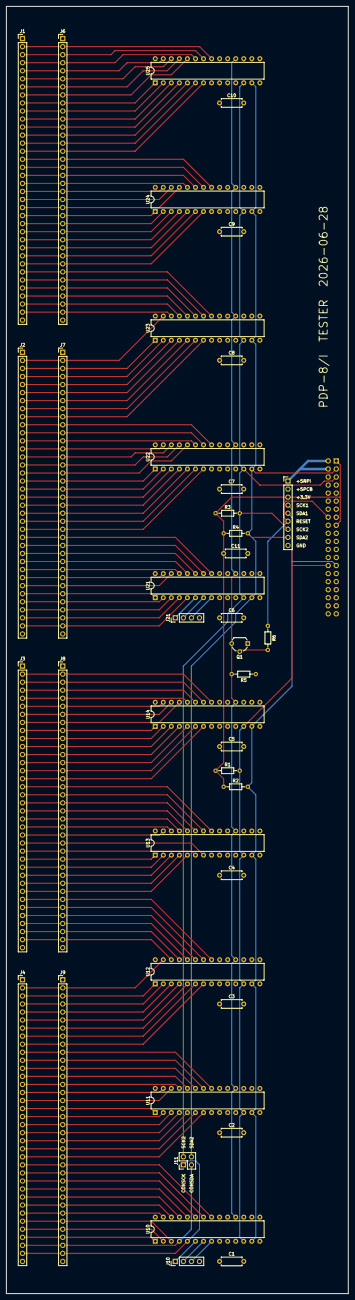
[picture p30: board tester.kicad_pcb from above]

Board: 4 copper layers, 108.0 x 406.4 mm, 41 parts (1 on the bottom side), 153 nets.
