mrieker/pdp8i/kicads/processor/processor.kicad_pcb

## KiCad design kicads/processor/processor.kicad_pcb (2026-06-09)

Schematic: processor.kicad_sch

Parts:
J1, J2, J3, J4: Conn_01x36; PinHeader_1x36_P2.54mm_Vertical
U1, U11, U17, U18, U19, U35, U37, U46, U49, U50, U162, U163, U169: 74AHC540; DIP-20_W7.62mm
U2, U3, U4, U6, U7, U9, U36: 74AC109; DIP-16_W7.62mm
U5, U8, U20, U106, U119, U123, U124, U125, U128, U141: 74AHC04; DIP-14_W7.62mm
U10, U40, U41, U42, U53, U90, U138, U166: 74AHC74; DIP-14_W7.62mm
U12, U145, U152, U154, U170: 74HC27; DIP-14_W7.62mm
U13, U54, U55, U56, U74, U77, U80, U126: 74AHC08; DIP-14_W7.62mm
U14, U15, U27, U48, U51, U142, U144: 74AHC02; DIP-14_W7.62mm
U16, U23, U24, U33, U43, U44, U82, U91, U107, U108, U109, U113, U120, U127, U147, U151, U156, U158, U161, U168: 74AHC00; DIP-14_W7.62mm
U21, U140: 74AHC138; DIP-16_W7.62mm
U22, U38, U68, U71, U116, U157, U165: 74HC30; DIP-14_W7.62mm
U25, U63, U64, U67: 74AHC157; DIP-16_W7.62mm
U26, U28, U29, U39, U92, U93, U94, U95, U96, U97, U98, U99, U100, U101, U102, U103, U104: 74AC151; DIP-16_W7.62mm
U31, U32, U61, U62, U65, U66, U69, U70, U83, U84, U85, U86, U87, U88: 74AC153; DIP-16_W7.62mm
U34, U105, U111, U112, U143, U146, U148, U149, U150, U159, U160: 74AC10; DIP-14_W7.62mm
U45, U117, U118, U121, U122, U153, U164: 74AC20; DIP-14_W7.62mm
U47, U57, U167: 74AC11; DIP-14_W7.62mm
U52, U73, U76, U79, U110: 74AHC32; DIP-14_W7.62mm
U58, U59, U60, U89: 74AHC86; DIP-14_W7.62mm
U72: 74AHC74; DIP-16_W7.62mm
U75, U78, U81: 74AC283; DIP-16_W7.62mm
U114: 74HC42; DIP-16_W7.62mm
U129, U130, U131, U132, U136, U137: 74AHC174; DIP-16_W7.62mm
U133, U134, U135, U175: 74AC161; DIP-16_W7.62mm
U139: 74AC175; DIP-16_W7.62mm
U155: 74HC21; DIP-14_W7.62mm
U171: 74HC4075; DIP-14_W7.62mm

Connections:
/AA: U27.2, U161.6, U170.9
/BB: U48.2, U68.8, U125.11
/CC: U48.3, U148.8
/CC3: U128.4, U168.9, U171.1
/CONSCK: J4.35
/CONSDA: J4.34
/EE: U27.8, U160.8
/FF: U27.9, U142.5, U144.6, U153.8
/HH: U106.12, U170.1, U170.3
/JJ: U142.6, U144.5, U165.8, U170.2, U170.4
/KK: U128.10, U170.10
/LL: U118.6, U170.13
/MM: U159.12, U170.5
/NN: U119.2, U156.9, U170.11
/PP: U161.11
/_AA1: U143.12, U161.4
/_AA2: U127.8, U161.5
/_ACCLEAR: J3.28, U50.4 (A2)
/_ACUM_0: J3.7, U46.16 (Y2)
/_ACUM_1: J2.34, U37.13 (Y5)
/_ACUM_2: J2.27, U37.18 (Y0)
/_ACUM_3: J2.20, U35.15 (Y3)
/_ACUM_4: J2.13, U19.12 (Y6)
/_ACUM_5: J2.7, U19.17 (Y1)
/_ACUM_6: J1.35, U18.14 (Y4)
/_ACUM_7: J1.29, U17.11 (Y7)
/_ACUM_8: J1.23, U17.16 (Y2)
/_ACUM_9: J1.16, U11.14 (Y4)
/_ACUM_10: J1.9, U1.12 (Y6)
/_ACUM_11: J1.2, U1.18 (Y0)
/_BB1: U68.3, U123.2
/_BB2: U68.4, U119.10
/_BB3: U68.5, U146.8
/_BB4: U68.6, U147.3
/_BB5: U68.11, U110.8
/_BB6: U68.12, U171.6
/_BRKCYC: J4.33, U163.11 (Y7)
/_BRKGNTI: J4.32
/_BRKGNTO: J4.31, U163.12 (Y6)
/_BRKRQST: J3.29, U50.5 (A3)
/_BRKWRM: J4.11, U50.6 (A4)
/_BUSINI: J3.31, U163.17 (Y1)
/_BWCOV: J3.32, U163.16 (Y2)
/_CAINC: J4.12, U50.7 (A5)
/_CC1: U109.11, U148.9, U168.12
/_CC2: U147.8, U148.10, U168.13
/_CC3: U110.4, U111.6, U128.3, U148.11
/_CLOCK: J4.6, U50.2 (A0)
/_CYCLE3: J4.13, U50.8 (A6)
/_DFLD_0: J3.22
/_DFLD_1: J3.18
/_DFLD_2: J3.14
/_DMAFLD_0: J3.23
/_DMAFLD_1: J3.19
/_DMAFLD_2: J3.15
/_EE1: U149.6, U160.9
/_EE2: U148.6, U160.10
/_EE3: U147.11, U160.11
/_FF1: U150.12, U153.9
/_FF2: U150.6, U153.10
/_FF3: U151.8, U153.12
/_FF4: U149.12, U153.13
/_HH1: U13.1, U40.1 (~R), U106.13, U142.1
/_IFLD_0: J3.24
/_IFLD_1: J3.20
/_IFLD_2: J3.16
/_INBUS_0: J3.10, U46.7 (A5)
/_INBUS_1: J3.3, U46.2 (A0)
/_INBUS_2: J2.30, U37.5 (A3)
/_INBUS_3: J2.23, U35.8 (A6)
/_INBUS_4: J2.16, U35.3 (A1)
/_INBUS_5: J2.10, U19.6 (A4)
/_INBUS_6: J2.4, U18.9 (A7)
/_INBUS_7: J1.32, U18.4 (A2)
/_INBUS_8: J1.26, U17.7 (A5)
/_INBUS_9: J1.19, U11.9 (A7)
/_INBUS_10: J1.12, U11.3 (A1)
/_INBUS_11: J1.5, U1.5 (A3)
/_INTINH: J4.15, U162.2 (A0)
/_INTRQST: J4.16, U162.3 (A1)
/_ION: J3.30, U163.18 (Y0)
/_IOP: J4.8, U163.15 (Y3)
/_IOSKIP: J4.17, U162.4 (A2)
/_IREG_9: J1.22, U17.17 (Y1)
/_IREG_10: J1.15, U11.15 (Y3)
/_IREG_11: J1.8, U1.13 (Y5)
/_JJ1: U127.6, U165.3
/_JJ2: U151.11, U165.4
/_JJ3: U146.6, U165.5
/_JJ4: U158.3, U165.6
/_JJ5: U158.6, U165.11
/_JJ6: U44.3, U165.12
/_KK1: U128.11, U159.6
/_LINK: J4.9, U163.14 (Y4)
/_LL1: U118.1, U146.12
/_LL2: U118.2, U158.8
/_LL3: U118.4, U158.11
/_LL4: U118.5, U160.12
/_LNKTOG: J4.18, U162.5 (A3)
/_MADR_0: J3.8, U46.15 (Y3)
/_MADR_1: J2.35, U37.12 (Y6)
/_MADR_2: J2.28, U37.17 (Y1)
/_MADR_3: J2.21, U35.14 (Y4)
/_MADR_4: J2.14, U19.11 (Y7)
/_MADR_5: J2.8, U19.16 (Y2)
/_MADR_6: J2.2, U18.13 (Y5)
/_MADR_7: J1.30, U18.18 (Y0)
/_MADR_8: J1.24, U17.15 (Y3)
/_MADR_9: J1.17, U11.13 (Y5)
/_MADR_10: J1.10, U1.11 (Y7)
/_MADR_11: J1.3, U1.17 (Y1)
/_MAJST_0: J4.22, U162.14 (Y4)
/_MAJST_1: J4.21, U162.13 (Y5)
/_MAJST_2: J4.20, U162.12 (Y6)
/_MAJST_3: J4.19, U162.11 (Y7)
/_MBUF_0: J3.9, U46.14 (Y4)
/_MBUF_1: J3.2, U37.11 (Y7)
/_MBUF_2: J2.29, U37.16 (Y2)
/_MBUF_3: J2.22, U35.13 (Y5)
/_MBUF_4: J2.15, U35.18 (Y0)
/_MBUF_5: J2.9, U19.15 (Y3)
/_MBUF_6: J2.3, U18.12 (Y6)
/_MBUF_7: J1.31, U18.17 (Y1)
/_MBUF_8: J1.25, U17.14 (Y4)
/_MBUF_9: J1.18, U11.12 (Y6)
/_MBUF_10: J1.11, U11.18 (Y0)
/_MBUF_11: J1.4, U1.16 (Y2)
/_MEAD_0: J3.25
/_MEAD_1: J3.21
/_MEAD_2: J3.17
/_MEMDIS: J3.26
/_MM1: U150.8, U159.1
/_MM2: U159.2, U161.3
/_MM3: U122.8, U159.13
/_MQUO_0: J3.11
/_MQUO_1: J3.4
/_MQUO_2: J2.31
/_MQUO_3: J2.24
/_MQUO_4: J2.17
/_MQUO_5: J2.11
/_MQUO_6: J2.5
/_MQUO_7: J1.33
/_MQUO_8: J1.27
/_MQUO_9: J1.20
/_MQUO_10: J1.13
/_MQUO_11: J1.6
/_NN1: U105.4, U119.1, U149.8
/_PAUSE: J4.14, U50.9 (A7)
/_PCTR_0: J3.12, U46.12 (Y6)
/_PCTR_1: J3.5, U46.17 (Y1)
/_PCTR_2: J2.32, U37.14 (Y4)
/_PCTR_3: J2.25, U35.11 (Y7)
/_PCTR_4: J2.18, U35.16 (Y2)
/_PCTR_5: J2.12, U19.13 (Y5)
/_PCTR_6: J2.6, U19.18 (Y0)
/_PCTR_7: J1.34, U18.15 (Y3)
/_PCTR_8: J1.28, U17.12 (Y6)
/_PCTR_9: J1.21, U17.18 (Y0)
/_PCTR_10: J1.14, U11.16 (Y2)
/_PCTR_11: J1.7, U1.14 (Y4)
/_PP1: U119.5, U159.8, U161.12
/_PP2: U105.3, U160.6, U161.13
/_READSR: J3.27, U46.11 (Y7)
/_RESET: J4.7, U50.3 (A1)
/_RUN: J4.10, U163.13 (Y5)
/_SCTR_0: J3.13
/_SCTR_1: J3.6
/_SCTR_2: J2.33
/_SCTR_3: J2.26
/_SCTR_4: J2.19
/_SWCONT: J4.2, U49.5 (A3)
/_SWDEPOS: J3.35, U49.4 (A2)
/_SWEXAM: J3.34, U49.3 (A1)
/_SWLDAD: J3.33, U49.2 (A0)
/_SWSINST: J4.5, U49.8 (A6)
/_SWSSTEP: J4.4, U49.7 (A5)
/_SWSTART: J4.3, U49.6 (A4)
/_TP1: J4.27, U169.14 (Y4)
/_TP2: J4.28, U169.13 (Y5)
/_TP3: J4.29, U169.12 (Y6)
/_TP4: J4.30, U169.11 (Y7)
/_TS1: J4.23, U169.18 (Y0)
/_TS2: J4.24, U169.17 (Y1)
/_TS3: J4.25, U169.16 (Y2)
/_TS4: J4.26, U169.15 (Y3)
/_asel_0: U61.14 (S0), U62.14 (S0), U65.14 (S0), U66.14 (S0), U69.14 (S0), U70.14 (S0), U164.4, U170.12
/_asel_1: U61.2 (S1), U62.2 (S1), U65.2 (S1), U66.2 (S1), U69.2 (S1), U70.2 (S1), U164.5, U170.6
/_brkgrnt: U16.9, U26.1 (I3), U26.12 (I7), U26.13 (I6), U31.5 (I1a), U72.8 (~Q)
/_brkintfet_0: U23.2, U23.9, U24.1, U48.6, U52.1, U72.9 (Q), U163.8 (A6)
/_brkintfet_1: U20.6, U23.4, U24.4, U24.13
/_brkintfet_2: U14.5, U20.8, U27.6
/_bsel_0: U48.1, U63.1 (S), U64.1 (S), U67.1 (S)
/_busini: U6.1 (~R), U6.15 (~R), U36.5 (~S), U54.13, U72.1 (~R), U106.10, U126.5, U126.13
/_clock: U8.4, U10.3 (C)
/_extarex: U44.10, U112.11, U119.12, U121.13
/_hreq: U15.3, U36.7 (~Q)
/_intgrnt: U72.6 (~Q)
/_ioinst: U14.12, U43.8
/_ion: U6.9 (~Q)
/_iop: U4.7 (~Q)
/_irand: U140.15 (~Y0), U141.13, U143.9
/_irdca: U105.10, U140.12 (~Y3), U141.5, U143.11
/_iriot: U20.11, U140.9 (~Y6)
/_irisz: U105.9, U140.13 (~Y2), U141.9
/_irjmp: U14.6, U140.10 (~Y5), U141.1, U142.8
/_irjms: U105.11, U140.11 (~Y4), U141.3
/_iropr: U20.1, U122.13, U140.7 (~Y7), U144.2, U145.1
/_irtad: U140.14 (~Y1), U141.11, U143.10
/_jamms: U13.2, U40.4 (~S), U52.4, U166.8 (~Q)
/_ldadclk: U43.3, U82.12, U111.1
/_majst_0: U41.8 (~Q)
/_majst_1: U41.6 (~Q)
/_majst_2: U40.8 (~Q)
/_majst_3: U40.6 (~Q), U45.10, U82.5
/_mbuf_0: U5.8, U27.11, U38.12
/_mbuf_1: U5.2, U33.10, U51.3, U71.11
/_mbuf_2: U5.4, U22.12, U33.9, U71.6
/_mbuf_8: U5.10, U22.5, U24.12, U31.3 (I3a), U32.12 (I2b)
/_msdefer: U114.3 (2), U123.11
/_msdepos: U114.10 (8), U116.12, U124.11
/_msexec: U82.1, U114.4 (3), U123.13
/_msintak: U114.9 (7), U116.11, U118.13, U124.9
/_mswrdct: U82.2, U114.5 (4), U116.4, U124.1
/_nxtmsbreak: U21.9 (~Y6), U171.4
/_nxtmswrdct: U21.11 (~Y4), U110.10
/_pcld: U56.3, U133.9 (~PE), U134.9 (~PE), U135.9 (~PE)
/_reset: U2.5 (~S), U2.15 (~R), U3.1 (~R), U3.15 (~R), U4.1 (~R), U4.15 (~R), U7.1 (~R), U7.15 (~R), U8.6, U9.1 (~R), U9.15 (~R), U10.1 (~R), U43.5, U138.13 (~R), U167.9, U175.1 (~MR)
/_rsel_0: U91.6, U92.11 (S0), U93.11 (S0), U94.11 (S0), U95.11 (S0), U96.11 (S0), U97.11 (S0), U98.11 (S0), U99.11 (S0), U100.11 (S0), U101.11 (S0), U102.11 (S0), U103.11 (S0), U104.11 (S0)
/_rsel_1: U91.8, U92.10 (S1), U93.10 (S1), U94.10 (S1), U95.10 (S1), U96.10 (S1), U97.10 (S1), U98.10 (S1), U99.10 (S1), U100.10 (S1), U101.10 (S1), U102.10 (S1), U103.10 (S1), U104.10 (S1)
/_rsel_2: U91.11, U92.9 (S2), U93.9 (S2), U94.9 (S2), U95.9 (S2), U96.9 (S2), U97.9 (S2), U98.9 (S2), U99.9 (S2), U100.9 (S2), U101.9 (S2), U102.9 (S2), U103.9 (S2), U104.9 (S2)
/_swcontx: U16.3, U47.5, U128.1
/_swlaexdep: U8.13, U12.12, U47.1
/_swsstep: U45.12, U106.6, U161.10
/_swstart: U8.10, U43.4, U47.4
/_synpause: U10.6 (~Q), U175.7 (CEP), U175.10 (CET)
/_tp1: U2.13 (~K), U7.7 (~Q)
/_tp2: U3.3 (~K), U7.9 (~Q)
/_tp3: U3.13 (~K), U4.3 (~K), U9.7 (~Q)
/_tp4: U4.13 (~K), U9.9 (~Q), U15.2
/_ts1: U2.9 (~Q)
/_ts2: U3.7 (~Q), U14.11
/_ts3: U3.9 (~Q)
/_ts4: U4.9 (~Q), U110.9, U171.3
/acclear: U50.16 (Y2), U168.5
/acclk: U56.8, U136.9 (Cp), U137.9 (Cp)
/acum_0: U46.4 (A2), U58.1, U136.2 (Q0), U152.11
/acum_1: U37.7 (A5), U58.4, U136.5 (Q1), U152.10
/acum_2: U37.2 (A0), U58.9, U136.7 (Q2), U152.9
/acum_3: U35.5 (A3), U58.12, U136.10 (Q3), U154.11
/acum_4: U19.8 (A6), U59.1, U136.12 (Q4), U154.10
/acum_5: U19.3 (A1), U59.4, U136.15 (Q5), U154.9
/acum_6: U18.6 (A4), U59.9, U137.2 (Q0), U154.5
/acum_7: U17.9 (A7), U59.12, U137.5 (Q1), U154.4
/acum_8: U17.4 (A2), U60.1, U137.7 (Q2), U154.3
/acum_9: U11.6 (A4), U60.4, U137.10 (Q3), U154.13
/acum_10: U1.8 (A6), U60.9, U137.12 (Q4), U154.2
/acum_11: U1.2 (A0), U60.12, U127.12, U137.15 (Q5), U154.1
/acxx_0: U58.3, U61.3 (I3a)
/acxx_1: U58.6, U61.13 (I3b)
/acxx_2: U58.8, U62.3 (I3a)
/acxx_3: U58.11, U62.13 (I3b)
/acxx_4: U59.3, U65.3 (I3a)
/acxx_5: U59.6, U65.13 (I3b)
/acxx_6: U59.8, U66.3 (I3a)
/acxx_7: U59.11, U66.13 (I3b)
/acxx_8: U60.3, U69.3 (I3a)
/acxx_9: U60.6, U69.13 (I3b)
/acxx_10: U60.8, U70.3 (I3a)
/acxx_11: U60.11, U70.13 (I3b)
/alua_0: U61.7 (Za), U73.1, U74.1, U75.5 (A1)
/alua_1: U61.9 (Zb), U73.4, U74.4, U75.3 (A2)
/alua_2: U62.7 (Za), U73.9, U74.9, U75.14 (A3)
/alua_3: U62.9 (Zb), U73.12, U74.12, U75.12 (A4)
/alua_4: U65.7 (Za), U76.1, U77.1, U78.5 (A1)
/alua_5: U65.9 (Zb), U76.4, U77.4, U78.3 (A2)
/alua_6: U66.7 (Za), U76.9, U77.9, U78.14 (A3)
/alua_7: U66.9 (Zb), U76.12, U77.12, U78.12 (A4)
/alua_8: U69.7 (Za), U79.1, U80.1, U81.5 (A1)
/alua_9: U69.9 (Zb), U79.4, U80.4, U81.3 (A2)
/alua_10: U70.7 (Za), U79.9, U80.9, U81.14 (A3)
/alua_11: U70.9 (Zb), U79.12, U80.12, U81.12 (A4)
/alub_0: U63.4 (Za), U73.2, U74.2, U75.6 (B1)
/alub_1: U63.7 (Zb), U73.5, U74.5, U75.2 (B2)
/alub_2: U63.9 (Zc), U73.10, U74.10, U75.15 (B3)
/alub_3: U63.12 (Zd), U73.13, U74.13, U75.11 (B4)
/alub_4: U64.4 (Za), U76.2, U77.2, U78.6 (B1)
/alub_5: U64.7 (Zb), U76.5, U77.5, U78.2 (B2)
/alub_6: U64.9 (Zc), U76.10, U77.10, U78.15 (B3)
/alub_7: U64.12 (Zd), U76.13, U77.13, U78.11 (B4)
/alub_8: U67.4 (Za), U79.2, U80.2, U81.6 (B1)
/alub_9: U67.7 (Zb), U79.5, U80.5, U81.2 (B2)
/alub_10: U67.9 (Zc), U79.10, U80.10, U81.15 (B3)
/alub_11: U67.12 (Zd), U79.13, U80.13, U81.11 (B4)
/aluq_0: U83.7 (Za), U92.12 (I7), U93.14 (I5), U94.15 (I4), U98.13 (I6), U103.2 (I2), U104.1 (I3), U129.3 (D0), U131.3 (D0), U133.3 (D0)
/aluq_1: U83.9 (Zb), U92.1 (I3), U93.12 (I7), U94.14 (I5), U95.15 (I4), U99.13 (I6), U104.2 (I2), U129.4 (D1), U131.4 (D1), U133.4 (D1)
/aluq_2: U84.7 (Za), U92.2 (I2), U93.1 (I3), U94.12 (I7), U95.14 (I5), U96.15 (I4), U100.13 (I6), U129.6 (D2), U131.6 (D2), U133.5 (D2)
/aluq_3: U84.9 (Zb), U93.2 (I2), U94.1 (I3), U95.12 (I7), U96.14 (I5), U97.15 (I4), U101.13 (I6), U129.11 (D3), U131.11 (D3), U133.6 (D3)
/aluq_4: U85.7 (Za), U94.2 (I2), U95.1 (I3), U96.12 (I7), U97.14 (I5), U98.15 (I4), U102.13 (I6), U129.13 (D4), U131.13 (D4), U134.3 (D0)
/aluq_5: U85.9 (Zb), U95.2 (I2), U96.1 (I3), U97.12 (I7), U98.14 (I5), U99.15 (I4), U103.13 (I6), U129.14 (D5), U131.14 (D5), U134.4 (D1)
/aluq_6: U86.7 (Za), U92.13 (I6), U96.2 (I2), U97.1 (I3), U98.12 (I7), U99.14 (I5), U100.15 (I4), U130.3 (D0), U132.3 (D0), U134.5 (D2)
/aluq_7: U86.9 (Zb), U93.13 (I6), U97.2 (I2), U98.1 (I3), U99.12 (I7), U100.14 (I5), U101.15 (I4), U130.4 (D1), U132.4 (D1), U134.6 (D3)
/aluq_8: U87.7 (Za), U94.13 (I6), U98.2 (I2), U99.1 (I3), U100.12 (I7), U101.14 (I5), U102.15 (I4), U130.6 (D2), U132.6 (D2), U135.3 (D0)
/aluq_9: U87.9 (Zb), U95.13 (I6), U99.2 (I2), U100.1 (I3), U101.12 (I7), U102.14 (I5), U103.15 (I4), U130.11 (D3), U132.11 (D3), U135.4 (D1)
/aluq_10: U88.7 (Za), U96.13 (I6), U100.2 (I2), U101.1 (I3), U102.12 (I7), U103.14 (I5), U104.15 (I4), U130.13 (D4), U132.13 (D4), U135.5 (D2)
/aluq_11: U88.9 (Zb), U92.15 (I4), U97.13 (I6), U101.2 (I2), U102.1 (I3), U103.12 (I7), U104.14 (I5), U130.14 (D5), U132.14 (D5), U135.6 (D3)
/aluq_12: U89.3, U92.14 (I5), U93.15 (I4), U102.2 (I2), U103.1 (I3), U104.12 (I7), U104.13 (I6)
/autoinc: U107.5, U150.13, U155.6
/azero: U61.1 (Ea), U61.15 (Eb), U62.1 (Ea), U62.15 (Eb), U65.1 (Ea), U65.15 (Eb), U66.1 (Ea), U66.15 (Eb), U69.1 (Ea), U69.15 (Eb), U70.1 (Ea), U70.15 (Eb), U148.12
/brkcyc: U138.9 (Q), U163.9 (A7)
/brkintfet_1: U16.11, U20.5, U28.1 (I3), U28.12 (I7), U28.13 (I6), U31.11 (I1b)
/brkintfet_2: U13.13, U16.8, U20.9, U29.1 (I3), U29.12 (I7), U29.13 (I6), U32.5 (I1a)
/brkrqst: U50.15 (Y3), U72.12 (D)
/brkwrm: U50.14 (Y4), U109.2, U146.11
/busini: U43.6, U106.11, U163.3 (A1)
/bwcov: U90.5 (Q), U112.13, U163.4 (A2)
/bzero: U63.15 (E), U64.15 (E), U67.15 (E), U164.6
/cainc: U50.13 (Y5), U108.13, U149.13
/cclears: U27.3, U168.3
/cin: U75.7 (C0), U156.6
/clock: U2.4 (C), U2.12 (C), U3.4 (C), U3.12 (C), U4.4 (C), U4.12 (C), U7.4 (C), U7.12 (C), U8.3, U9.4 (C), U9.12 (C), U10.11 (C), U36.4 (C), U50.18 (Y0), U53.3 (C), U53.11 (C), U90.11 (C), U166.3 (C), U166.11 (C), U175.2 (CP)
/comac: U57.8, U58.2, U58.5, U58.10, U58.13, U59.2, U59.5, U59.10, U59.13, U60.2, U60.5, U60.10, U60.13
/comln: U57.6, U89.4
/cout: U81.9 (C4), U89.1, U90.2 (D)
/cycle3: U20.13, U50.12 (Y6), U171.5
/dirjmp: U113.5, U142.10, U150.11
/efaddr_7: U55.11, U66.11 (I1b)
/efaddr_8: U55.8, U69.5 (I1a)
/efaddr_9: U55.6, U69.11 (I1b)
/efaddr_10: U55.3, U70.5 (I1a)
/efaddr_11: U56.11, U70.11 (I1b)
/endinst: U33.13, U39.5 (Z)
/extarex: U44.4, U119.13, U147.10, U156.11
/g2skip: U89.8, U111.11
/group1: U57.2, U57.4, U57.10, U82.10, U110.12, U121.4, U122.4, U144.1, U149.11
/group2: U110.13, U111.5, U111.10, U145.12
/hgnt: U2.6 (Q), U14.3, U167.10
/hreq: U2.3 (~K), U36.6 (Q), U48.11
/inbus_0: U46.13 (Y5), U63.2 (I0a)
/inbus_1: U46.18 (Y0), U63.5 (I0b)
/inbus_2: U37.15 (Y3), U63.11 (I0c)
/inbus_3: U35.12 (Y6), U63.14 (I0d)
/inbus_4: U35.17 (Y1), U64.2 (I0a)
/inbus_5: U19.14 (Y4), U64.5 (I0b)
/inbus_6: U18.11 (Y7), U64.11 (I0c)
/inbus_7: U18.16 (Y2), U64.14 (I0d)
/inbus_8: U17.13 (Y5), U67.2 (I0a), U139.4 (D0)
/inbus_9: U11.11 (Y7), U67.5 (I0b), U139.5 (D1)
/inbus_10: U11.17 (Y1), U67.11 (I0c), U139.12 (D2)
/inbus_11: U1.15 (Y3), U67.14 (I0d), U128.13
/intdelayed: U6.6 (Q), U47.10
/intgrnt: U34.11, U72.5 (Q)
/intinh: U5.13, U162.18 (Y0)
/intrqst: U72.2 (D), U162.17 (Y1)
/ion: U6.10 (Q), U34.10, U163.2 (A0)
/iop: U4.6 (Q), U22.4, U108.4, U109.13, U119.3, U163.5 (A3)
/ioskip: U108.5, U112.5, U162.16 (Y2)
/iot_iof: U15.9, U51.1
/iot_ion: U6.2 (J), U27.13
/irand: U141.12, U159.11
/irandtaddca: U109.10, U143.8
/irdca: U141.6, U143.13, U159.5
/ireg_8: U139.2 (Q0)
/ireg_9: U17.3 (A1), U33.1, U139.7 (Q1), U140.1 (A0)
/ireg_10: U11.5 (A3), U33.4, U139.10 (Q2), U140.2 (A1)
/ireg_11: U1.7 (A5), U33.2, U33.5, U139.14 (~Q3), U140.3 (A2)
/irisz: U112.2, U141.8, U150.5
/irjmp: U23.5, U23.10, U39.2 (I2), U113.2, U141.2, U149.5
/irjms: U113.10, U141.4, U146.5, U146.13
/iropr: U20.2, U38.5, U71.3, U112.4, U151.4, U160.13
/irtad: U91.2, U141.10, U160.5
/jamms: U43.12, U166.9 (Q)
/link: U89.5, U138.5 (Q), U151.1, U163.6 (A4)
/lnclk: U56.6, U138.3 (C)
/lndat: U44.11, U138.2 (D)
/lnktog: U44.5, U162.15 (Y3)
/madr_0: U46.5 (A3), U61.6 (I0a), U129.2 (Q0)
/madr_1: U37.8 (A6), U61.10 (I0b), U129.5 (Q1)
/madr_2: U37.3 (A1), U62.6 (I0a), U129.7 (Q2)
/madr_3: U35.6 (A4), U62.10 (I0b), U129.10 (Q3), U155.5
/madr_4: U19.9 (A7), U65.6 (I0a), U129.12 (Q4), U142.12
/madr_5: U19.4 (A2), U65.10 (I0b), U129.15 (Q5), U142.11
/madr_6: U18.7 (A5), U66.6 (I0a), U130.2 (Q0), U152.5
/madr_7: U18.2 (A0), U55.13, U66.10 (I0b), U130.5 (Q1), U152.4
/madr_8: U17.5 (A3), U55.10, U69.6 (I0a), U130.7 (Q2), U152.3
/madr_9: U11.7 (A5), U55.5, U69.10 (I0b), U130.10 (Q3), U152.13
/madr_10: U1.9 (A7), U55.2, U70.6 (I0a), U130.12 (Q4), U152.2
/madr_11: U1.3 (A1), U56.13, U70.10 (I0b), U130.15 (Q5), U152.1
/majst_0: U25.3 (I1a), U26.11 (S0), U28.11 (S0), U29.11 (S0), U39.11 (S0), U41.9 (Q), U114.15 (A0), U162.6 (A4)
/majst_1: U26.10 (S1), U28.10 (S1), U29.10 (S1), U39.10 (S1), U41.5 (Q), U114.14 (A1), U162.7 (A5)
/majst_2: U26.9 (S2), U28.9 (S2), U29.9 (S2), U39.9 (S2), U40.9 (Q), U114.13 (A2), U162.8 (A6)
/majst_3: U16.2, U25.1 (S), U25.13 (I1d), U40.5 (Q), U114.12 (A3), U162.9 (A7)
/maload: U82.11, U129.9 (Cp), U130.9 (Cp)
/mbload: U108.3, U131.9 (Cp), U132.9 (Cp)
/mbuf_0: U5.9, U34.2, U46.6 (A4), U61.5 (I1a), U63.3 (I1a), U71.12, U131.2 (Q0), U145.13, U156.10
/mbuf_1: U5.1, U37.9 (A7), U38.11, U61.11 (I1b), U63.6 (I1b), U91.5, U131.5 (Q1)
/mbuf_2: U5.3, U37.4 (A2), U62.5 (I1a), U63.10 (I1c), U91.10, U110.5, U131.7 (Q2)
/mbuf_3: U12.11, U35.7 (A5), U62.11 (I1b), U63.13 (I1d), U89.10, U91.13, U131.10 (Q3)
/mbuf_4: U12.10, U35.2 (A0), U57.5, U64.3 (I1a), U65.5 (I1a), U131.12 (Q4), U151.2
/mbuf_5: U12.9, U19.5 (A3), U57.9, U64.6 (I1b), U65.11 (I1b), U131.15 (Q5), U157.12
/mbuf_6: U18.8 (A6), U48.9, U64.10 (I1c), U66.5 (I1a), U122.5, U127.13, U132.2 (Q0)
/mbuf_7: U18.3 (A1), U48.8, U55.1, U55.4, U55.9, U55.12, U56.12, U64.13 (I1d), U121.5, U132.5 (Q1), U168.10
/mbuf_8: U5.11, U17.6 (A4), U27.5, U34.13, U38.6, U48.5, U67.3 (I1a), U71.5, U128.9, U132.7 (Q2), U142.9, U144.3
/mbuf_9: U11.8 (A6), U67.6 (I1b), U132.10 (Q3)
/mbuf_10: U11.2 (A0), U67.10 (I1c), U132.12 (Q4)
/mbuf_11: U1.4 (A2), U67.13 (I1d), U132.15 (Q5)
/memacsw: U43.1, U90.9 (Q), U166.12 (D)
/msbreak: U16.5, U24.9, U109.1, U124.6, U146.10
/mscurad: U108.12, U124.4, U147.13, U149.2
/msdefer: U107.4, U113.1, U123.10, U148.5, U149.4, U150.2
/msdepos: U54.9, U107.13, U124.10, U147.2, U151.13
/msexam: U107.10, U124.12, U127.5
/msexec: U91.1, U107.1, U109.9, U112.1, U112.3, U113.9, U123.12, U143.2, U146.2, U146.4, U150.4, U151.5, U159.4, U159.10, U160.4
/msfetch: U38.4, U43.9, U47.11, U57.11, U57.13, U71.4, U82.9, U109.4, U111.4, U111.9, U113.4, U120.5, U120.13, U121.2, U122.2, U122.12, U123.8, U126.2, U149.10, U150.10
/msintak: U15.8, U124.8, U127.2, U158.2, U158.10
/mspwron: U123.6
/mswrdct: U44.2, U124.2, U151.10, U158.5
/nxtms_0: U21.1 (A0), U25.4 (Za), U41.12 (D)
/nxtms_1: U21.2 (A1), U25.7 (Zb), U41.2 (D)
/nxtms_2: U21.3 (A2), U25.9 (Zc), U40.12 (D)
/nxtms_3: U21.4 (~E0), U25.12 (Zd), U40.2 (D)
/nxtmsdefer: U125.6, U161.2
/nxtmsexec: U122.10, U125.8, U148.4, U160.2
/nxtmsfetch: U125.4, U158.13
/nxtmsintak: U119.8, U127.10
/nxtmspwron: U125.2
/pause: U10.2 (D), U50.11 (Y7)
/pcclk: U111.12, U133.2 (CP), U134.2 (CP), U135.2 (CP)
/pcinc: U113.11, U133.7 (CEP), U133.10 (CET), U134.7 (CEP), U135.7 (CEP)
/pctr_0: U46.8 (A6), U61.4 (I2a), U133.14 (Q0)
/pctr_1: U46.3 (A1), U61.12 (I2b), U133.13 (Q1)
/pctr_2: U37.6 (A4), U62.4 (I2a), U133.12 (Q2)
/pctr_3: U35.9 (A7), U62.12 (I2b), U133.11 (Q3)
/pctr_4: U35.4 (A2), U65.4 (I2a), U134.14 (Q0)
/pctr_5: U19.7 (A5), U65.12 (I2b), U134.13 (Q1)
/pctr_6: U19.2 (A0), U66.4 (I2a), U134.12 (Q2)
/pctr_7: U18.5 (A3), U66.12 (I2b), U134.11 (Q3)
/pctr_8: U17.8 (A6), U69.4 (I2a), U135.14 (Q0)
/pctr_9: U17.2 (A0), U69.12 (I2b), U135.13 (Q1)
/pctr_10: U11.4 (A2), U70.4 (I2a), U135.12 (Q2)
/pctr_11: U1.6 (A4), U70.12 (I2b), U135.11 (Q3)
/qsel_0: U83.14 (S0), U84.14 (S0), U85.14 (S0), U86.14 (S0), U87.14 (S0), U88.14 (S0), U119.6
/qsel_1: U83.2 (S1), U84.2 (S1), U85.2 (S1), U86.2 (S1), U87.2 (S1), U88.2 (S1), U105.6
/qsum_0: U75.4 (S1), U83.4 (I2a)
/qsum_1: U75.1 (S2), U83.12 (I2b)
/qsum_2: U75.13 (S3), U84.4 (I2a)
/qsum_3: U75.10 (S4), U84.12 (I2b)
/readsr: U46.9 (A7), U171.9
/reset: U8.5, U50.17 (Y1)
/rotq_0: U92.5 (Z), U136.3 (D0)
/rotq_1: U93.5 (Z), U136.4 (D1)
/rotq_2: U94.5 (Z), U136.6 (D2)
/rotq_3: U95.5 (Z), U136.11 (D3)
/rotq_4: U96.5 (Z), U136.13 (D4)
/rotq_5: U97.5 (Z), U136.14 (D5)
/rotq_6: U98.5 (Z), U137.3 (D0)
/rotq_7: U99.5 (Z), U137.4 (D1)
/rotq_8: U100.5 (Z), U137.6 (D2)
/rotq_9: U101.5 (Z), U137.11 (D3)
/rotq_10: U102.5 (Z), U137.13 (D4)
/rotq_11: U103.5 (Z), U137.14 (D5)
/rotq_12: U44.9, U104.5 (Z)
/run: U2.7 (~Q), U56.1, U163.7 (A5), U175.9 (~PE)
/swcont: U8.9, U16.1, U49.15 (Y3)
/swdepos: U12.13, U43.13, U49.16 (Y2), U107.12, U151.12
/swexam: U12.2, U49.17 (Y1), U51.6, U107.9, U127.4
/swldad: U12.1, U49.18 (Y0), U51.5, U106.9, U123.1, U171.2
/swsinst: U33.12, U49.12 (Y6)
/swsstep: U23.13, U49.13 (Y5), U106.5
/swstart: U8.11, U23.12, U49.14 (Y4), U142.2, U161.9
/synpause: U10.5 (Q)
/tp1: U3.2 (J), U7.6 (Q), U106.3, U126.1, U127.1, U169.6 (A4)
/tp2: U3.14 (J), U7.10 (Q), U16.4, U54.4, U108.9, U120.4, U121.1, U122.1, U169.7 (A5)
/tp3: U4.14 (J), U6.4 (C), U6.12 (C), U9.6 (Q), U13.4, U56.4, U56.9, U72.3 (C), U72.11 (C), U106.1, U169.8 (A6)
/tp4: U9.10 (Q), U14.2, U40.3 (C), U40.11 (C), U41.3 (C), U41.11 (C), U82.4, U169.9 (A7)
/ts1: U2.10 (Q), U24.10, U54.1, U119.11, U169.2 (A0)
/ts2: U3.6 (Q), U54.10, U120.12, U146.1, U146.9, U147.1, U149.1, U150.1, U150.3, U151.9, U158.9, U159.3, U167.1, U169.3 (A1)
/ts3: U3.10 (Q), U57.1, U57.3, U109.12, U111.3, U120.1, U120.9, U126.9, U143.1, U146.3, U147.9, U149.3, U149.9, U150.9, U158.1, U158.4, U159.9, U160.3, U169.4 (A2)
/ts4: U4.10 (Q), U13.9, U44.1, U122.9, U127.9, U138.11 (C), U147.12, U148.3, U158.12, U160.1, U161.1, U169.5 (A3)
/tsct_0: U175.14 (Q0)
/tsct_1: U13.10, U54.2, U126.10, U167.2, U175.13 (Q1)
/tsct_2: U167.13, U175.12 (Q2)
/tsct_3: U175.11 (Q3)
GND: J1.36, J2.36, J3.36, J4.36, U1.1 (G1), U1.10 (GND), U1.19 (G2), U2.8 (GND), U3.8 (GND), U4.8 (GND), U5.7 (GND), U6.8 (GND), U7.3 (~K), U7.8 (GND), U7.13 (~K), U8.7 (GND), U9.3 (~K), U9.8 (GND), U9.13 (~K), U10.7 (GND), U11.1 (G1), U11.10 (GND), U11.19 (G2), U12.7 (GND), U13.7 (GND), U14.7 (GND), U15.7 (GND), U16.7 (GND), U17.1 (G1), U17.10 (GND), U17.19 (G2), U18.1 (G1), U18.10 (GND), U18.19 (G2), U19.1 (G1), U19.10 (GND), U19.19 (G2), U20.7 (GND), U21.5 (~E1), U21.8 (GND), U22.7 (GND), U23.7 (GND), U24.7 (GND), U25.6 (I1b), U25.8 (GND), U25.10 (I1c), U25.14 (I0d), U25.15 (E), U26.4 (I0), U26.7 (~E), U26.8 (GND), U26.14 (I5), U27.7 (GND), U28.4 (I0), U28.7 (~E), U28.8 (GND), U28.15 (I4), U29.4 (I0), U29.7 (~E), U29.8 (GND), U31.1 (Ea), U31.8 (GND), U31.15 (Eb), U32.1 (Ea), U32.3 (I3a), U32.8 (GND), U32.13 (I3b), U32.15 (Eb), U33.7 (GND), U34.7 (GND), U35.1 (G1), U35.10 (GND), U35.19 (G2), U36.8 (GND), U37.1 (G1), U37.10 (GND), U37.19 (G2), U38.7 (GND), U39.4 (I0), U39.7 (~E), U39.8 (GND), U39.14 (I5), U39.15 (I4), U40.7 (GND), U41.7 (GND), U42.7 (GND), U43.7 (GND), U44.7 (GND), U45.7 (GND), U46.1 (G1), U46.10 (GND), U46.19 (G2), U47.7 (GND), U48.7 (GND), U49.1 (G1), U49.10 (GND), U49.19 (G2), U50.1 (G1), U50.10 (GND), U50.19 (G2), U51.7 (GND), U52.7 (GND), U53.7 (GND), U54.7 (GND), U55.7 (GND), U56.7 (GND), U57.7 (GND), U58.7 (GND), U59.7 (GND), U60.7 (GND), U61.8 (GND), U62.8 (GND), U63.8 (GND), U64.8 (GND), U65.8 (GND), U66.8 (GND), U67.8 (GND), U68.7 (GND), U69.8 (GND), U70.8 (GND), U71.7 (GND), U72.7 (GND), U73.7 (GND), U74.7 (GND), U75.8 (GND), U76.7 (GND), U77.7 (GND), U78.8 (GND), U79.7 (GND), U80.7 (GND), U81.8 (GND), U82.7 (GND), U83.1 (Ea), U83.3 (I3a), U83.8 (GND), U83.13 (I3b), U83.15 (Eb), U84.1 (Ea), U84.3 (I3a), U84.8 (GND), U84.13 (I3b), U84.15 (Eb), U85.1 (Ea), U85.3 (I3a), U85.8 (GND), U85.13 (I3b), U85.15 (Eb), U86.1 (Ea), U86.3 (I3a), U86.8 (GND), U86.13 (I3b), U86.15 (Eb), U87.1 (Ea), U87.3 (I3a), U87.8 (GND), U87.13 (I3b), U87.15 (Eb), U88.1 (Ea), U88.3 (I3a), U88.8 (GND), U88.13 (I3b), U88.15 (Eb), U89.7 (GND), U90.7 (GND), U91.7 (GND), U92.3 (I1), U92.4 (I0), U92.7 (~E), U92.8 (GND), U93.3 (I1), U93.4 (I0), U93.7 (~E), U93.8 (GND), U94.3 (I1), U94.4 (I0), U94.7 (~E), U94.8 (GND), U95.3 (I1), U95.4 (I0), U95.7 (~E), U95.8 (GND), U96.3 (I1), U96.4 (I0), U96.7 (~E), U96.8 (GND), U97.3 (I1), U97.4 (I0), U97.7 (~E), U97.8 (GND), U98.3 (I1), U98.4 (I0), U98.7 (~E), U98.8 (GND), U99.3 (I1), U99.4 (I0), U99.7 (~E), U99.8 (GND), U100.3 (I1), U100.4 (I0), U100.7 (~E), U100.8 (GND), U101.3 (I1), U101.4 (I0), U101.7 (~E), U101.8 (GND), U102.3 (I1), U102.4 (I0), U102.7 (~E), U102.8 (GND), U103.3 (I1), U103.4 (I0), U103.7 (~E), U103.8 (GND), U104.3 (I1), U104.4 (I0), U104.7 (~E), U104.8 (GND), U105.7 (GND), U106.7 (GND), U107.7 (GND), U108.7 (GND), U109.7 (GND), U110.7 (GND), U111.7 (GND), U112.7 (GND), U113.7 (GND), U114.8 (GND), U116.7 (GND), U117.7 (GND), U118.7 (GND), U119.7 (GND), U120.7 (GND), U121.7 (GND), U122.7 (GND), U123.7 (GND), U124.7 (GND), U125.7 (GND), U126.7 (GND), U127.7 (GND), U128.7 (GND), U129.8 (GND), U130.8 (GND), U131.8 (GND), U132.8 (GND), U133.8 (GND), U134.8 (GND), U135.8 (GND), U136.8 (GND), U137.8 (GND), U138.7 (GND), U138.12 (D), U139.8 (GND), U140.4 (~E0), U140.5 (~E1), U140.8 (GND), U141.7 (GND), U142.7 (GND), U143.7 (GND), U144.7 (GND), U145.7 (GND), U146.7 (GND), U147.7 (GND), U148.7 (GND), U149.7 (GND), U150.7 (GND), U151.7 (GND), U152.7 (GND), U153.7 (GND), U154.7 (GND), U155.7 (GND), U156.7 (GND), U157.7 (GND), U158.7 (GND), U159.7 (GND), U160.7 (GND), U161.7 (GND), U162.1 (G1), U162.10 (GND), U162.19 (G2), U163.1 (G1), U163.10 (GND), U163.19 (G2), U164.7 (GND), U165.7 (GND), U166.7 (GND), U167.7 (GND), U168.7 (GND), U169.1 (G1), U169.10 (GND), U169.19 (G2), U170.7 (GND), U171.7 (GND), U175.3 (D0), U175.4 (D1), U175.5 (D2), U175.6 (D3), U175.8 (GND)
unnamed: U2.2 (J), U15.1
unnamed: U2.14 (J), U48.13
unnamed: U4.2 (J), U14.13
unnamed: U6.3 (~K), U6.13 (~K), U15.10, U47.9
unnamed: U6.14 (J), U47.8
unnamed: U7.2 (J), U54.3
unnamed: U7.14 (J), U167.12
unnamed: U9.2 (J), U126.8
unnamed: U9.14 (J), U13.8
unnamed: U10.12 (D), U166.5 (Q)
unnamed: U10.9 (Q), U90.12 (D)
unnamed: U8.12, U10.13 (~R), U53.1 (~R), U53.13 (~R), U90.13 (~R), U166.1 (~R), U166.13 (~R)
unnamed: U12.8, U22.11
unnamed: U13.5, U45.8
unnamed: U14.1, U48.12
unnamed: U16.10, U34.8, U52.2
unnamed: U16.12, U23.3
unnamed: U16.13, U52.3
unnamed: U20.10, U43.10
unnamed: U20.12, U23.1
unnamed: U21.15 (~Y0), U125.1
unnamed: U21.14 (~Y1), U125.3
unnamed: U21.13 (~Y2), U125.5
unnamed: U21.12 (~Y3), U125.9
unnamed: U21.7 (~Y7), U119.9
unnamed: U22.6, U48.10
unnamed: U22.8, U27.12, U51.2
unnamed: U25.2 (I0a), U26.5 (Z)
unnamed: U25.5 (I0b), U28.5 (Z)
unnamed: U25.11 (I0c), U29.5 (Z)
unnamed: U26.3 (I1), U31.7 (Za)
unnamed: U23.8, U26.2 (I2)
unnamed: U28.3 (I1), U31.9 (Zb)
unnamed: U23.6, U28.2 (I2)
unnamed: U29.3 (I1), U32.7 (Za)
unnamed: U14.4, U29.2 (I2)
unnamed: U24.3, U31.6 (I0a)
unnamed: U24.6, U31.10 (I0b)
unnamed: U31.4 (I2a), U48.4
unnamed: U24.11, U31.12 (I2b)
unnamed: U31.14 (S0), U32.14 (S0), U33.3
unnamed: U31.2 (S1), U32.2 (S1), U33.6
unnamed: U13.11, U32.6 (I0a)
unnamed: U13.12, U24.2, U24.5, U32.10 (I0b), U34.12
unnamed: U27.4, U32.4 (I2a)
unnamed: U32.9 (Zb), U39.3 (I1)
unnamed: U33.8, U34.1
unnamed: U33.11, U45.9
unnamed: U5.12, U34.9
unnamed: U13.6, U36.2 (J)
unnamed: U36.3 (~K), U36.9 (~Q)
unnamed: U36.12 (C), U47.12
unnamed: U36.15 (~R), U167.8
unnamed: U38.8, U45.13
unnamed: U13.3, U40.13 (~R), U41.1 (~R)
unnamed: U41.13 (~R), U43.11
unnamed: U41.10 (~S), U47.6
unnamed: U44.8, U44.12
unnamed: U44.6, U44.13
unnamed: U8.8, U47.2
unnamed: U47.3, U52.6
unnamed: U51.4, U52.5
unnamed: U53.5 (Q), U53.12 (D)
unnamed: U14.9, U53.6 (~Q)
unnamed: U14.8, U53.9 (Q)
unnamed: U54.5, U82.3
unnamed: U57.12, U91.4, U91.9, U91.12
unnamed: U72.13 (~R), U126.11
unnamed: U75.9 (C4), U78.7 (C0)
unnamed: U78.9 (C4), U81.7 (C0)
unnamed: U78.4 (S1), U85.4 (I2a)
unnamed: U78.1 (S2), U85.12 (I2b)
unnamed: U78.13 (S3), U86.4 (I2a)
unnamed: U78.10 (S4), U86.12 (I2b)
unnamed: U81.4 (S1), U87.4 (I2a)
unnamed: U81.1 (S2), U87.12 (I2b)
unnamed: U81.13 (S3), U88.4 (I2a)
unnamed: U81.10 (S4), U88.12 (I2b)
unnamed: U82.6, U82.13
unnamed: U73.3, U83.6 (I0a)
unnamed: U73.6, U83.10 (I0b)
unnamed: U74.3, U83.5 (I1a)
unnamed: U74.6, U83.11 (I1b)
unnamed: U73.8, U84.6 (I0a)
unnamed: U73.11, U84.10 (I0b)
unnamed: U74.8, U84.5 (I1a)
unnamed: U74.11, U84.11 (I1b)
unnamed: U76.3, U85.6 (I0a)
unnamed: U76.6, U85.10 (I0b)
unnamed: U77.3, U85.5 (I1a)
unnamed: U77.6, U85.11 (I1b)
unnamed: U76.8, U86.6 (I0a)
unnamed: U76.11, U86.10 (I0b)
unnamed: U77.8, U86.5 (I1a)
unnamed: U77.11, U86.11 (I1b)
unnamed: U79.3, U87.6 (I0a)
unnamed: U79.6, U87.10 (I0b)
unnamed: U80.3, U87.5 (I1a)
unnamed: U80.6, U87.11 (I1b)
unnamed: U79.8, U88.6 (I0a)
unnamed: U79.11, U88.10 (I0b)
unnamed: U80.8, U88.5 (I1a)
unnamed: U80.11, U88.11 (I1b)
unnamed: U89.2, U89.6
unnamed: U54.6, U90.3 (C)
unnamed: U105.1, U106.8
unnamed: U105.2, U107.8
unnamed: U105.5, U144.4
unnamed: U105.8, U107.2
unnamed: U43.2, U105.12
unnamed: U105.13, U107.11
unnamed: U106.2, U111.13
unnamed: U106.4, U108.1
unnamed: U107.3, U116.3
unnamed: U107.6, U116.2
unnamed: U108.2, U108.8
unnamed: U108.6, U117.5
unnamed: U108.10, U116.8
unnamed: U108.11, U116.5
unnamed: U109.3, U116.6
unnamed: U109.5, U110.11
unnamed: U109.6, U121.12
unnamed: U109.8, U121.10
unnamed: U110.6, U164.1
unnamed: U111.2, U120.6
unnamed: U111.8, U117.1
unnamed: U112.6, U117.4
unnamed: U56.5, U112.8
unnamed: U82.8, U112.9
unnamed: U91.3, U112.10
unnamed: U112.12, U117.2
unnamed: U113.3, U118.10
unnamed: U113.6, U118.9
unnamed: U113.8, U118.12
unnamed: U113.12, U120.11
unnamed: U113.13, U120.3
unnamed: U114.1 (0), U123.5
unnamed: U114.2 (1), U123.9
unnamed: U114.6 (5), U124.3
unnamed: U114.7 (6), U124.5
unnamed: U114.11 (9), U124.13
unnamed: U117.6, U120.2
unnamed: U118.8, U120.10
unnamed: U119.4, U121.9
unnamed: U56.2, U120.8
unnamed: U121.6, U126.4
unnamed: U56.10, U121.8
unnamed: U54.12, U122.6
unnamed: U125.10, U148.2
unnamed: U16.6, U126.12
unnamed: U127.11, U143.3
unnamed: U128.2, U142.3
unnamed: U128.8, U145.2
unnamed: U133.15 (TC), U134.10 (CET)
unnamed: U134.15 (TC), U135.10 (CET)
unnamed: U126.6, U136.1 (~Mr), U137.1 (~Mr)
unnamed: U54.11, U138.1 (~R)
unnamed: U24.8, U138.10 (~S)
unnamed: U126.3, U139.9 (Cp)
unnamed: U128.12, U139.13 (D3)
unnamed: U127.3, U139.1 (~Mr)
unnamed: U142.4, U156.4
unnamed: U142.13, U155.4
unnamed: U143.4, U157.8
unnamed: U143.5, U151.3
unnamed: U89.9, U143.6
unnamed: U27.1, U148.1
unnamed: U27.10, U148.13
unnamed: U151.6, U156.13
unnamed: U152.6, U155.2
unnamed: U152.8, U157.11
unnamed: U152.12, U155.1
unnamed: U154.6, U157.5
unnamed: U154.8, U157.6
unnamed: U154.12, U157.4
unnamed: U156.5, U156.8
unnamed: U71.8, U156.12
unnamed: U47.13, U161.8
unnamed: U164.2, U170.8
unnamed: U14.10, U166.2 (D)
unnamed: U23.11, U167.11
unnamed: U168.1, U168.6
unnamed: U168.2, U168.8
unnamed: U168.4, U168.11
unnamed: U54.8, U171.8
VCC: J1.1, J2.1, J3.1, J4.1, U1.20 (VCC), U2.1 (~R), U2.11 (~S), U2.16 (VCC), U3.5 (~S), U3.11 (~S), U3.16 (VCC), U4.5 (~S), U4.11 (~S), U4.16 (VCC), U5.14 (VCC), U6.5 (~S), U6.11 (~S), U6.16 (VCC), U7.5 (~S), U7.11 (~S), U7.16 (VCC), U8.14 (VCC), U9.5 (~S), U9.11 (~S), U9.16 (VCC), U10.4 (~S), U10.10 (~S), U10.14 (VCC), U11.20 (VCC), U12.14 (VCC), U13.14 (VCC), U14.14 (VCC), U15.14 (VCC), U16.14 (VCC), U17.20 (VCC), U18.20 (VCC), U19.20 (VCC), U20.14 (VCC), U21.6 (E2), U21.16 (VCC), U22.1, U22.2, U22.3, U22.14 (VCC), U23.14 (VCC), U24.14 (VCC), U25.16 (VCC), U26.15 (I4), U26.16 (VCC), U27.14 (VCC), U28.14 (I5), U28.16 (VCC), U29.14 (I5), U29.15 (I4), U29.16 (VCC), U31.13 (I3b), U31.16 (VCC), U32.11 (I1b), U32.16 (VCC), U33.14 (VCC), U34.14 (VCC), U35.20 (VCC), U36.1 (~R), U36.11 (~S), U36.13 (~K), U36.14 (J), U36.16 (VCC), U37.20 (VCC), U38.1, U38.2, U38.3, U38.14 (VCC), U39.1 (I3), U39.12 (I7), U39.13 (I6), U39.16 (VCC), U40.10 (~S), U40.14 (VCC), U41.4 (~S), U41.14 (VCC), U42.14 (VCC), U43.14 (VCC), U44.14 (VCC), U45.14 (VCC), U46.20 (VCC), U47.14 (VCC), U48.14 (VCC), U49.20 (VCC), U50.20 (VCC), U51.14 (VCC), U52.14 (VCC), U53.2 (D), U53.4 (~S), U53.10 (~S), U53.14 (VCC), U54.14 (VCC), U55.14 (VCC), U56.14 (VCC), U57.14 (VCC), U58.14 (VCC), U59.14 (VCC), U60.14 (VCC), U61.16 (VCC), U62.16 (VCC), U63.16 (VCC), U64.16 (VCC), U65.16 (VCC), U66.16 (VCC), U67.16 (VCC), U68.1, U68.2, U68.14 (VCC), U69.16 (VCC), U70.16 (VCC), U71.1, U71.2, U71.14 (VCC), U72.4 (~S), U72.10 (~S), U72.14 (VCC), U73.14 (VCC), U74.14 (VCC), U75.16 (VCC), U76.14 (VCC), U77.14 (VCC), U78.16 (VCC), U79.14 (VCC), U80.14 (VCC), U81.16 (VCC), U82.14 (VCC), U83.16 (VCC), U84.16 (VCC), U85.16 (VCC), U86.16 (VCC), U87.16 (VCC), U88.16 (VCC), U89.14 (VCC), U90.1 (~R), U90.4 (~S), U90.10 (~S), U90.14 (VCC), U91.14 (VCC), U92.16 (VCC), U93.16 (VCC), U94.16 (VCC), U95.16 (VCC), U96.16 (VCC), U97.16 (VCC), U98.16 (VCC), U99.16 (VCC), U100.16 (VCC), U101.16 (VCC), U102.16 (VCC), U103.16 (VCC), U104.16 (VCC), U105.14 (VCC), U106.14 (VCC), U107.14 (VCC), U108.14 (VCC), U109.14 (VCC), U110.14 (VCC), U111.14 (VCC), U112.14 (VCC), U113.14 (VCC), U114.16 (VCC), U116.1, U116.14 (VCC), U117.14 (VCC), U118.14 (VCC), U119.14 (VCC), U120.14 (VCC), U121.14 (VCC), U122.14 (VCC), U123.14 (VCC), U124.14 (VCC), U125.14 (VCC), U126.14 (VCC), U127.14 (VCC), U128.14 (VCC), U129.1 (~Mr), U129.16 (VCC), U130.1 (~Mr), U130.16 (VCC), U131.1 (~Mr), U131.16 (VCC), U132.1 (~Mr), U132.16 (VCC), U133.1 (~MR), U133.16 (VCC), U134.1 (~MR), U134.16 (VCC), U135.1 (~MR), U135.16 (VCC), U136.16 (VCC), U137.16 (VCC), U138.4 (~S), U138.14 (VCC), U139.16 (VCC), U140.6 (E2), U140.16 (VCC), U141.14 (VCC), U142.14 (VCC), U143.14 (VCC), U144.14 (VCC), U145.14 (VCC), U146.14 (VCC), U147.14 (VCC), U148.14 (VCC), U149.14 (VCC), U150.14 (VCC), U151.14 (VCC), U152.14 (VCC), U153.14 (VCC), U154.14 (VCC), U155.14 (VCC), U156.14 (VCC), U157.1, U157.2, U157.3, U157.14 (VCC), U158.14 (VCC), U159.14 (VCC), U160.14 (VCC), U161.14 (VCC), U162.20 (VCC), U163.20 (VCC), U164.14 (VCC), U165.1, U165.2, U165.14 (VCC), U166.4 (~S), U166.10 (~S), U166.14 (VCC), U167.14 (VCC), U168.14 (VCC), U169.20 (VCC), U170.14 (VCC), U171.14 (VCC), U175.16 (VCC)

Notes on the sheet:
TS3: ACUM <= ACUM + MBUF
TS4: MADR <= MBUF
TPn on for last 100nS of TSn
begin TS1 when halt not requested and ending TS4 or ending HGNT
TS4 lasts for 400nS
TS3: PCTR <= MBUF
RSEL 0 nop 1 BSW 2 RAL 3 RTL 4 RAR 5 RTR 6,7 zero
inc pc for isz instrs
TS4: MADR <= INBUS (dma addr)
TS2: MBUF <= INBUS (dma data)
begin IOP 100nS after TS2 starts and doing an I/O instruction
clocked on posedge TP4 or jammed when halted and button pressed
halt at end of HLT instruction
end TS1 400nS later
begin HGNT when TS4 ends and halt being requested
TS4: MADR <= 0
sets ALU to compute MADR + 1 _JJ5 sets up the add in TS3 but does not clock into MADR at TP3 _JJ6 continues the add in TS4 then gets clocked into MADR at TP4
resume when LDAD,EXAM,DEPOS pressed then released it halts after that one cycle
begin TS2 when TS1 ends
(efaddr_2)
halt at end of major state being requested * sets just after posedge TP3 * cleared when LDAD/EXAM/DEPOS/CONT/START switch released * sampled just before negedge TP4
6001 (ION)
TS3: ACUM <= ACUM | INBUS (io data)
gate SWREG onto INBUS * during TS3 of Group2 for OSR * while LDAD held down to load MADR * during TS2 while doing deposit
end IOP at end of TS3
begin TS3 when TS2 ends
load pc for jms
TS3: ACUM <= 0
compute next major state
100nS pulse to load MADR 300nS after LDAD/EXAM/DEPOS pressed
TS3: PCTR <= MADR + 1
end TS2 400nS later
LSB
brkcyc sets at TS1 of break cycle clears at TS4 of all cycles
(efaddr_0)
TS2: MBUF <= INBUS (swREG)
jam MS_EXAM/MS_DEPOS into MAJST 400nS after LDAD/EXAM/DEPOS pressed
halt at end of any cycle with SSTEP switch
enable pc load at next pcclk
synchronize PAUSE on negedge clock it will be stable by posedge clock
START with SSTEP just resets START otherwise resets then starts
enable interrupts at TP3 when * enabled by preceding ION, and * not disabled by current IOF, and * doing a fetch cycle (started instr after ION) disable interrupts at TP3 when * doing an intak cycle, or * doing an IOF instruction feeds into brkintfet which is sampled at TP4 to compute next major st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
Clear ACUM for Group1 CLA at TP2
clock in new MADR at TP4 except EXAM and DEPOS cycles
compute major state to follow current instruciton - if dma triple-cycle, output MS_WRDCT=4 - if dma single-cycle, output MS_BREAK=6 - if interrupt, output MS_INTAK=7 - else, output MS_FETCH=1
asserted (low) when doing Group2 CLA
TS3 msfetch group1 IAC
MSB
TS1: MBUF <= INBUS (mem data)
(efaddr_3)
6002 (IOF)
3: ADD,TAD,ISZ,DCA,JMS 2: JMP 1: IOT 0: OPR
TS2: MBUF <= PCTR
state after FETCH for JMP either DEFER or brkintfet
load pc for indir jmp
LDAD pressed: jam EXAM into MAJST gate INBUS to ALUQ then clock ALUQ to MADR,PCTR released: release halt request (hreq) EXAM pressed: jam EXAM into MAJST repeat: gate MADR+1 to ALUQ then clock ALUQ to MADR,PCTR released: release halt request (hreq) DEPOS same as EXAM plus INBUS put in MBUF during T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
load pc for dir jmp
TS4: MADR <= efaddr
not being blocked by memory extension
(efaddr_1)
TS4: MADR <= PCTR
load pc when halted for ldad/exam/depos
load pc for intak
low when doing Group2 with OSR bit low blocking SR coming in on INBUS
TS3: ACUM <= ACUM & MBUF
TS3: PCTR <= efaddr
end HGNT when halt no longer being requested
any of these switches jam in state 100x
compute major state following FETCH
swEXAM: MADR <= MADR + 1
either switch jams in state 000x swSTART at any time swCONT when in DEPOS or EXAM note: swCONT when not DEPOS or EXAM leaves state as is
(efaddr_4)
save overflow bit at TP2 * EXEC: used for ISZ skip must be valid until same TP3 * WRDCT: used for BWCOV must be valid until BREAK TP3
new state for switches: LDAD: EXAM EXAM: EXAM DEPOS: DEPOS START: FETCH CONT: if currently EXAM or DEPOS, FETCH otherwise, leave state as is
load MADR after a 2 cycle delay after LDAD,EXAM,DEPOS LDAD: loads from SR repeat EXAM/DEPOS: load MADR+1
inc pc after fetch
other than depos jams in state xxx1
TS3: ACUM <= ACUM | INBUS (ext arith)
NOT (interrupt request)
TS2: MBUF <= MBUF + 1
end TS3 400nS later
AZERO = AA | BB | CC1 & ACCLR | CC2 & ACCLR | CC3 & G2CLA | EE | FF ASEL_0 (PCTR,MADR) = HH | JJ | LL ASEL_1 (efad,MADR) = HH | JJ | MM BZERO = AA | CC3 & ~G2OSR | HH | JJ | KK | LL | MM | NN BSEL_0 (INBUS) = BB | CC CIN = FF | JJ | NN & MBUF_0 QSEL_0 (AND) = PP1 QSEL_1 (ADD) = FF | JJ | NN | PP2
(efaddr_6)
end-of-instruction indicates current cycle is last of instruction or last of break or interrupt acknowledge endinst = FETCH : JMP: direct JMP IOT: always OPR: non-mem-ref ext arith DEFER : JMP EXEC : always BREAK : always INTAK : always
(efaddr_5)
state after FETCH for OPR EXEC for extarith with memory operand brkintfet for everything else
contx | swSTART: PCTR <= MADR
request halt at TP3 when: * SINST switch on and last cycle of instruction * currently doing an EXAM or DEPOS cycle * STOP switch pressed * SSTEP switch on * FETCH and IR holds an HLT instruction
inc pc for skip instrs
halt at end of instruction with SINST switch
clock pc: ldad pressed tp2 during fetch tp3 must have pcinc or pcld to do anything else it is a nop
asserted (low) when ACCLEAR is asserted (high) and doing IOT or ext arith
Clock ROTQ into ACUM at TP3 * FETCH of IOT instruction * EXEC of AND/TAD/DCA * FETCH of Group1,Group2 * ext arith execute
inc pc for i/o instrs
TS3: ACUM <= ACUM | INBUS (group2)
TS2: MBUF <= ACUM
TS3: ACUM <= ACUM + MBUF_0
AA: ? <= 0 : A=ZERO, B=ZERO, OR BB: ? <= INBUS : A=ZERO, B=INBUS, OR CC: ? <= ACUM | INBUS : A=ACUM, B=INBUS, OR EE: ? <= MBUF : A=ZERO, B=MBUF, OR FF: ? <= MBUF + 1 : A=ZERO, B=MBUF, ADD, CIN=1 HH: ? <= MADR : A=MADR, B=ZERO, OR JJ: ? <= MADR + 1 : A=MADR, B=ZERO, ADD, CIN=1 KK: ? <= ACUM : A=ACUM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
MAJOR STATE 0 : PWRON 1 : FETCH 2 : DEFER 3 : EXEC 4 : WRDCT 5 : CURAD 6 : BREAK 7 : INTAK 8 : DEPOS 9 : EXAM
complement ACUM value * must have Group1 instr * must have CMA bit * must be doing FETCH cycle
asserted (high) to force zero in alua during TS3
TS3: throw_away <= MADR + 1
CONT with SSTEP or SINST does one cycle or instruction
halt at end of exam/depos cycle
inc pc for eae instrs
enable pc inc at next pcclk
swDEPOS: MADR <= MADR + 1
swLDAD: MADR <= INBUS (swREG)
break request clocked at TP3 cleared at TP2 of BREAK cycle
depos jams in state xxx0
current cycle is performing extended arithmetic accumulator and link get clocked at TP3 in these cycles FETCH: must have opcode 111 1xx xxx 001 EXEC: must have opcode 111 xxx xxx xxx it is the only OPR opcode that uses EXEC state
I2: RTR I3: RAR I4: RTL I5: RAL I6: BSW I7: nop
TS4: MADR <= MADR + 1

Board: 2 copper layers, 174 parts (0 on the bottom side), 621 nets, no tracks yet.
