mrieker/pdp8i/kicads/testbd1/testbd1.kicad_pcb

## KiCad design kicads/testbd1/testbd1.kicad_pcb (2026-05-23)

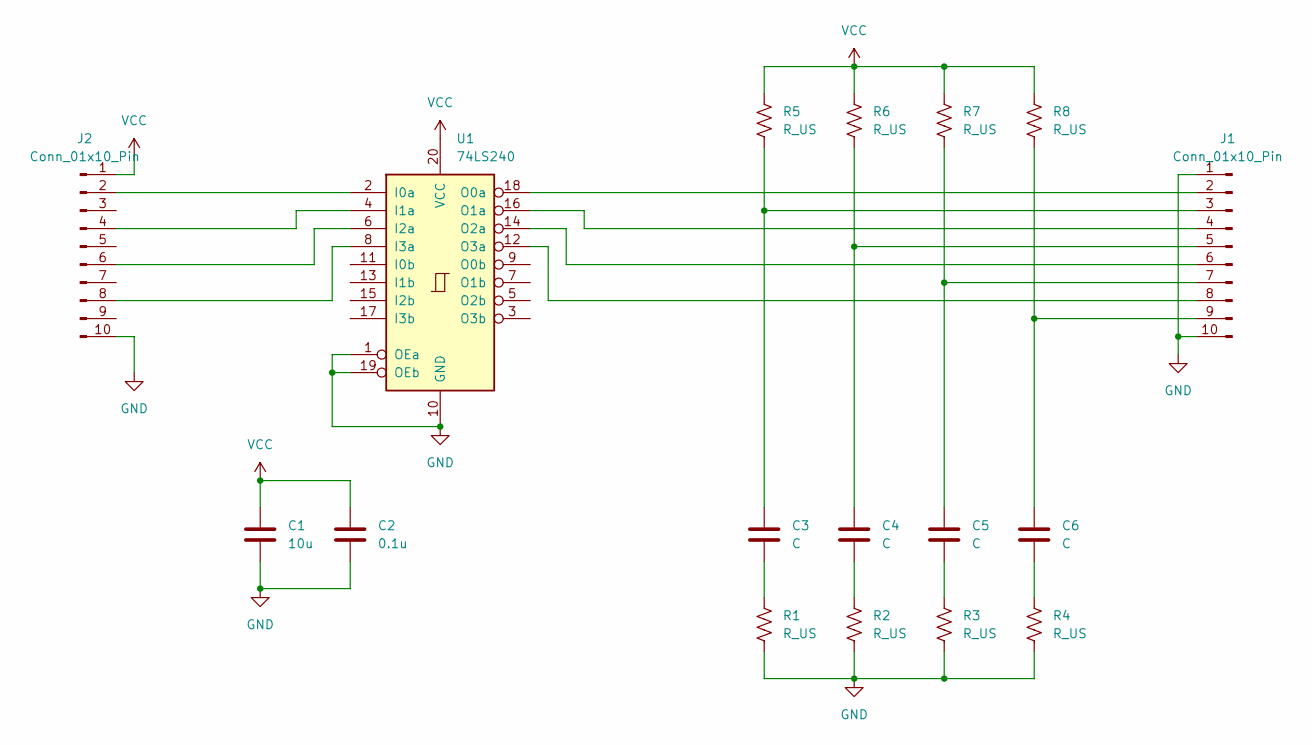
[picture p31: schematic testbd1.kicad_sch]

Parts:
C1: 10u; R_Axial_DIN0207_L6.3mm_D2.5mm_P10.16mm_Horizontal
C2: 0.1u; R_Axial_DIN0207_L6.3mm_D2.5mm_P10.16mm_Horizontal
C3, C4, C5, C6: C; R_Axial_DIN0207_L6.3mm_D2.5mm_P10.16mm_Horizontal
J1, J2: Conn_01x10_Pin; PinHeader_1x10_P2.54mm_Vertical
R1, R2, R3, R4, R5, R6, R7, R8: R_US; R_Axial_DIN0207_L6.3mm_D2.5mm_P10.16mm_Horizontal
U1: 74LS240; DIP-20_W7.62mm

Connections:
GND: C1.2, C2.2, J1.1, J1.10, J2.10, R1.2, R2.2, R3.2, R4.2, U1.1 (OEa), U1.10 (GND), U1.19 (OEb)
unnamed: C3.2, R1.1
unnamed: C4.2, R2.1
unnamed: C5.2, R3.1
unnamed: C6.2, R4.1
unnamed: J1.2, U1.18 (O0a)
unnamed: C3.1, J1.3, R5.2
unnamed: J1.4, U1.16 (O1a)
unnamed: C4.1, J1.5, R6.2
unnamed: J1.6, U1.14 (O2a)
unnamed: C5.1, J1.7, R7.2
unnamed: J1.8, U1.12 (O3a)
unnamed: C6.1, J1.9, R8.2
unnamed: J2.2, U1.2 (I0a)
unnamed: J2.4, U1.4 (I1a)
unnamed: J2.6, U1.6 (I2a)
unnamed: J2.8, U1.8 (I3a)
VCC: C1.1, C2.1, J2.1, R5.1, R6.1, R7.1, R8.1, U1.20 (VCC)
