mrieker/pdp8i/kicads/testbd1/testbd1.kicad_pcb

## KiCad design kicads/testbd1/testbd1.kicad_pcb (continued)

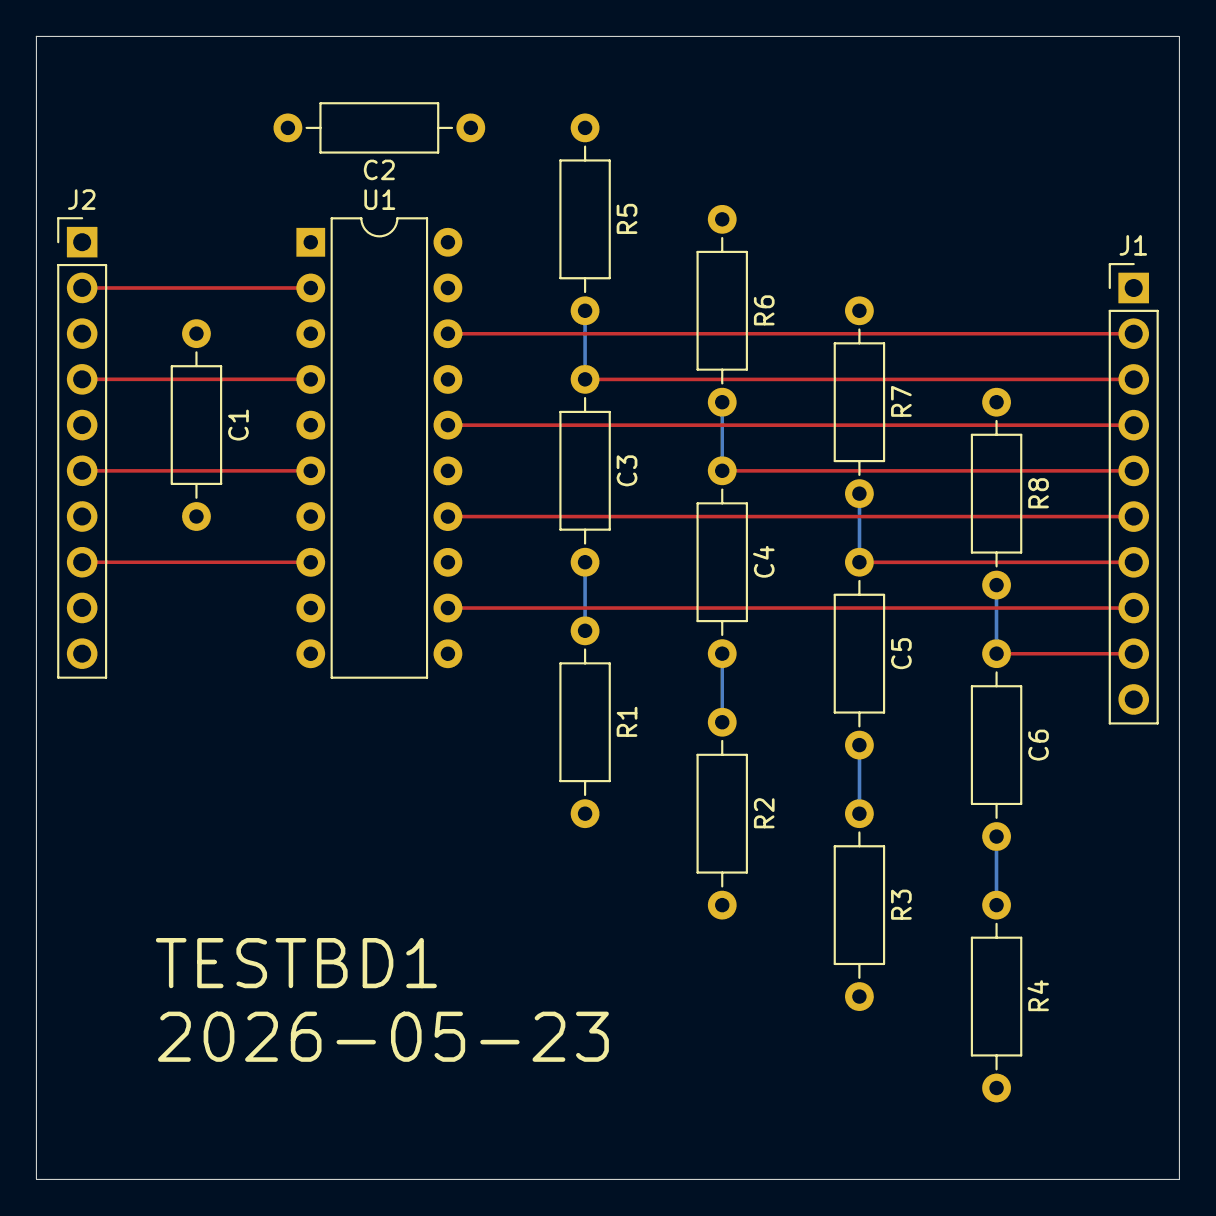
[picture p32: board testbd1.kicad_pcb from above]

Board: 4 copper layers, 63.5 x 63.5 mm, 17 parts (0 on the bottom side), 18 nets.
