mrieker/pdp8i/zynq/signals.xdc

set_property PACKAGE_PIN U7 [get_ports {hdw_oACUM_0[5]}] ; set_property IOSTANDARD LVCMOS33 [get_ports {hdw_oACUM_0[5]}]
set_property PACKAGE_PIN V7 [get_ports {hdw_oMBUF_0[6]}] ; set_property IOSTANDARD LVCMOS33 [get_ports {hdw_oMBUF_0[6]}]
set_property PACKAGE_PIN T9 [get_ports {hdw_oMADR_0[6]}] ; set_property IOSTANDARD LVCMOS33 [get_ports {hdw_oMADR_0[6]}]
set_property PACKAGE_PIN U10 [get_ports {hdw_iINBUS_0[4]}] ; set_property IOSTANDARD LVCMOS33 [get_ports {hdw_iINBUS_0[4]}]
set_property PACKAGE_PIN Y9 [get_ports {hdw_oMADR_0[5]}] ; set_property IOSTANDARD LVCMOS33 [get_ports {hdw_oMADR_0[5]}]
set_property PACKAGE_PIN Y7 [get_ports {hdw_iINBUS_0[5]}] ; set_property IOSTANDARD LVCMOS33 [get_ports {hdw_iINBUS_0[5]}]
set_property PACKAGE_PIN Y8 [get_ports {hdw_oMBUF_0[5]}] ; set_property IOSTANDARD LVCMOS33 [get_ports {hdw_oMBUF_0[5]}]
set_property PACKAGE_PIN Y6 [get_ports {hdw_iINBUS_0[6]}] ; set_property IOSTANDARD LVCMOS33 [get_ports {hdw_iINBUS_0[6]}]
set_property PACKAGE_PIN V11 [get_ports {hdw_oACUM_0[4]}] ; set_property IOSTANDARD LVCMOS33 [get_ports {hdw_oACUM_0[4]}]
set_property PACKAGE_PIN V8 [get_ports {hdw_iINBUS_0[7]}] ; set_property IOSTANDARD LVCMOS33 [get_ports {hdw_iINBUS_0[7]}]
set_property PACKAGE_PIN V10 [get_ports {hdw_oMADR_0[4]}] ; set_property IOSTANDARD LVCMOS33 [get_ports {hdw_oMADR_0[4]}]
set_property PACKAGE_PIN W8 [get_ports {hdw_iINBUS_0[8]}] ; set_property IOSTANDARD LVCMOS33 [get_ports {hdw_iINBUS_0[8]}]
set_property PACKAGE_PIN T11 [get_ports {hdw_oMBUF_0[4]}] ; set_property IOSTANDARD LVCMOS33 [get_ports {hdw_oMBUF_0[4]}]
set_property PACKAGE_PIN T12 [get_ports {hdw_iINBUS_0[9]}] ; set_property IOSTANDARD LVCMOS33 [get_ports {hdw_iINBUS_0[9]}]
set_property PACKAGE_PIN T10 [get_ports {hdw_oACUM_0[3]}] ; set_property IOSTANDARD LVCMOS33 [get_ports {hdw_oACUM_0[3]}]
set_property PACKAGE_PIN U12 [get_ports {hdw_iINBUS_0[10]}] ; set_property IOSTANDARD LVCMOS33 [get_ports {hdw_iINBUS_0[10]}]
set_property PACKAGE_PIN U13 [get_ports {hdw_oMADR_0[3]}] ; set_property IOSTANDARD LVCMOS33 [get_ports {hdw_oMADR_0[3]}]
set_property PACKAGE_PIN V12 [get_ports {hdw_iINBUS_0[11]}] ; set_property IOSTANDARD LVCMOS33 [get_ports {hdw_iINBUS_0[11]}]
set_property PACKAGE_PIN V13 [get_ports {hdw_oMBUF_0[3]}] ; set_property IOSTANDARD LVCMOS33 [get_ports {hdw_oMBUF_0[3]}]
set_property PACKAGE_PIN W13 [get_ports {hdw_oACUM_0[6]}] ; set_property IOSTANDARD LVCMOS33 [get_ports {hdw_oACUM_0[6]}]
set_property PACKAGE_PIN T14 [get_ports {hdw_oACUM_0[2]}] ; set_property IOSTANDARD LVCMOS33 [get_ports {hdw_oACUM_0[2]}]
set_property PACKAGE_PIN P14 [get_ports {hdw_oMBUF_0[7]}] ; set_property IOSTANDARD LVCMOS33 [get_ports {hdw_oMBUF_0[7]}]
set_property PACKAGE_PIN T15 [get_ports {hdw_oMADR_0[2]}] ; set_property IOSTANDARD LVCMOS33 [get_ports {hdw_oMADR_0[2]}]
set_property PACKAGE_PIN W14 [get_ports hdw_iBRKWRM_0] ; set_property IOSTANDARD LVCMOS33 [get_ports hdw_iBRKWRM_0]
set_property PACKAGE_PIN Y14 [get_ports {hdw_iDMAFLD_0[0]}] ; set_property IOSTANDARD LVCMOS33 [get_ports {hdw_iDMAFLD_0[0]}]
set_property PACKAGE_PIN V15 [get_ports {hdw_oMBUF_0[2]}] ; set_property IOSTANDARD LVCMOS33 [get_ports {hdw_oMBUF_0[2]}]
set_property PACKAGE_PIN U15 [get_ports {hdw_iDMAFLD_0[1]}] ; set_property IOSTANDARD LVCMOS33 [get_ports {hdw_iDMAFLD_0[1]}]
set_property PACKAGE_PIN W15 [get_ports {hdw_oACUM_0[1]}] ; set_property IOSTANDARD LVCMOS33 [get_ports {hdw_oACUM_0[1]}]
set_property PACKAGE_PIN N18 [get_ports {hdw_oMADR_0[1]}] ; set_property IOSTANDARD LVCMOS33 [get_ports {hdw_oMADR_0[1]}]
set_property PACKAGE_PIN T16 [get_ports hdw_dmagntd_n_0] ; set_property IOSTANDARD LVCMOS33 [get_ports hdw_dmagntd_n_0]
set_property PACKAGE_PIN P19 [get_ports {hdw_iINBUS_0[3]}] ; set_property IOSTANDARD LVCMOS33 [get_ports {hdw_iINBUS_0[3]}]
set_property PACKAGE_PIN U17 [get_ports {hdw_iDMAFLD_0[2]}] ; set_property IOSTANDARD LVCMOS33 [get_ports {hdw_iDMAFLD_0[2]}]
set_property PACKAGE_PIN U18 [get_ports hdw_oBRKRQST_0] ; set_property IOSTANDARD LVCMOS33 [get_ports hdw_oBRKRQST_0]
set_property PACKAGE_PIN T20 [get_ports hdw_ioenabd_n_0] ; set_property IOSTANDARD LVCMOS33 [get_ports hdw_ioenabd_n_0]
set_property PACKAGE_PIN U19 [get_ports {hdw_oMEAD_0[0]}] ; set_property IOSTANDARD LVCMOS33 [get_ports {hdw_oMEAD_0[0]}]
set_property PACKAGE_PIN U20 [get_ports {hdw_iINBUS_0[2]}] ; set_property IOSTANDARD LVCMOS33 [get_ports {hdw_iINBUS_0[2]}]
set_property PACKAGE_PIN N20 [get_ports {hdw_oMEAD_0[1]}] ; set_property IOSTANDARD LVCMOS33 [get_ports {hdw_oMEAD_0[1]}]
set_property PACKAGE_PIN Y18 [get_ports {hdw_iINBUS_0[1]}] ; set_property IOSTANDARD LVCMOS33 [get_ports {hdw_iINBUS_0[1]}]
set_property PACKAGE_PIN P20 [get_ports {hdw_oMEAD_0[2]}] ; set_property IOSTANDARD LVCMOS33 [get_ports {hdw_oMEAD_0[2]}]
set_property PACKAGE_PIN Y19 [get_ports {hdw_iINBUS_0[0]}] ; set_property IOSTANDARD LVCMOS33 [get_ports {hdw_iINBUS_0[0]}]
set_property PACKAGE_PIN V20 [get_ports {hdw_oMBUF_0[0]}] ; set_property IOSTANDARD LVCMOS33 [get_ports {hdw_oMBUF_0[0]}]
set_property PACKAGE_PIN R16 [get_ports hdw_iACCLEAR_0] ; set_property IOSTANDARD LVCMOS33 [get_ports hdw_iACCLEAR_0]
set_property PACKAGE_PIN W20 [get_ports {hdw_oMADR_0[0]}] ; set_property IOSTANDARD LVCMOS33 [get_ports {hdw_oMADR_0[0]}]
set_property PACKAGE_PIN R17 [get_ports hdw_iIOSKIP_0] ; set_property IOSTANDARD LVCMOS33 [get_ports hdw_iIOSKIP_0]
set_property PACKAGE_PIN W16 [get_ports {hdw_oACUM_0[0]}] ; set_property IOSTANDARD LVCMOS33 [get_ports {hdw_oACUM_0[0]}]
set_property PACKAGE_PIN V16 [get_ports {hdw_oMBUF_0[1]}] ; set_property IOSTANDARD LVCMOS33 [get_ports {hdw_oMBUF_0[1]}]
set_property PACKAGE_PIN B19 [get_ports {hdw_oACUM_0[9]}] ; set_property IOSTANDARD LVCMOS33 [get_ports {hdw_oACUM_0[9]}]
set_property PACKAGE_PIN C20 [get_ports {hdw_oMBUF_0[10]}] ; set_property IOSTANDARD LVCMOS33 [get_ports {hdw_oMBUF_0[10]}]
set_property PACKAGE_PIN A20 [get_ports {hdw_oMADR_0[9]}] ; set_property IOSTANDARD LVCMOS33 [get_ports {hdw_oMADR_0[9]}]
set_property PACKAGE_PIN B20 [get_ports {hdw_oMADR_0[10]}] ; set_property IOSTANDARD LVCMOS33 [get_ports {hdw_oMADR_0[10]}]
set_property PACKAGE_PIN D19 [get_ports {hdw_oMBUF_0[9]}] ; set_property IOSTANDARD LVCMOS33 [get_ports {hdw_oMBUF_0[9]}]
set_property PACKAGE_PIN E17 [get_ports {hdw_oACUM_0[10]}] ; set_property IOSTANDARD LVCMOS33 [get_ports {hdw_oACUM_0[10]}]
set_property PACKAGE_PIN D20 [get_ports {hdw_oACUM_0[8]}] ; set_property IOSTANDARD LVCMOS33 [get_ports {hdw_oACUM_0[8]}]
set_property PACKAGE_PIN D18 [get_ports {hdw_oMBUF_0[11]}] ; set_property IOSTANDARD LVCMOS33 [get_ports {hdw_oMBUF_0[11]}]
set_property PACKAGE_PIN F16 [get_ports {hdw_oMADR_0[8]}] ; set_property IOSTANDARD LVCMOS33 [get_ports {hdw_oMADR_0[8]}]
set_property PACKAGE_PIN E18 [get_ports {hdw_oMADR_0[11]}] ; set_property IOSTANDARD LVCMOS33 [get_ports {hdw_oMADR_0[11]}]
set_property PACKAGE_PIN F17 [get_ports {hdw_oMBUF_0[8]}] ; set_property IOSTANDARD LVCMOS33 [get_ports {hdw_oMBUF_0[8]}]
set_property PACKAGE_PIN E19 [get_ports {hdw_oACUM_0[11]}] ; set_property IOSTANDARD LVCMOS33 [get_ports {hdw_oACUM_0[11]}]
set_property PACKAGE_PIN M17 [get_ports {hdw_oACUM_0[7]}] ; set_property IOSTANDARD LVCMOS33 [get_ports {hdw_oACUM_0[7]}]
set_property PACKAGE_PIN M19 [get_ports spare1_0] ; set_property IOSTANDARD LVCMOS33 [get_ports spare1_0]
set_property PACKAGE_PIN M18 [get_ports {hdw_oMADR_0[7]}] ; set_property IOSTANDARD LVCMOS33 [get_ports {hdw_oMADR_0[7]}]
set_property PACKAGE_PIN M20 [get_ports spare2_0] ; set_property IOSTANDARD LVCMOS33 [get_ports spare2_0]
set_property PACKAGE_PIN K19 [get_ports hdw_iCAINC_0] ; set_property IOSTANDARD LVCMOS33 [get_ports hdw_iCAINC_0]
set_property PACKAGE_PIN L19 [get_ports spare3_0] ; set_property IOSTANDARD LVCMOS33 [get_ports spare3_0]
set_property PACKAGE_PIN J19 [get_ports hdw_iCYCLE3_0] ; set_property IOSTANDARD LVCMOS33 [get_ports hdw_iCYCLE3_0]
set_property PACKAGE_PIN L20 [get_ports hdw_iCONSCK_0] ; set_property IOSTANDARD LVCMOS33 [get_ports hdw_iCONSCK_0]
set_property PACKAGE_PIN K17 [get_ports hdw_oBUSINI_0] ; set_property IOSTANDARD LVCMOS33 [get_ports hdw_oBUSINI_0]
set_property PACKAGE_PIN L16 [get_ports hdw_bCONSDA_0] ; set_property IOSTANDARD LVCMOS33 [get_ports hdw_bCONSDA_0]
set_property PACKAGE_PIN K18 [get_ports hdw_oBWCOV_0] ; set_property IOSTANDARD LVCMOS33 [get_ports hdw_oBWCOV_0]
set_property PACKAGE_PIN L17 [get_ports hdw_oBRKCYC_0] ; set_property IOSTANDARD LVCMOS33 [get_ports hdw_oBRKCYC_0]
set_property PACKAGE_PIN J18 [get_ports hdw_oIOP_0] ; set_property IOSTANDARD LVCMOS33 [get_ports hdw_oIOP_0]
set_property PACKAGE_PIN H16 [get_ports hdw_oBRKGNTI_0] ; set_property IOSTANDARD LVCMOS33 [get_ports hdw_oBRKGNTI_0]
set_property PACKAGE_PIN H18 [get_ports hdw_oLINK_0] ; set_property IOSTANDARD LVCMOS33 [get_ports hdw_oLINK_0]
set_property PACKAGE_PIN H17 [get_ports hdw_oTP4_0] ; set_property IOSTANDARD LVCMOS33 [get_ports hdw_oTP4_0]
set_property PACKAGE_PIN G17 [get_ports hdw_oRUN_0] ; set_property IOSTANDARD LVCMOS33 [get_ports hdw_oRUN_0]
set_property PACKAGE_PIN F19 [get_ports hdw_oTP3_0] ; set_property IOSTANDARD LVCMOS33 [get_ports hdw_oTP3_0]
set_property PACKAGE_PIN G18 [get_ports {hdw_oMAJST_0[3]}] ; set_property IOSTANDARD LVCMOS33 [get_ports {hdw_oMAJST_0[3]}]
set_property PACKAGE_PIN F20 [get_ports hdw_oTP2_0] ; set_property IOSTANDARD LVCMOS33 [get_ports hdw_oTP2_0]
set_property PACKAGE_PIN G19 [get_ports {hdw_oMAJST_0[2]}] ; set_property IOSTANDARD LVCMOS33 [get_ports {hdw_oMAJST_0[2]}]
set_property PACKAGE_PIN J20 [get_ports hdw_oTP1_0] ; set_property IOSTANDARD LVCMOS33 [get_ports hdw_oTP1_0]
set_property PACKAGE_PIN G20 [get_ports {hdw_oMAJST_0[1]}] ; set_property IOSTANDARD LVCMOS33 [get_ports {hdw_oMAJST_0[1]}]
set_property PACKAGE_PIN H20 [get_ports hdw_oTS4_0] ; set_property IOSTANDARD LVCMOS33 [get_ports hdw_oTS4_0]
set_property PACKAGE_PIN K14 [get_ports hdw_iMEMDIS_0] ; set_property IOSTANDARD LVCMOS33 [get_ports hdw_iMEMDIS_0]
set_property PACKAGE_PIN H15 [get_ports hdw_oTS3_0] ; set_property IOSTANDARD LVCMOS33 [get_ports hdw_oTS3_0]
set_property PACKAGE_PIN J14 [get_ports hdw_iBRKRQST_0] ; set_property IOSTANDARD LVCMOS33 [get_ports hdw_iBRKRQST_0]
set_property PACKAGE_PIN G15 [get_ports hdw_oTS2_0] ; set_property IOSTANDARD LVCMOS33 [get_ports hdw_oTS2_0]
set_property PACKAGE_PIN L14 [get_ports hdw_poweron_n_0] ; set_property IOSTANDARD LVCMOS33 [get_ports hdw_poweron_n_0]
set_property PACKAGE_PIN N15 [get_ports hdw_oTS1_0] ; set_property IOSTANDARD LVCMOS33 [get_ports hdw_oTS1_0]
set_property PACKAGE_PIN L15 [get_ports hdw_iCLOCK_0] ; set_property IOSTANDARD LVCMOS33 [get_ports hdw_iCLOCK_0]
set_property PACKAGE_PIN N16 [get_ports {hdw_oMAJST_0[0]}] ; set_property IOSTANDARD LVCMOS33 [get_ports {hdw_oMAJST_0[0]}]
set_property PACKAGE_PIN K16 [get_ports hdw_iRESET_0] ; set_property IOSTANDARD LVCMOS33 [get_ports hdw_iRESET_0]
set_property PACKAGE_PIN M14 [get_ports hdw_iBRKGNTO_0] ; set_property IOSTANDARD LVCMOS33 [get_ports hdw_iBRKGNTO_0]
set_property PACKAGE_PIN J16 [get_ports hdw_iPAUSE_0] ; set_property IOSTANDARD LVCMOS33 [get_ports hdw_iPAUSE_0]
set_property PACKAGE_PIN M15 [get_ports hdw_iINTRQST_0] ; set_property IOSTANDARD LVCMOS33 [get_ports hdw_iINTRQST_0]
