mrieker/pdp8i/zynq/ledpins.xdc

set_property PACKAGE_PIN Y16 [get_ports LEDoutG_N_0]
set_property PACKAGE_PIN Y17 [get_ports LEDoutB_N_0]
set_property PACKAGE_PIN R14 [get_ports LEDoutR_N_0]
set_property IOSTANDARD LVCMOS33 [get_ports LEDoutB_N_0]
set_property IOSTANDARD LVCMOS33 [get_ports LEDoutG_N_0]
set_property IOSTANDARD LVCMOS33 [get_ports LEDoutR_N_0]
