mrieker/pdp8i/ccode/z8isys.cc

//    Copyright (C) Mike Rieker, Beverly, MA USA
//    www.outerworldapps.com
//
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
//    EXPECT it to FAIL when someone's HeALTh or PROpeRTy is at RISk.
//
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
//    http://www.gnu.org/licenses/gpl-2.0.html

// Performs system call functions for the PDP-8/I

#include <errno.h>
#include <fcntl.h>
#include <poll.h>
#include <signal.h>
#include <stdint.h>
#include <stdio.h>
#include <stdlib.h>
#include <string.h>
#include <sys/mman.h>
#include <sys/stat.h>
#include <sys/time.h>
#include <termios.h>
#include <unistd.h>

#include "disassemble.h"
#include "z8idefs.h"
#include "z8iutil.h"

static char const *const msnames[16] = { MS_NAMES };

static uint32_t lastcount;
static Z8IU32 *pdpat;
static Z8IU32 *syat;

static uint16_t sysioinstr (uint16_t opcode, uint16_t input);
static void checkcount (uint32_t sy1);
static uint16_t dosyscall (uint16_t data);
static uint16_t readmemword (uint16_t addr12);
//static void writememword (uint16_t addr12, uint16_t data);

int main (int argc, char **argv)
{
    setlinebuf (stdout);

    bool killit = false;
    for (int i = 0; ++ i < argc;) {
        if (strcmp (argv[i], "-?") == 0) {
            puts ("");
            puts ("     System call daemon");
            puts ("");
            puts ("  ./z8isys [-killit]");
            puts ("     -killit : kill other process that is processing system calls");
            puts ("");
            return 0;
        }
        if (strcasecmp (argv[i], "-killit") == 0) {
            killit = true;
            continue;
        }
        if (argv[i][0] == '-') {
            fprintf (stderr, "unknown option %s\n", argv[i]);
            return 1;
        }
        fprintf (stderr, "unknown argument %s\n", argv[i]);
        return 1;
    }

    // access 4K register page
    pdpat = z8ipage.findev ("8I", NULL, NULL, false);
    syat  = z8ipage.findev ("SY", NULL, NULL, true, killit);

    syat[1] = sy1_enable;

    lastcount = 0xBAADF00D;
    while (true) {

        // wait for PDP to do one of our I/O instructions
        // pdp8isys.v sets the PAUSE bit so the processor pauses whilst we execute
        z8ipage.waitint (ZGINT_SY);
        uint32_t sy1 = syat[1];
        if (sy1 & sy1_pause) {
            checkcount (sy1);

            // execute the syscall
            uint32_t cputodev = EXT (pdpat[Z_RF], f_oACUM);
            uint32_t ioopcode = EXT (pdpat[Z_RE], e_oMBUF);
            uint32_t devtocpu = sysioinstr (ioopcode, cputodev);
            // return the result without the PAUSE bit so the processor will resume
            syat[1] = sy1_enable | INS (devtocpu, sy1_devtocpu) | sy1_acclear | INS (devtocpu >> 12, sy1_ioskip);
        }
    }
    return 0;
}

static uint16_t sysioinstr (uint16_t opcode, uint16_t input)
{
    if ((opcode & 07770) != 06310) ABORT ();

    switch (opcode) {

        // PIOFF - turn printinstr off
        case 06310: {
            break;
        }

        // PION - turn printinstr on
        case 06311: {
            uint32_t saveclkratm1 = EXT (pdpat[Z_RD], d_clkratm1);
            pdpat[Z_RD] &= ~ d_clkratm1;                // turn off 10MHz clock
            syat[1] = sy1_enable;                       // release the PAUSE signal
            uint32_t ts1step = 9;
            uint32_t ts2step = 9;
            while (true) {

                // clock processor through a 100nS cycle
                // assume clock has been low for at least 50nS
                uint32_t rd = pdpat[Z_RD];
                pdpat[Z_RD] = rd |   d_arm_iCLOCK;      // drive clock high
                ASSERT (h_100MHz == 0xFFFFFFFFU);
                uint32_t old100 = pdpat[Z_RH];          // wait at least 50nS
                while (pdpat[Z_RH] - old100 <= (saveclkratm1 + 1) / 2) { }
                pdpat[Z_RD] = rd & ~ d_arm_iCLOCK;      // drive clock low
                old100 = pdpat[Z_RH];                   // wait at least 50nS
                while (pdpat[Z_RH] - old100 <= (saveclkratm1 + 1) / 2) { }

                // get flags
                uint32_t re = pdpat[Z_RE];
                uint32_t rf = pdpat[Z_RF];

                // suppress output while halted
                if (rf & f_oRUN) {

                    // print cycle information
                    uint32_t majst = EXT (rf, f_oMAJST);
                    uint32_t acum  = EXT (rf, f_oACUM);
                    uint32_t madr  = EXT (re, e_oMADX);
                    uint32_t mbuf  = EXT (re, e_oMBUF);
                    printf ("pion: TS=%c%c%c%c%c%c%c%c MS=%X L.AC=%o.%04o MA=%05o MB=%04o",
                        EXT (rf, f_oTP1) ? '>' : ' ', EXT (rf, f_oTS1) ? '1' : ' ',
                        EXT (rf, f_oTP2) ? '>' : ' ', EXT (rf, f_oTS2) ? '2' : ' ',
                        EXT (rf, f_oTP3) ? '>' : ' ', EXT (rf, f_oTS3) ? '3' : ' ',
                        EXT (rf, f_oTP4) ? '>' : ' ', EXT (rf, f_oTS4) ? '4' : ' ',
                        majst,
                        EXT (rf, f_oLINK),
                        acum,
                        madr,
                        mbuf);

                    ts1step = EXT (rf, f_oTS1) ? ts1step + 1 : 0;
                    ts2step = EXT (rf, f_oTS2) ? ts2step + 1 : 0;
                    if  (ts1step == 1) printf ("  %s", msnames[majst]);
                    if ((ts2step == 1) && (majst == MS_FETCH)) {
                        std::string dis = disassemble (mbuf, madr & 07777);
                        printf ("    %05o: %s", madr, dis.c_str ());
                    }
                    putchar ('\n');

                    // maybe it's a nested call
                    uint32_t sy1 = syat[1];
                    if (sy1 & sy1_pause) {
                        checkcount (sy1);
                        if (mbuf == 06310) {                // PIOFF stops it
                            input = acum;
                            break;
                        }
                        if (mbuf != 06311) {                // ignore redundant PIONs
                            acum = sysioinstr (mbuf, acum); // process syscall
                        }
                        syat[1] = sy1_enable | INS (acum, sy1_devtocpu) | sy1_acclear | INS (acum >> 12, sy1_ioskip);
                    }
                }
            }
            pdpat[Z_RD] |= INS (saveclkratm1, d_clkratm1);  // restore 10MHz clock
            break;
        }

        // HCF - dump everything and exit
        case 06312: {
            uint32_t now = time (NULL);
            char hcfname[16];
            sprintf (hcfname, "%u.hcf", now);
            printf ("SysCall::ioinstr: HCF AC=%04o MA=%05o => %s\n", input & 07777, EXT (pdpat[Z_RE], e_oMADX), hcfname);
            FILE *hcffile = fopen (hcfname, "w");
            if (hcffile == NULL) {
                fprintf (stderr, "SysCall::ioinstr: error creating %s: %m\n", hcfname);
            } else {
                for (uint32_t i = 0; i < 32768; i += 16) {
                    for (uint32_t j = 0; j < 16; j ++) {
                        if (readmemword (i + j) != 0) goto nonz;
                    }
                    continue;
                nonz:;
                    fprintf (hcffile, "  %05o:", i);
                    for (uint32_t j = 0; j < 16; j ++) {
                        fprintf (hcffile, " %04o", readmemword (i + j));
                    }
                    fprintf (hcffile, "  <");
                    for (uint32_t j = 0; j < 16; j ++) {
                        char c = readmemword (i + j) & 0177;
                        if ((c < ' ') || (c > 0176)) c = '.';
                        fprintf (hcffile, "%c", c);
                    }
                    fprintf (hcffile, ">\n");
                }
            }
            exit (1);
            break;
        }

        case 06314: {
            input = dosyscall (input);
            break;
        }

        default: {
            input = -1;
            break;
        }
    }
    return input;
}

static void checkcount (uint32_t sy1)
{
    // counter should be incremented exactly by 1
    uint32_t thiscount = EXT (sy1, sy1_counter);
    if ((lastcount != 0xBAADF00D) && (((thiscount - lastcount) & 0xFFU) != 1)) {
        fprintf (stderr, "z8isys: thiscount=%08X lastcount=%08X diff not 1\n", thiscount, lastcount);
        ABORT ();
    }
    lastcount = thiscount;
}

static uint16_t dosyscall (uint16_t data)
{
    return data;
}

#if 000

#define SCN_EXIT 0
#define SCN_PRINTLN6 1
#define SCN_PRINTLN8 2
#define SCN_PRINTLN12 3
#define SCN_INTREQ 4
#define SCN_CLOSE 5
#define SCN_GETNOWNS 6
#define SCN_OPEN6 7
#define SCN_OPEN8 8
#define SCN_OPEN12 9
#define SCN_READ6 10
#define SCN_READ8 11
#define SCN_READ12 12
#define SCN_WRITE6 13
#define SCN_WRITE8 14
#define SCN_WRITE12 15
#define SCN_IRQATNS 16
#define SCN_INTACK 17
#define SCN_UNLINK6 18
#define SCN_UNLINK8 19
#define SCN_UNLINK12 20
#define SCN_GETCMDARG6 21
#define SCN_GETCMDARG8 22
#define SCN_GETCMDARG12 23
#define SCN_ADD_DDD 24
#define SCN_ADD_FFF 25
#define SCN_SUB_DDD 26
#define SCN_SUB_FFF 27
#define SCN_MUL_DDD 28
#define SCN_MUL_FFF 29
#define SCN_DIV_DDD 30
#define SCN_DIV_FFF 31
#define SCN_CMP_DD 32
#define SCN_CMP_FF 33
#define SCN_CVT_FP 34
#define SCN_UDIV 35
#define SCN_UMUL 36
#define SCN_PRINTINSTR 37
#define SCN_NEG_DD 38
#define SCN_NEG_FF 39
#define SCN_GETENV6 41
#define SCN_GETENV8 42
#define SCN_GETENV12 43
#define SCN_SETTTYECHO 44
#define SCN_IRQATTS 45
#define SCN_READLN6 46
#define SCN_READLN8 47
#define SCN_READLN12 48

static bool lineclockrun;
static pthread_cond_t lineclockcond = PTHREAD_COND_INITIALIZER;
static pthread_mutex_t lineclocklock = PTHREAD_MUTEX_INITIALIZER;
static struct timespec lineclockabs;
static uint16_t savederrno;

static void scnprintln (GetStrz *getstrz, uint16_t data, uint8_t *temp);
static uint16_t scnopen (GetStrz *getstrz, uint16_t data, uint8_t *temp);
static uint16_t scnread (PutBuf *putbuf, uint16_t data, uint8_t *temp);
static uint16_t scnreadln (PutBuf *putbuf, uint16_t data, uint8_t *temp);
static uint16_t scnwrite (GetBuf *getbuf, uint16_t data, uint8_t *temp);
static uint16_t scnunlink (GetStrz *getstrz, uint16_t data, uint8_t *temp);
static uint16_t scngetcmdarg (PutBuf *putbuf, uint16_t data);
static uint16_t scngetenv (GetStrz *getstrz, PutBuf *putbuf, uint16_t data, uint8_t *temp);
static void *lineclockthread (void *dummy);

static uint16_t dosyscall (uint16_t data)
{
    // we can only get/put data in the externmem array in zynq.v
    // we do not have access to the memory chips on extmemory.kicad_sch
    // ...cuz the processor is paused and cannot do break (dma) cycles
    if (! (pdpat[Z_RE] & e_fpgamemen)) {
        fprintf (stderr, "z8isys: fpgamem must be enabled\n");
        ABORT ();
    }

    uint8_t temp[8193];                 // 8193 = whole frame of 6-bit chars + null terminator

    // accumulator holds the param block address
    uint16_t scn = readmemword (data);  // word at that address has sys call number

    switch (scn) {

        // exit() system call
        case SCN_EXIT: {
            static char hrbuff[16];
            data = readmemword (data + 1);
            snprintf (hrbuff, sizeof hrbuff, "SCN_EXIT:%04o", data);
            if (! scriptmode) {
                fprintf (stderr, "z8isys: %s\n", hrbuff);
                exit (data);
            }
            bool sigint = ctl_lock ();
            stopreason  = hrbuff;
            stopflags  |= SF_STOPIT;
            ctl_unlock (sigint);
            break;
        }

        // print string with a newline
        //  .word   SCN_PRINTLN{6,8,12}
        //  .word   messageaddress
        case SCN_PRINTLN6:  { scnprintln (getstrz6,  data, temp); break; }   // - each character occupies  6 bits
        case SCN_PRINTLN8:  { scnprintln (getstrz8,  data, temp); break; }   // - each character occupies  8 bits
        case SCN_PRINTLN12: { scnprintln (getstrz12, data, temp); break; }   // - each character occupies 12 bits

        // force interrupt request
        //  .word   SCN_INTREQ
        //  .word   0: negate; 1: assert
        case SCN_INTREQ: {
            uint16_t code = readmemword (data + 1);
            fprintf (stderr, "z8isys: SCN_INTREQ:%s\n", ((code != 0) ? "true" : "false"));
            if (code != 0) setintreqmask (IRQ_SCNINTREQ);
                      else clrintreqmask (IRQ_SCNINTREQ);
            break;
        }

        // close() system call
        case SCN_CLOSE: {
            int fd = (readmemword (data + 1) ^ 2048) - 2048;
            if (fd <= 2) fd = -999;
            int rc = close (fd);
            data = rc & 017777;
            if (rc < 0) savederrno = errno;
            savedtermioss.erase (fd);
            break;
        }

        // get time via clock_gettime(CLOCK_REALTIME), ie, unix timestamp
        //  .word   SCN_GETNOW
        //  .word   addr of uint48_t that gets the current timestamp
        //              <47:12> = seconds since 1970-01-01 00:00 UTC'
        //              <11:00> = 1/4096ths second
        case SCN_GETNOWNS: {
            struct timespec nowts;
            if (clock_gettime (CLOCK_REALTIME, &nowts) < 0) ABORT ();
            writememquad (readmemword (data + 1), (nowts.tv_sec * 4096ULL) + nowts.tv_nsec * 4096ULL / 1000000000);
            data = 0;
            break;
        }

        // open() system call
        //  .word   pathaddress
        //  .word   flags
        //  .word   mode
        case SCN_OPEN6:   { data = scnopen  (getstrz6,  data, temp); break; }
        case SCN_OPEN8:   { data = scnopen  (getstrz8,  data, temp); break; }
        case SCN_OPEN12:  { data = scnopen  (getstrz12, data, temp); break; }

        // read() system call
        //  .word   fd
        //  .word   buffaddress
        //  .word   8-bit-byte-count
        case SCN_READ6:   { data = scnread (putbuf6,   data, temp); break; }
        case SCN_READ8:   { data = scnread (putbuf8,   data, temp); break; }
        case SCN_READ12:  { data = scnread (putbuf12,  data, temp); break; }

        // read() system call
        //  .word   fd
        //  .word   buffaddress
        //  .word   8-bit-byte-count
        case SCN_READLN6:   { data = scnreadln (putbuf6,   data, temp); break; }
        case SCN_READLN8:   { data = scnreadln (putbuf8,   data, temp); break; }
        case SCN_READLN12:  { data = scnreadln (putbuf12,  data, temp); break; }

        // write() system call
        //  .word   fd
        //  .word   buffaddress
        //  .word   8-bit-byte-count
        case SCN_WRITE6:  { data = scnwrite (getbuf6,   data, temp); break; }
        case SCN_WRITE8:  { data = scnwrite (getbuf8,   data, temp); break; }
        case SCN_WRITE12: { data = scnwrite (getbuf12,  data, temp); break; }

        // request interrupt at given time
        //  .word   SCN_IRQATTS
        //  .word   addr of uint48_t when to interrupt or 0 to stop
        case SCN_IRQATTS: {
            uint16_t irqataddr = readmemword (data + 1);
            uint64_t irqatts = readmemquad (irqataddr);
            pthread_mutex_lock (&lineclocklock);
            clrintreqmask (IRQ_LINECLOCK);
            if (irqatts != 0) {
                lineclockabs.tv_sec  = irqatts / 4096;
                lineclockabs.tv_nsec = ((irqatts % 4096) * 1000000000ULL) / 4096;
                if (! lineclockrun) {
                    pthread_t pid;
                    int rc = createthread (&pid, lineclockthread, NULL);
                    if (rc != 0) ABORT ();
                    pthread_detach (pid);
                    lineclockrun = true;
                }
            } else {
                memset (&lineclockabs, 0, sizeof lineclockabs);
            }
            pthread_cond_broadcast (&lineclockcond);
            pthread_mutex_unlock (&lineclocklock);
            data = 0;
            break;
        }

        // get mask of interrupting devices
        case SCN_INTACK: {
            data = getintreqmask () & 07777;
            break;
        }

        // unlink() system call
        //  .word   SCN_UNLINK{6,8,12}
        //  .word   address-of-path
        case SCN_UNLINK6:  { data = scnunlink (getstrz6,  data, temp); break; }
        case SCN_UNLINK8:  { data = scnunlink (getstrz8,  data, temp); break; }
        case SCN_UNLINK12: { data = scnunlink (getstrz12, data, temp); break; }

        // get command line arguments following oct filename
        //  .word   SCN_GETCMDARG{6,8,12}
        //  .word   argindex
        //  .word   buffersize
        //  .word   bufferaddr or null
        // returns:
        //     -1 : beyond end
        //   else : length of item (might be gt buffersize)
        case SCN_GETCMDARG6:  { data = scngetcmdarg (putbuf6,  data); break; }
        case SCN_GETCMDARG8:  { data = scngetcmdarg (putbuf8,  data); break; }
        case SCN_GETCMDARG12: { data = scngetcmdarg (putbuf12, data); break; }

        // floatingpoint functions
        //  .word   uint16_t SCN_xxx_DDD
        //  .word   double *resultaddr
        //  .word   double *leftopaddr
        //  .word   double *riteopaddr
        case SCN_ADD_DDD:
        case SCN_SUB_DDD:
        case SCN_MUL_DDD:
        case SCN_DIV_DDD: {
            double leftop = readmemdoub (readmemword (data + 4));
            double riteop = readmemdoub (readmemword (data + 6));
            double result;
            switch (scn) {
                case SCN_ADD_DDD: result = leftop + riteop; break;
                case SCN_SUB_DDD: result = leftop - riteop; break;
                case SCN_MUL_DDD: result = leftop * riteop; break;
                case SCN_DIV_DDD: result = leftop / riteop; break;
                default: ABORT ();
            }
            writememdoub (readmemword (data + 2), result);
            break;
        }

        //  .word   uint16_t SCN_xxx_FFF
        //  .word   float *resultaddr
        //  .word   float *leftopaddr
        //  .word   float *riteopaddr
        case SCN_ADD_FFF:
        case SCN_SUB_FFF:
        case SCN_MUL_FFF:
        case SCN_DIV_FFF: {
            float leftop = readmemflt (readmemword (data + 4));
            float riteop = readmemflt (readmemword (data + 6));
            float result;
            switch (scn) {
                case SCN_ADD_FFF: result = leftop + riteop; break;
                case SCN_SUB_FFF: result = leftop - riteop; break;
                case SCN_MUL_FFF: result = leftop * riteop; break;
                case SCN_DIV_FFF: result = leftop / riteop; break;
                default: ABORT ();
            }
            writememflt (readmemword (data + 2), result);
            break;
        }

        //  .word   uint16_t SCN_CMP_DD
        //  .word   uint16_t comparecode
        //  .word   double *leftopaddr
        //  .word   double *riteopaddr
        case SCN_CMP_DD: {
            uint16_t code = readmemword (data + 2);
            double leftop = readmemdoub (readmemword (data + 4));
            double riteop = readmemdoub (readmemword (data + 6));
            int res = -1;
            switch (code >> 4) {
                case 0: res = leftop >= riteop; break;
                case 1: res = leftop >  riteop; break;
                case 2: res = leftop != riteop; break;
            }
            data = (res ^ ((code >> 3) & 1)) & 017777;
            break;
        }

        //  .word   uint16_t SCN_CMP_FF
        //  .word   uint16_t comparecode
        //  .word   float *leftopaddr
        //  .word   float *riteopaddr
        case SCN_CMP_FF: {
            uint16_t code = readmemword (data + 2);
            float leftop  = readmemflt (readmemword (data + 4));
            float riteop  = readmemflt (readmemword (data + 6));
            int res = -1;
            switch (code >> 4) {
                case 0: res = leftop >= riteop; break;
                case 1: res = leftop >  riteop; break;
                case 2: res = leftop != riteop; break;
            }
            data = (res ^ ((code >> 3) & 1)) & 017777;
            break;
        }

        //  .word   uint16_t SCN_CVT_PF
        //  .word   result       w W z : by value ; else : by ref
        //  .word   operand      w W   : by value ; else : by ref
        //  .word   operandtype  w W l L q Q f d
        //  .word   resulttype   w W l L q Q f d z
        case SCN_CVT_FP: {
            uint16_t r0 = readmemword (data + 1);
            uint16_t r1 = readmemword (data + 2);
            uint32_t r2 = readmemlong (data + 3);
            double value = 0.0;
            switch (r2 & 07777) {
                case 'b': value = (double)  (int8_t) r1; break;
                case 'B': value = (double)  (uint8_t) r1; break;
                case 'w': value = (double) (int16_t) r1; break;
                case 'W': value = (double) (uint16_t) r1; break;
                case 'l': value = (double) (int32_t) readmemlong (r1); break;
                case 'L': value = (double) (uint32_t) readmemlong (r1); break;
                case 'q': value = (double) (int64_t) readmemquad (r1); break;
                case 'Q': value = (double) (uint64_t) readmemquad (r1); break;
                case 'f': value = (double)            readmemflt  (r1); break;
                case 'd': value = (double)            readmemdoub (r1); break;
                default: fprintf (stderr, "z8isys: invalid SCN_CVT_FP from %c\n", r2 & 0xFF);
            }
            switch (r2 >> 12) {
                case 'b': r0 = (int16_t) (int8_t) value; break;
                case 'B': r0 = (uint16_t) (uint8_t) value; break;
                case 'w': r0 = (int16_t) value; break;
                case 'W': r0 = (uint16_t) value; break;
                case 'l': writememlong (r0, (int32_t) value); break;
                case 'L': writememlong (r0, (uint32_t) value); break;
                case 'q': writememquad (r0, (int64_t) value); break;
                case 'Q': writememquad (r0, (uint64_t) value); break;
                case 'f': writememflt  (r0, (float)    value); break;
                case 'd': writememdoub (r0, (double)   value); break;
                case 'z': r0 = (value != 0.0);
                default: fprintf (stderr, "z8isys: invalid SCN_CVT_FP to %c\n", r2 >> 8);
            }
            data = r0 & 07777;
            break;
        }
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
