mrieker/pdp8i/(commit log)

2026-02-04 add simtest.sh and simtest.tcl simulator test script
    runs simulator with random instructions
    also includes assemble and disassemble TCL commands
2026-02-06 get HLT simtest working
    and fix IOP2/IOP4 overlap
    clean up some simtest.tcl code
    [backplane.v, verimain.cc]
2026-02-06 move randbits to C code
    seems TCL has memory leakage issues with 64-bit numbers
    [verimain.cc]
2026-02-10 add extended arithmetic support to processor
    expects ext arith board to process opcode and put result on io bus by TP3
    in either FETCH (non-memory opcode) or EXEC cycle (with memory opcode)
2026-02-13 clean up clock and reset signals
    clok2 = 10MHz clock signal
    reset = power-on reset signal
    [backplane.v, verimain.cc]
2026-03-12 add processor and registers schematics
    - processor really just has the timing and major state
    - registers has the registers and alu
    [processor.kicad_pcb, processor.kicad_sch, registers.kicad_pcb, registers.kicad_sch]
2026-03-12 get a couple instructions working with verisim/simtest.sh script
    [processor.kicad_pcb, processor.kicad_sch, registers.kicad_pcb, registers.kicad_sch]
2026-03-12 get a few more instructions of simtest.sh working
    [registers.kicad_pcb, registers.kicad_sch]
2026-03-12 get more cycles working in processors.kicad_sch and registers.kicad_sch
    test with verisim/simtest.sh
    [processor.kicad_pcb, processor.kicad_sch, registers.kicad_pcb, registers.kicad_sch]
2026-03-12 get more cycles working in processor.kicad_sch and registers.kicad_sch
    [processor.kicad_pcb, processor.kicad_sch, registers.kicad_pcb, registers.kicad_sch]
2026-03-12 get HLT opcode to work
    CONT switch used to wipe out non-FETCH state (such as WRDCT or BREAK)
    [processor.kicad_pcb, processor.kicad_sch]
2026-03-12 get OSR working
    [registers.kicad_pcb, registers.kicad_sch]
2026-03-12 have simtest.tcl test swcont,swstop,start,swsstep,swsinst switches
    ...they seem to work
2026-03-12 add test code for ldad,depos,exam switches
    [registers.kicad_pcb, registers.kicad_sch]
2026-03-12 combine registers onto processor circuit board
    none of the console stuff works though
    will have to rebuild it
    [processor.kicad_pcb, processor.kicad_sch, registers.kicad_pcb, registers.kicad_sch]
2026-03-12 clean up switch circuits
    [processor.kicad_pcb, processor.kicad_sch]
2026-03-12 get OSR instruction working again
    [processor.kicad_pcb, processor.kicad_sch]
2026-03-12 some circuit simplifications
    [processor.kicad_pcb, processor.kicad_sch]
2026-03-12 get all switches working in processor schematic
    [processor.kicad_pcb, processor.kicad_sch]
2026-03-12 connect up power connections to chips on processor board
    [processor.kicad_pcb, processor.kicad_sch]
2026-03-12 get some of extmemory board working
    runs a couple hundred cycles of simtest.sh
    [extmemory.kicad_pcb, extmemory.kicad_sch]
2026-03-12 get more of extmemory board working
    [extmemory.kicad_pcb, extmemory.kicad_sch]
2026-03-12 get extmemory working
    - runs simtest.sh 80M+ cycles
    have to run make command twice (get UNOPTFLAG warnings first time)
    [extmemory.kicad_pcb, extmemory.kicad_sch]
2026-03-12 get start button working
    [processor.kicad_pcb, processor.kicad_sch]
2026-03-14 get a little more of new extarith.v working
    [processor.kicad_pcb, processor.kicad_sch]
2026-03-17 upadte extarith.v muxes to be more 74xx chip-like
    also rename hold => pause
    [extmemory.kicad_pcb, extmemory.kicad_sch, processor.kicad_pcb, processor.kicad_sch]
2026-03-19 add extarith schematic
    doesn't work yet
    [extarith.kicad_pcb, extarith.kicad_sch]
2026-03-19 get extarith schematic working
    [extarith.kicad_pcb, extarith.kicad_sch, processor.kicad_pcb, processor.kicad_sch]
2026-03-20 change cycles times to 120nS
    ...addition takes too long
    [processor.kicad_pcb]
2026-03-20 fix up console switch timing in processor
    ldad/exam/dep:
    on press,
    set up alu to generate new MADR then after 300nS pulse it in
    then after another 100nS, load new state in MAJST
    on release,
    clear HREQ to perform the cycle
    start/cont:
    on press,
    nothing
    on relese,
    clear HREQ to perform the cycle
    start/cont: clear hreq directly
    [processor.kicad_pcb, processor.kicad_sch]
2026-03-20 set TS1=300nS, TS2=500nS, TS3=500nS, TS4=300nS
    adding only done in TS2,TS3 so make them longer
    others can be short
    [processor.kicad_pcb, processor.kicad_sch]
2026-03-21 move field select (fldsel) circuit from processor to extmemory board
    [extarith.kicad_pcb, extarith.kicad_sch, extmemory.kicad_pcb, extmemory.kicad_sch, processor.kicad_pcb, processor.kicad_sch]
2026-03-21 add console circuit board
    (slows simtest.tcl down quite a bit)
    [console.kicad_pcb, console.kicad_sch, extmemory.kicad_pcb, extmemory.kicad_sch]
2026-03-22 get console board working
    [console.kicad_pcb, console.kicad_sch]
2026-03-23 add memdisab signal and remove nxtms from backplane
    memdisab = 0 : use 32K memory chip on extmemory board
    1 : use external memory
    [console.kicad_pcb, console.kicad_sch, extarith.kicad_pcb, extarith.kicad_sch, extmemory.kicad_pcb, extmemory.kicad_sch, processor.kicad_pcb, processor.kicad_sch]
2026-03-24 add oscillator chip to console board
    also handle net names with < = > (used by 7485)
    [console.kicad_pcb, console.kicad_sch]
2026-03-26 get zynq stuff to compile and modify verimain to access it
    don't have driver to access page yet
    [processor.kicad_pcb, processor.kicad_sch]
2026-03-26 add km-zynqpdp8i driver to access zynq register page
    runs simtest.sh on zynq
2026-03-27 remove verisim .v files that are superceded by kicad-derived .v files
2026-03-28 add tty to zynq and get lights working in verilator
    [console.kicad_pcb, console.kicad_sch]
2026-03-28 wait for mb lights to catch up with rdmem/wrmem commands
    also show EXE state light during INTAK cycle
    [console.kicad_pcb, console.kicad_sch]
2026-03-28 get pdp8itty working in verilator
    [console.kicad_pcb]
2026-04-06 add mcp23017 chip to console board
    test access to 23017:
    $ ./verimain
    ;# write 32->reg 0; 45->reg 1
    > iic wr 0x40 wr 0 wr 0x32 wr 0x45
    > clk 11111
    11111
    > iic
    0
    ;# read reg 0; reg 1
    > iic wr 0x40 wr 0 rs wr 0x41 rd rd
    > clk 11111
    22222
    > format "%04X" [iic]
    3245
    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
    [console.kicad_pcb, console.kicad_sch, extmemory.kicad_pcb]
2026-04-08 get mcp23017 switches working
    can use mcprdltrow to read lights
    mcpwrswrow to write switches
    mcprelease to disconnect
    need mcprelease command when starting verimain to initialize
    [console.kicad_pcb, console.kicad_sch, extarith.kicad_pcb, extarith.kicad_sch, extmemory.kicad_pcb, extmemory.kicad_sch, processor.kicad_pcb, processor.kicad_sch]
2026-04-11 get simtest.sh working with MCP23017 console chip
    export usemcp=1
    ./simtest.sh
    [console.kicad_pcb, console.kicad_sch, processor.kicad_pcb, processor.kicad_sch]
2026-04-12 allow console mcp23017 to read panel switches
    test:
    usemcp=0 ./simtest.sh gpio connector only
    lights: bus -> muxes -> gpio -> test script
    switches: test script -> gpio -> flipflops -> bus
    usemcp=1 ./simtest.sh mcp23017 only (gpio gets lights but not switches)
    lights: bus -> muxes -> gpio,mcp23017 -> test script
    switches: test script -> mcp23017 -> flipflops -> bus
    usemcp=2 ./simtest.sh gpio & mcp23017 (gpio gets lights and switches)
    lights: bus -> muxes -> gpio,mcp23017 -> test script
    switches: test script -> gpio -> mcp23017 -> flipflops -> bus
    iicsel
    0000..0111 gate bus signals out to the panel lights as well as re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
    [console.kicad_pcb, console.kicad_sch]
2026-04-14 fix simtest testing start sstep switch combination
    start with sstep just resets without starting up
    also include last.sh test script
    usemcp=0 ./last.sh
    usemcp=1 ./last.sh
    usemcp=2 ./last.sh
    [bgrep.c, last16k.c]
2026-04-22 little fix to simtest.tcl
    defer requesting dma or interrupt
2026-04-23 merge DMADR[11:00] bus into INBUS
    DMA master only needs to output the address during TS4
    and nothing else uses INBUS during that time
    [console.kicad_pcb, console.kicad_sch, extarith.kicad_pcb, extarith.kicad_sch, extmemory.kicad_pcb, extmemory.kicad_sch, processor.kicad_pcb, processor.kicad_sch]
2026-04-23 merge dfld/ifld switch lines onto dfld/ifld light bus lines
    dfld/ifld lines hold the dfld/ifld flipflop outputs when swldad negated
    dfld/ifld lines hold the dfld/ifld switch outputs when swldad asserted
    [console.kicad_pcb, console.kicad_sch, extmemory.kicad_pcb, extmemory.kicad_sch]
2026-04-25 put buffers on all bus pins
    make the signals active low so can put pullup terminators on backplane
    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
    [console.kicad_pcb, console.kicad_sch, extarith.kicad_pcb, extarith.kicad_sch, extmemory.kicad_pcb, extmemory.kicad_sch, processor.kicad_pcb, processor.kicad_sch]
2026-04-26 get a few ./simtest.sh instructions working
    [console.kicad_pcb, console.kicad_sch, extmemory.kicad_pcb, extmemory.kicad_sch]
2026-04-26 get a few more ./simtest.sh instructions working
    [extarith.kicad_pcb, extarith.kicad_sch, extmemory.kicad_pcb, extmemory.kicad_sch, processor.kicad_pcb, processor.kicad_sch]
2026-04-26 get most if not all of usemcp=0 ./simtest.sh working
    [extarith.kicad_pcb, extarith.kicad_sch]
2026-04-27 get usemcp=1,2 modes working with simtest.sh
    need to set gpio panel connector data bits to all ones so
    they don't interfere with console.kicad_sch bGPIO data bits
2026-04-27 add BRKGNTI/BRKGNTO signals to bus
    set at TP3 of all cycles to match BRKRQST line
    cleared at TP2 in BREAK cycle
    [console.kicad_pcb, console.kicad_sch, extarith.kicad_pcb, extarith.kicad_sch, extmemory.kicad_pcb, extmemory.kicad_sch, processor.kicad_pcb, processor.kicad_sch]
2026-05-01 add dmatest circuit to test dma
    added field latch to extmemory
    opens during TS1 to hold field during TS3
    lets dma circuit drop field at TP2
    [extmemory.kicad_pcb, extmemory.kicad_sch]
2026-05-02 get started on doing better gate/flipflop delays
    doesn't work
    [extmemory.kicad_pcb, extmemory.kicad_sch]
2026-05-03 get some more working with new clocking
    run with clkratio=24
    simtest.sh runs 1259 cycles
    [console.kicad_pcb, console.kicad_sch]
2026-05-06 add back a version of chips.v that has fixed 10nS delay
    also put cycle counter in dmatest.v for testing
    [processor.kicad_pcb, processor.kicad_sch]
2026-05-07 add BRKCYC signal to bus for DMA circuits
    glitch-free indicating break cycle in progress
    sets at beginning of TS1, clears at end of TS3
    [processor.kicad_pcb, processor.kicad_sch]
2026-05-08 small delay when switching busDFLD/busIFLD for LDAD switch
    minimize overlapping drivers
    [console.kicad_pcb, console.kicad_sch, extmemory.kicad_pcb, extmemory.kicad_sch]
2026-05-12 clear iduj on same cycle as ifaj->ifld
    in case donig JMSI that gets aborted by console
    [console.kicad_pcb, extarith.kicad_pcb, extmemory.kicad_pcb, extmemory.kicad_sch]
2026-05-12 rename all 74xx references to 74HCxx
    timings in chips-varns.v are for 74HCxx
    also added 74AHCxx and 74ACxx to chips-varns.v where available
    [console.kicad_pcb, console.kicad_sch, extarith.kicad_pcb, extarith.kicad_sch, extmemory.kicad_pcb, extmemory.kicad_sch, processor.kicad_pcb, processor.kicad_sch]
2026-05-12 substitute in AHC and AC chips into circuit boards
    testing with clkratio=20, ie 10MHz
    [console.kicad_pcb, console.kicad_sch, extarith.kicad_pcb, extarith.kicad_sch, extmemory.kicad_pcb, extmemory.kicad_sch, processor.kicad_pcb, processor.kicad_sch]
2026-05-12 get it working with 1.28uS cycles (clkratio=16)
    ...using AHC/AC/HC gates
    [console.kicad_pcb, console.kicad_sch, processor.kicad_pcb, processor.kicad_sch]
2026-05-12 have dmatest.v capture wrdct cycle overflow bit
    ...but simtest.tcl doesn't test it yet
    [extarith.kicad_pcb, processor.kicad_pcb]
2026-05-16 move dmatester to a circuit board
    ...so it has realistic propagation delays
    change TS1,TS2,TS3,TS4 times to 400nS each
    ...instead of 300,500,500,300nS each
    should be ok cuz of 74AC283s instead of 74HC283s
    [dmatester.kicad_pcb, dmatester.kicad_sch, processor.kicad_pcb, processor.kicad_sch]
2026-05-17 make edge connectors all single-row 1x36
    [console.kicad_pcb, console.kicad_sch, extarith.kicad_pcb, extarith.kicad_sch, extmemory.kicad_pcb, extmemory.kicad_sch, processor.kicad_pcb, processor.kicad_sch]
2026-05-17 update dmagnt signals in backplane
    [dmatester.kicad_pcb, dmatester.kicad_sch, extmemory.kicad_pcb]
2026-05-17 place chips on extmemory board
    [extmemory.kicad_pcb, extmemory.kicad_sch]
2026-05-17 add backplane kicad pcb
    [backplane.kicad_pcb, backplane.kicad_sch]
2026-05-23 add testbd1 - used for testing bus drivers & terminators
    [testbd1.kicad_pcb, testbd1.kicad_sch]
2026-05-25 plug zynq into verimain's backplane
    simtest.tcl doesn't access any of its i/o devices yet
    [backplane.v, dmareq.v, i2cmaster.v, pdp8ldc02.v, pdp8lrk8je.v, pdp8ltty.v, verimain.cc, zynq.v]
2026-05-25 add pdp8icmem circuit to zynq
    don't have any tests for it yet
2026-05-30 get verimain zynq code working with simtest.sh
    verimain compiles with boards and zynq code
    uses chips-varns.v for the chips
    simtest includes zynq pdp8ltty.v testing
    does not test zynq pdp8isim.v
    compiling zynq code with vivado from zynq directory
    compiles pdp8isim.v which uses the board files
    and chips-10ns.v for the chips
    - untested
    also get rid of CLOK2 signal from PCBs, converting to _CLOCK
    [backplane.kicad_pcb, backplane.kicad_sch, console.kicad_pcb, console.kicad_sch, extarith.kicad_pcb, extarith.kicad_sch, extmemory.kicad_pcb, extmemory.kicad_sch]
2026-05-30 update zynq pdp8lfpi2c.v to continuously scan panel via i2c
2026-05-31 add console board to pdp8isim.v
    so fpga sim will use i2c for accessing lights & switches
2026-06-01 have simtest.sh test pdp8ifpi2c.v
    pdp8ifpi2c.v can be enabled (by clearing its 'manual' bit) to
    take over scanning the physical pidp panel via the console board.
    by default, the console board does the scanning via its internal
    counters.
    usefpi2c=0 ./simtest.sh use console board scanners (fast)
    usefpi2c=1 ./simtest.sh use pdp8ifpi2c.v scanners (slow)
    [console.kicad_pcb, console.kicad_sch, extmemory.kicad_pcb, extmemory.kicad_sch]
2026-06-03 have setsw wait for switch to soak into flipflops
    also merge pipan8lini.tcl into z8lpanelini.tcl
    [cmd_pin.cc, i2cmaster.v, i2czlib.cc, pdp8ifpi2c.v, z8ldefs.h, z8lpanel.cc]
2026-06-05 make console _CLOCK connection an input
    clock signal must originate on backplane or zynq board
    [console.kicad_pcb, console.kicad_sch]
2026-06-05 get zynq stuff compiling
    sim mode doesn't work
    [backplane.v, chips-10ns.v, pdp8ifpi2c.v, pdp8isim.v, pdp8lvc8.v, z8ldump.cc, z8lila.cc, zynq.v]
2026-06-07 add some reset debug code to zynq
    > simon
    > setsw sinst 1
    > hardreset
    ...processor is halted
    > simon
    > setsw sinst 1
    > setsw sinst 0
    > hardreset
    ...processor is babbling away (should be halted)
    [pdp8isim.v, z8lila.cc, zynq.v]
2026-06-07 get zynq sim reset working
    hold START+SSTEP switches down during reset
    so processor won't start (from such as CONT or lone START)
    while switches stabilize
    [cmd_pin.cc, pdp8ifpi2c.v, pdp8isim.v, z8lu32.cc, zynq.v]
2026-06-08 add ttyprtest simple tty printer test to z8lpanelini.tcl
    on one screen:
    $ ./z8lpanel
    > ttyprtest
    > startat 040
    on another screen:
    $ ./z8ltty
    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
2026-06-08 get os8 decpack to boot
    z8lpanel> simon
    z8lpanel> source bootos8dpack.tcl
    - fix up cm_ symbol names for pin command
    - make a single instance of Z8LPage per process
    - remove os8zap references
    - remove mprt switch references
    - update dmacycle() call
    - set up makefile for zynq directory
    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
    [cmd_pin.cc, dmareq.v, i2czlib.cc, i2czlib.h, pdp8icmem.v, z8ldefs.h, z8ldump.cc, z8lila.cc]
2026-06-09 add MADR, MEAD, MAJST bus signals as inputs to FPGA
    used by z8ltc08.cc
    renamed FIELD to MEAD (extended memory address)
    [backplane.kicad_pcb, backplane.kicad_sch, console.kicad_pcb, console.kicad_sch, extarith.kicad_pcb, extarith.kicad_sch, extmemory.kicad_pcb, extmemory.kicad_sch]
2026-06-11 get all console resets working
    verisim:
    # test consol.kicad_sh scanning
    export usefpi2c=0
    # test pdp8ifpi2c.v scanning external console.kicad_sch
    export usefpi2c=1
    ccode:
    # test pdp8ifpi2c.v scanning pdp8isim.v's console.kicad_sch
    ./z8lpanel
    > source bootos8dpack.tcl
    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
    [cmd_pin.cc, i2czlib.cc, i2czlib.h, pdp8ifpi2c.v, verimain.cc, z8ldefs.h, z8ldump.cc, z8lpanel.cc]
2026-06-12 get iac,dep,exm lights working on z8lpanel -status
    pipe majst[3],majst[0] bits through unused gpio light bits
    [console.kicad_pcb, console.kicad_sch]
2026-06-12 fix z8lpanel -real and -sim options
    pass them onto z8lpanelini.tcl to handle them
    [i2czlib.cc, i2czlib.h, tclmain.cc, tclmain.h, z8ldump.cc, z8lpanel.cc]
2026-06-12 fix z8lpanel -status state lights correctly
    the old way would glitch IAK state erratically
    [console.kicad_pcb, console.kicad_sch]
2026-06-13 add light/switch time jumper to console board
    fast for verilator testing
    slow for normal
    [console.kicad_pcb, console.kicad_sch]
2026-06-13 add debouncing to pdp8ifpi2c.v physical button scanning
2026-06-15 split processor board -> procseq, proc23
    also fix z8ipanel stop button access
    and fix hardreset to always leave sstep turned off
    [proc23.kicad_pcb, proc23.kicad_sch, procseq.kicad_pcb, procseq.kicad_sch]
2026-06-16 have getlb wait for i2c scan pass so lights are up-to-date
    also fix up TC08 boot timing
    tested with verizynq on PC and real Zynq
    [i2czlib.cc, i2czlib.h, z8ipanel.cc, z8itc08.cc, zynq.v]
2026-06-17 split remaining proc23 board into procalu and procreg
    processor is now 3 boards:
    procalu - arith/logic unit
    procreg - registers
    procseq - sequencer
    [proc23.kicad_pcb, procalu.kicad_pcb, procalu.kicad_sch, procreg.kicad_pcb, procreg.kicad_sch]
2026-06-17 add os8zap circuit to zynq simulator (pdp8isim.v)
    OS/8 does a
    ISZ x
    JMP .-1
    ...during printing for a pause
    this circuit zaps it so the ISZ always reads 7777
    causing it to immediately skip over the JMP
    [pdp8isim.v]
2026-06-18 multiple lights/switches on single getlb,getsw,relsw,setsw command lines
    also remove some dead code
2026-06-19 add capacitors to procalu board and clean it up some
    [procalu.kicad_pcb, procalu.kicad_sch]
2026-06-19 add a couple readme.txt files
2026-06-20 initial placement on procalu.kicad_pcb
    [procalu.kicad_pcb]
2026-06-20 update procalu chip placement, create initial Layout.java program
    put capacitor on all procalu chips and line them up on nice grid
    Layout.java used to layout pcb based on trace lengths
    [procalu.kicad_pcb, procalu.kicad_sch]
2026-06-21 get Layout.java save updated layout to pcb file
2026-06-21 add random auto-shuffling to Layout.java to find optimum placement
    [procalu.kicad_pcb]
2026-06-22 randomly swap sub-chips and pads within sub-chips for Layout.java
    [procalu.kicad_pcb]
2026-06-22 have Layout.java update the schematic with sub-chip swaps
    schematic seems to still work according to verisym
    [procalu.kicad_pcb, procalu.kicad_sch]
2026-06-23 have Layout.java write out pad swaps within a subchip
    ...to be applied to schematic manually
    also use filename given on Layout.java command line
    instead of using stdin/stdout
    [procalu.kicad_pcb, procalu.kicad_sch]
2026-06-23 partial manual routing of procalu pcb
    [procalu.kicad_pcb, procalu.kicad_sch]
2026-06-24 more manual routing of procalu.kicad_pcb
    [procalu.kicad_pcb, procalu.kicad_sch]
2026-06-26 fix verisim clocking so it can test faster cycles
    verisim uses zynq.v regctld to generate pdp clock
    export clkratm1=9 # default - 100nS cycles
    export clkratm1=8 # 90nS cycles
    export clkratm1=7 # 80nS cycles (seems to work)
    export clkratm1=6 # 70nS cycles (doesn't work)
    export usefpi2c=0 or 1
    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
    [backplane.v, chips-10ns.v, chips-varns.v, cmd_pin.cc, pdp8isim.v, verimain.cc, z8idefs.h]
2026-06-27 some more manual routine procalu board
    [procalu.kicad_pcb]
2026-06-27 procalu board routed
    [procalu.kicad_pcb]
2026-06-27 cleaned-up procalu pcb layout
    [procalu.kicad_pcb]
2026-06-27 procalu pcb with pdp-8/i logo
    [procalu.kicad_pcb]
2026-07-27 renumber procalu chips to indicate position on board
    [procalu.kicad_pcb, procalu.kicad_sch]
2026-07-27 shorten TS1 from 400nS to 300nS so cycle time is 1.5uS like real 8/I
    simtest.sh seems happy even with clkratm1=7 (12.5MHz clock, 1.2uS cycle time)
    also remove some unused files
    [procseq.kicad_pcb, procseq.kicad_sch]
2026-07-27 missing procalu/fp-lib-table
    also update PCB.java to handle component rotation 180, 270
2026-07-27 add testprocalu program to test physical procalu board
    untested
2026-07-27 i2czlib only call kill if pid > 0
    and fix some comments
    [i2czlib.cc]
2026-07-27 add zturn circuit board
    [zturn.kicad_pcb, zturn.kicad_sch]
2026-07-27 add Backpln program to print backplane pin names for all circuit boards
2026-07-27 add zturnpins program to generate zynq/signals.xdc from zturn.kicad_pcb
    [zturn.kicad_pcb, zturn.kicad_sch]
2026-07-27 reconcile all the zturn io pins
    dmagntd, ioenabd, poweron pins not tested
    [zturn.kicad_pcb, zturn.kicad_sch]
2026-07-27 add tester circuit board
    use with verisim/testprocalu to test alu board
    [tester.kicad_pcb, tester.kicad_sch]
2026-07-27 missing zturnpins.csv file
    [zturnpins.csv]
2026-07-27 split extarith board into extarctl and extardata boards
    also have Backpln.java compare pins from various boards to backplane
    also fix simulation of zynq dmagntd, ioenabd, poweron signals
    [extarctrl.kicad_pcb, extarctrl.kicad_sch, extardata.kicad_pcb, extardata.kicad_sch, extarith.kicad_pcb]
2026-07-27 fix up backplane signals to match local interconnect signals
    use ./backpln.sh to print discrepancies
    doesn't handle BRKGNTO/BRKGNTI name mismatches
    [backplane.kicad_pcb, backplane.kicad_sch, zturn.kicad_pcb, zturn.kicad_sch]
2026-07-27 get all backplane signals to match the boards
    provide a mapping in Backpln.java for exceptions
    [backplane.kicad_pcb, backplane.kicad_sch, console.kicad_pcb, console.kicad_sch, extarctrl.kicad_pcb, extarctrl.kicad_sch, extardata.kicad_pcb, extardata.kicad_sch]
2026-07-27 reduce i2c write cycle from 1.5 clocks per bit to 1 clock per bit
2026-07-27 route console board
    also removed debug connectors
    [console.kicad_pcb, console.kicad_sch]
2026-07-27 change zturn to use 74ACT540 for pause,brkrqst,intrqst lines
    so can use 20mA pullups
    just changed U17 to a 74ACT540
    [zturn.kicad_pcb, zturn.kicad_sch]
2026-07-27 add 330-ohm pullups for BRKRQST,PAUSE,INTRQST open-collector signals
    all on procseq board (it received all 3 signals)
    assume 74AC bus driver (24mA)
    still need ac-coupled terminators on end of bus lines
    [procseq.kicad_pcb, procseq.kicad_sch]
2026-07-27 place chips on procseq board (unrouted)
    [procseq.kicad_pcb, procseq.kicad_sch]
2026-07-27 partially routed procseq board
    [procseq.kicad_pcb]
2026-07-27 add arm_iMEMDIS register bit so zynq can disable extmemory.kicad_sch memory
2026-07-27 add MEMDIS signal to ZTurn board
    [zturn.kicad_pcb, zturn.kicad_sch]
2026-07-27 give arm access to iCLOCK to use to manually clock the processor
2026-07-27 rework arm_iRESET
    _busRESET is pulsed by arm_iRESET
    clears all processor and device state to power-on state
    _busBUSINI is pulsed by arm_iRESET and by start switch
    clears device state, AC and LINK
    [cmd_pin.cc, z8idefs.h, z8iila.cc, zynq.v]
2026-07-27 finished routing procseq pcb
    [procseq.kicad_pcb]
2026-07-27 rename LEDout[RGB] to LEDout*_N
    no functionality changes
2026-07-27 route shadow freeze signal out to zynq red led
2026-07-27 ground unused inputs on console.kicad_sch,pcb
    also clean up pcb traces
    [console.kicad_pcb, console.kicad_sch]
2026-07-27 add i2cmaster.cc and i2ctest.cc
    used for operating the tester circuit board
2026-07-27 get testprocalu working continuously
    grinds away successfully on the board
2026-07-27 submit console and zturn for manufacture
    [console.kicad_pcb, console.kicad_sch, zturn.kicad_pcb]
2026-07-27 backplane submitted for manufacture
    [backplane.kicad_pcb, backplane.kicad_sch]
2026-07-27 add testconsole program to test physical console board
2026-07-27 layout of procreg pcb
    [procreg.kicad_pcb, procreg.kicad_sch]
2026-07-27 partially routed procreg board
    [procreg.kicad_pcb, procreg.kicad_sch]
2026-07-27 procreg routing complete - no trimming done yet
    [procreg.kicad_pcb]
2026-07-27 cleanup on procreg pcb
    [procreg.kicad_pcb]
2026-07-27 fix up shadow pin definitions in ccode
    [cmd_pin.cc, pdp8ishad.v, z8idefs.h, z8idump.cc, z8iutil.cc]
2026-07-27 fix up z8idump shadow output
    [z8idump.cc, z8iutil.cc, z8iutil.h]
2026-07-27 add WFI instruction to procseq board
    opcode 6313 waits for interrupt request (or dma or sinst, sstep switches)
    [procseq.kicad_pcb, procseq.kicad_sch]
2026-07-27 tidy up procseq pcb and add WFI disable jumper
    [procseq.kicad_pcb, procseq.kicad_sch]
2026-07-27 gate synpause ff with TS3 instead of _RESET
    pausing in TS2 stops TSCT at 7 which confuses the TPn flipflops
    so just have it pause at beginning of TS3
    bootos8dpack, doubleroll and kaleid work
    [procseq.kicad_pcb, procseq.kicad_sch]
2026-07-27 place extardata chips in a grid
    [extardata.kicad_pcb]
2026-07-27 consistent naming for switches
    depos,dfld,ifld,reg instead of dep,df,if,sr
    also update z8idump
2026-07-27 add arm access to zynq.v external memory chip
2026-07-28 get syscall interface working
    doesn't have any syscall code other than PION/PIOFF for testing
    [backplane.v, pdp8isys.v, verimain.cc, verizynq.cc, verizynq.h, z8idefs.h, z8idump.cc, z8isys.cc]
2026-07-28 use D FFs instead of JK FFs for TP1-4 on procseq circuit board
    [procseq.kicad_pcb, procseq.kicad_sch]
2026-07-28 use fpga->arm interrupts for ptp, ptr, rk8je, tc08
    ...instead of polling loops
2026-07-29 clear arm int enab bits when c program is aborted
2026-07-31 get testconsole autotest working except LDAD switch
2026-07-31 get testconsole auto LDAD switch testing working
    test it each time through loop
2026-08-02 get stuff working with broken console board
    console board assumed switch gpio pins were active high but they are active low
    also, pullups are needed
    the console builtin switch scanning doesn't work
    the zynq has to sense the physical switches then complement then write to flipflops
    [i2czlib.cc, pdp8ifpi2c.v, pdp8isim.v, testcon1.cc]
2026-08-02 update testconsole.cc to work with broken console
    it uses console mcp23017 for manual test instead of on-board counters
    otherwise LDAD (and others) will get stuck on cuz it's inverted
    [testconsole.cc]
2026-08-02 update console pcb (gpio data pullups, active low switches)
    also block cont, depos, exam, ldad, start when running
    [console.kicad_pcb, console.kicad_sch]
2026-08-03 update zturn pcb with a couple things
    just use pin 19 of output drivers for enable
    ...to eliminate needing the pin 1 - pin 19 trace
    move the power jumper up an inch to be clear of zturn plugin board
    [zturn.kicad_pcb, zturn.kicad_sch]
2026-08-04 submit procreg procseq for manufacture
    procreg-2026-07-21
    procseq-2026-07-27
    [procreg.kicad_pcb, procseq.kicad_pcb]
2026-08-04 rebuilt pcbs
    [console.kicad_pcb, dmatester.kicad_pcb]
2026-08-04 add -nopads to z8idump
    ...so it won't access i2c console connection to do dumps
    [z8idump.cc, z8iutil.cc]
2026-08-04 add testzturn.cc test program for zturn board
    plug zturn board with zturn into tester board with raspi
    run ./testzturn -server on raspi
    run ./testzturn ip-addr-of-raspi on zturn
2026-08-04 include zturn.kicad_pcb in simtest.sh simulation test
2026-08-04 get testzturn testing iop and reset signals and fix brkgnto signal
    [testzturn.cc]
2026-08-04 renumber procreg and procseq parts using grid numbering
    both numbered 2026-08-04
    also add edge outline and re-submit for production
    [procreg.kicad_pcb, procreg.kicad_sch, procseq.kicad_pcb, procseq.kicad_sch]
2026-08-05 testzturn: handle brkrqst out from zturn to tester board
    also print only evey 1000th successful test as well as all errors
    [testlib.cc, testlib.h, testzturn.cc]
2026-08-08 add testzturn -hwloop test
    tests zturn board without tester board
    but requires loopback connectors (see source)
2026-08-09 fix i2cmaster to sample incoming data before dropping clock
    also put timestamps on testzturn.cc client output
    [i2cmaster.cc, testzturn.cc]
2026-08-09 do some layout on extarctrl and extmemory pcbs
    [extarctrl.kicad_pcb, extarctrl.kicad_sch, extmemory.kicad_pcb, extmemory.kicad_sch]
2026-08-10 do some extmemory.kicad_pcb routing
    and modify verimain.cc mem chip pin mapping to match
    also fill in some extarctrl chip power pins
    [extarctrl.kicad_pcb, extarctrl.kicad_sch, extmemory.kicad_pcb, extmemory.kicad_sch]
2026-08-11 finish routine extmemory.kicad_pcb
    [extmemory.kicad_pcb, extmemory.kicad_sch]
2026-08-11 renumber extmemory.kicad_sch,pcb chips
    and clean up traces
    [extmemory.kicad_pcb, extmemory.kicad_sch]
2026-08-11 add terminator pcb
    [term.kicad_pcb, term.kicad_sch]
2026-08-11 do extarctrl.kicad_pcb layout
    [extarctrl.kicad_pcb, extarctrl.kicad_sch]
2026-08-12 bunch of routing for extarctrl
    [extarctrl.kicad_pcb]
2026-08-13 finish routine extarctrl (no cleanup)
    [extarctrl.kicad_pcb]
2026-08-13 completed extractrl pcb routing
    [extarctrl.kicad_pcb]
2026-08-14 place chips and capacitors on extardata pcb
    [extardata.kicad_pcb, extardata.kicad_sch]
2026-08-14 get simtest.sh working with usefpi2c=1 and clkratm1=7 again
    overlap writing arm registers with normal clocking
    ...so memorycycle can write read data to ram in time for it to get clocked into MBUF
2026-08-16 fix procseq E75 74AHC74 footprint
    was 16 pins, now 14 pins
    also update VeriPCB.java to detect wrong footprints when verisim make command given
    [procseq.kicad_pcb, procseq.kicad_sch]
2026-08-16 get testprocseq running
    just plug procseq board into tester
    then run testprocseq.armv6l on raspi
    assumes 'disable WFI' jumper is out
2026-08-16 add net labels hreq_j and _hreq_k to procseq pcb for debugging
    [procseq.kicad_pcb, procseq.kicad_sch]
2026-08-17 get testprocseq running
    do realistic switch transitions
2026-08-17 remove unneeded pullups from terminator pcb
    also tidy up extmemory pcb a little
    [extmemory.kicad_pcb, term.kicad_pcb, term.kicad_sch]
2026-08-19 convert 74AC175 refs to 74HC175
    74AC175 doesn't seem to be available
    export usefpi2c=1 // use zturn for console ops
    export clkratm1=7 // use 80nS clock rate
    ./simtest.sh ...still seems to work
    [extarctrl.kicad_pcb, extarctrl.kicad_sch, extmemory.kicad_pcb, extmemory.kicad_sch, procreg.kicad_pcb, procreg.kicad_sch, procseq.kicad_pcb, procseq.kicad_sch]
2026-08-22 get testprocreg-acum.sh script working
    ...to test physical procreg board acum,link registers
2026-08-22 add testprocreg-pctr.sh test script to test procreg board pctr register
    ...with accompanying testprocreg.tcl changes
2026-08-22 add testprocreg-madr.sh and testprocreg-mbuf.sh to test procreg board
    ...along with corresponding testprocreg.tcl changes
2026-08-24 have z8idump decode pdp8ifpi2c.v output
    and fix up fpi2c timeout message in i2czlib.cc
    [i2czlib.cc, z8idump.cc]
2026-08-24 put gerber directory in extmemory.kicad_pcb
    [extmemory.kicad_pcb]
2026-08-24 add USB power connector to backplane
    [backplane.kicad_pcb, backplane.kicad_sch]
2026-08-24 TEMP patches to work with broken console board 2026-07-16
    all physical switches always overidden by zynq
    [i2czlib.cc, pdp8ifpi2c.v]
2026-08-25 get real processor working by fixing writing to zynq.v externmem
    runs with console, procalu, procreg, procseq, zturn boards
    [zynq.v]
2026-09-07 get doubleroll.asm working without extarith boards installed
    also mod doubleroll.tcl to load with depos instead of papertape
    cuz papertape jams up
2026-09-07 put broken console board back in place
    so sim code will work same as real broken console board
    [console.kicad_pcb, console.kicad_sch]
2026-09-08 get simtest.sh working with pdp8ifpi2c.v broken console code
    [chips-varns.v, verimain.cc]
2026-09-08 add CTL_FREEZE to z8iila to freeze ila contents with -asis
    ...so ilaarray doesn't get scribbled while dumping
    [z8iila.cc]
2026-09-11 add fpgamem4k signal to zynq.v
    disables field bits for zynq.v's internal 32KW memory
    conditionalizes ignoring field bits when physical extmemory board missing
    [cmd_pin.cc, z8idefs.h, zynq.v]
2026-09-11 remove block on physical switches fom i2czlib.cc
    had it blocked because of broken console board
    but pdp8ifpi2c.v now compensates for broken board
    and so physical switches now all work with broken board
    ...as long as the zynq is being used
    [i2czlib.cc]
2026-09-26 add testextmemory.cc
    ...doesn't work yet
    also fix up testprocalu,seq.cc to compile with new randbits.h location
    [testconsole.cc, testextmemory.cc, testprocalu.cc, testprocseq.cc]
2026-09-26 have zynq.v externmem always shadow memory writes
    so pdp8ishad.v can verify memory reads
    even when using extmemory.kicad_sch memory
2026-09-26 add z8itrace program to print instruction trace
    also have realstart.tcl use slower i2c console clock speed
2026-09-26 jam 0 on inbus for real processor doing CDF,CIF instructions
    ...until pullups in place
    [zynq.v]
2026-09-26 add backside bus connectors to backplane
    ...for debugging
    [backplane.kicad_pcb, backplane.kicad_sch]
2026-09-26 a few changes to z8ipanelini.tcl
    - base mem cycle timeout on 10MHz counter instead of 100MHz
    ...in case 10MHz counter is being slowed down or manually clocked
    - fix up hardreset to verify setting sstep and start switches
    - only wait 123mS when loading tapes for loadbinptr
    - comment instructions in rimloader
    - verify ifld,dfld,madr registers in rdmem
    [z8itrace.cc]
2026-09-26 add kicad realpanel - pcb for real pdp-8/i panel
    [realpanel.kicad_pcb, realpanel.kicad_sch]
2026-09-26 change realpanel 74AHC540 to 74AHCT540
    ...no change to pcb layout
    [realpanel.kicad_pcb, realpanel.kicad_sch]
2026-09-26 have z8idumpit just display what is in pdp8ifpi2c.v registers
    ...without waiting for a cycle,
    so it will work even if pdp8ifpi2c.v stuck
    same with z8ipanel -status
    [i2czlib.cc, i2czlib.h, z8idump.cc, z8ipanel.cc]
2026-09-26 add extender card kicad files 2026-08-24
    [extend.kicad_pcb, extend.kicad_sch]
2026-09-26 fix overlapping armwrite & iopstart signals in zynq.v
    add ttyprtestauto function to z8ipanelini.tcl to test armwrite/iopstart overlap
    also add stretch to pdp8ipbit.v and z8ipbit.cc to stretch i/o timing for music
    also add ila to z8idump
    also add clearmem function to z8ipanelini.tcl to clear memory
    so os8boot will work with shadow turned on
    [cmd_pin.cc, pdp8ipbit.v, z8idefs.h, z8idump.cc, z8iila.cc, z8ipbit.cc, zynq.v]
2026-09-26 add sh_err2 to differentiate some error bits
    [cmd_pin.cc, pdp8ishad.v, z8idefs.h, z8idump.cc, z8itrace.cc]
2026-09-27 squeeze a fpga cycle from arm writing register
    also remove a register from pdp8ipbit.v frequency counter
2026-09-28 use intdelayed line to drive ION light instead of plain ion
    ...so light will be correct during WFI instruction
    (or anything else that pauses)
    includes updated dttest to demonstrate
    [procseq.kicad_pcb, procseq.kicad_sch]
2026-09-29 update realpanel resistor values
    assume transistors have beta 25
    data sheets say minimum of 50 for currents used
    operate LEDs at 20mA
    at 10% duty cycle seems bright enough
    [realpanel.kicad_pcb, realpanel.kicad_sch]
2026-09-29 add fpselfscan and fpfpgascan functions to z8ipanelini.tcl
    ..to turn console board self-scanning counters on/off
2026-09-30 get simtest.sh working again
    memdis not working (disabled)
    [pdp8ishad.v, verimain.cc]
2026-10-04 use '540s instead of '541s for df, if, main switches on realpanel
    those switches output active high signals from the original dec
    switch board, but the gpio connector expects active low
    the control switches output active low signals from the original
    dec switch board, so they go through a '541 to be active low on
    the gpio connector
    no layout or routing changes so can use the 2026-09-21 board
    [realpanel.kicad_pcb, realpanel.kicad_sch]
2026-10-06 add pidptcpclient & pidptcpserver
    used to access a remote raspi plugged into a pidp8 panel
    this is different pidp8 than one plugged into console board
2026-10-06 fix a couple pidptcp things
    > add -nomqsc option to client
    fix sstep, sinst switches
    > add button debouncing to server
    [pidp_proc.cc, pidptcpclient.cc]
2026-10-08 have shadow check saved DF, IF
    also add showing shadow error message to z8idump output
    and have z8ipanelini.tcl rdmem/wrmem do more checking
    [pdp8ishad.v, shaderr.cc, shaderr.h, z8idefs.h, z8idump.cc]
2026-10-09 switch change on real panel drops all overrides from fpga
    also do more checking in rdmem,startat,wrmem of z8ipanelini.tcl
    and one entry for z8iila per negedge 10MHz clock
2026-10-10 pdp8ivc8 jammed up inbus
    [pdp8ivc8.v, zynq.v]
2026-10-10 have hardreset reset all control switches so they don't jam it up
    also do more checking in z8ipanelini.tcl
    when loading bin tape and reading/writing memory
2026-10-10 add debug code to verimain that prints out inbus drive enables
    ...commented out
2026-10-11 remove procio thing from zynq.v
    now that _INBUS,_ACCLEAR,_IOSKIP pullups (750-ohm) are in place
    don't have any terminators in
    using 74AHC540s for drivers and receivers
    doubleroll, edu20c, kaleid run at 30nS (clkratm1=2), 0.45uS cycle time
    music runs at 50nS (clkratm1=4), 0.75uS cycle time
2026-10-11 remove bsw, caf, mqa, mql instructions from edu20c
    ...so it will run without the extended arithmetic boards
2026-10-13 fix comments at top of dttest.asm
    [dttest.asm]
2026-10-13 add missing blk_mem_gen_1 files from zynq
    also remove absolute path from pdp8i.xpr
    [blk_mem_gen_1.v, blk_mem_gen_1.vhd]
2026-10-13 add zplin softlink to point to pdp8l repo zplin
    to build zynq binary, need to softlink to pdp8l zplin repo
    $ ls -l
    drwxrwxr-x 5 mrieker mrieker 12288 Oct 13 04:03 ccode
    drwxrwxr-x 2 mrieker mrieker 4096 Oct 13 08:58 demos
    drwxrwxr-x 2 mrieker mrieker 4096 Oct 13 03:05 edu20c
    drwxrwxr-x 25 mrieker mrieker 4096 Oct 13 16:14 kicads
    -rw-rw-r-- 1 mrieker mrieker 2676 Oct 13 16:30 readme.txt
    drwxrwxr-x 5 mrieker mrieker 12288 Oct 13 16:11 verisim
    lrwxrwxrwx 1 mrieker mrieker 14 Mar 19 2026 zplin -> ../pdp8l/zplin
    drwxrwxr-x 10 mrieker mrieker 4096 Oct 13 16:18 zynq
2026-10-16 add demos/eaetest for testing extended arithmetic boards
    relies on pdp8ishad.v to verify instructions are working
2026-10-18 add instruction trace $display() calls to pdp8ishad.v
    only useful for verilated versions
2026-10-19 partial routing for extardata pcb
    [extardata.kicad_pcb, extardata.kicad_sch]
2026-10-19 update extar boards to handle dvi overflow more like D0BA expects
    leave MQ unchanged
    we also leave AC unchanged instead of mangling like D0BA expects
    [extarctrl.kicad_pcb, extarctrl.kicad_sch, extardata.kicad_pcb]
2026-10-21 update extarctrl to include clock jumper
    can select clock * 2..9 for 200nS..900nS @ 10MHz
    in case need to slow down extended arithmetic
    ...when processor is overclocked
    [extarctrl.kicad_pcb, extarctrl.kicad_sch]
2026-10-22 initial completed extardata.kicad_pcb routing
    [extardata.kicad_pcb]
2026-10-22 clean up extardata.kicad_pcb routing
    [extardata.kicad_pcb]
2026-10-23 renumber chips on extarctrl and extardata
    also add realswcon pcb
    connect cables from real switch pcb
    to the realpanel pcb
    submit for manufacture
    extarctrl-2026-10-20
    extardata-2026-10-21
    realswcon-2026-10-22
    [extarctrl.kicad_pcb, extarctrl.kicad_sch, extardata.kicad_pcb, extardata.kicad_sch, realswcon.kicad_pcb, realswcon.kicad_sch]
2026-10-23 renumber 74AC175 to 74HC175 on console,extarctrl pcbs
    74AC175 not available
    [console.kicad_pcb, console.kicad_sch, extarctrl.kicad_pcb, extarctrl.kicad_sch]
2026-10-27 print microseconds for each mul36 call
    also add systematic carry testing
2026-10-27 move realpanel mounting holes 0.05in to the right
    [realpanel.kicad_pcb]
2026-11-01 add realpans8 pcb (pidp8 compatible leds for straignt-8 panel)
    [realpans8.kicad_pcb, realpans8.kicad_sch]
2026-11-01 add poisonmem function to z8ipanelini.tcl
    and update dumpit to show shadow error message
    [z8ipanel.cc]
2026-11-01 add stepmqlts2.tcl script (example of test to debug hardware)
    ..bad solder joint on E36 EXTARDATA board
    seems happy running eaetest.sh -real
    with clkratm1=2 (30nS) and s3clk=clk2 (60nS)
