mrieker/pdp8i/(notices)

Notices in the files:
ccode/verizynq.cc:
This program is free software; you can redistribute it and/or modify
it under the terms of the GNU General Public License as published by
the Free Software Foundation; version 2 of the License.
